Niko11111/SpoolmanScale/images/SpoolmanScale Main 3 3_4.png

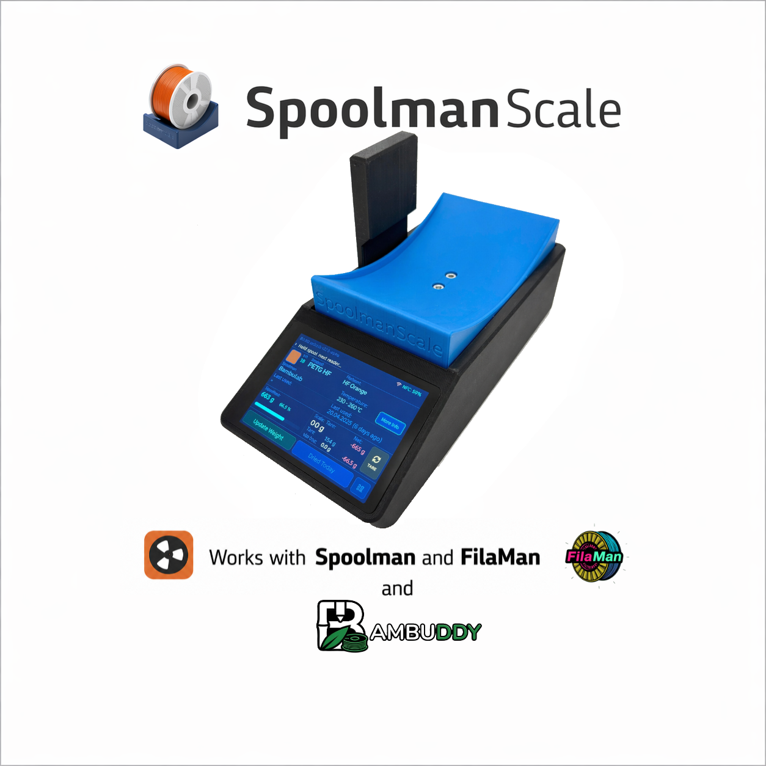
images/SpoolmanScale Main 3 3_4.png
