Niko11111/SpoolmanScale/images/SpoolmanScale_1.jpeg

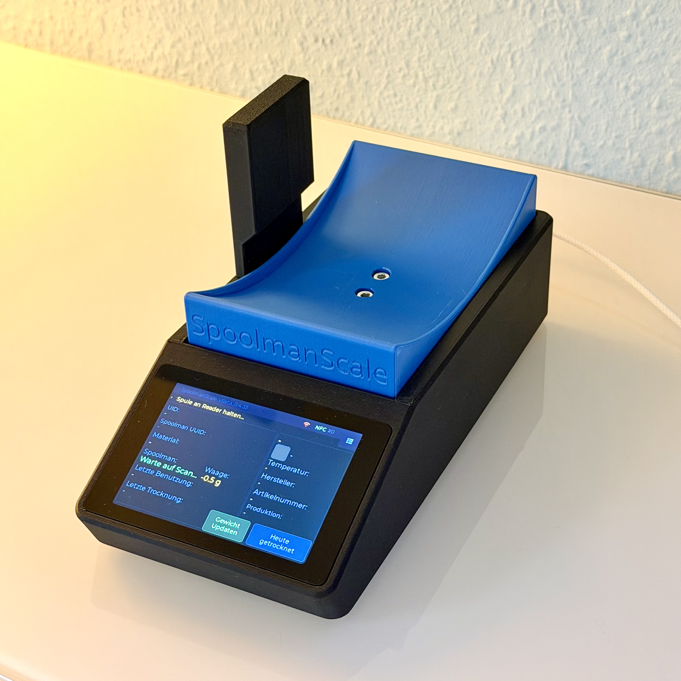
images/SpoolmanScale_1.jpeg
