Niko11111/SpoolmanScale/images/SpoolmanScale_2.jpeg

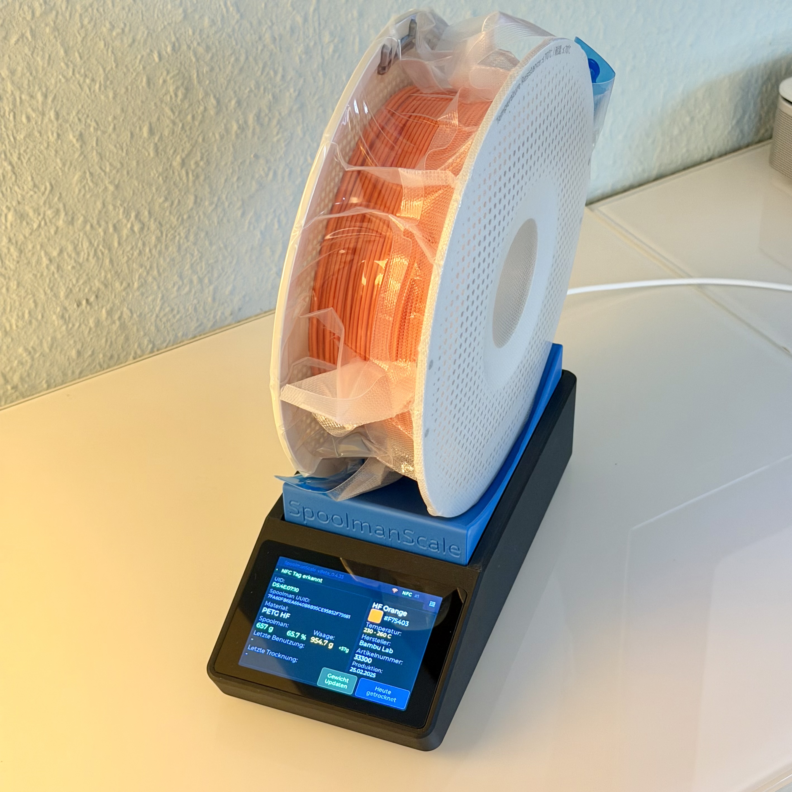
images/SpoolmanScale_2.jpeg
