Niko11111/SpoolmanScale/images/SpoolmanScale_MW_1.jpeg

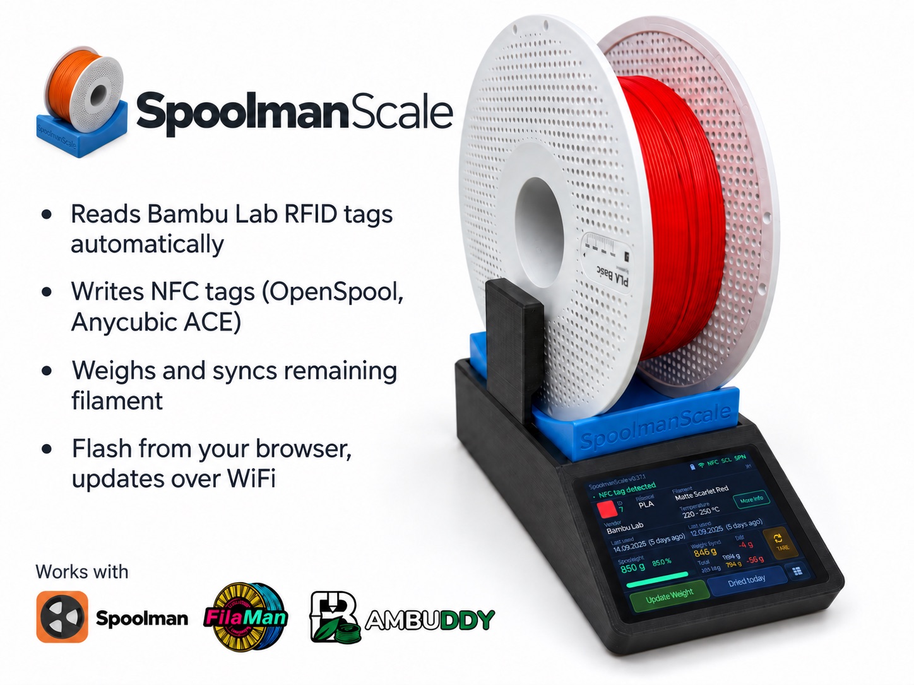
images/SpoolmanScale_MW_1.jpeg
