Niko11111/SpoolmanScale/images/SpoolmanScale_MW_UI_1.jpeg

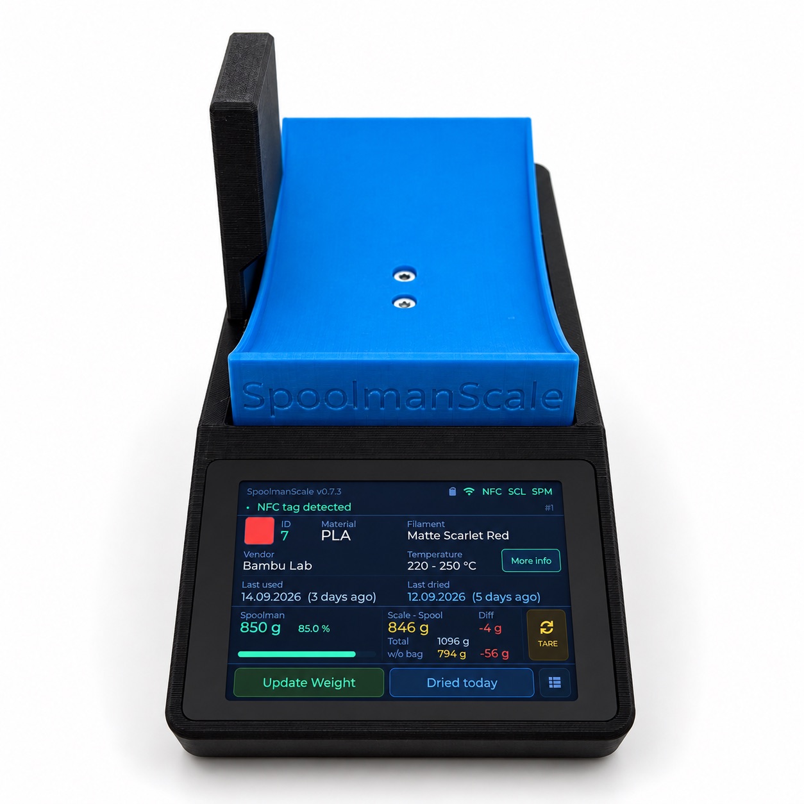
images/SpoolmanScale_MW_UI_1.jpeg
