Niko11111/SpoolmanScale/images/SpoolmanScale_MW_UI_2.jpeg

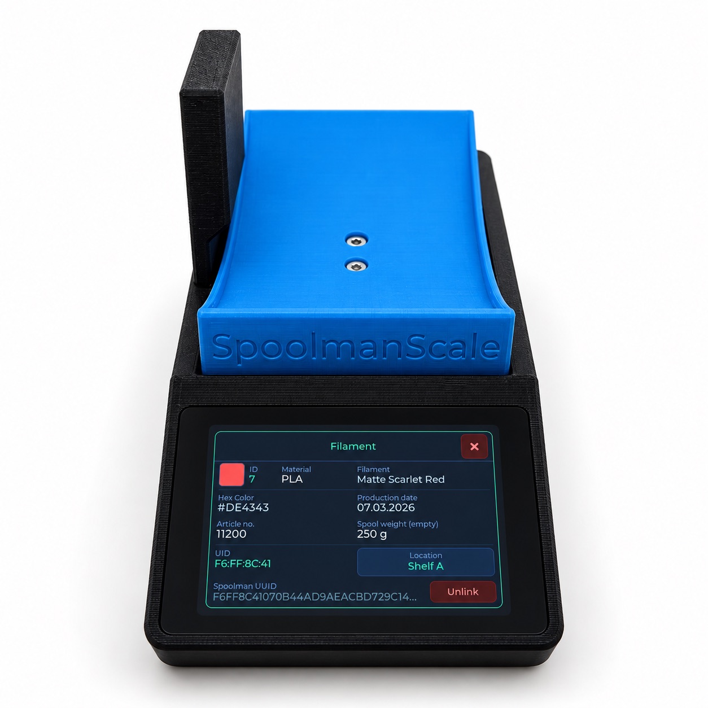
images/SpoolmanScale_MW_UI_2.jpeg
