Niko11111/SpoolmanScale/images/SpoolmanScale_MW_UI_3.jpeg

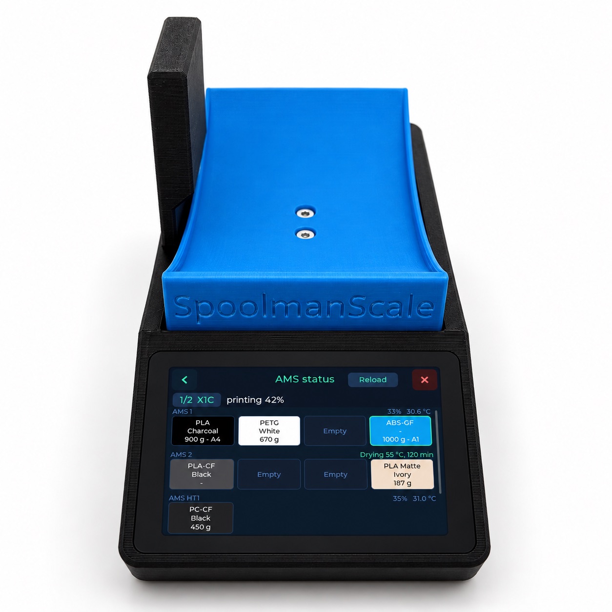
images/SpoolmanScale_MW_UI_3.jpeg
