Niko11111/SpoolmanScale/images/SpoolmanScale_MW_UI_4.jpeg

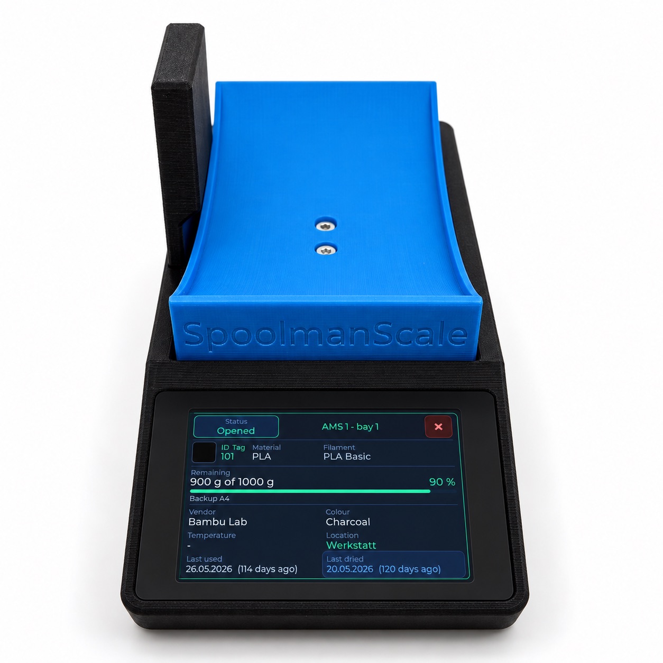
images/SpoolmanScale_MW_UI_4.jpeg
