Niko11111/SpoolmanScale/images/SpoolmanScale_MW_UI_5.jpeg

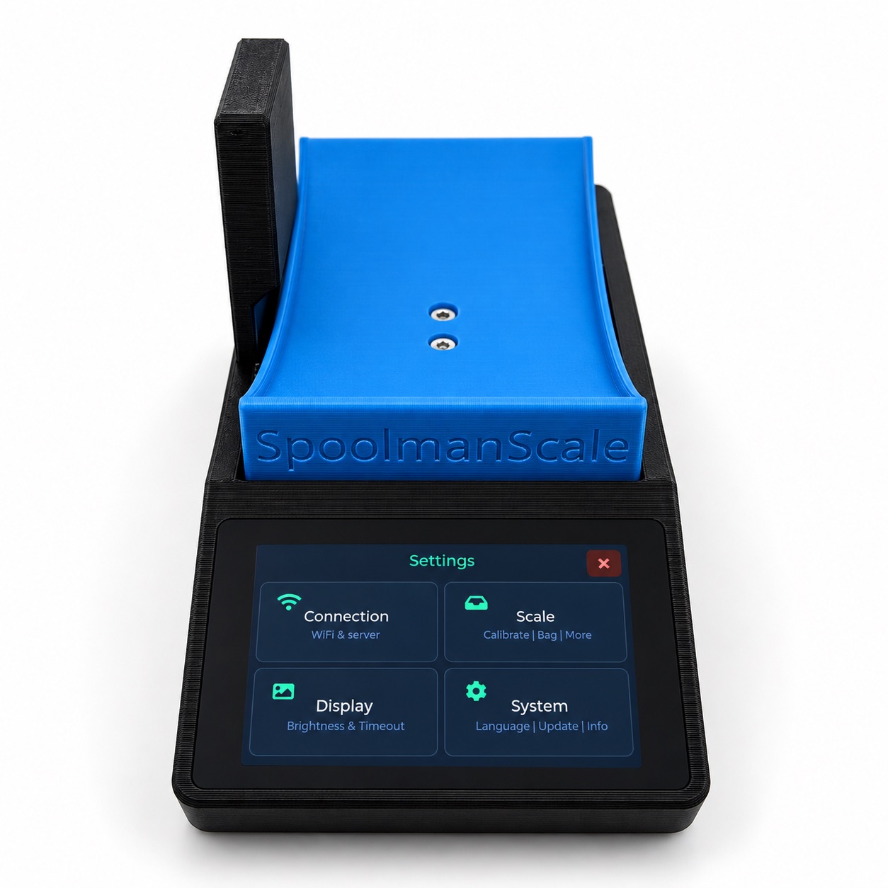
images/SpoolmanScale_MW_UI_5.jpeg
