Niko11111/SpoolmanScale/images/SpoolmanScale_MW_UI_6.jpeg

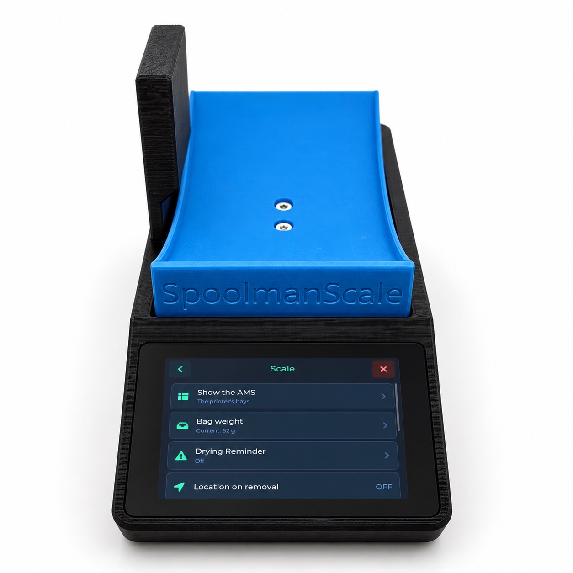
images/SpoolmanScale_MW_UI_6.jpeg
