Niko11111/SpoolmanScale/images/SpoolmanScale_MW_UI_7.jpeg

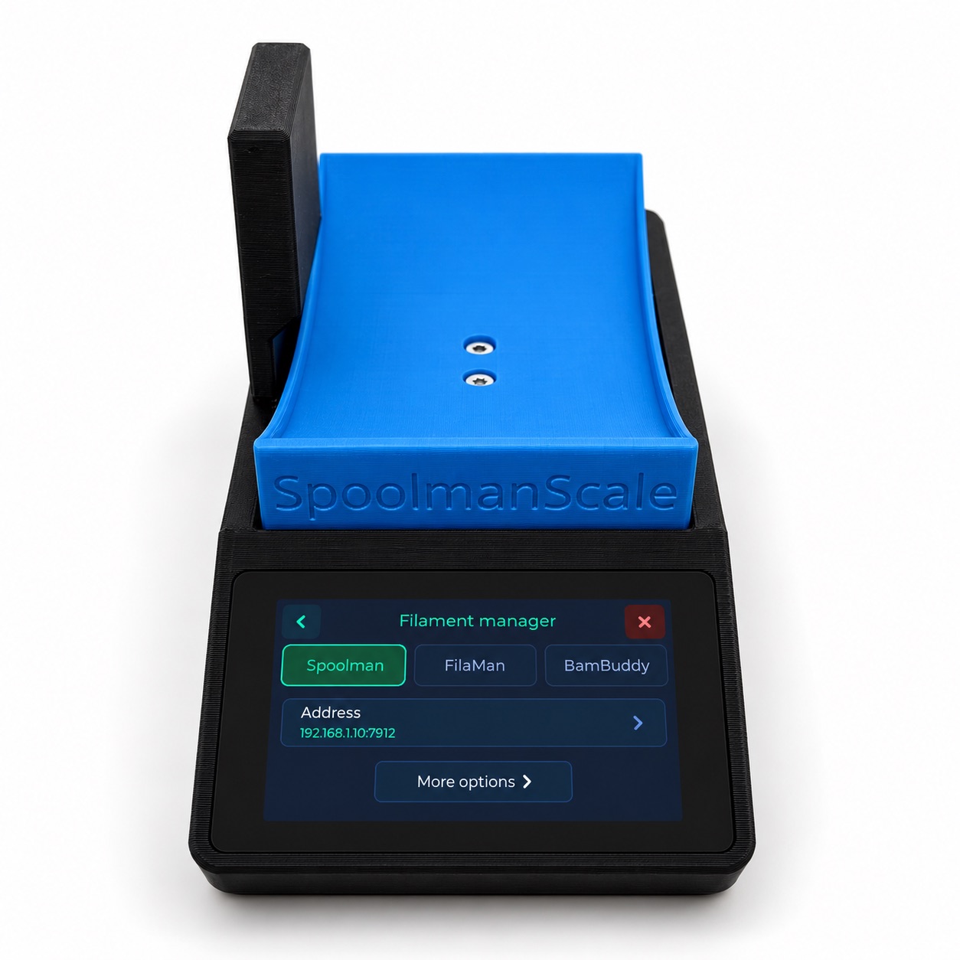
images/SpoolmanScale_MW_UI_7.jpeg
