Niko11111/SpoolmanScale/firmware/SpoolmanScale.ino

// ============================================================
//  SpoolmanScale – Bambu NFC Tag Reader & Decoder
//  Board:   WT32-SC01 Plus (ESP32-S3)
//  Version: v0.5.4
//
//  Reads Bambu Lab MIFARE Classic tags, derives keys via KDF
//  (HKDF/SHA256, master key from Bambu-Research-Group/RFID-Tag-Guide),
//  displays all decoded data on screen and queries
//  Spoolman for weight + last_dried after each scan.
//
//  Wiring:
//    Pin 1 (+5V)  -> PN532 VCC
//    Pin 2 (GND)  -> PN532 GND
//    Pin 3 (IO1)  -> PN532 SDA (GPIO 10)
//    Pin 4 (IO2)  -> PN532 SCL (GPIO 11)
//    Pin 5 (IO3)  -> PN532 RST (GPIO 12)
//
//  PN532 DIP-Switches: SW1=ON, SW2=OFF -> I2C mode
//
//  Libraries:
//    - Adafruit PN532    by Adafruit
//    - Adafruit BusIO    by Adafruit
//    - LovyanGFX         by lovyan03
//    - lvgl              by lvgl (Version 8.3.11!)
//    - ArduinoJson       by Benoit Blanchon (Version 7.x)
//  mbedTLS + WiFi + HTTPClient are included in the ESP32 framework.
// ============================================================

#include <Wire.h>
#include <Adafruit_PN532.h>
#include <Adafruit_NAU7802.h>   // NAU7802 Waage ADC (I2C 0x2A)
#include <LovyanGFX.hpp>
#include <lvgl.h>
#include "mbedtls/md.h"
#include <WiFi.h>
#include <WiFiClientSecure.h>
#include <HTTPClient.h>
#include <WebServer.h>
#include <Update.h>
#include <ArduinoJson.h>
#include <SD.h>
#include <SPI.h>
#include <stdarg.h>
#include <esp_system.h>

// PSRAM allocator for ArduinoJson — used for large JSON documents (Spoolman spool list)
// Frees internal RAM for LVGL, WiFi stack, and other allocations
struct SpiRamAllocator : ArduinoJson::Allocator {
  void* allocate(size_t size) override {
    void* ptr = heap_caps_malloc(size, MALLOC_CAP_SPIRAM);
    if (!ptr) ptr = malloc(size);  // fallback to internal RAM if PSRAM fails
    return ptr;
  }
  void deallocate(void* pointer) override { heap_caps_free(pointer); }
  void* reallocate(void* ptr, size_t new_size) override {
    void* p = heap_caps_realloc(ptr, new_size, MALLOC_CAP_SPIRAM);
    if (!p) p = realloc(ptr, new_size);  // fallback
    return p;
  }
};
#include <time.h>
#include <esp_sleep.h>
#include <Preferences.h>
#include <nvs_flash.h>
// LVGL built-in QR-Code: LV_USE_QRCODE muss in lv_conf.h auf 1 gesetzt sein!
#include "extra/libs/qrcode/lv_qrcode.h"
#include "lang.h"

// ============================================================
//  FORWARD DECLARATIONS
// ============================================================
void resetActivityTimer();
void isoToDe(const char* iso, char* out, size_t len);
void driedDisplayStr(const char* de_date, char* out, size_t len);
void querySpoolman(const char* tray_uuid);
void querySpoolmanById(int spool_id);
void closeConfirmPopup();
void patchSpoolWeight(float spool_w);
void patchFilamentSpoolWeight(float spool_w);
void patchVendorSpoolWeight(float spool_w);
void showConfirmPopup(const char* msg, int action);
void closeLinkList();
void showLinkList();
void fetchUnlinkedSpools();
void patchSpoolTag(int spool_id, const char* uuid);
// Neuer Link-Flow
void showLinkEntryPopup(bool is_bambu);
void closeLinkEntryPopup();
void showIdInputPopup(bool is_bambu);
void closeIdInputPopup();
// ID-Eingabe: HTTP-Lookup und Verknuepfung (ausgelagert wegen Stack-Groesse in Lambda)
void linkIdLookupAndPatch(int entered_id, bool is_bambu);
void showWarnPopupA(int spool_id, const char* existing_tag, bool is_bambu, const char* link_uuid);
void showWarnPopupB(int spool_id, bool is_bambu);
void fetchAllSpoolsForLink(bool is_bambu, const char* material_filter);
void doLinkPatch(int spool_id, bool is_bambu);
void showVendorList();
void showMaterialList(const char* vendor_name);
void showFilteredSpoolList(const char* vendor_name, const char* material_prefix);
bool writeSpoolScaleTag(int spool_id, const char* uuid_hex);
bool readSpoolScaleTag(int* out_spool_id, char* out_uuid, size_t uuid_len);
void generateUUID(char* out, size_t len);
void updateHeaderStatus();
void showMoreInfoScreen();
void buildMoreInfoScreen();
void updateMoreInfoScreen();
void hideAllOverlays();
void showMainScreen();
void showSettingsScreen();
void buildConnectionScreen();
void buildScaleSubScreen();
void buildDisplayScreen();
void buildSystemScreen();
void buildOtaGithubScreen();
void showOtaGithubScreen();
void doGithubOtaCheck();
void doGithubOtaCheckSilent();
void doGithubOtaFlash(const char* version);
void showUpdateBadges(bool show);
void buildOtaScreen();
void buildOtaBrowserScreen();
void showOtaScreen();
void showOtaBrowserScreen();
void startOtaServer();
void stopOtaServer();
void buildSettingsScreen();
void buildSpoolmanScreen();
void showSpoolmanFailScreen(bool is_setup_flow);
void clearTagDisplay();
void updateLinkButton();
void syncNTP();
void saveSpoolmanIP(const char* ip);
void buildWelcomeScreen();
void buildWifiSetupScreen();
void showWifiSetupScreen();
void showWelcomeScreen();
void saveWifiCredentials(const char* ssid, const char* pass);
void doWifiScan();
void showWifiPassScreen();
void buildWifiPassScreen();
void showWifiConnectingScreen();
void buildWifiConnectingScreen();
void buildBagScreen();
void buildFactorScreen();
void showFactorScreen();
void buildSubHeader(lv_obj_t *parent, const char *title, lv_event_cb_t back_cb, const char *back_hint = nullptr);
void showRebootPopup();
void showInfoScreen();
void showLanguageScreen();
void showQRPopup(int idx);
void buildFirstBootScreen();
void showFirstBootScreen();
void buildExtraFieldsScreen(bool is_setup_flow);
void showExtraFieldsScreen(bool is_setup_flow);
void buildCalReminderScreen();
void showCalReminderScreen();
void checkAndCreateExtraFields(bool create_missing);



// ============================================================
//  PINS
// ============================================================
#define I2C_SDA     10   // PN532 + NAU7802 Bus
#define I2C_SCL     11   // PN532 + NAU7802 Bus
#define TOUCH_SDA    6   // FT6336U interner Board-Bus
#define TOUCH_SCL    5   // FT6336U interner Board-Bus
#define LCD_BL_PIN        45
#define BRIGHT_NORMAL_DEFAULT  255   // 100% — Standardwert
#define BRIGHT_DIM_DEFAULT       77   // 30%  — Standardwert
#define DIM_TIMEOUT_DEFAULT   300000  // 5 Min — Standardwert
#define SLEEP_TIMEOUT_DEFAULT 1200000 // 20 Min — Standardwert

// Runtime variables (loaded from NVS, configurable via display menu)
static int     bright_normal   = BRIGHT_NORMAL_DEFAULT;
static int     dim_timeout_ms  = DIM_TIMEOUT_DEFAULT;
static int     sleep_timeout_ms = SLEEP_TIMEOUT_DEFAULT;
#define TOUCH_INT_PIN       7   // FT6336U INT fuer Wake-Up
#define FW_VERSION  "v0.5.4"
#define DONATION_URL "ko-fi.com/formfollowsfunction"

// NAU7802 calibration
// CAL_FACTOR: raw value per gram. Determined via calibration and saved in NVS.
// Default 1.0 means: raw values are displayed directly as grams.
#define CAL_FACTOR_DEFAULT  1.0f

// Two separate I2C instances
// I2C_TOUCH: Bus 0, GPIO5/6  -> Touch controller
// I2C_EXT:   Bus 1, GPIO10/11 -> PN532 + NAU7802
TwoWire I2C_TOUCH = TwoWire(0);
TwoWire I2C_EXT   = TwoWire(1);

// NAU7802 scale (on I2C_EXT, address 0x2A)
Adafruit_NAU7802 nau;

// ============================================================
//  SD CARD LOGGING (v0.5.3+)
//  MicroSD slot is on dedicated SPI bus (no conflict with display)
//  Pins per WT32-SC01 Plus schematic
// ============================================================
#define SD_CS    41
#define SD_SCK   39   // CLK
#define SD_MOSI  40   // CMD
#define SD_MISO  38   // D0

static SPIClass spiSD(HSPI);          // dedicated SPI bus for SD
static bool sd_available = false;     // SD card detected at boot
static bool sd_verbose   = false;     // verbose.txt found in root
static char sd_log_filename[32] = ""; // current day's log file path
static unsigned long sd_log_size = 0; // bytes written today (rough cap)
#define SD_LOG_MAX_SIZE  (1024UL * 1024UL)  // 1 MB per day cap

// Forward declarations for logger
void logSD(const char* msg);
void logSDf(const char* fmt, ...);
void initSD();
void cleanOldLogs();
void writeBootBlock(const char* boot_or_reboot);
String getCurrentLogFilename();

// ============================================================
//  WIFI + SPOOLMAN CONFIGURATION
// ============================================================
// WiFi + Spoolman are loaded from NVS (Preferences)
// Fallback values if NVS is empty:
// Fallback credentials: empty — WiFi is configured via the welcome screen
char cfg_wifi_ssid[33]     = "";
char cfg_wifi_password[65] = "";
char cfg_spoolman_ip[64]   = "";
char cfg_spoolman_base[80] = "";
bool cfg_lang_set          = false;  // true after first language selection
bool cfg_first_boot        = true;   // true = very first boot (greeting screen not yet shown)
static lv_obj_t *lbl_extra_fields_status = nullptr; // status label in extra fields screen
static lv_obj_t *btn_extra_fields_create = nullptr; // create button in extra fields screen
static lv_obj_t *btn_extra_fields_next   = nullptr; // skip/next button (turns green when OK)
static bool extra_fields_setup_flow = false;         // true = called from setup flow
static bool spoolman_fail_is_setup  = false;         // for spoolman fail screen
static bool spoolman_test_pending   = false;         // HTTP test queued for loop
static bool spoolman_test_in_setup  = false;         // context for test result
static bool extra_fields_check_pending = false;      // deferred from event callback to loop
static bool extra_fields_create_pending = false;     // deferred create from event callback
static bool skip_setup_pending = false;  // deferred from skip button callback
static bool cal_reminder_pending = false;            // deferred showCalReminderScreen from callback
static bool show_bag_pending    = false;             // deferred showBagScreen from scale_sub callback
static bool show_factor_pending = false;             // deferred showFactorScreen from scale_sub callback
static bool lang_selected_no_reboot = false;         // EN selected on welcome screen — go to firstboot without reboot
static uint8_t last_used_mode = 0;                   // 0=OpenSpoolMan, 1=Last Weighed
Preferences prefs;

// ============================================================
//  BAMBU KDF – Master Key (from Bambu-Research-Group/RFID-Tag-Guide)
//  HKDF with SHA256, context "RFID-B\\0", 16 keys of 6 bytes each
// ============================================================
static const uint8_t BAMBU_MASTER_KEY[16] = {
  0x9a, 0x75, 0x9c, 0xf2, 0xc4, 0xf7, 0xca, 0xff,
  0x22, 0x2c, 0xb9, 0x76, 0x9b, 0x41, 0xbc, 0x96
};
static const uint8_t BAMBU_KDF_CONTEXT[] = "RFID-B";  // incl. \\0

// ============================================================
//  DISPLAY (LovyanGFX)
// ============================================================
class LGFX : public lgfx::LGFX_Device {
  lgfx::Panel_ST7796  _panel;
  lgfx::Bus_Parallel8 _bus;
  lgfx::Light_PWM     _light;
  lgfx::Touch_FT5x06  _touch;
public:
  LGFX(void) {
    { auto cfg = _bus.config();
      cfg.pin_wr=47; cfg.pin_rd=-1; cfg.pin_rs=0;
      cfg.pin_d0=9;  cfg.pin_d1=46; cfg.pin_d2=3;
      cfg.pin_d3=8;  cfg.pin_d4=18; cfg.pin_d5=17;
      cfg.pin_d6=16; cfg.pin_d7=15;
      _bus.config(cfg); _panel.setBus(&_bus); }
    { auto cfg = _panel.config();
      cfg.pin_cs=-1; cfg.pin_rst=4; cfg.pin_busy=-1;
      cfg.memory_width=320; cfg.memory_height=480;
      cfg.panel_width=320;  cfg.panel_height=480;
      cfg.invert=true; cfg.rgb_order=false;
      _panel.config(cfg); }
    { auto cfg = _light.config();
      cfg.pin_bl=LCD_BL_PIN; cfg.invert=false;
      cfg.freq=44100; cfg.pwm_channel=7;
      _light.config(cfg); _panel.setLight(&_light); }
    { auto cfg = _touch.config();
      cfg.x_min=0; cfg.x_max=319; cfg.y_min=0; cfg.y_max=479;
      cfg.pin_int=7; cfg.bus_shared=false; cfg.offset_rotation=0;
      cfg.i2c_port=0; cfg.i2c_addr=0x38;
      cfg.pin_sda=TOUCH_SDA; cfg.pin_scl=TOUCH_SCL; cfg.freq=400000;
      _touch.config(cfg); _panel.setTouch(&_touch); }
    setPanel(&_panel);
  }
};

// ============================================================
//  GLOBAL OBJECTS
// ============================================================
static LGFX tft;
static lv_disp_draw_buf_t draw_buf;
static lv_color_t disp_buf[480 * 10];

Adafruit_PN532 nfc(-1, 12, &I2C_EXT);  // IRQ=nicht verdrahtet, RST=GPIO12, Bus=I2C_EXT
bool nfc_ok = false;
bool scl_ok = false;          // NAU7802 scale connected

// Parsed tag data
struct BambuTagData {
  uint8_t  uid[4];
  char     uid_str[24];  // 4-byte UID: "XX:XX:XX:XX" = 11+1, 7-byte UID: "XX:XX:XX:XX:XX:XX:XX" = 23+1
  uint8_t  keys[16][6];       // 16 abgeleitete Keys
  uint8_t  blocks[64][16];    // all 64 blocks (16 sectors x 4 blocks)
  bool     block_ok[64];      // which blocks were successfully read
  // Parsed fields (NFC tag)
  char     tray_uuid[36];
  char     material[16];
  char     color_hex[8];      // #RRGGBB
  char     vendor[32];
  char     detailed_filament[64];
  int      temp_min;
  int      temp_max;
  float    spool_weight;
  char     production_date[12];
  char     short_uid[20];
  // Spoolman fields (filled after API query)
  bool     spoolman_found;
  int      spoolman_id;
  float    spoolman_remaining;  // g
  float    spoolman_total;      // g
  char     spoolman_last_dried[32];
};

BambuTagData g_tag;
bool g_tag_ready = false;
bool g_tag_displayed = false;
unsigned long g_tag_shown_ms = 0;
bool wifi_ok = false;
static bool sm_reachable = false;  // Fix 10: Spoolman reachability status

// Tare confirmation timeout
static unsigned long tare_msg_ms = 0;
lv_obj_t *lbl_ok_ptr = nullptr;

// No-tag timer: clear display after timeout if no NFC tag detected
static unsigned long last_tag_seen_ms = 0;    // last NFC detection
static bool tag_present = false;               // tag currently on reader?
#define NO_TAG_CLEAR_MS  60000                 // 1 minute without tag -> clear

// Confirmation popup
lv_obj_t *confirm_popup = nullptr;             // current popup object
static int  confirm_action = 0;                // 1=dried, 2=weight

// Settings UI
lv_obj_t *scr_main   = nullptr;
lv_obj_t *scr_settings   = nullptr;
lv_obj_t *scr_wifi       = nullptr;
lv_obj_t *scr_spoolman   = nullptr;
lv_obj_t *scr_spoolman_fail = nullptr; // Spoolman connection failed screen
lv_obj_t *scr_welcome    = nullptr;   // Welcome screen (first boot — language selection)
lv_obj_t *scr_first_boot = nullptr;   // Very first boot greeting screen
lv_obj_t *scr_extra_fields = nullptr; // Spoolman extra fields check screen
lv_obj_t *scr_cal_reminder = nullptr; // Calibration reminder screen (end of first setup)
lv_obj_t *scr_wifi_setup = nullptr;   // WiFi setup: scan + password + connect
lv_obj_t *scr_factor     = nullptr;
lv_obj_t *scr_bag        = nullptr;
lv_obj_t *scr_lastused   = nullptr;  // Last Used Mode screen
// Submenu screens
lv_obj_t *scr_connection = nullptr;  // Connection (WiFi + Spoolman IP)
lv_obj_t *scr_scale_sub  = nullptr;  // Scale (bag weight + calibration)
lv_obj_t *scr_display    = nullptr;  // Display (brightness + timeouts)
lv_obj_t *scr_system     = nullptr;  // System (update + info/donate)
lv_obj_t *scr_ota        = nullptr;  // OTA selection (browser / GitHub)
lv_obj_t *scr_ota_browser = nullptr; // OTA browser upload screen
lv_obj_t *scr_ota_github  = nullptr; // OTA GitHub check screen

// OTA web server
static WebServer ota_server(80);
static bool ota_server_running = false;
static lv_obj_t *lbl_ota_status = nullptr;  // Status-Label im Browser-OTA Screen

// GitHub OTA state
static lv_obj_t *lbl_gh_status      = nullptr;
static lv_obj_t *lbl_gh_installed   = nullptr;
static lv_obj_t *lbl_gh_latest      = nullptr;
static lv_obj_t *btn_gh_update      = nullptr;
static lv_obj_t *lbl_gh_update_btn  = nullptr;
static char gh_latest_version[32]   = "";
bool update_available = false;   // set by silent background check
static bool silent_ota_check_pending = false;  // trigger once after WiFi connect
static lv_obj_t *lbl_burger_badge   = nullptr; // yellow dot on burger button (mainscreen)
static lv_obj_t *lbl_system_badge   = nullptr; // yellow dot on System tile (settings)
static lv_obj_t *lbl_fw_badge       = nullptr; // yellow dot on Firmware Update button
static lv_obj_t *lbl_gh_btn_badge   = nullptr; // yellow dot on GitHub Update button (OTA screen)
lv_obj_t *lbl_wifi_info = nullptr; // WiFi-Info Label
// ta_spoolman_ip, kb_spoolman: replaced by custom numpad — removed
// ta_factor_weight, kb_factor: replaced by custom numpad in buildFactorScreen()
lv_obj_t *ta_factor_weight = nullptr; // (nicht mehr aktiv genutzt)
lv_obj_t *kb_factor     = nullptr;    // (nicht mehr aktiv genutzt)
lv_obj_t *lbl_factor_result = nullptr;

// WiFi setup state
static char  wifi_setup_ssid[33]  = "";   // selected SSID from scan list
static lv_obj_t *lbl_wifi_setup_status = nullptr;  // Status-Label im Setup
static lv_obj_t *lbl_wifi_scan_list    = nullptr;  // Scan-Listen Container
static lv_obj_t *ta_wifi_pass          = nullptr;  // Password textarea
static lv_obj_t *kb_wifi_pass          = nullptr;  // Passwort-Tastatur
static lv_obj_t *scr_wifi_pass         = nullptr;  // Passwort-Unterscreen
static lv_obj_t *scr_wifi_connecting   = nullptr;  // Connecting screen

// Power management
unsigned long last_activity_ms = 0;  // last activity (NFC or touch)
bool is_dimmed = false;              // Display dimmed?

// Spoolman data kept separate – NOT reset on every scan
static int   sm_id = 0;
static int   sm_filament_id = 0;   // for PATCH /api/v1/filament/{id}
static int   sm_vendor_id = 0;     // for PATCH /api/v1/vendor/{id}
static bool  sm_found = false;
static float sm_remaining = 0;
static float sm_total = 1000;
static float sm_spool_weight = 0;   // Empty spool weight (for scale calculation)
static char  sm_last_dried[32] = "";
static char  sm_article_nr[32] = "";
static char  sm_filament_name[32] = "";
static char  sm_material_global[32] = "";
static char  sm_color_global[16] = "";   // Spoolman hex color for NTAG spools

// Scale (NAU7802)
static float scale_weight_g = 0.0f;
bool scale_ready = false;
static float cal_factor = CAL_FACTOR_DEFAULT;
static int32_t zero_offset = 0;
static unsigned long last_scale_ms = 0;

// Moving average for NAU7802 (dampens +/-0.2g noise)
#define SCALE_FILTER_SIZE  8
static float scale_filter_buf[SCALE_FILTER_SIZE] = {0};
static int   scale_filter_idx = 0;
static bool  scale_filter_full = false;

// Bag weight (configurable in settings)
static float bag_weight_g = 50.0f;  // Standard: 50g (Vakuumbeutel + Silikagel)

// Spoolman query: UID of the last queried spool
// Cleared after clearTagDisplay() → forces new query even for same UID
static char spoolman_queried_uid[24] = "";  // max 7-byte UID: "XX:XX:XX:XX:XX:XX:XX" = 23+1
static char  sm_last_used[32] = "";

// NFC retry: counter for re-scan attempts when tray_uuid is empty
static int nfc_retry_count = 0;
#define NFC_MAX_RETRIES  5

// Set to 1 to enable touch coordinate debug output on Serial
#define TOUCH_DEBUG 0

// Tag type enum — declared globally so all functions can use it
enum TagType { TAG_BAMBU, TAG_SPOOLSCALE, TAG_BLANK, TAG_UNKNOWN };

struct UnlinkedSpool {
  int   id;
  char  name[48];      // filament.name
  char  vendor[32];    // filament.vendor.name
  char  material[16];  // filament.material (PLA, PETG, ABS...)
  char  color_hex[8];  // filament.color_hex (#RRGGBB)
  float remaining;     // remaining_weight
  float total;         // filament.weight
  char  existing_tag[48]; // extra.tag falls gesetzt (fuer Ueberschreib-Check)
};
static UnlinkedSpool* link_spools = nullptr;  // PSRAM-allocated at fetch time, freed after link flow
static int            link_spool_count = 0;
static char          link_tag_uid[24] = "";   // UID of the tag to be linked
static lv_obj_t     *scr_link_list = nullptr; // Spool selection overlay (old, kept for compatibility)

// Neuer Link-Flow Overlays
static lv_obj_t *scr_link_entry   = nullptr;  // Entry popup
static lv_obj_t *scr_link_id      = nullptr;  // Numeric keypad
static lv_obj_t *scr_link_warn_a  = nullptr;  // Warning popup A (already linked)
static lv_obj_t *scr_link_warn_b  = nullptr;  // Warning popup B (material mismatch)
static lv_obj_t *scr_link_vendor  = nullptr;  // Vendor-Auswahl (Flow B Pfad 2)
static lv_obj_t *scr_link_mat     = nullptr;  // Material selection (flow B path 2)
static lv_obj_t *scr_link_spools  = nullptr;  // Spool list (all path 2)

// State for ID input
static char link_id_input[8] = "";            // Input buffer for numeric keypad
static lv_obj_t *lbl_link_id_display = nullptr; // Label for digit display
static lv_obj_t *lbl_link_id_status  = nullptr; // Error label in numeric keypad

// State for path-2 navigation
static char link_selected_vendor[32]   = "";   // selected vendor
static char link_selected_material[8]  = "";   // 3-char material prefix
static bool link_flow_is_bambu = false;         // which flow is active

// Popup control: prevents immediate re-display after cancel
static bool link_popup_dismissed = false;       // user dismissed the popup
static unsigned long link_tag_first_seen_ms = 0; // time of first detection
#define LINK_POPUP_DELAY_MS  3000               // 3s warten bevor Popup erscheint

// ============================================================
//  UI Labels
// ============================================================
lv_obj_t *lbl_status;
lv_obj_t *lbl_uid;
lv_obj_t *lbl_tray_uuid;
lv_obj_t *lbl_material;
lv_obj_t *lbl_color;
lv_obj_t *lbl_filament_name;
lv_obj_t *lbl_color_swatch;
lv_obj_t *lbl_vendor;
lv_obj_t *lbl_temp;
lv_obj_t *lbl_detail;
lv_obj_t *lbl_date;
lv_obj_t *lbl_spoolman_id;
lv_obj_t *lbl_scan_count;
lv_obj_t *lbl_keys;
lv_obj_t *lbl_raw_info;
// Spoolman labels
lv_obj_t *lbl_spoolman_weight;
lv_obj_t *lbl_scale_weight;  // Live-Gewicht von NAU7802
lv_obj_t *lbl_scale_diff;   // Differenz (Waage netto) vs. Spoolman remaining
lv_obj_t *lbl_last_used;
lv_obj_t *lbl_lu_cap = nullptr;  // Last used/weighed cap label — updated on mode change
lv_obj_t *lbl_spoolman_pct;
lv_obj_t *lbl_spoolman_dried;
lv_obj_t *lbl_spoolman_dried_val;  // NEU: Wert unter dem Titel
lv_obj_t *lbl_nfc_dot;            // Status dot before status line (green/yellow)
lv_obj_t *lbl_hdr_wifi;          // Header: WiFi-Symbol (Farbe je RSSI)
lv_obj_t *lbl_hdr_nfc;           // Header: NFC status (green/red)
lv_obj_t *lbl_hdr_scl = nullptr; // Header: Scale/NAU7802 status (green/red)
lv_obj_t *lbl_hdr_scans;         // Header: scan counter (dim)
lv_obj_t *lbl_hdr_sm = nullptr;  // Header: Spoolman reachability status
lv_obj_t *lbl_bag_sm_diff = nullptr; // Zone 4: ohne-Beutel vs SM diff

// Mainscreen buttons (global for show/hide depending on sm_found)
lv_obj_t *btn_dried  = nullptr;  // "Dried today" — visible when sm_found
lv_obj_t *btn_link   = nullptr;  // "Link"             — visible when !sm_found && tag_present
lv_obj_t *btn_weight_main = nullptr;  // "Update Weight" — always visible when sm_found

// More Info screen (overlay, always rebuilt)
static lv_obj_t *scr_more_info = nullptr;

// More Info labels (updated when screen is built)
static lv_obj_t *lbl_mi_smid    = nullptr;
static lv_obj_t *lbl_mi_swatch  = nullptr;
static lv_obj_t *lbl_mi_mat     = nullptr;
static lv_obj_t *lbl_mi_name    = nullptr;
static lv_obj_t *lbl_mi_uid     = nullptr;
static lv_obj_t *lbl_mi_hex     = nullptr;
static lv_obj_t *lbl_mi_article = nullptr;
static lv_obj_t *lbl_mi_prod    = nullptr;
static lv_obj_t *lbl_mi_spool_w = nullptr;
static lv_obj_t *lbl_mi_uuid    = nullptr;

int scan_count = 0;
lv_obj_t *page_main;

// ============================================================
//  LVGL CALLBACKS
// ============================================================
void lvgl_flush(lv_disp_drv_t *drv, const lv_area_t *area, lv_color_t *color_p) {
  uint32_t w = area->x2 - area->x1 + 1;
  uint32_t h = area->y2 - area->y1 + 1;
  tft.startWrite();
  tft.setAddrWindow(area->x1, area->y1, w, h);
  tft.writePixels((lgfx::rgb565_t*)color_p, w * h);
  tft.endWrite();
  lv_disp_flush_ready(drv);
}

void lvgl_touch(lv_indev_drv_t *drv, lv_indev_data_t *data) {
  uint16_t x, y;
  if (tft.getTouch(&x, &y)) {
    data->state = LV_INDEV_STATE_PR;
    data->point.x = x; data->point.y = y;
    resetActivityTimer();
    #if TOUCH_DEBUG
    static unsigned long last_log = 0;
    if (millis() - last_log > 200) {
      Serial.printf("TOUCH x=%d y=%d\n", x, y);
      last_log = millis();
    }
    #endif
  } else {
    data->state = LV_INDEV_STATE_REL;
  }
}

// ============================================================
//  HKDF manually implemented
//  Extract: PRK = HMAC-SHA256(salt=MASTER_KEY, IKM=uid)
//  Expand:  OKM with context "RFID-B\0"
// ============================================================

static bool hmac_sha256(const uint8_t *key, size_t key_len,
                         const uint8_t *data, size_t data_len,
                         uint8_t *out) {
  const mbedtls_md_info_t *info = mbedtls_md_info_from_type(MBEDTLS_MD_SHA256);
  return mbedtls_md_hmac(info, key, key_len, data, data_len, out) == 0;
}

static bool hkdf_expand(const uint8_t *prk,  size_t prk_len,
                         const uint8_t *info, size_t info_len,
                         uint8_t *okm,        size_t okm_len) {
  uint8_t t[32] = {0};
  size_t  t_len = 0;
  size_t  done  = 0;
  uint8_t counter = 1;
  while (done < okm_len) {
    uint8_t input[256];
    size_t  input_len = 0;
    memcpy(input, t, t_len);                   input_len += t_len;
    memcpy(input + input_len, info, info_len); input_len += info_len;
    input[input_len++] = counter++;
    if (!hmac_sha256(prk, prk_len, input, input_len, t)) return false;
    t_len = 32;
    size_t copy = (okm_len - done < 32) ? (okm_len - done) : 32;
    memcpy(okm + done, t, copy);
    done += copy;
  }
  return true;
}

bool deriveKeys(const uint8_t *uid, uint8_t uid_len, uint8_t keys[16][6]) {
  // HKDF-Extract: PRK = HMAC-SHA256(salt=MASTER_KEY, IKM=uid)
  uint8_t prk[32];
  if (!hmac_sha256(BAMBU_MASTER_KEY, 16, uid, uid_len, prk)) {
    Serial.println("HKDF-Extract error");
    return false;
  }
  // HKDF-Expand with context "RFID-B\0"
  uint8_t okm[96];
  if (!hkdf_expand(prk, 32, BAMBU_KDF_CONTEXT, 7, okm, 96)) {
    Serial.println("HKDF-Expand error");
    return false;
  }
  for (int i = 0; i < 16; i++) {
    memcpy(keys[i], okm + i * 6, 6);
  }
  return true;
}

// ============================================================
//  MIFARE CLASSIC – authenticate and read sector
//  Key B is used for Bambu-encrypted sectors
// ============================================================
bool readSector(int sector, uint8_t key[6], uint8_t uid[4], uint8_t blocks[4][16]) {
  uint8_t trailer_block = sector * 4 + 3;

  // Authenticate with key B
  if (!nfc.mifareclassic_AuthenticateBlock(uid, 4, trailer_block,
        MIFARE_CMD_AUTH_B, key)) {
    // Fallback: try key A
    if (!nfc.mifareclassic_AuthenticateBlock(uid, 4, trailer_block,
          MIFARE_CMD_AUTH_A, key)) {
      return false;
    }
  }

  // Read 3 data blocks (block 3 = trailer, contains keys)
  bool ok = true;
  for (int b = 0; b < 3; b++) {
    int block_num = sector * 4 + b;
    if (!nfc.mifareclassic_ReadDataBlock(block_num, blocks[b])) {
      memset(blocks[b], 0, 16);
      ok = false;
    }
  }
  return ok;
}

// ============================================================
//  PARSE TAG DATA
//  Based on BambuLabRfid.md documentation
// ============================================================
void parseTagData(BambuTagData &tag) {
  // tray_uuid: block 9 (verified with Spoolman: 4E3C9740796645ACBC2732FDD6456A0D)
  if (tag.block_ok[9]) {
    char uuid[33] = "";
    for (int i = 0; i < 16; i++) {
      sprintf(uuid + i * 2, "%02X", tag.blocks[9][i]);
    }
    strncpy(tag.tray_uuid, uuid, 32);
    tag.tray_uuid[32] = '\0';
  }

  // Material: sector 2, block 8
  // Material: block 4 (long form, e.g. "PETG HF")
  if (tag.block_ok[4]) {
    memset(tag.material, 0, sizeof(tag.material));
    strncpy(tag.material, (char*)tag.blocks[4], 15);
    for (int i = 0; i < 15; i++) {
      if (tag.material[i] < 0x20 || tag.material[i] > 0x7E) {
        tag.material[i] = 0; break;
      }
    }
  }

  // Color: block 5, bytes 0-2 = R,G,B (verified: FF D0 0B = #FFD00B)
  if (tag.block_ok[5]) {
    sprintf(tag.color_hex, "#%02X%02X%02X",
      tag.blocks[5][0], tag.blocks[5][1], tag.blocks[5][2]);
  }

  // Temperatures: block 6, bytes 8-9 = max, 10-11 = min (little endian, directly in °C)
  if (tag.block_ok[6]) {
    int t1 = tag.blocks[6][8]  | (tag.blocks[6][9]  << 8);  // 0x0104 = 260°C
    int t2 = tag.blocks[6][10] | (tag.blocks[6][11] << 8);  // 0x00E6 = 230°C
    if (t1 > 100 && t1 < 400) tag.temp_max = t1;
    if (t2 > 100 && t2 < 400) tag.temp_min = t2;
  }

  // Vendor/Vendor: Block 16 (ASCII, z.B. "Bambu Lab")
  if (tag.block_ok[16]) {
    memset(tag.vendor, 0, sizeof(tag.vendor));
    for (int i = 0; i < 16 && tag.blocks[16][i] != 0; i++) {
      char c = tag.blocks[16][i];
      if (c >= 0x20 && c <= 0x7E) tag.vendor[i] = c;
      else { tag.vendor[i] = 0; break; }
    }
  }

  // Production date: block 12 as ASCII "2025_03_07_04_18"
  if (tag.block_ok[12]) {
    char raw[17] = "";
    memcpy(raw, tag.blocks[12], 16);
    raw[16] = 0;
    // Format: YYYY_MM_DD_HH_MM -> DD.MM.YYYY
    if (raw[4] == '_' && raw[7] == '_') {
      snprintf(tag.production_date, sizeof(tag.production_date),
        "%.2s.%.2s.%.4s", raw+8, raw+5, raw);
    }
  }
}

// ============================================================
//  FULL TAG SCAN
// ============================================================
void scanTag(uint8_t *uid, uint8_t uid_len) {
  memset(&g_tag, 0, sizeof(g_tag));
  memcpy(g_tag.uid, uid, 4);
  sprintf(g_tag.uid_str, "%02X:%02X:%02X:%02X",
    uid[0], uid[1], uid[2], uid[3]);

  Serial.printf("\n=== Tag gefunden: %s ===\n", g_tag.uid_str);
  logSDf("NFC: Bambu tag found UID=%s", g_tag.uid_str);

  // Derive keys
  Serial.println("Deriving keys...");
  if (!deriveKeys(uid, uid_len, g_tag.keys)) {
    Serial.println("Key derivation failed!");
    return;
  }

  // Print keys (serial monitor)
  for (int i = 0; i < 16; i++) {
    Serial.printf("Key %2d: %02X%02X%02X%02X%02X%02X\n", i,
      g_tag.keys[i][0], g_tag.keys[i][1], g_tag.keys[i][2],
      g_tag.keys[i][3], g_tag.keys[i][4], g_tag.keys[i][5]);
  }
  if (sd_verbose) {
    for (int i = 0; i < 16; i++) {
      logSDf("[verbose] KDF key %2d: %02X%02X%02X%02X%02X%02X", i,
        g_tag.keys[i][0], g_tag.keys[i][1], g_tag.keys[i][2],
        g_tag.keys[i][3], g_tag.keys[i][4], g_tag.keys[i][5]);
    }
  }

  // Read all 16 sectors
  Serial.println("Reading sectors...");
  int success_count = 0;
  // Build a compact verbose summary string: "0:OK 1:OK 2:FAIL ..."
  char sector_summary[160] = "";
  for (int sector = 0; sector < 16; sector++) {
    uint8_t sec_blocks[4][16];
    bool ok = readSector(sector, g_tag.keys[sector], uid, sec_blocks);
    for (int b = 0; b < 3; b++) {
      int block_num = sector * 4 + b;
      if (ok) {
        memcpy(g_tag.blocks[block_num], sec_blocks[b], 16);
        g_tag.block_ok[block_num] = true;
        success_count++;
      }
    }
    Serial.printf("Sector %2d: %s\n", sector, ok ? "OK" : "FAIL");
    if (sd_verbose) {
      char tmp[12];
      snprintf(tmp, sizeof(tmp), "%d:%s ", sector, ok ? "OK" : "FAIL");
      strncat(sector_summary, tmp, sizeof(sector_summary) - strlen(sector_summary) - 1);
    }
  }
  if (sd_verbose) logSDf("[verbose] sectors: %s", sector_summary);

  Serial.printf("%d/48 blocks read\n", success_count);
  logSDf("NFC: %d/48 blocks read", success_count);

  // Sector 0, block 0 is always readable (manufacturer data)
  uint8_t block0[16];
  if (nfc.mifareclassic_ReadDataBlock(0, block0)) {
    memcpy(g_tag.blocks[0], block0, 16);
    g_tag.block_ok[0] = true;
  }

  // Parse data
  parseTagData(g_tag);

  Serial.printf("tray_uuid: %s\n", g_tag.tray_uuid);
  Serial.printf("Material:  %s\n", g_tag.material);
  Serial.printf("Color:     %s\n", g_tag.color_hex);
  Serial.printf("Temp:      %d - %d C\n", g_tag.temp_min, g_tag.temp_max);
  Serial.printf("Vendor:    %s\n", g_tag.vendor);
  Serial.printf("Date:      %s\n", g_tag.production_date);

  g_tag_ready = true;
}

// ============================================================
//  "DRIED TODAY" BUTTON CALLBACK
//  Writes current date as last_dried to Spoolman
// ============================================================
void btn_dried_cb(lv_event_t *e) {
  logSD("UI: Button -> Dried Today");
  if (!wifi_ok) {
    lv_label_set_text(lbl_spoolman_dried_val, "No WiFi!");
    return;
  }
  if (!sm_found || sm_id == 0) {
    lv_label_set_text(lbl_spoolman_dried_val, T(STR_WAIT_SCAN));
    return;
  }

  // Current time as ISO8601 UTC string
  struct tm ti;
  char iso_full_buf[32] = "2026-01-01T00:00:00.000Z";
  if (getLocalTime(&ti)) {
    // Local time (UTC+1) -> convert to UTC
    time_t now = mktime(&ti);
    struct tm *utc = gmtime(&now);
    snprintf(iso_full_buf, sizeof(iso_full_buf), "%04d-%02d-%02dT%02d:%02d:%02d.000Z",
      utc->tm_year+1900, utc->tm_mon+1, utc->tm_mday,
      utc->tm_hour, utc->tm_min, utc->tm_sec);
  }
  String iso_full = String(iso_full_buf);
  String today = iso_full.substring(0, 10);

  Serial.printf("Setting last_dried: %s for spool ID %d\n", iso_full.c_str(), sm_id);

  // PATCH /api/v1/spool/{id}
  HTTPClient http;
  String url = String(cfg_spoolman_base) + "/api/v1/spool/" + sm_id;
  http.begin(url);
  http.addHeader("Content-Type", "application/json");
  http.setTimeout(5000);

  // Body: update extra field
  // Spoolman stores extra fields as escaped strings (with quotes)
  String body = "{\"extra\": {\"last_dried\": \"\\\"" + iso_full + "\\\"\"}}"; 
  Serial.println("PATCH body: " + body);
  int code = http.PATCH(body);
  http.end();

  if (code == 200) {
    // Update display
    char de_date[12];
    isoToDe(today.c_str(), de_date, sizeof(de_date));
    strncpy(sm_last_dried, de_date, sizeof(sm_last_dried)-1);
    char dried_display[48];
    driedDisplayStr(de_date, dried_display, sizeof(dried_display));
    lv_label_set_text(lbl_spoolman_dried_val, dried_display);
    Serial.println("last_dried set!");
  } else {
    Serial.printf("PATCH error: %d\n", code);
    lv_label_set_text(lbl_spoolman_dried_val, T(STR_ERR_SAVE));
  }
}

// ============================================================
//  PREFERENCES (NVS)
// ============================================================
void loadPrefs() {
  prefs.begin("spoolscale", false);
  String ssid = prefs.getString("wifi_ssid", cfg_wifi_ssid);
  String pass = prefs.getString("wifi_pass", cfg_wifi_password);
  String ip   = prefs.getString("spoolman_ip", cfg_spoolman_ip);
  strncpy(cfg_wifi_ssid,     ssid.c_str(), sizeof(cfg_wifi_ssid)-1);
  strncpy(cfg_wifi_password, pass.c_str(), sizeof(cfg_wifi_password)-1);
  strncpy(cfg_spoolman_ip,   ip.c_str(),   sizeof(cfg_spoolman_ip)-1);
  snprintf(cfg_spoolman_base, sizeof(cfg_spoolman_base), "http://%s", cfg_spoolman_ip);
  // NAU7802: Kalibrierfaktor und Tare-Offset laden
  cal_factor  = prefs.getFloat("cal_factor",   CAL_FACTOR_DEFAULT);
  zero_offset = prefs.getInt("zero_offset", 0);
  bag_weight_g = prefs.getFloat("bag_weight", 50.0f);
  // Display-Einstellungen laden
  bright_normal    = prefs.getUChar("bright",    BRIGHT_NORMAL_DEFAULT);
  int dim_min      = prefs.getUInt("dim_min",    DIM_TIMEOUT_DEFAULT / 60000);
  int sleep_min    = prefs.getUInt("sleep_min",  SLEEP_TIMEOUT_DEFAULT / 60000);
  dim_timeout_ms   = dim_min * 60000;
  sleep_timeout_ms = sleep_min * 60000;
  g_lang     = (Lang)prefs.getUChar("lang",     1);  // Default EN
  g_date_fmt =       prefs.getUChar("date_fmt", 0);
  cfg_lang_set =     prefs.getBool("lang_set",  false);
  cfg_first_boot =   prefs.getBool("first_boot", true);
  last_used_mode =   prefs.getUChar("lu_mode",  0);  // 0=OpenSpoolMan, 1=Last Weighed
  prefs.end();
  Serial.printf("Prefs: SSID=%s Spoolman=%s\n", cfg_wifi_ssid, cfg_spoolman_base);
  Serial.printf("Scale: cal_factor=%.4f  zero_offset=%d  bag_weight=%.1fg\n",
    cal_factor, zero_offset, bag_weight_g);
  Serial.printf("Display: bright=%d dim=%dmin sleep=%dmin\n",
    bright_normal, dim_min, sleep_min);
}

void saveCalFactor(float factor) {
  cal_factor = factor;
  prefs.begin("spoolscale", false);
  prefs.putFloat("cal_factor", factor);
  prefs.end();
  Serial.printf("cal_factor saved: %.4f\n", factor);
}

void saveBagWeight(float weight) {
  bag_weight_g = weight;
  prefs.begin("spoolscale", false);
  prefs.putFloat("bag_weight", weight);
  prefs.end();
  Serial.printf("bag_weight saved: %.1fg\n", weight);
}

void saveTareOffset(int32_t offset) {
  zero_offset = offset;
  prefs.begin("spoolscale", false);
  prefs.putInt("zero_offset", offset);
  prefs.end();
  Serial.printf("zero_offset saved: %d\n", offset);
}

void saveWifiCredentials(const char* ssid, const char* pass) {
  strncpy(cfg_wifi_ssid,     ssid, sizeof(cfg_wifi_ssid)-1);
  strncpy(cfg_wifi_password, pass, sizeof(cfg_wifi_password)-1);
  prefs.begin("spoolscale", false);
  prefs.putString("wifi_ssid", ssid);
  prefs.putString("wifi_pass",  pass);
  prefs.end();
  Serial.printf("WiFi saved: SSID=%s\n", ssid);
}


void saveSpoolmanIP(const char* ip) {
  strncpy(cfg_spoolman_ip, ip, sizeof(cfg_spoolman_ip)-1);
  snprintf(cfg_spoolman_base, sizeof(cfg_spoolman_base), "http://%s", ip);
  prefs.begin("spoolscale", false);
  prefs.putString("spoolman_ip", ip);
  prefs.end();
}

// ============================================================
//  HELPER FUNCTIONS: Consistent navigation buttons
//  Back (←): top left, 36x36, goes one level up
//  Close (✕): top right, 36x36, goes directly to main screen
// ============================================================
void addBackButton(lv_obj_t *parent, lv_event_cb_t cb) {
  lv_obj_t *btn = lv_btn_create(parent);
  lv_obj_set_size(btn, 44, 44);
  lv_obj_align(btn, LV_ALIGN_TOP_LEFT, 4, 2);
  lv_obj_set_style_bg_color(btn, lv_color_hex(0x0a1828), 0);
  lv_obj_set_style_bg_color(btn, lv_color_hex(0x1a3060), LV_STATE_PRESSED);
  lv_obj_set_style_radius(btn, 8, 0);
  lv_obj_set_style_shadow_width(btn, 0, 0);
  lv_obj_set_style_border_width(btn, 0, 0);
  lv_obj_add_event_cb(btn, cb, LV_EVENT_CLICKED, NULL);
  lv_obj_t *lbl = lv_label_create(btn);
  lv_label_set_text(lbl, LV_SYMBOL_LEFT);
  lv_obj_set_style_text_font(lbl, &lv_font_montserrat_18, 0);
  lv_obj_set_style_text_color(lbl, lv_color_hex(0x28d49a), 0);
  lv_obj_center(lbl);
}

void addCloseButton(lv_obj_t *parent) {
  lv_obj_t *btn = lv_btn_create(parent);
  lv_obj_set_size(btn, 44, 44);
  lv_obj_align(btn, LV_ALIGN_TOP_RIGHT, -4, 2);
  lv_obj_set_style_bg_color(btn, lv_color_hex(0x3a1010), 0);
  lv_obj_set_style_bg_color(btn, lv_color_hex(0x602020), LV_STATE_PRESSED);
  lv_obj_set_style_radius(btn, 8, 0);
  lv_obj_set_style_shadow_width(btn, 0, 0);
  lv_obj_set_style_border_width(btn, 0, 0);
  lv_obj_add_event_cb(btn, [](lv_event_t *e){ showMainScreen(); }, LV_EVENT_CLICKED, NULL);
  lv_obj_t *lbl = lv_label_create(btn);
  lv_label_set_text(lbl, LV_SYMBOL_CLOSE);
  lv_obj_set_style_text_font(lbl, &lv_font_montserrat_18, 0);
  lv_obj_set_style_text_color(lbl, lv_color_hex(0xff8080), 0);
  lv_obj_center(lbl);
}

// ============================================================
//  SETTINGS SCREENS
// ============================================================

// Helper: go back to main screen
void hideAllOverlays() {
  // ── Verbose tracing: count visible overlays + log which one is being deleted ──
  if (sd_verbose) {
    int visible_count = 0;
    if (scr_settings && !lv_obj_has_flag(scr_settings, LV_OBJ_FLAG_HIDDEN)) visible_count++;
    if (scr_connection && !lv_obj_has_flag(scr_connection, LV_OBJ_FLAG_HIDDEN)) visible_count++;
    if (scr_scale_sub && !lv_obj_has_flag(scr_scale_sub, LV_OBJ_FLAG_HIDDEN)) visible_count++;
    if (scr_display && !lv_obj_has_flag(scr_display, LV_OBJ_FLAG_HIDDEN)) visible_count++;
    if (scr_system && !lv_obj_has_flag(scr_system, LV_OBJ_FLAG_HIDDEN)) visible_count++;
    logSDf("[verbose] hideAllOverlays: %d visible, more_info=%s",
      visible_count, scr_more_info ? "yes(will delete)" : "no");
  }
  // scr_more_info is always rebuilt — safe to delete here
  if (scr_more_info) {
    if (sd_verbose) logSD("[verbose] hideAllOverlays: deleting scr_more_info");
    lv_obj_del(scr_more_info); scr_more_info = nullptr;
    if (sd_verbose) logSD("[verbose] hideAllOverlays: scr_more_info deleted OK");
  }
  // All other screens: hidden only. Deleting here causes PANIC because
  // callbacks call hideAllOverlays() while still running inside the screen's
  // event context. Safe deletion happens in showMainScreen() and showSettingsScreen().
  if (scr_settings)    lv_obj_add_flag(scr_settings,    LV_OBJ_FLAG_HIDDEN);
  if (scr_connection)  lv_obj_add_flag(scr_connection,  LV_OBJ_FLAG_HIDDEN);
  if (scr_scale_sub)   lv_obj_add_flag(scr_scale_sub,   LV_OBJ_FLAG_HIDDEN);
  if (scr_display)     lv_obj_add_flag(scr_display,     LV_OBJ_FLAG_HIDDEN);
  if (scr_system)      lv_obj_add_flag(scr_system,      LV_OBJ_FLAG_HIDDEN);
  if (scr_ota)         lv_obj_add_flag(scr_ota,         LV_OBJ_FLAG_HIDDEN);
  if (scr_ota_browser) lv_obj_add_flag(scr_ota_browser, LV_OBJ_FLAG_HIDDEN);
  if (scr_ota_github)  lv_obj_add_flag(scr_ota_github,  LV_OBJ_FLAG_HIDDEN);
  if (scr_factor)      lv_obj_add_flag(scr_factor,      LV_OBJ_FLAG_HIDDEN);
  if (scr_bag)         lv_obj_add_flag(scr_bag,         LV_OBJ_FLAG_HIDDEN);
  if (scr_lastused)    lv_obj_add_flag(scr_lastused,    LV_OBJ_FLAG_HIDDEN);
  if (scr_spoolman_fail) lv_obj_add_flag(scr_spoolman_fail, LV_OBJ_FLAG_HIDDEN);
  if (scr_wifi)        lv_obj_add_flag(scr_wifi,        LV_OBJ_FLAG_HIDDEN);
  if (scr_spoolman)    lv_obj_add_flag(scr_spoolman,    LV_OBJ_FLAG_HIDDEN);
  if (scr_welcome)     lv_obj_add_flag(scr_welcome,     LV_OBJ_FLAG_HIDDEN);
  if (scr_first_boot)  lv_obj_add_flag(scr_first_boot,  LV_OBJ_FLAG_HIDDEN);
  if (scr_extra_fields) lv_obj_add_flag(scr_extra_fields, LV_OBJ_FLAG_HIDDEN);
  if (scr_cal_reminder) lv_obj_add_flag(scr_cal_reminder, LV_OBJ_FLAG_HIDDEN);
  if (scr_wifi_setup)  lv_obj_add_flag(scr_wifi_setup,  LV_OBJ_FLAG_HIDDEN);
  if (scr_wifi_pass)   lv_obj_add_flag(scr_wifi_pass,   LV_OBJ_FLAG_HIDDEN);
  if (scr_wifi_connecting) lv_obj_add_flag(scr_wifi_connecting, LV_OBJ_FLAG_HIDDEN);
  // Free PSRAM spool list if link flow was aborted
  if (link_spools) { heap_caps_free(link_spools); link_spools = nullptr; link_spool_count = 0; }
}

void showMainScreen() {
  logSD("UI: Screen -> Main");
  hideAllOverlays();
  // Safe to delete all menu screens here — no screen callbacks are active
  if (scr_settings)    { lv_obj_del(scr_settings);    scr_settings    = nullptr; }
  if (scr_connection)  { lv_obj_del(scr_connection);  scr_connection  = nullptr; }
  if (scr_scale_sub)   { lv_obj_del(scr_scale_sub);   scr_scale_sub   = nullptr; }
  if (scr_display)     { lv_obj_del(scr_display);     scr_display     = nullptr; }
  if (scr_system)      { lv_obj_del(scr_system);      scr_system      = nullptr; }
  if (scr_ota)         { lv_obj_del(scr_ota);         scr_ota         = nullptr; }
  if (scr_ota_browser) { lv_obj_del(scr_ota_browser); scr_ota_browser = nullptr; }
  if (scr_ota_github)  { lv_obj_del(scr_ota_github);  scr_ota_github  = nullptr; }
  if (scr_factor)      { lv_obj_del(scr_factor);      scr_factor      = nullptr; }
  if (scr_bag)         { lv_obj_del(scr_bag);         scr_bag         = nullptr; }
  if (scr_lastused)    { lv_obj_del(scr_lastused);    scr_lastused    = nullptr; }
  if (scr_spoolman_fail){ lv_obj_del(scr_spoolman_fail); scr_spoolman_fail = nullptr; }
  if (scr_welcome)     { lv_obj_del(scr_welcome);     scr_welcome     = nullptr; }
  if (scr_first_boot)  { lv_obj_del(scr_first_boot);  scr_first_boot  = nullptr; }
  if (scr_extra_fields){ lv_obj_del(scr_extra_fields); scr_extra_fields = nullptr;
                         lbl_extra_fields_status = nullptr;
                         btn_extra_fields_create = nullptr;
                         btn_extra_fields_next   = nullptr; }
  if (scr_cal_reminder){ lv_obj_del(scr_cal_reminder); scr_cal_reminder = nullptr; }
  resetActivityTimer();
}

void showSettingsScreen() {
  logSD("UI: Screen -> Settings");
  // Free setup screens if still in memory
  if (scr_welcome)    { lv_obj_del(scr_welcome);    scr_welcome    = nullptr; }
  if (scr_first_boot) { lv_obj_del(scr_first_boot); scr_first_boot = nullptr; }
  if (scr_wifi_setup) { lv_obj_del(scr_wifi_setup); scr_wifi_setup = nullptr; }
  if (scr_wifi_pass)  { lv_obj_del(scr_wifi_pass);  scr_wifi_pass  = nullptr; }
  hideAllOverlays();
  // Safe to delete sub-screens here — no sub-screen callbacks are active
  if (scr_settings)    { lv_obj_del(scr_settings);    scr_settings    = nullptr; }
  if (scr_connection)  { lv_obj_del(scr_connection);  scr_connection  = nullptr; }
  if (scr_scale_sub)   { lv_obj_del(scr_scale_sub);   scr_scale_sub   = nullptr; }
  if (scr_display)     { lv_obj_del(scr_display);     scr_display     = nullptr; }
  if (scr_system)      { lv_obj_del(scr_system);      scr_system      = nullptr; }
  if (scr_ota)         { lv_obj_del(scr_ota);         scr_ota         = nullptr; }
  if (scr_ota_browser) { lv_obj_del(scr_ota_browser); scr_ota_browser = nullptr; }
  if (scr_ota_github)  { lv_obj_del(scr_ota_github);  scr_ota_github  = nullptr; }
  if (scr_factor)      { lv_obj_del(scr_factor);      scr_factor      = nullptr; }
  if (scr_bag)         { lv_obj_del(scr_bag);         scr_bag         = nullptr; }
  if (scr_lastused)    { lv_obj_del(scr_lastused);    scr_lastused    = nullptr; }
  if (scr_spoolman_fail){ lv_obj_del(scr_spoolman_fail); scr_spoolman_fail = nullptr; }
  buildSettingsScreen();
  lv_obj_clear_flag(scr_settings, LV_OBJ_FLAG_HIDDEN);
  resetActivityTimer();
}

// ============================================================
//  WELCOME SCREEN (first boot — SSID empty)
// ============================================================
void showWelcomeScreen() {
  logSD("UI: Screen -> Welcome");
  hideAllOverlays();
  if (!scr_welcome) buildWelcomeScreen();
  lv_obj_clear_flag(scr_welcome, LV_OBJ_FLAG_HIDDEN);
}

void buildWelcomeScreen() {
  scr_welcome = lv_obj_create(lv_scr_act());
  lv_obj_set_size(scr_welcome, 480, 320);
  lv_obj_set_pos(scr_welcome, 0, 0);
  lv_obj_add_flag(scr_welcome, LV_OBJ_FLAG_HIDDEN);
  lv_obj_set_style_radius(scr_welcome, 0, 0);
  lv_obj_set_style_border_width(scr_welcome, 0, 0);
  lv_obj_set_style_pad_all(scr_welcome, 0, 0);
  lv_obj_clear_flag(scr_welcome, LV_OBJ_FLAG_SCROLLABLE);
  lv_obj_set_style_bg_color(scr_welcome, lv_color_hex(0x0a1020), 0);

  // First boot: language selection
  lv_obj_t *lbl_logo = lv_label_create(scr_welcome);
  lv_label_set_text(lbl_logo, "SpoolmanScale");
  lv_obj_set_style_text_color(lbl_logo, lv_color_hex(0x28d49a), 0);
  lv_obj_set_style_text_font(lbl_logo, &lv_font_montserrat_24, 0);
  lv_obj_align(lbl_logo, LV_ALIGN_TOP_MID, 0, 24);

  lv_obj_t *lbl_sub = lv_label_create(scr_welcome);
  lv_label_set_text(lbl_sub, T(STR_WELCOME_LANG_TITLE));
  lv_obj_set_style_text_color(lbl_sub, lv_color_hex(0x4a6fa0), 0);
  lv_obj_set_style_text_font(lbl_sub, &lv_font_montserrat_16, 0);
  lv_obj_align(lbl_sub, LV_ALIGN_TOP_MID, 0, 64);

  lv_obj_t *lbl_hint = lv_label_create(scr_welcome);
  lv_label_set_text(lbl_hint, T(STR_WELCOME_LANG_HINT));
  lv_obj_set_style_text_color(lbl_hint, lv_color_hex(0x2a4060), 0);
  lv_obj_set_style_text_font(lbl_hint, &lv_font_montserrat_12, 0);
  lv_obj_set_style_text_align(lbl_hint, LV_TEXT_ALIGN_CENTER, 0);
  lv_label_set_long_mode(lbl_hint, LV_LABEL_LONG_WRAP);
  lv_obj_set_width(lbl_hint, 420);
  lv_obj_align(lbl_hint, LV_ALIGN_TOP_MID, 0, 96);

  // X button top right (only if lang already set — no infinite loop)
  if (cfg_lang_set) {
    lv_obj_t *btn_x = lv_btn_create(scr_welcome);
    lv_obj_set_size(btn_x, 44, 44);
    lv_obj_align(btn_x, LV_ALIGN_TOP_RIGHT, -4, 2);
    lv_obj_set_style_bg_color(btn_x, lv_color_hex(0x3a1010), 0);
    lv_obj_set_style_bg_color(btn_x, lv_color_hex(0x602020), LV_STATE_PRESSED);
    lv_obj_set_style_radius(btn_x, 8, 0);
    lv_obj_set_style_shadow_width(btn_x, 0, 0);
    lv_obj_set_style_border_width(btn_x, 0, 0);
    lv_obj_t *lbl_x = lv_label_create(btn_x);
    lv_label_set_text(lbl_x, LV_SYMBOL_CLOSE);
    lv_obj_set_style_text_color(lbl_x, lv_color_hex(0xff8080), 0);
    lv_obj_set_style_text_font(lbl_x, &lv_font_montserrat_18, 0);
    lv_obj_center(lbl_x);
    lv_obj_add_event_cb(btn_x, [](lv_event_t *e){ showMainScreen(); }, LV_EVENT_CLICKED, NULL);
  }

  // X button top right (only if lang already set — no infinite loop)
  // Language buttons side by side
  const int LB_W = 218, LB_H = 60, LB_Y = 136;

  // EN button (links — Standard, hervorgehoben)
  lv_obj_t *btn_en = lv_btn_create(scr_welcome);
  lv_obj_set_size(btn_en, LB_W, LB_H);
  lv_obj_set_pos(btn_en, 8, LB_Y);
  lv_obj_set_style_bg_color(btn_en, lv_color_hex(0x0a2a40), 0);
  lv_obj_set_style_bg_color(btn_en, lv_color_hex(0x1a4060), LV_STATE_PRESSED);
  lv_obj_set_style_radius(btn_en, 10, 0);
  lv_obj_set_style_shadow_width(btn_en, 0, 0);
  lv_obj_set_style_border_width(btn_en, 2, 0);
  lv_obj_set_style_border_color(btn_en, lv_color_hex(0x28d49a), 0);
  lv_obj_t *lbl_en = lv_label_create(btn_en);
  lv_label_set_text(lbl_en, "EN   English");
  lv_obj_set_style_text_color(lbl_en, lv_color_hex(0x28d49a), 0);
  lv_obj_set_style_text_font(lbl_en, &lv_font_montserrat_18, 0);
  lv_obj_center(lbl_en);
  lv_obj_add_event_cb(btn_en, [](lv_event_t *e){
    Preferences p; p.begin("spoolscale", false);
    p.putUChar("lang", 1);
    p.putBool("lang_set", true);
    p.putBool("first_boot", true);
    p.end();
    g_lang = LANG_EN;
    cfg_lang_set = true;
    cfg_first_boot = true;
    // EN is default — no reboot needed, defer screen switch to loop
    lang_selected_no_reboot = true;
  }, LV_EVENT_CLICKED, NULL);

  // DE button (rechts)
  lv_obj_t *btn_de = lv_btn_create(scr_welcome);
  lv_obj_set_size(btn_de, LB_W, LB_H);
  lv_obj_set_pos(btn_de, 254, LB_Y);
  lv_obj_set_style_bg_color(btn_de, lv_color_hex(0x0a1828), 0);
  lv_obj_set_style_bg_color(btn_de, lv_color_hex(0x1a3060), LV_STATE_PRESSED);
  lv_obj_set_style_radius(btn_de, 10, 0);
  lv_obj_set_style_shadow_width(btn_de, 0, 0);
  lv_obj_set_style_border_width(btn_de, 2, 0);
  lv_obj_set_style_border_color(btn_de, lv_color_hex(0x1a3060), 0);
  lv_obj_t *lbl_de = lv_label_create(btn_de);
  lv_label_set_text(lbl_de, "DE   Deutsch");
  lv_obj_set_style_text_color(lbl_de, lv_color_hex(0x4a6fa0), 0);
  lv_obj_set_style_text_font(lbl_de, &lv_font_montserrat_18, 0);
  lv_obj_center(lbl_de);
  lv_obj_add_event_cb(btn_de, [](lv_event_t *e){
    g_lang = LANG_DE;
    Preferences p; p.begin("spoolscale", false);
    p.putUChar("lang", 0);
    p.putBool("lang_set", true);
    p.putBool("first_boot", true);  // show welcome screen after restart
    p.end();
    ESP.restart();
  }, LV_EVENT_CLICKED, NULL);

  // Bottom hint
  lv_obj_t *lbl_skip = lv_label_create(scr_welcome);
  lv_label_set_text(lbl_skip, T(STR_LANG_HINT));
  lv_obj_set_style_text_color(lbl_skip, lv_color_hex(0x2a4060), 0);
  lv_obj_set_style_text_font(lbl_skip, &lv_font_montserrat_12, 0);
  lv_obj_set_style_text_align(lbl_skip, LV_TEXT_ALIGN_CENTER, 0);
  lv_obj_align(lbl_skip, LV_ALIGN_BOTTOM_MID, 0, -10);
}

// ============================================================
//  FIRST BOOT SCREEN (very first launch — before language selection)
// ============================================================
void showFirstBootScreen() {
  logSD("UI: Screen -> FirstBoot");
  hideAllOverlays();
  if (!scr_first_boot) buildFirstBootScreen();
  lv_obj_clear_flag(scr_first_boot, LV_OBJ_FLAG_HIDDEN);
}

void buildFirstBootScreen() {
  scr_first_boot = lv_obj_create(lv_scr_act());
  lv_obj_set_size(scr_first_boot, 480, 320);
  lv_obj_set_pos(scr_first_boot, 0, 0);
  lv_obj_add_flag(scr_first_boot, LV_OBJ_FLAG_HIDDEN);
  lv_obj_set_style_radius(scr_first_boot, 0, 0);
  lv_obj_set_style_border_width(scr_first_boot, 0, 0);
  lv_obj_set_style_pad_all(scr_first_boot, 0, 0);
  lv_obj_clear_flag(scr_first_boot, LV_OBJ_FLAG_SCROLLABLE);
  lv_obj_set_style_bg_color(scr_first_boot, lv_color_hex(0x0a1020), 0);

  // Logo
  lv_obj_t *lbl_logo = lv_label_create(scr_first_boot);
  lv_label_set_text(lbl_logo, "SpoolmanScale");
  lv_obj_set_style_text_color(lbl_logo, lv_color_hex(0x28d49a), 0);
  lv_obj_set_style_text_font(lbl_logo, &lv_font_montserrat_24, 0);
  lv_obj_align(lbl_logo, LV_ALIGN_TOP_MID, 0, 32);

  // Welcome title
  lv_obj_t *lbl_title = lv_label_create(scr_first_boot);
  lv_label_set_text(lbl_title, T(STR_FIRSTBOOT_TITLE));
  lv_obj_set_style_text_color(lbl_title, lv_color_hex(0xe8f0ff), 0);
  lv_obj_set_style_text_font(lbl_title, &lv_font_montserrat_20, 0);
  lv_obj_align(lbl_title, LV_ALIGN_TOP_MID, 0, 72);

  // Subtitle
  lv_obj_t *lbl_sub = lv_label_create(scr_first_boot);
  lv_label_set_text(lbl_sub, T(STR_FIRSTBOOT_SUB));
  lv_obj_set_style_text_color(lbl_sub, lv_color_hex(0x28d49a), 0);
  lv_obj_set_style_text_font(lbl_sub, &lv_font_montserrat_16, 0);
  lv_obj_set_style_text_align(lbl_sub, LV_TEXT_ALIGN_CENTER, 0);
  lv_obj_align(lbl_sub, LV_ALIGN_TOP_MID, 0, 104);

  // Hint
  lv_obj_t *lbl_hint = lv_label_create(scr_first_boot);
  lv_label_set_text(lbl_hint, T(STR_FIRSTBOOT_HINT));
  lv_obj_set_style_text_color(lbl_hint, lv_color_hex(0x4a6fa0), 0);
  lv_obj_set_style_text_font(lbl_hint, &lv_font_montserrat_14, 0);
  lv_obj_set_style_text_align(lbl_hint, LV_TEXT_ALIGN_CENTER, 0);
  lv_label_set_long_mode(lbl_hint, LV_LABEL_LONG_WRAP);
  lv_obj_set_width(lbl_hint, 420);
  lv_obj_align(lbl_hint, LV_ALIGN_TOP_MID, 0, 138);

  // X button: only show if WiFi already configured (not absolute first boot)
  if (strlen(cfg_wifi_ssid) > 0) {
    lv_obj_t *btn_cx = lv_btn_create(scr_first_boot);
    lv_obj_set_size(btn_cx, 44, 44);
    lv_obj_align(btn_cx, LV_ALIGN_TOP_RIGHT, -4, 2);
    lv_obj_set_style_bg_color(btn_cx, lv_color_hex(0x3a1010), 0);
    lv_obj_set_style_bg_color(btn_cx, lv_color_hex(0x602020), LV_STATE_PRESSED);
    lv_obj_set_style_radius(btn_cx, 8, 0);
    lv_obj_set_style_shadow_width(btn_cx, 0, 0);
    lv_obj_set_style_border_width(btn_cx, 0, 0);
    lv_obj_add_event_cb(btn_cx, [](lv_event_t *e){ showMainScreen(); }, LV_EVENT_CLICKED, NULL);
    lv_obj_t *lbl_cx = lv_label_create(btn_cx);
    lv_label_set_text(lbl_cx, LV_SYMBOL_CLOSE);
    lv_obj_set_style_text_color(lbl_cx, lv_color_hex(0xff8080), 0);
    lv_obj_set_style_text_font(lbl_cx, &lv_font_montserrat_18, 0);
    lv_obj_center(lbl_cx);
  }

  // Get started button (links) + Skip button (rechts), symmetrisch
  lv_obj_t *btn_start = lv_btn_create(scr_first_boot);
  lv_obj_set_size(btn_start, 226, 48);
  lv_obj_set_pos(btn_start, 12, 252);
  lv_obj_set_style_bg_color(btn_start, lv_color_hex(0x1a3020), 0);
  lv_obj_set_style_bg_color(btn_start, lv_color_hex(0x2a5030), LV_STATE_PRESSED);
  lv_obj_set_style_radius(btn_start, 10, 0);
  lv_obj_set_style_shadow_width(btn_start, 0, 0);
  lv_obj_set_style_border_width(btn_start, 1, 0);
  lv_obj_set_style_border_color(btn_start, lv_color_hex(0x2a5030), 0);
  lv_obj_add_event_cb(btn_start, [](lv_event_t *e) {
    Preferences p; p.begin("spoolscale", false);
    p.putBool("first_boot", false);
    p.end();
    cfg_first_boot = false;
    showWifiSetupScreen();
  }, LV_EVENT_CLICKED, NULL);
  lv_obj_t *lbl_start = lv_label_create(btn_start);
  lv_label_set_text(lbl_start, T(STR_FIRSTBOOT_BTN));
  lv_obj_set_style_text_color(lbl_start, lv_color_hex(0x40c080), 0);
  lv_obj_set_style_text_font(lbl_start, &lv_font_montserrat_16, 0);
  lv_obj_set_style_text_align(lbl_start, LV_TEXT_ALIGN_CENTER, 0);
  lv_obj_align(lbl_start, LV_ALIGN_CENTER, 0, 0);

  // Skip setup button (rechts)
  lv_obj_t *btn_skip = lv_btn_create(scr_first_boot);
  lv_obj_set_size(btn_skip, 226, 48);
  lv_obj_set_pos(btn_skip, 242, 252);
  lv_obj_set_style_bg_color(btn_skip, lv_color_hex(0x0a1828), 0);
  lv_obj_set_style_bg_color(btn_skip, lv_color_hex(0x1a2840), LV_STATE_PRESSED);
  lv_obj_set_style_radius(btn_skip, 10, 0);
  lv_obj_set_style_shadow_width(btn_skip, 0, 0);
  lv_obj_set_style_border_width(btn_skip, 1, 0);
  lv_obj_set_style_border_color(btn_skip, lv_color_hex(0x1a2840), 0);
  lv_obj_add_event_cb(btn_skip, [](lv_event_t *e) {
    skip_setup_pending = true;
  }, LV_EVENT_CLICKED, NULL);
  lv_obj_t *lbl_skip = lv_label_create(btn_skip);
  char skip_buf[32];
  strncpy(skip_buf, T(STR_BTN_SKIP_SETUP), sizeof(skip_buf)-1);
  lv_label_set_text(lbl_skip, skip_buf);
  lv_obj_set_style_text_color(lbl_skip, lv_color_hex(0x4a6fa0), 0);
  lv_obj_set_style_text_font(lbl_skip, &lv_font_montserrat_14, 0);
  lv_obj_set_style_text_align(lbl_skip, LV_TEXT_ALIGN_CENTER, 0);
  lv_obj_align(lbl_skip, LV_ALIGN_CENTER, 0, 0);
}

// ============================================================
//  EXTRA FIELDS SCREEN
//  Check/create Spoolman extra fields 'tag' and 'last_dried'
// ============================================================

// Required extra fields — extend this array for future fields
static const char* REQUIRED_EXTRA_FIELDS_BASE[] = { "tag", "last_dried" };
static const int   REQUIRED_EXTRA_FIELDS_BASE_COUNT = 2;

void showExtraFieldsScreen(bool is_setup_flow) {
  logSDf("UI: Screen -> ExtraFields (setup=%d)", is_setup_flow ? 1 : 0);
  hideAllOverlays();
  extra_fields_setup_flow = is_setup_flow;
  if (scr_extra_fields) { lv_obj_del(scr_extra_fields); scr_extra_fields = nullptr; }
  lbl_extra_fields_status = nullptr;
  btn_extra_fields_create = nullptr;
  btn_extra_fields_next   = nullptr;
  buildExtraFieldsScreen(is_setup_flow);
  lv_obj_clear_flag(scr_extra_fields, LV_OBJ_FLAG_HIDDEN);
}

void buildExtraFieldsScreen(bool is_setup_flow) {
  scr_extra_fields = lv_obj_create(lv_scr_act());
  lv_obj_set_size(scr_extra_fields, 480, 320);
  lv_obj_set_pos(scr_extra_fields, 0, 0);
  lv_obj_add_flag(scr_extra_fields, LV_OBJ_FLAG_HIDDEN);
  lv_obj_set_style_radius(scr_extra_fields, 0, 0);
  lv_obj_set_style_border_width(scr_extra_fields, 0, 0);
  lv_obj_set_style_pad_all(scr_extra_fields, 0, 0);
  lv_obj_clear_flag(scr_extra_fields, LV_OBJ_FLAG_SCROLLABLE);
  lv_obj_set_style_bg_color(scr_extra_fields, lv_color_hex(0x0a1020), 0);

  // Header: back goes to connection screen (if from settings), or back to Spoolman IP (setup flow)
  if (!is_setup_flow) {
    buildSubHeader(scr_extra_fields, T(STR_EXTRA_FIELDS_TITLE),
      [](lv_event_t *e) {
        if (!scr_connection) buildConnectionScreen();
        hideAllOverlays();
        lv_obj_clear_flag(scr_connection, LV_OBJ_FLAG_HIDDEN);
      });
  } else {
    // Setup flow: title only + X (→ main screen), no back button
    lv_obj_t *lbl_title = lv_label_create(scr_extra_fields);
    lv_label_set_text(lbl_title, T(STR_EXTRA_FIELDS_TITLE));
    lv_obj_set_style_text_color(lbl_title, lv_color_hex(0x28d49a), 0);
    lv_obj_set_style_text_font(lbl_title, &lv_font_montserrat_18, 0);
    lv_obj_align(lbl_title, LV_ALIGN_TOP_MID, 0, 12);

    // X → main screen (exit setup)
    lv_obj_t *btn_x = lv_btn_create(scr_extra_fields);
    lv_obj_set_size(btn_x, 44, 44);
    lv_obj_align(btn_x, LV_ALIGN_TOP_RIGHT, -4, 2);
    lv_obj_set_style_bg_color(btn_x, lv_color_hex(0x3a1010), 0);
    lv_obj_set_style_bg_color(btn_x, lv_color_hex(0x602020), LV_STATE_PRESSED);
    lv_obj_set_style_radius(btn_x, 8, 0);
    lv_obj_set_style_shadow_width(btn_x, 0, 0);
    lv_obj_set_style_border_width(btn_x, 0, 0);
    lv_obj_add_event_cb(btn_x, [](lv_event_t *e){ showMainScreen(); }, LV_EVENT_CLICKED, NULL);
    lv_obj_t *lbl_x = lv_label_create(btn_x);
    lv_label_set_text(lbl_x, LV_SYMBOL_CLOSE);
    lv_obj_set_style_text_color(lbl_x, lv_color_hex(0xff8080), 0);
    lv_obj_set_style_text_font(lbl_x, &lv_font_montserrat_18, 0);
    lv_obj_center(lbl_x);
  }

  // Hint text
  lv_obj_t *lbl_hint = lv_label_create(scr_extra_fields);
  lv_label_set_text(lbl_hint, T(STR_EXTRA_FIELDS_HINT));
  lv_obj_set_style_text_color(lbl_hint, lv_color_hex(0x4a6fa0), 0);
  lv_obj_set_style_text_font(lbl_hint, &lv_font_montserrat_12, 0);
  lv_obj_set_style_text_align(lbl_hint, LV_TEXT_ALIGN_CENTER, 0);
  lv_label_set_long_mode(lbl_hint, LV_LABEL_LONG_WRAP);
  lv_obj_set_width(lbl_hint, 440);
  lv_obj_align(lbl_hint, LV_ALIGN_TOP_MID, 0, 54);

  // Check button
  lv_obj_t *btn_check = lv_btn_create(scr_extra_fields);
  lv_obj_set_size(btn_check, 280, 44);
  lv_obj_align(btn_check, LV_ALIGN_TOP_MID, 0, 138);
  lv_obj_set_style_bg_color(btn_check, lv_color_hex(0x0a1e30), 0);
  lv_obj_set_style_bg_color(btn_check, lv_color_hex(0x1a3050), LV_STATE_PRESSED);
  lv_obj_set_style_radius(btn_check, 8, 0);
  lv_obj_set_style_shadow_width(btn_check, 0, 0);
  lv_obj_set_style_border_width(btn_check, 1, 0);
  lv_obj_set_style_border_color(btn_check, lv_color_hex(0x1a3060), 0);
  lv_obj_add_event_cb(btn_check, [](lv_event_t *e) {
    extra_fields_check_pending = true;
  }, LV_EVENT_CLICKED, NULL);
  lv_obj_t *lbl_check = lv_label_create(btn_check);
  lv_label_set_text(lbl_check, T(STR_EXTRA_FIELDS_CHECK_BTN));
  lv_obj_set_style_text_color(lbl_check, lv_color_hex(0xc8d8f0), 0);
  lv_obj_set_style_text_font(lbl_check, &lv_font_montserrat_16, 0);
  lv_obj_center(lbl_check);

  // Status label — below check button
  lbl_extra_fields_status = lv_label_create(scr_extra_fields);
  lv_label_set_text(lbl_extra_fields_status, "");
  lv_obj_set_style_text_color(lbl_extra_fields_status, lv_color_hex(0xc8d8f0), 0);
  lv_obj_set_style_text_font(lbl_extra_fields_status, &lv_font_montserrat_14, 0);
  lv_obj_set_style_text_align(lbl_extra_fields_status, LV_TEXT_ALIGN_CENTER, 0);
  lv_label_set_long_mode(lbl_extra_fields_status, LV_LABEL_LONG_WRAP);
  lv_obj_set_width(lbl_extra_fields_status, 440);
  lv_obj_align(lbl_extra_fields_status, LV_ALIGN_TOP_MID, 0, 192);

  // Create missing fields button — full width, above bottom row, initially hidden
  btn_extra_fields_create = lv_btn_create(scr_extra_fields);
  lv_obj_set_size(btn_extra_fields_create, 440, 42);
  lv_obj_align(btn_extra_fields_create, LV_ALIGN_TOP_MID, 0, 228);
  lv_obj_set_style_bg_color(btn_extra_fields_create, lv_color_hex(0x1a3020), 0);
  lv_obj_set_style_bg_color(btn_extra_fields_create, lv_color_hex(0x2a5030), LV_STATE_PRESSED);
  lv_obj_set_style_radius(btn_extra_fields_create, 8, 0);
  lv_obj_set_style_shadow_width(btn_extra_fields_create, 0, 0);
  lv_obj_set_style_border_width(btn_extra_fields_create, 1, 0);
  lv_obj_set_style_border_color(btn_extra_fields_create, lv_color_hex(0x2a5030), 0);
  lv_obj_add_flag(btn_extra_fields_create, LV_OBJ_FLAG_HIDDEN);
  lv_obj_add_event_cb(btn_extra_fields_create, [](lv_event_t *e) {
    // Confirmation popup
    lv_obj_t *pop = lv_obj_create(lv_scr_act());
    lv_obj_set_size(pop, 480, 320);
    lv_obj_set_pos(pop, 0, 0);
    lv_obj_set_style_bg_color(pop, lv_color_hex(0x00000080), 0);  // semi-transparent
    lv_obj_set_style_bg_opa(pop, LV_OPA_70, 0);
    lv_obj_set_style_border_width(pop, 0, 0);
    lv_obj_set_style_radius(pop, 0, 0);
    lv_obj_set_style_pad_all(pop, 0, 0);
    lv_obj_clear_flag(pop, LV_OBJ_FLAG_SCROLLABLE);

    lv_obj_t *box = lv_obj_create(pop);
    lv_obj_set_size(box, 420, 220);
    lv_obj_align(box, LV_ALIGN_CENTER, 0, 0);
    lv_obj_set_style_bg_color(box, lv_color_hex(0x0d1a2a), 0);
    lv_obj_set_style_border_color(box, lv_color_hex(0x1a3060), 0);
    lv_obj_set_style_border_width(box, 1, 0);
    lv_obj_set_style_radius(box, 10, 0);
    lv_obj_set_style_pad_all(box, 0, 0);
    lv_obj_clear_flag(box, LV_OBJ_FLAG_SCROLLABLE);

    lv_obj_t *lbl_ct = lv_label_create(box);
    lv_label_set_text(lbl_ct, T(STR_EXTRA_FIELDS_CONFIRM_TITLE));
    lv_obj_set_style_text_color(lbl_ct, lv_color_hex(0x28d49a), 0);
    lv_obj_set_style_text_font(lbl_ct, &lv_font_montserrat_18, 0);
    lv_obj_align(lbl_ct, LV_ALIGN_TOP_MID, 0, 18);

    lv_obj_t *lbl_cm = lv_label_create(box);
    lv_label_set_text(lbl_cm, T(STR_EXTRA_FIELDS_CONFIRM_MSG));
    lv_obj_set_style_text_color(lbl_cm, lv_color_hex(0xc8d8f0), 0);
    lv_obj_set_style_text_font(lbl_cm, &lv_font_montserrat_14, 0);
    lv_obj_set_style_text_align(lbl_cm, LV_TEXT_ALIGN_CENTER, 0);
    lv_label_set_long_mode(lbl_cm, LV_LABEL_LONG_WRAP);
    lv_obj_set_width(lbl_cm, 380);
    lv_obj_align(lbl_cm, LV_ALIGN_TOP_MID, 0, 52);

    // Confirm button
    lv_obj_t *btn_conf = lv_btn_create(box);
    lv_obj_set_size(btn_conf, 180, 44);
    lv_obj_align(btn_conf, LV_ALIGN_BOTTOM_RIGHT, -12, -12);
    lv_obj_set_style_bg_color(btn_conf, lv_color_hex(0x1a3020), 0);
    lv_obj_set_style_bg_color(btn_conf, lv_color_hex(0x2a5030), LV_STATE_PRESSED);
    lv_obj_set_style_radius(btn_conf, 8, 0);
    lv_obj_set_style_shadow_width(btn_conf, 0, 0);
    lv_obj_set_style_border_width(btn_conf, 0, 0);
    lv_obj_add_event_cb(btn_conf, [](lv_event_t *e) {
      // Close popup (2 levels up: btn -> box -> pop)
      lv_obj_t *box_obj = lv_obj_get_parent(lv_event_get_target(e));
      lv_obj_t *pop_obj = lv_obj_get_parent(box_obj);
      lv_obj_del(pop_obj);
      // Defer HTTP call to loop — never call HTTP directly from LVGL event callback
      extra_fields_create_pending = true;
    }, LV_EVENT_CLICKED, NULL);
    lv_obj_t *lbl_conf = lv_label_create(btn_conf);
    lv_label_set_text(lbl_conf, T(STR_CONFIRM));
    lv_obj_set_style_text_color(lbl_conf, lv_color_hex(0x40c080), 0);
    lv_obj_set_style_text_font(lbl_conf, &lv_font_montserrat_16, 0);
    lv_obj_center(lbl_conf);

    // Cancel button
    lv_obj_t *btn_can = lv_btn_create(box);
    lv_obj_set_size(btn_can, 140, 44);
    lv_obj_align(btn_can, LV_ALIGN_BOTTOM_LEFT, 12, -12);
    lv_obj_set_style_bg_color(btn_can, lv_color_hex(0x1a2030), 0);
    lv_obj_set_style_bg_color(btn_can, lv_color_hex(0x2a3040), LV_STATE_PRESSED);
    lv_obj_set_style_radius(btn_can, 8, 0);
    lv_obj_set_style_shadow_width(btn_can, 0, 0);
    lv_obj_set_style_border_width(btn_can, 0, 0);
    lv_obj_add_event_cb(btn_can, [](lv_event_t *e) {
      lv_obj_t *box_obj = lv_obj_get_parent(lv_event_get_target(e));
      lv_obj_t *pop_obj = lv_obj_get_parent(box_obj);
      lv_obj_del(pop_obj);
    }, LV_EVENT_CLICKED, NULL);
    lv_obj_t *lbl_can = lv_label_create(btn_can);
    lv_label_set_text(lbl_can, T(STR_CANCEL));
    lv_obj_set_style_text_color(lbl_can, lv_color_hex(0x4a6fa0), 0);
    lv_obj_set_style_text_font(lbl_can, &lv_font_montserrat_16, 0);
    lv_obj_center(lbl_can);
  }, LV_EVENT_CLICKED, NULL);

  lv_obj_t *lbl_create = lv_label_create(btn_extra_fields_create);
  lv_label_set_text(lbl_create, T(STR_EXTRA_FIELDS_CREATE_BTN));
  lv_obj_set_style_text_color(lbl_create, lv_color_hex(0x40c080), 0);
  lv_obj_set_style_text_font(lbl_create, &lv_font_montserrat_16, 0);
  lv_obj_center(lbl_create);

  // Bottom row (y=276): Test field (left, 210px) | Skip/Next (right, 210px)
  btn_extra_fields_next = lv_btn_create(scr_extra_fields);
  lv_obj_t *btn_skip_bottom = btn_extra_fields_next;
  lv_obj_set_size(btn_skip_bottom, 210, 40);
  lv_obj_set_pos(btn_skip_bottom, 246, 276);
  lv_obj_set_style_bg_color(btn_skip_bottom, lv_color_hex(0x0a1828), 0);
  lv_obj_set_style_bg_color(btn_skip_bottom, lv_color_hex(0x1a3060), LV_STATE_PRESSED);
  lv_obj_set_style_radius(btn_skip_bottom, 8, 0);
  lv_obj_set_style_shadow_width(btn_skip_bottom, 0, 0);
  lv_obj_set_style_border_width(btn_skip_bottom, 1, 0);
  lv_obj_set_style_border_color(btn_skip_bottom, lv_color_hex(0x1a2840), 0);
  lv_obj_add_event_cb(btn_skip_bottom, [](lv_event_t *e) {
    if (extra_fields_setup_flow) {
      // Defer to loop — never call showCalReminderScreen directly from LVGL callback
      cal_reminder_pending = true;
    } else {
      if (!scr_connection) buildConnectionScreen();
      if (!scr_connection) buildConnectionScreen(); hideAllOverlays(); lv_obj_clear_flag(scr_connection, LV_OBJ_FLAG_HIDDEN);
    }
  }, LV_EVENT_CLICKED, NULL);
  lv_obj_t *lbl_skip_b = lv_label_create(btn_skip_bottom);
  char skip_buf[32];
  snprintf(skip_buf, sizeof(skip_buf), "%s  " LV_SYMBOL_RIGHT, T(STR_EXTRA_FIELDS_SKIP));
  lv_label_set_text(lbl_skip_b, skip_buf);
  lv_obj_set_style_text_color(lbl_skip_b, lv_color_hex(0x4a6fa0), 0);
  lv_obj_set_style_text_font(lbl_skip_b, &lv_font_montserrat_14, 0);
  lv_obj_center(lbl_skip_b);

  // Generate test field button (left, fixed y)
  lv_obj_t *btn_test = lv_btn_create(scr_extra_fields);
  lv_obj_set_size(btn_test, 210, 40);
  lv_obj_set_pos(btn_test, 18, 276);
  lv_obj_set_style_bg_color(btn_test, lv_color_hex(0x1a1a0a), 0);
  lv_obj_set_style_bg_color(btn_test, lv_color_hex(0x2a2a1a), LV_STATE_PRESSED);
  lv_obj_set_style_radius(btn_test, 8, 0);
  lv_obj_set_style_shadow_width(btn_test, 0, 0);
  lv_obj_set_style_border_width(btn_test, 1, 0);
  lv_obj_set_style_border_color(btn_test, lv_color_hex(0x2a2a1a), 0);
  lv_obj_add_event_cb(btn_test, [](lv_event_t *e) {
    if (!wifi_ok || cfg_spoolman_base[0] == '\0') {
      if (lbl_extra_fields_status) {
        lv_label_set_text(lbl_extra_fields_status, T(STR_EXTRA_FIELDS_NO_WIFI));
        lv_obj_set_style_text_color(lbl_extra_fields_status, lv_color_hex(0xff8080), 0);
      }
      return;
    }
    // Create spoolscale_test field directly in Spoolman
    HTTPClient http;
    String url = String(cfg_spoolman_base) + "/api/v1/field/spool/spoolscale_test";
    http.begin(url);
    http.addHeader("Content-Type", "application/json");
    http.setTimeout(1500);
    String body = "{\"name\":\"spoolscale_test\",\"field_type\":\"text\",\"default_value\":\"\\\"\\\"\"}";
    int code = http.POST(body);
    http.end();
    Serial.printf("Test field create: %d\n", code);
    if (lbl_extra_fields_status) {
      if (code == 200 || code == 201) {
        lv_label_set_text(lbl_extra_fields_status, T(STR_EF_TEST_CREATED));
        lv_obj_set_style_text_color(lbl_extra_fields_status, lv_color_hex(0xf0b838), 0);
      } else if (code == 409) {
        lv_label_set_text(lbl_extra_fields_status, T(STR_EF_TEST_EXISTS));
        lv_obj_set_style_text_color(lbl_extra_fields_status, lv_color_hex(0xf0b838), 0);
      } else {
        lv_label_set_text(lbl_extra_fields_status, T(STR_EF_TEST_FAIL));
        lv_obj_set_style_text_color(lbl_extra_fields_status, lv_color_hex(0xff8080), 0);
      }
    }
  }, LV_EVENT_CLICKED, NULL);
  lv_obj_t *lbl_test = lv_label_create(btn_test);
  lv_label_set_text(lbl_test, T(STR_EF_TEST_BTN));
  lv_obj_set_style_text_color(lbl_test, lv_color_hex(0xf0b838), 0);
  lv_obj_set_style_text_font(lbl_test, &lv_font_montserrat_14, 0);
  lv_obj_center(lbl_test);
}

// Check existing fields, optionally create missing ones
void checkAndCreateExtraFields(bool create_missing) {
  if (!lbl_extra_fields_status) return;

  if (!wifi_ok) {
    lv_label_set_text(lbl_extra_fields_status, T(STR_EXTRA_FIELDS_NO_WIFI));
    lv_obj_set_style_text_color(lbl_extra_fields_status, lv_color_hex(0xff8080), 0);
    return;
  }
  if (cfg_spoolman_base[0] == '\0' || strcmp(cfg_spoolman_base, "http://") == 0) {
    lv_label_set_text(lbl_extra_fields_status, T(STR_EXTRA_FIELDS_NO_SPOOLMAN));
    lv_obj_set_style_text_color(lbl_extra_fields_status, lv_color_hex(0xff8080), 0);
    return;
  }

  lv_label_set_text(lbl_extra_fields_status, T(STR_EXTRA_FIELDS_CHECKING));
  lv_obj_set_style_text_color(lbl_extra_fields_status, lv_color_hex(0x4a6fa0), 0);
  if (btn_extra_fields_create) lv_obj_add_flag(btn_extra_fields_create, LV_OBJ_FLAG_HIDDEN);
  lv_timer_handler();
  yield();

  // GET /api/v1/field/spool — list all existing extra fields
  HTTPClient http;
  String url = String(cfg_spoolman_base) + "/api/v1/field/spool";
  http.begin(url);
  http.setTimeout(4000);
  int code = http.GET();
  yield();
  lv_timer_handler();
  String payload = "";
  if (code == 200) payload = http.getString();
  http.end();
  yield();
  lv_timer_handler();

  Serial.printf("Extra fields GET: %d\n", code);

  // Spoolman not reachable
  if (code < 0 || (code != 200 && code != 0)) {
    char buf[96];
    strncpy(buf, T(STR_SPOOLMAN_FAIL), sizeof(buf)-1); buf[sizeof(buf)-1]=0;
    lv_label_set_text(lbl_extra_fields_status, buf);
    lv_obj_set_style_text_color(lbl_extra_fields_status, lv_color_hex(0xff8080), 0);
    return;
  }

  // Parse existing field names
  int ef_count = REQUIRED_EXTRA_FIELDS_BASE_COUNT;
  bool field_exists[8] = {false};
  if (code == 200 && payload.length() > 0) {
    DynamicJsonDocument doc(8192);
    if (!deserializeJson(doc, payload)) {
      JsonArray arr = doc.as<JsonArray>();
      for (JsonObject f : arr) {
        const char* fname = f["key"] | "";
        for (int i = 0; i < ef_count; i++) {
          if (strcmp(fname, REQUIRED_EXTRA_FIELDS_BASE[i]) == 0) {
            field_exists[i] = true;
          }
        }
      }
    }
  }

  // Build missing list
  char missing_buf[64] = "";
  int missing_count = 0;
  for (int i = 0; i < ef_count; i++) {
    if (!field_exists[i]) {
      if (missing_count > 0) strncat(missing_buf, ", ", sizeof(missing_buf)-1);
      strncat(missing_buf, REQUIRED_EXTRA_FIELDS_BASE[i], sizeof(missing_buf)-1);
      missing_count++;
    }
  }

  if (missing_count == 0) {
    // All OK
    lv_label_set_text(lbl_extra_fields_status, T(STR_EXTRA_FIELDS_ALL_OK));
    lv_obj_set_style_text_color(lbl_extra_fields_status, lv_color_hex(0x40c080), 0);
    if (btn_extra_fields_create) lv_obj_add_flag(btn_extra_fields_create, LV_OBJ_FLAG_HIDDEN);
    // Turn skip/next button green with "Next →" label
    if (btn_extra_fields_next) {
      lv_obj_set_style_bg_color(btn_extra_fields_next, lv_color_hex(0x1a3020), 0);
      lv_obj_set_style_bg_color(btn_extra_fields_next, lv_color_hex(0x2a5030), LV_STATE_PRESSED);
      lv_obj_set_style_border_color(btn_extra_fields_next, lv_color_hex(0x2a5030), 0);
      lv_obj_t *lbl = lv_obj_get_child(btn_extra_fields_next, 0);
      if (lbl) {
        char next_lbl[32];
        snprintf(next_lbl, sizeof(next_lbl), "%s  " LV_SYMBOL_RIGHT, T(STR_CONFIRM));
        lv_label_set_text(lbl, next_lbl);
        lv_obj_set_style_text_color(lbl, lv_color_hex(0x40c080), 0);
      }
    }
    Serial.println("Extra fields: all present");
    return;
  }

  if (!create_missing) {
    char status_buf[128];
    snprintf(status_buf, sizeof(status_buf), T(STR_EXTRA_FIELDS_MISSING), missing_buf);
    lv_label_set_text(lbl_extra_fields_status, status_buf);
    lv_obj_set_style_text_color(lbl_extra_fields_status, lv_color_hex(0xf0b838), 0);
    if (btn_extra_fields_create) lv_obj_clear_flag(btn_extra_fields_create, LV_OBJ_FLAG_HIDDEN);
    return;
  }

  // Create missing fields
  lv_label_set_text(lbl_extra_fields_status, T(STR_EXTRA_FIELDS_CREATING));
  lv_obj_set_style_text_color(lbl_extra_fields_status, lv_color_hex(0x4a6fa0), 0);
  lv_timer_handler();
  yield();

  char fail_fields[64] = "";
  int fail_count = 0;
  for (int i = 0; i < ef_count; i++) {
    if (field_exists[i]) continue;
    lv_timer_handler();  // keep LVGL alive between HTTP calls
    yield();             // feed watchdog
    HTTPClient http2;
    String create_url = String(cfg_spoolman_base) + "/api/v1/field/spool/" + REQUIRED_EXTRA_FIELDS_BASE[i];
    http2.begin(create_url);
    http2.addHeader("Content-Type", "application/json");
    http2.setTimeout(3000);
    String body = "{\"name\":\"" + String(REQUIRED_EXTRA_FIELDS_BASE[i]) + "\",\"field_type\":\"text\",\"default_value\":\"\\\"\\\"\" }";
    int c2 = http2.POST(body);
    http2.end();
    lv_timer_handler();  // update display after each POST
    yield();
    Serial.printf("Create field '%s': %d\n", REQUIRED_EXTRA_FIELDS_BASE[i], c2);
    if (c2 != 200 && c2 != 201) {
      if (fail_count > 0) strncat(fail_fields, ", ", sizeof(fail_fields)-1);
      strncat(fail_fields, REQUIRED_EXTRA_FIELDS_BASE[i], sizeof(fail_fields)-1);
      fail_count++;
    }
  }

  if (fail_count > 0) {
    char fail_buf[128];
    snprintf(fail_buf, sizeof(fail_buf), T(STR_EXTRA_FIELDS_CREATE_FAIL), fail_fields);
    lv_label_set_text(lbl_extra_fields_status, fail_buf);
    lv_obj_set_style_text_color(lbl_extra_fields_status, lv_color_hex(0xff8080), 0);
  } else {
    if (btn_extra_fields_create) lv_obj_add_flag(btn_extra_fields_create, LV_OBJ_FLAG_HIDDEN);
    yield();
    lv_timer_handler();
    checkAndCreateExtraFields(false);  // verify fields were created
  }
}

// ============================================================
//  CALIBRATION REMINDER SCREEN (end of first setup)
// ============================================================
void showCalReminderScreen() {
  logSD("UI: Screen -> CalReminder: start");
  Serial.println("showCalReminderScreen: start");
  // Free all setup screens to release LVGL heap before building
  if (scr_welcome)       { lv_obj_del(scr_welcome);       scr_welcome       = nullptr; }
  if (scr_first_boot)    { lv_obj_del(scr_first_boot);    scr_first_boot    = nullptr; }
  if (scr_wifi_setup)    { lv_obj_del(scr_wifi_setup);    scr_wifi_setup    = nullptr; }
  if (scr_wifi_pass)     { lv_obj_del(scr_wifi_pass);     scr_wifi_pass     = nullptr; }
  if (scr_spoolman)      { lv_obj_del(scr_spoolman);      scr_spoolman      = nullptr; }
  if (scr_extra_fields)  { lv_obj_del(scr_extra_fields);  scr_extra_fields  = nullptr;
                           lbl_extra_fields_status = nullptr;
                           btn_extra_fields_create = nullptr;
                           btn_extra_fields_next   = nullptr; }
  hideAllOverlays();
  logSD("UI: Screen -> CalReminder: hideAllOverlays done");
  Serial.println("showCalReminderScreen: hideAllOverlays done");
  if (scr_cal_reminder) { lv_obj_del(scr_cal_reminder); scr_cal_reminder = nullptr; }
  logSD("UI: Screen -> CalReminder: building");
  Serial.println("showCalReminderScreen: building");
  buildCalReminderScreen();
  logSD("UI: Screen -> CalReminder: build done");
  Serial.println("showCalReminderScreen: build done");
  lv_obj_clear_flag(scr_cal_reminder, LV_OBJ_FLAG_HIDDEN);
  logSD("UI: Screen -> CalReminder: visible");
  Serial.println("showCalReminderScreen: visible OK");
}

void buildCalReminderScreen() {
  Serial.println("buildCalReminderScreen: start");
  scr_cal_reminder = lv_obj_create(lv_scr_act());
  Serial.println("buildCalReminderScreen: obj created");
  lv_obj_set_size(scr_cal_reminder, 480, 320);
  lv_obj_set_pos(scr_cal_reminder, 0, 0);
  lv_obj_add_flag(scr_cal_reminder, LV_OBJ_FLAG_HIDDEN);
  lv_obj_set_style_radius(scr_cal_reminder, 0, 0);
  lv_obj_set_style_border_width(scr_cal_reminder, 0, 0);
  lv_obj_set_style_pad_all(scr_cal_reminder, 0, 0);
  lv_obj_clear_flag(scr_cal_reminder, LV_OBJ_FLAG_SCROLLABLE);
  lv_obj_set_style_bg_color(scr_cal_reminder, lv_color_hex(0x0a1020), 0);

  // Static buffers — must outlive the function since LVGL holds pointers to them
  static char buf_title[48], buf_msg[256], buf_later[32], buf_now[48];
  strncpy(buf_title, T(STR_CAL_REMINDER_TITLE), sizeof(buf_title)-1); buf_title[sizeof(buf_title)-1]=0;
  strncpy(buf_msg,   T(STR_CAL_REMINDER_MSG),   sizeof(buf_msg)-1);   buf_msg[sizeof(buf_msg)-1]=0;
  strncpy(buf_later, T(STR_CAL_REMINDER_LATER), sizeof(buf_later)-1); buf_later[sizeof(buf_later)-1]=0;
  strncpy(buf_now,   T(STR_CAL_REMINDER_NOW),   sizeof(buf_now)-1);   buf_now[sizeof(buf_now)-1]=0;
  Serial.println("buildCalReminderScreen: strings copied");

  // Title
  lv_obj_t *lbl_title = lv_label_create(scr_cal_reminder);
  lv_label_set_text(lbl_title, buf_title);
  lv_obj_set_style_text_color(lbl_title, lv_color_hex(0x28d49a), 0);
  lv_obj_set_style_text_font(lbl_title, &lv_font_montserrat_18, 0);
  lv_obj_align(lbl_title, LV_ALIGN_TOP_MID, 0, 20);

  // No back button in setup flow — CalReminder is the last setup step
  addCloseButton(scr_cal_reminder);

  // Icon
  lv_obj_t *lbl_icon = lv_label_create(scr_cal_reminder);
  lv_label_set_text(lbl_icon, LV_SYMBOL_EDIT);
  lv_obj_set_style_text_color(lbl_icon, lv_color_hex(0xf0b838), 0);
  lv_obj_set_style_text_font(lbl_icon, &lv_font_montserrat_24, 0);
  lv_obj_align(lbl_icon, LV_ALIGN_TOP_MID, 0, 52);

  // Message
  lv_obj_t *lbl_msg = lv_label_create(scr_cal_reminder);
  lv_label_set_text(lbl_msg, buf_msg);
  lv_obj_set_style_text_color(lbl_msg, lv_color_hex(0xc8d8f0), 0);
  lv_obj_set_style_text_font(lbl_msg, &lv_font_montserrat_14, 0);
  lv_obj_set_style_text_align(lbl_msg, LV_TEXT_ALIGN_CENTER, 0);
  lv_label_set_long_mode(lbl_msg, LV_LABEL_LONG_WRAP);
  lv_obj_set_width(lbl_msg, 440);
  lv_obj_align(lbl_msg, LV_ALIGN_TOP_MID, 0, 88);

  // Single "Got it" button — centers, leads to main screen
  lv_obj_t *btn_got = lv_btn_create(scr_cal_reminder);
  lv_obj_set_size(btn_got, 280, 48);
  lv_obj_align(btn_got, LV_ALIGN_BOTTOM_MID, 0, -20);
  lv_obj_set_style_bg_color(btn_got, lv_color_hex(0x1a3020), 0);
  lv_obj_set_style_bg_color(btn_got, lv_color_hex(0x2a5030), LV_STATE_PRESSED);
  lv_obj_set_style_radius(btn_got, 8, 0);
  lv_obj_set_style_shadow_width(btn_got, 0, 0);
  lv_obj_set_style_border_width(btn_got, 1, 0);
  lv_obj_set_style_border_color(btn_got, lv_color_hex(0x2a5030), 0);
  lv_obj_add_event_cb(btn_got, [](lv_event_t *e) {
    showMainScreen();
  }, LV_EVENT_CLICKED, NULL);
  lv_obj_t *lbl_got = lv_label_create(btn_got);
  lv_label_set_text(lbl_got, buf_later);
  lv_obj_set_style_text_color(lbl_got, lv_color_hex(0x40c080), 0);
  lv_obj_set_style_text_font(lbl_got, &lv_font_montserrat_16, 0);
  lv_obj_center(lbl_got);
}

// ============================================================
//  WIFI SETUP: STEP 1 — Network scan + selection
// ============================================================
void showWifiSetupScreen() {
  logSD("UI: Screen -> WifiSetup");
  hideAllOverlays();
  if (scr_wifi_setup) { lv_obj_del(scr_wifi_setup); scr_wifi_setup = nullptr; }
  // Null global pointers — otherwise they point to deleted objects
  lbl_wifi_scan_list    = nullptr;
  lbl_wifi_setup_status = nullptr;
  buildWifiSetupScreen();
  lv_obj_clear_flag(scr_wifi_setup, LV_OBJ_FLAG_HIDDEN);
}

void buildWifiSetupScreen() {
  scr_wifi_setup = lv_obj_create(lv_scr_act());
  lv_obj_set_size(scr_wifi_setup, 480, 320);
  lv_obj_set_pos(scr_wifi_setup, 0, 0);
  lv_obj_add_flag(scr_wifi_setup, LV_OBJ_FLAG_HIDDEN);
  lv_obj_set_style_radius(scr_wifi_setup, 0, 0);
  lv_obj_set_style_border_width(scr_wifi_setup, 0, 0);
  lv_obj_set_style_pad_all(scr_wifi_setup, 0, 0);
  lv_obj_clear_flag(scr_wifi_setup, LV_OBJ_FLAG_SCROLLABLE);
  lv_obj_set_style_bg_color(scr_wifi_setup, lv_color_hex(0x0a1020), 0);

  // Header
  lv_obj_t *title = lv_label_create(scr_wifi_setup);
  lv_label_set_text(title, T(STR_WIFI_TITLE));
  lv_obj_set_style_text_color(title, lv_color_hex(0x28d49a), 0);
  lv_obj_set_style_text_font(title, &lv_font_montserrat_18, 0);
  lv_obj_align(title, LV_ALIGN_TOP_MID, 0, 14);

  // Back button (←)
  addBackButton(scr_wifi_setup, [](lv_event_t *e) {
    if (strlen(cfg_wifi_ssid) == 0) {
      showWelcomeScreen();
    } else {
      hideAllOverlays();
      buildConnectionScreen();
      lv_obj_clear_flag(scr_connection, LV_OBJ_FLAG_HIDDEN);
    }
  });

  // X button (✕)
  addCloseButton(scr_wifi_setup);

  // Refresh button (next to title, center-right)
  lv_obj_t *btn_scan = lv_btn_create(scr_wifi_setup);
  lv_obj_set_size(btn_scan, 44, 36);
  lv_obj_align(btn_scan, LV_ALIGN_TOP_MID, 100, 4);
  lv_obj_set_style_bg_color(btn_scan, lv_color_hex(0x0a1828), 0);
  lv_obj_set_style_bg_color(btn_scan, lv_color_hex(0x1a3060), LV_STATE_PRESSED);
  lv_obj_set_style_radius(btn_scan, 6, 0);
  lv_obj_set_style_shadow_width(btn_scan, 0, 0);
  lv_obj_set_style_border_width(btn_scan, 0, 0);
  lv_obj_t *lbl_scan_btn = lv_label_create(btn_scan);
  lv_label_set_text(lbl_scan_btn, LV_SYMBOL_REFRESH);
  lv_obj_set_style_text_color(lbl_scan_btn, lv_color_hex(0x28d49a), 0);
  lv_obj_set_style_text_font(lbl_scan_btn, &lv_font_montserrat_18, 0);
  lv_obj_center(lbl_scan_btn);

  // Scrollable network list (y=50 → y=56 due to header)
  lv_obj_t *list = lv_obj_create(scr_wifi_setup);
  lv_obj_set_size(list, 460, 218);
  lv_obj_set_pos(list, 10, 56);
  lv_obj_set_style_bg_color(list, lv_color_hex(0x0a1020), 0);
  lv_obj_set_style_border_width(list, 0, 0);
  lv_obj_set_style_pad_all(list, 2, 0);
  lv_obj_set_style_radius(list, 0, 0);
  lv_obj_set_flex_flow(list, LV_FLEX_FLOW_COLUMN);
  lv_obj_set_scroll_dir(list, LV_DIR_VER);
  lv_obj_clear_flag(list, LV_OBJ_FLAG_SCROLLABLE);
  lv_obj_add_flag(list, LV_OBJ_FLAG_SCROLLABLE);
  lbl_wifi_scan_list = list;

  // Status label (initially "scanning...")
  lbl_wifi_setup_status = lv_label_create(scr_wifi_setup);
  lv_label_set_text(lbl_wifi_setup_status, T(STR_WIFI_SCAN));
  lv_obj_set_style_text_color(lbl_wifi_setup_status, lv_color_hex(0x4a6fa0), 0);
  lv_obj_set_style_text_font(lbl_wifi_setup_status, &lv_font_montserrat_14, 0);
  lv_obj_align(lbl_wifi_setup_status, LV_ALIGN_BOTTOM_MID, 0, -8);

  // Scan button callback (after building list)
  lv_obj_add_event_cb(btn_scan, [](lv_event_t *e) {
    lv_label_set_text(lbl_wifi_setup_status, T(STR_WIFI_SCAN));
    doWifiScan();
  }, LV_EVENT_CLICKED, NULL);

  // Immediate scan on open
  doWifiScan();
}

// Perform scan and populate list
void doWifiScan() {
  // Liste leeren
  lv_obj_clean(lbl_wifi_scan_list);
  lv_timer_handler();

  // Disconnect required after failed WiFi.begin() —
  // otherwise scanNetworks() returns 0
  WiFi.disconnect(true);
  delay(100);
  WiFi.mode(WIFI_STA);
  delay(100);
  int n = WiFi.scanNetworks();

  if (n == 0) {
    lv_label_set_text(lbl_wifi_setup_status, T(STR_WIFI_NO_NET));
    return;
  }

  char status_buf[48];
  snprintf(status_buf, sizeof(status_buf), T(STR_WIFI_NETWORKS_FOUND), n);
  lv_label_set_text(lbl_wifi_setup_status, status_buf);

  // Sort: strongest first (bubble sort, n is small)
  for (int i = 0; i < n - 1; i++) {
    for (int j = 0; j < n - i - 1; j++) {
      if (WiFi.RSSI(j) < WiFi.RSSI(j + 1)) {
        // Swap via scan index — LVGL-independent, WiFi.SSID() returns directly
        // Arduino WiFi.scanNetworks() returns sorted after scan, only needed if not:
        // Wir nutzen einen Index-Array-Trick nicht — direkt ausgeben reicht da n<20
      }
    }
  }

  for (int i = 0; i < n && i < 20; i++) {
    int rssi = WiFi.RSSI(i);
    String ssid = WiFi.SSID(i);
    if (ssid.length() == 0) continue;

    // Signal bar (3 levels)
    const char* signal_icon;
    if      (rssi >= -65) signal_icon = LV_SYMBOL_WIFI "   ";
    else if (rssi >= -80) signal_icon = LV_SYMBOL_WIFI "   ";
    else                  signal_icon = LV_SYMBOL_WIFI "   ";

    // Signal color
    uint32_t sig_color;
    if      (rssi >= -65) sig_color = 0x28d49a;  // green
    else if (rssi >= -80) sig_color = 0xf0b838;  // yellow
    else                  sig_color = 0xff8000;   // orange

    // Row button
    lv_obj_t *row = lv_btn_create(lbl_wifi_scan_list);
    lv_obj_set_size(row, 452, 46);
    lv_obj_set_style_bg_color(row, lv_color_hex(0x0a1828), 0);
    lv_obj_set_style_bg_color(row, lv_color_hex(0x1a3060), LV_STATE_PRESSED);
    lv_obj_set_style_radius(row, 6, 0);
    lv_obj_set_style_shadow_width(row, 0, 0);
    lv_obj_set_style_border_color(row, lv_color_hex(0x1a2840), 0);
    lv_obj_set_style_border_width(row, 1, 0);
    lv_obj_set_style_pad_all(row, 0, 0);

    // SSID Label
    lv_obj_t *lbl_ssid = lv_label_create(row);
    lv_label_set_text(lbl_ssid, ssid.c_str());
    lv_obj_set_style_text_color(lbl_ssid, lv_color_hex(0xe8f0ff), 0);
    lv_obj_set_style_text_font(lbl_ssid, &lv_font_montserrat_16, 0);
    lv_obj_align(lbl_ssid, LV_ALIGN_LEFT_MID, 12, 0);
    lv_label_set_long_mode(lbl_ssid, LV_LABEL_LONG_DOT);
    lv_obj_set_width(lbl_ssid, 300);

    // RSSI Label
    char rssi_buf[16];
    snprintf(rssi_buf, sizeof(rssi_buf), "%d dBm", rssi);
    lv_obj_t *lbl_rssi = lv_label_create(row);
    lv_label_set_text(lbl_rssi, rssi_buf);
    lv_obj_set_style_text_color(lbl_rssi, lv_color_hex(sig_color), 0);
    lv_obj_set_style_text_font(lbl_rssi, &lv_font_montserrat_12, 0);
    lv_obj_align(lbl_rssi, LV_ALIGN_RIGHT_MID, -8, 0);

    // Click: store SSID → password screen
    lv_obj_add_event_cb(row, [](lv_event_t *e) {
      lv_obj_t *btn = (lv_obj_t*)lv_event_get_target(e);
      lv_obj_t *lbl = lv_obj_get_child(btn, 0);
      const char* ssid_str = lv_label_get_text(lbl);
      strncpy(wifi_setup_ssid, ssid_str, sizeof(wifi_setup_ssid)-1);
      showWifiPassScreen();
    }, LV_EVENT_CLICKED, NULL);
  }

  WiFi.scanDelete();
}

// ============================================================
//  WIFI SETUP: STEP 2 — Password entry
// ============================================================
void showWifiPassScreen() {
  logSD("UI: Screen -> WifiPass");
  hideAllOverlays();
  if (scr_wifi_pass) { lv_obj_del(scr_wifi_pass); scr_wifi_pass = nullptr; }
  ta_wifi_pass = nullptr;
  kb_wifi_pass = nullptr;
  buildWifiPassScreen();
  lv_obj_clear_flag(scr_wifi_pass, LV_OBJ_FLAG_HIDDEN);
}

void buildWifiPassScreen() {
  scr_wifi_pass = lv_obj_create(lv_scr_act());
  lv_obj_set_size(scr_wifi_pass, 480, 320);
  lv_obj_set_pos(scr_wifi_pass, 0, 0);
  lv_obj_add_flag(scr_wifi_pass, LV_OBJ_FLAG_HIDDEN);
  lv_obj_set_style_radius(scr_wifi_pass, 0, 0);
  lv_obj_set_style_border_width(scr_wifi_pass, 0, 0);
  lv_obj_set_style_pad_all(scr_wifi_pass, 0, 0);
  lv_obj_clear_flag(scr_wifi_pass, LV_OBJ_FLAG_SCROLLABLE);
  lv_obj_set_style_bg_color(scr_wifi_pass, lv_color_hex(0x0a1020), 0);

  // Back button
  addBackButton(scr_wifi_pass, [](lv_event_t *e) { showWifiSetupScreen(); });
  addCloseButton(scr_wifi_pass);

  // Title
  lv_obj_t *title = lv_label_create(scr_wifi_pass);
  lv_label_set_text(title, T(STR_WIFI_PASS_TITLE));
  lv_obj_set_style_text_color(title, lv_color_hex(0x28d49a), 0);
  lv_obj_set_style_text_font(title, &lv_font_montserrat_18, 0);
  lv_obj_align(title, LV_ALIGN_TOP_MID, 0, 14);

  // Show selected SSID
  char ssid_hint[64];
  snprintf(ssid_hint, sizeof(ssid_hint), T(STR_WIFI_PASS_HINT), wifi_setup_ssid);
  lv_obj_t *lbl_ssid_show = lv_label_create(scr_wifi_pass);
  lv_label_set_text(lbl_ssid_show, ssid_hint);
  lv_obj_set_style_text_color(lbl_ssid_show, lv_color_hex(0xc8d8f0), 0);
  lv_obj_set_style_text_font(lbl_ssid_show, &lv_font_montserrat_14, 0);
  lv_obj_align(lbl_ssid_show, LV_ALIGN_TOP_MID, 0, 52);

  // Password textarea
  ta_wifi_pass = lv_textarea_create(scr_wifi_pass);
  lv_textarea_set_one_line(ta_wifi_pass, true);
  lv_textarea_set_password_mode(ta_wifi_pass, false);
  lv_textarea_set_placeholder_text(ta_wifi_pass, "Passwort...");
  lv_obj_set_size(ta_wifi_pass, 380, 44);
  lv_obj_align(ta_wifi_pass, LV_ALIGN_TOP_MID, 0, 74);
  lv_obj_set_style_text_font(ta_wifi_pass, &lv_font_montserrat_16, 0);
  lv_obj_set_style_text_color(ta_wifi_pass, lv_color_hex(0xffffff), 0);
  lv_obj_set_style_bg_color(ta_wifi_pass, lv_color_hex(0x1e2e4a), 0);
  lv_obj_set_style_border_color(ta_wifi_pass, lv_color_hex(0x2a4080), 0);

  // Keyboard
  kb_wifi_pass = lv_keyboard_create(scr_wifi_pass);
  lv_keyboard_set_textarea(kb_wifi_pass, ta_wifi_pass);
  lv_obj_set_size(kb_wifi_pass, 480, 160);
  lv_obj_align(kb_wifi_pass, LV_ALIGN_BOTTOM_MID, 0, 0);
  lv_obj_set_style_bg_color(kb_wifi_pass, lv_color_hex(0x182238), 0);
  lv_obj_set_style_border_width(kb_wifi_pass, 0, 0);

  // Enter on keyboard → connect
  lv_obj_add_event_cb(kb_wifi_pass, [](lv_event_t *e) {
    if (lv_event_get_code(e) == LV_EVENT_READY) {
      const char* pass = lv_textarea_get_text(ta_wifi_pass);
      saveWifiCredentials(wifi_setup_ssid, pass);
      showWifiConnectingScreen();
    }
  }, LV_EVENT_ALL, NULL);
}

// ============================================================
//  WIFI SETUP: STEP 3 — Connect + result
// ============================================================
void showWifiConnectingScreen() {
  logSD("UI: Screen -> WifiConnecting");
  hideAllOverlays();
  if (scr_wifi_connecting) { lv_obj_del(scr_wifi_connecting); scr_wifi_connecting = nullptr; }
  buildWifiConnectingScreen();
  lv_obj_clear_flag(scr_wifi_connecting, LV_OBJ_FLAG_HIDDEN);
  lv_timer_handler();

  // Actually connect now
  wifi_ok = false;
  WiFi.disconnect(true);
  delay(200);
  WiFi.mode(WIFI_STA);
  WiFi.begin(cfg_wifi_ssid, cfg_wifi_password);

  lv_obj_t *status_lbl = (lv_obj_t*)lv_obj_get_user_data(scr_wifi_connecting);

  for (int i = 0; i < 20; i++) {
    delay(500);
    lv_timer_handler();
    if (WiFi.status() == WL_CONNECTED) {
      wifi_ok = true;
      break;
    }
  }

  if (wifi_ok) {
    syncNTP();
    updateHeaderStatus();
    lv_label_set_text(lbl_spoolman_weight, T(STR_WAIT_SCAN_SM));
    char ok_buf[80];
    snprintf(ok_buf, sizeof(ok_buf), T(STR_WIFI_CONNECTED_IP), WiFi.localIP().toString().c_str());
    if (status_lbl) lv_label_set_text(status_lbl, ok_buf);
    lv_obj_set_style_text_color(status_lbl, lv_color_hex(0x28d49a), 0);

    // Show next button
    lv_obj_t *btn_next = (lv_obj_t*)lv_obj_get_child(scr_wifi_connecting, -1);
    if (btn_next) lv_obj_clear_flag(btn_next, LV_OBJ_FLAG_HIDDEN);
  } else {
    updateHeaderStatus();
    char fail_buf[80];
    snprintf(fail_buf, sizeof(fail_buf), T(STR_WIFI_CONN_FAILED), cfg_wifi_ssid);
    if (status_lbl) lv_label_set_text(status_lbl, fail_buf);
    lv_obj_set_style_text_color(status_lbl, lv_color_hex(0xff8080), 0);

    // Show retry button
    lv_obj_t *btn_retry = (lv_obj_t*)lv_obj_get_child(scr_wifi_connecting, -2);
    if (btn_retry) lv_obj_clear_flag(btn_retry, LV_OBJ_FLAG_HIDDEN);
    lv_obj_t *btn_next = (lv_obj_t*)lv_obj_get_child(scr_wifi_connecting, -1);
    if (btn_next) lv_obj_clear_flag(btn_next, LV_OBJ_FLAG_HIDDEN);
  }
  lv_timer_handler();
}

void buildWifiConnectingScreen() {
  scr_wifi_connecting = lv_obj_create(lv_scr_act());
  lv_obj_set_size(scr_wifi_connecting, 480, 320);
  lv_obj_set_pos(scr_wifi_connecting, 0, 0);
  lv_obj_add_flag(scr_wifi_connecting, LV_OBJ_FLAG_HIDDEN);
  lv_obj_set_style_radius(scr_wifi_connecting, 0, 0);
  lv_obj_set_style_border_width(scr_wifi_connecting, 0, 0);
  lv_obj_set_style_pad_all(scr_wifi_connecting, 0, 0);
  lv_obj_clear_flag(scr_wifi_connecting, LV_OBJ_FLAG_SCROLLABLE);
  lv_obj_set_style_bg_color(scr_wifi_connecting, lv_color_hex(0x0a1020), 0);

  lv_obj_t *title = lv_label_create(scr_wifi_connecting);
  lv_label_set_text(title, T(STR_WIFI_TITLE));
  lv_obj_set_style_text_color(title, lv_color_hex(0x28d49a), 0);
  lv_obj_set_style_text_font(title, &lv_font_montserrat_18, 0);
  lv_obj_align(title, LV_ALIGN_TOP_MID, 0, 24);

  addBackButton(scr_wifi_connecting, [](lv_event_t *e) { showWifiSetupScreen(); });
  addCloseButton(scr_wifi_connecting);

  char conn_buf[64];
  snprintf(conn_buf, sizeof(conn_buf), T(STR_WIFI_CONNECTING), wifi_setup_ssid);
  lv_obj_t *lbl_connecting = lv_label_create(scr_wifi_connecting);
  lv_label_set_text(lbl_connecting, conn_buf);
  lv_obj_set_style_text_color(lbl_connecting, lv_color_hex(0x4a6fa0), 0);
  lv_obj_set_style_text_font(lbl_connecting, &lv_font_montserrat_16, 0);
  lv_obj_align(lbl_connecting, LV_ALIGN_TOP_MID, 0, 68);

  // Status label — larger font, filled after connection
  lv_obj_t *lbl_status_conn = lv_label_create(scr_wifi_connecting);
  lv_label_set_text(lbl_status_conn, "");
  lv_obj_set_style_text_color(lbl_status_conn, lv_color_hex(0xc8d8f0), 0);
  lv_obj_set_style_text_font(lbl_status_conn, &lv_font_montserrat_20, 0);
  lv_obj_set_style_text_align(lbl_status_conn, LV_TEXT_ALIGN_CENTER, 0);
  lv_obj_align(lbl_status_conn, LV_ALIGN_CENTER, 0, 10);
  lv_label_set_long_mode(lbl_status_conn, LV_LABEL_LONG_WRAP);
  lv_obj_set_width(lbl_status_conn, 420);
  lv_obj_set_user_data(scr_wifi_connecting, lbl_status_conn);

  // Retry button (initially hidden)
  lv_obj_t *btn_retry = lv_btn_create(scr_wifi_connecting);
  lv_obj_set_size(btn_retry, 200, 48);
  lv_obj_align(btn_retry, LV_ALIGN_BOTTOM_MID, -110, -20);
  lv_obj_add_flag(btn_retry, LV_OBJ_FLAG_HIDDEN);
  lv_obj_set_style_bg_color(btn_retry, lv_color_hex(0x3a1010), 0);
  lv_obj_set_style_bg_color(btn_retry, lv_color_hex(0x602020), LV_STATE_PRESSED);
  lv_obj_set_style_radius(btn_retry, 8, 0);
  lv_obj_set_style_shadow_width(btn_retry, 0, 0);
  lv_obj_set_style_border_width(btn_retry, 0, 0);
  lv_obj_add_event_cb(btn_retry, [](lv_event_t *e) { showWifiSetupScreen(); }, LV_EVENT_CLICKED, NULL);
  lv_obj_t *lbl_retry = lv_label_create(btn_retry);
  lv_label_set_text(lbl_retry, LV_SYMBOL_LEFT "  "); { char rb[32]; snprintf(rb,sizeof(rb),"%s",T(STR_RETRY)); lv_label_set_text(lbl_retry,rb); }
  lv_obj_set_style_text_color(lbl_retry, lv_color_hex(0xff8080), 0);
  lv_obj_set_style_text_font(lbl_retry, &lv_font_montserrat_16, 0);
  lv_obj_center(lbl_retry);

  // Next button → Spoolman IP (initially hidden)
  lv_obj_t *btn_next = lv_btn_create(scr_wifi_connecting);
  lv_obj_set_size(btn_next, 200, 48);
  lv_obj_align(btn_next, LV_ALIGN_BOTTOM_MID, 110, -20);
  lv_obj_add_flag(btn_next, LV_OBJ_FLAG_HIDDEN);
  lv_obj_set_style_bg_color(btn_next, lv_color_hex(0x1a3020), 0);
  lv_obj_set_style_bg_color(btn_next, lv_color_hex(0x2a5030), LV_STATE_PRESSED);
  lv_obj_set_style_radius(btn_next, 8, 0);
  lv_obj_set_style_shadow_width(btn_next, 0, 0);
  lv_obj_set_style_border_width(btn_next, 0, 0);
  lv_obj_add_event_cb(btn_next, [](lv_event_t *e) {
    hideAllOverlays();
    if (scr_spoolman) { lv_obj_del(scr_spoolman); scr_spoolman = nullptr; }
    buildSpoolmanScreen();
    lv_obj_clear_flag(scr_spoolman, LV_OBJ_FLAG_HIDDEN);
  }, LV_EVENT_CLICKED, NULL);
  lv_obj_t *lbl_next = lv_label_create(btn_next);
  lv_label_set_text(lbl_next, "Spoolman  " LV_SYMBOL_RIGHT);
  lv_obj_set_style_text_color(lbl_next, lv_color_hex(0x40c080), 0);
  lv_obj_set_style_text_font(lbl_next, &lv_font_montserrat_16, 0);
  lv_obj_center(lbl_next);
}

// ── WiFi info screen ──
void buildWifiScreen() {
  scr_wifi = lv_obj_create(lv_scr_act());
  lv_obj_set_size(scr_wifi, 480, 320);
  lv_obj_set_pos(scr_wifi, 0, 0);
  lv_obj_add_flag(scr_wifi, LV_OBJ_FLAG_HIDDEN);
  lv_obj_set_style_radius(scr_wifi, 0, 0);
  lv_obj_set_style_border_width(scr_wifi, 0, 0);
  lv_obj_set_style_pad_all(scr_wifi, 0, 0);
  lv_obj_clear_flag(scr_wifi, LV_OBJ_FLAG_SCROLLABLE);
  lv_obj_set_style_bg_color(scr_wifi, lv_color_hex(0x0a1020), 0);

  lv_obj_t *title_wifi = lv_label_create(scr_wifi);
  lv_label_set_text(title_wifi, "WiFi Status");
  lv_obj_set_style_text_color(title_wifi, lv_color_hex(0x28d49a), 0);
  lv_obj_set_style_text_font(title_wifi, &lv_font_montserrat_18, 0);
  lv_obj_align(title_wifi, LV_ALIGN_TOP_MID, 0, 14);

  lbl_wifi_info = lv_label_create(scr_wifi);
  lv_label_set_text(lbl_wifi_info, T(STR_WAIT));
  lv_obj_set_style_text_color(lbl_wifi_info, lv_color_hex(0xc8d8f0), 0);
  lv_obj_set_style_text_font(lbl_wifi_info, &lv_font_montserrat_16, 0);
  lv_obj_align(lbl_wifi_info, LV_ALIGN_CENTER, 0, 10);
  lv_label_set_long_mode(lbl_wifi_info, LV_LABEL_LONG_WRAP);
  lv_obj_set_width(lbl_wifi_info, 380);
  lv_obj_set_style_text_align(lbl_wifi_info, LV_TEXT_ALIGN_LEFT, 0);

  addBackButton(scr_wifi, [](lv_event_t *e){ if (!scr_connection) buildConnectionScreen(); if (!scr_connection) buildConnectionScreen(); hideAllOverlays(); lv_obj_clear_flag(scr_connection, LV_OBJ_FLAG_HIDDEN); });
  addCloseButton(scr_wifi);
}

void updateWifiInfo() {
  if (!lbl_wifi_info) return;
  char buf[200];
  int rssi = WiFi.RSSI();
  const char* qual;
  if      (rssi >= -50) qual = T(STR_WIFI_QUAL_EXCELLENT);
  else if (rssi >= -65) qual = T(STR_WIFI_QUAL_GOOD);
  else if (rssi >= -75) qual = T(STR_WIFI_QUAL_MEDIUM);
  else                  qual = T(STR_WIFI_QUAL_WEAK);
  snprintf(buf, sizeof(buf),
    "SSID:    %s\n"
    "Status:  %s\n"
    "IP:      %s\n"
    "RSSI:    %d dBm  (%s)\n"
    "Spoolman:\n%s",
    cfg_wifi_ssid,
    wifi_ok ? T(STR_WIFI_STATUS_CONNECTED) : T(STR_WIFI_STATUS_DISCONNECTED),
    wifi_ok ? WiFi.localIP().toString().c_str() : "-",
    rssi, qual,
    cfg_spoolman_base
  );
  lv_label_set_text(lbl_wifi_info, buf);
}

// ── Spoolman IP screen (custom numpad with . and :) ──
// Input buffer for Spoolman IP
static char sp_ip_input[64] = "";
static lv_obj_t *lbl_sp_ip_display = nullptr;
static lv_obj_t *lbl_sp_test_result = nullptr;  // test result label on IP screen
static lv_obj_t *btn_sp_extra_fields = nullptr;  // Extra Fields button on IP screen
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
void loop() {
  lv_tick_inc(5);
  lv_timer_handler();
  handlePowerManagement();

  // ── Loop heartbeat (every 5s, verbose only) ──────────────
  // Helps diagnose freezes: last heartbeat timestamp = roughly when loop stopped
  static unsigned long last_heartbeat_ms = 0;
  static uint32_t heartbeat_count = 0;
  if (sd_verbose && millis() - last_heartbeat_ms >= 5000) {
    last_heartbeat_ms = millis();
    heartbeat_count++;
    logSDf("[verbose] heartbeat #%u heap=%d PSRAM=%d uptime=%lus",
      heartbeat_count, ESP.getFreeHeap(), ESP.getFreePsram(), millis() / 1000);
  }

  // OTA web server bedienen wenn aktiv
  if (ota_server_running) ota_server.handleClient();

  // Silent background OTA check — once after WiFi connect, with 5s startup delay
  static unsigned long ota_check_trigger_ms = 0;
  if (silent_ota_check_pending && wifi_ok) {
    if (ota_check_trigger_ms == 0) ota_check_trigger_ms = millis();
    if (millis() - ota_check_trigger_ms > 5000) {
      silent_ota_check_pending = false;
      ota_check_trigger_ms = 0;
      doGithubOtaCheckSilent();
    }
  }

  // Extra fields check/create — deferred from LVGL event callback to loop
  if (extra_fields_check_pending) {
    extra_fields_check_pending = false;
    checkAndCreateExtraFields(false);
  }
  if (extra_fields_create_pending) {
    extra_fields_create_pending = false;
    checkAndCreateExtraFields(true);
  }
  if (cal_reminder_pending) {
    cal_reminder_pending = false;
    showCalReminderScreen();
  }
  if (show_bag_pending) {
    show_bag_pending = false;
    if (!scr_bag) buildBagScreen();
    hideAllOverlays();
    lv_obj_clear_flag(scr_bag, LV_OBJ_FLAG_HIDDEN);
  }
  if (show_factor_pending) {
    show_factor_pending = false;
    showFactorScreen();
  }
  if (skip_setup_pending) {
    skip_setup_pending = false;
    if (scr_welcome)    { lv_obj_del(scr_welcome);    scr_welcome    = nullptr; }
    if (scr_first_boot) { lv_obj_del(scr_first_boot); scr_first_boot = nullptr; }
    showMainScreen();
  }
  if (lang_selected_no_reboot) {
    lang_selected_no_reboot = false;
    if (scr_welcome) { lv_obj_del(scr_welcome); scr_welcome = nullptr; }
    showFirstBootScreen();
  }
  // Hide tare confirmation
  if (tare_msg_ms > 0 && millis() - tare_msg_ms > 800) {
    if (lbl_ok_ptr) { lv_obj_del(lbl_ok_ptr); lbl_ok_ptr = nullptr; }
    tare_msg_ms = 0;
  }

  // No-tag timer: clear display if no tag detected for too long
  // Only clear if truly no tag present (tag_present=false)
  if (!tag_present && sm_found &&
      last_tag_seen_ms > 0 && millis() - last_tag_seen_ms > NO_TAG_CLEAR_MS) {
    clearTagDisplay();
    last_tag_seen_ms = 0;
    spoolman_queried_uid[0] = '\0';
  }

  // Fill display with new tag data
  if (g_tag_ready) {
    g_tag_ready = false;
    g_tag_displayed = true;
    g_tag_shown_ms = millis();
    updateDisplay();
    if (strlen(g_tag.tray_uuid) == 32 && strcmp(g_tag.uid_str, spoolman_queried_uid) != 0) {
      querySpoolman(g_tag.tray_uuid);
      strncpy(spoolman_queried_uid, g_tag.uid_str, sizeof(spoolman_queried_uid));
      if (!sm_found && wifi_ok) {
        link_tag_first_seen_ms = millis();
        link_popup_dismissed = false;
      }
    }
  }

  // After 10s reset status line to "searching" (data stays visible!)
  if (g_tag_displayed && millis() - g_tag_shown_ms > 10000) {
    g_tag_displayed = false;
    lv_label_set_text(lbl_nfc_dot, LV_SYMBOL_BULLET);
    lv_obj_set_style_text_color(lbl_nfc_dot, lv_color_hex(0xf0b838), 0);  // yellow
    lv_label_set_text(lbl_status, T(STR_WAIT_SCAN));
    lv_obj_set_style_text_color(lbl_status, lv_color_hex(0xf0b838), 0);
  }

  // NAU7802: read weight every 200ms and update labels
  if (scale_ready && millis() - last_scale_ms >= 200) {
    last_scale_ms = millis();
    int32_t raw = nau.read();
    float raw_g = (float)(raw - zero_offset) / cal_factor;

    // Moving average over SCALE_FILTER_SIZE readings
    scale_filter_buf[scale_filter_idx] = raw_g;
    scale_filter_idx = (scale_filter_idx + 1) % SCALE_FILTER_SIZE;
    if (scale_filter_idx == 0) scale_filter_full = true;
    int count = scale_filter_full ? SCALE_FILTER_SIZE : scale_filter_idx;
    float sum = 0;
    for (int i = 0; i < count; i++) sum += scale_filter_buf[i];
    scale_weight_g = sum / count;

    char w_str[16];
    // Fix 4: show filament netto (without spool) as big scale value
    if (sm_spool_weight > 0) {
      float netto = scale_weight_g - sm_spool_weight;
      if (netto < 0) netto = 0;
      snprintf(w_str, sizeof(w_str), "%.1f g", netto);
    } else {
      snprintf(w_str, sizeof(w_str), "%.1f g", scale_weight_g);
    }
    lv_label_set_text(lbl_scale_weight, w_str);
    // Also update live weight in calibration screen if open
    if (lbl_factor_cal_weight && scr_factor && !lv_obj_has_flag(scr_factor, LV_OBJ_FLAG_HIDDEN)) {
      char cal_str[16];
      snprintf(cal_str, sizeof(cal_str), "%.1f g", scale_weight_g);  // Fix 6: raw weight
      lv_label_set_text(lbl_factor_cal_weight, cal_str);
    }

    // Fix 4: update live/bag below, SM diff next to netto
    if (sm_found && sm_spool_weight > 0) {
      float netto = scale_weight_g - sm_spool_weight;
      if (netto < 0) netto = 0;

      // SM diff: filament netto vs Spoolman remaining
      if (lbl_raw_info && sm_remaining > 0) {
        float sm_diff = netto - sm_remaining;
        char sd_str[16];
        snprintf(sd_str, sizeof(sd_str), sm_diff >= 0 ? "+%.0f g" : "%.0f g", sm_diff);
        lv_label_set_text(lbl_raw_info, sd_str);
        lv_obj_set_style_text_color(lbl_raw_info,
          sm_diff >= 0 ? lv_color_hex(0x40c080) : lv_color_hex(0xe04040), 0);
      }

      // Live total (with spool)
      if (lbl_spoolman_dried) {
        char lt_str[16];
        snprintf(lt_str, sizeof(lt_str), "%.1f g", scale_weight_g);
        lv_label_set_text(lbl_spoolman_dried, lt_str);
        lv_obj_set_style_text_color(lbl_spoolman_dried, lv_color_hex(0x8ab0d8), 0);
      }

      // Fix 4: ohne Beutel = live - spool - bag; fixed color like scale netto; diff green/red
      if (lbl_keys) {
        float ohne_beutel = scale_weight_g - sm_spool_weight - bag_weight_g;
        if (ohne_beutel < 0) ohne_beutel = 0;
        char b_str[16];
        snprintf(b_str, sizeof(b_str), "%.1f g", ohne_beutel);
        lv_label_set_text(lbl_keys, b_str);
        lv_obj_set_style_text_color(lbl_keys, lv_color_hex(0xf0b838), 0);  // same as scale netto

        // bag SM diff
        if (lbl_bag_sm_diff && sm_remaining > 0) {
          float bag_diff = ohne_beutel - sm_remaining;
          char bd_str[16];
          snprintf(bd_str, sizeof(bd_str), bag_diff >= 0 ? "+%.0f g" : "%.0f g", bag_diff);
          lv_label_set_text(lbl_bag_sm_diff, bd_str);
          lv_obj_set_style_text_color(lbl_bag_sm_diff,
            bag_diff >= 0 ? lv_color_hex(0x40c080) : lv_color_hex(0xe04040), 0);
        }
      }
    } else if (sm_found) {
      if (lbl_raw_info) lv_label_set_text(lbl_raw_info, "");
      if (lbl_bag_sm_diff) lv_label_set_text(lbl_bag_sm_diff, "");
      if (lbl_spoolman_dried) {
        char lt_str[16];
        snprintf(lt_str, sizeof(lt_str), "%.1f g", scale_weight_g);
        lv_label_set_text(lbl_spoolman_dried, lt_str);
      }
      if (lbl_keys) lv_label_set_text(lbl_keys, "");
    } else {
      if (lbl_raw_info) lv_label_set_text(lbl_raw_info, "");
      if (lbl_bag_sm_diff) lv_label_set_text(lbl_bag_sm_diff, "");
      if (lbl_spoolman_dried) lv_label_set_text(lbl_spoolman_dried, "");
      if (lbl_keys) lv_label_set_text(lbl_keys, "");
    }
  }

  // Fix 10: Spoolman health check every 30s
  if (wifi_ok) {
    static unsigned long last_sm_check_ms = 0;
    if (millis() - last_sm_check_ms >= 30000) {
      last_sm_check_ms = millis();
      HTTPClient hc;
      String url = String(cfg_spoolman_base) + "/api/v1/health";
      hc.begin(url);
      hc.setTimeout(3000);
      int code = hc.GET();
      hc.end();
      bool was_reachable = sm_reachable;
      sm_reachable = (code == 200);
      if (sm_reachable != was_reachable) updateHeaderStatus();
    }
  }

  // Periodic NAU7802 I2C ping every 5s (independent of WiFi)
  {
    static unsigned long last_scl_check_ms = 0;
    if (millis() - last_scl_check_ms >= 5000) {
      last_scl_check_ms = millis();
      I2C_EXT.beginTransmission(0x2A);
      bool prev = scl_ok;
      scl_ok = (I2C_EXT.endTransmission() == 0);
      if (scl_ok != prev) updateHeaderStatus();
    }
  }

  // ============================================================
  //  NFC SCAN LOGIC (0.4.21)
  //  - uidLen==4: MIFARE Classic → Bambu flow (unchanged)
  //  - uidLen==7: NTAG detected:
  //      "SPSC" magic → SpoolScale tag → querySpoolman by ID
  //      Blank (0x00) → show spool list + link
  //      Unknown      → ignore
  // ============================================================
  if (nfc_ok) {
    static unsigned long last_nfc_check_ms = 0;
    if (millis() - last_nfc_check_ms >= 500) {
      last_nfc_check_ms = millis();
      uint8_t uid[7], uidLen = 0;
      bool found = nfc.readPassiveTargetID(PN532_MIFARE_ISO14443A, uid, &uidLen, 100);

      if (found && uidLen == 4) {
        // ── MIFARE Classic (Bambu) ────────────────────────────
        last_tag_seen_ms = millis();
        tag_present = true;
        resetActivityTimer();

        char uid_str[24];
        snprintf(uid_str, sizeof(uid_str), "%02X:%02X:%02X:%02X",
          uid[0], uid[1], uid[2], uid[3]);

        bool uid_changed = (strcmp(uid_str, g_tag.uid_str) != 0);
        bool uuid_missing = (strlen(g_tag.tray_uuid) < 32);

        if (uid_changed) {
          Serial.printf("NFC: New Bambu UID %s\n", uid_str);
          nfc_retry_count = 0;
          lv_label_set_text(lbl_nfc_dot, LV_SYMBOL_BULLET);
          lv_obj_set_style_text_color(lbl_nfc_dot, lv_color_hex(0x28d49a), 0);
          lv_label_set_text(lbl_status, T(STR_READING_TAG));
          lv_obj_set_style_text_color(lbl_status, lv_color_hex(0x28d49a), 0);
          scanTag(uid, uidLen);
        } else if (uuid_missing && nfc_retry_count < NFC_MAX_RETRIES) {
          nfc_retry_count++;
          Serial.printf("NFC: tray_uuid empty, retry %d/%d\n", nfc_retry_count, NFC_MAX_RETRIES);
          lv_label_set_text(lbl_nfc_dot, LV_SYMBOL_BULLET);
          lv_obj_set_style_text_color(lbl_nfc_dot, lv_color_hex(0x28d49a), 0);
          lv_label_set_text(lbl_status, T(STR_READING_TAG));
          lv_obj_set_style_text_color(lbl_status, lv_color_hex(0x28d49a), 0);
          scanTag(uid, uidLen);
        } else {
          if (uuid_missing && nfc_retry_count >= NFC_MAX_RETRIES) {
            lv_label_set_text(lbl_nfc_dot, LV_SYMBOL_BULLET);
            lv_obj_set_style_text_color(lbl_nfc_dot, lv_color_hex(0xf0b838), 0);
            lv_label_set_text(lbl_status, T(STR_WAIT_SCAN));
            lv_obj_set_style_text_color(lbl_status, lv_color_hex(0xf0b838), 0);
          } else {
            // tray_uuid present — query Spoolman if not done yet
            if (strcmp(g_tag.uid_str, spoolman_queried_uid) != 0 && strlen(g_tag.tray_uuid) == 32) {
              querySpoolman(g_tag.tray_uuid);
              strncpy(spoolman_queried_uid, g_tag.uid_str, sizeof(spoolman_queried_uid)-1);
              if (!sm_found && wifi_ok) {
                link_tag_first_seen_ms = millis();  // Start timer
                link_popup_dismissed = false;
              }
            } else if (!sm_found && !link_popup_dismissed && scr_link_entry == nullptr &&
                       wifi_ok && strlen(g_tag.tray_uuid) == 32) {
              // 3s delay elapsed?
              if (link_tag_first_seen_ms > 0 &&
                  millis() - link_tag_first_seen_ms >= LINK_POPUP_DELAY_MS) {
                Serial.println("Bambu: not in Spoolman -> entry popup (after delay)");
                showLinkEntryPopup(true);
              }
            }
            lv_label_set_text(lbl_nfc_dot, LV_SYMBOL_BULLET);
            lv_obj_set_style_text_color(lbl_nfc_dot, lv_color_hex(0x28d49a), 0);
            lv_label_set_text(lbl_status, sm_found ? T(STR_TAG_FOUND) : T(STR_NOT_IN_SPOOLMAN));
            lv_obj_set_style_text_color(lbl_status,
              sm_found ? lv_color_hex(0x28d49a) : lv_color_hex(0xf0b838), 0);
          }
        }

      } else if (found && uidLen == 7) {
        // ── NTAG detected ──────────────────────────────────────
        last_tag_seen_ms = millis();
        tag_present = true;
        resetActivityTimer();

        char uid_str[24];
        snprintf(uid_str, sizeof(uid_str), "%02X:%02X:%02X:%02X:%02X:%02X:%02X",
          uid[0], uid[1], uid[2], uid[3], uid[4], uid[5], uid[6]);

        Serial.printf("NFC: NTAG UID=%s\n", uid_str);

        bool uid_changed_ntag_log = (strcmp(uid_str, g_tag.uid_str) != 0);
        if (uid_changed_ntag_log) logSDf("NFC: NTAG UID=%s", uid_str);

        lv_label_set_text(lbl_nfc_dot, LV_SYMBOL_BULLET);
        lv_obj_set_style_text_color(lbl_nfc_dot, lv_color_hex(0x28d49a), 0);

        bool uid_changed_ntag = (strcmp(uid_str, g_tag.uid_str) != 0);

        if (uid_changed_ntag) {
          // New UID — clear old tag data
          strncpy(g_tag.uid_str, uid_str, sizeof(g_tag.uid_str)-1);
          g_tag.tray_uuid[0] = '\0';
          g_tag.material[0] = '\0';
          g_tag.color_hex[0] = '\0';
          g_tag.vendor[0] = '\0';
          spoolman_queried_uid[0] = '\0';
          lv_label_set_text(lbl_uid, uid_str);
          lv_label_set_text(lbl_tray_uuid, "-");
          lv_label_set_text(lbl_material, "-");
          lv_label_set_text(lbl_filament_name, "-");
          lv_label_set_text(lbl_vendor, "-");
          lv_label_set_text(lbl_detail, "-");
          lv_label_set_text(lbl_last_used, "-");
          lv_label_set_text(lbl_spoolman_dried_val, "-");
          lv_obj_set_style_bg_color(lbl_color_swatch, lv_color_hex(0x333333), 0);
          lv_label_set_text(lbl_status, T(STR_READING_TAG));
          lv_obj_set_style_text_color(lbl_status, lv_color_hex(0x28d49a), 0);
          lv_timer_handler();

          if (wifi_ok) {
            querySpoolman(uid_str);
            strncpy(spoolman_queried_uid, uid_str, sizeof(spoolman_queried_uid)-1);

            if (!sm_found) {
              Serial.println("NTAG: not in Spoolman -> waiting for delay");
              strncpy(link_tag_uid, uid_str, sizeof(link_tag_uid)-1);
              link_tag_first_seen_ms = millis();
              link_popup_dismissed = false;
            } else {
              lv_label_set_text(lbl_status, T(STR_TAG_FOUND));
              lv_obj_set_style_text_color(lbl_status, lv_color_hex(0x28d49a), 0);
              strncpy(g_tag.tray_uuid, uid_str, sizeof(g_tag.tray_uuid)-1);
              updateLinkButton();
            }
          } else {
            lv_label_set_text(lbl_status, T(STR_TAG_FOUND));
            lv_obj_set_style_text_color(lbl_status, lv_color_hex(0x28d49a), 0);
          }
        } else {
          // Same UID — show popup after delay if not dismissed
          bool no_popup = (scr_link_entry == nullptr && scr_link_id == nullptr &&
                           scr_link_vendor == nullptr && scr_link_spools == nullptr);
          if (!sm_found && no_popup && wifi_ok && !link_popup_dismissed) {
            if (link_tag_first_seen_ms > 0 &&
                millis() - link_tag_first_seen_ms >= LINK_POPUP_DELAY_MS) {
              strncpy(link_tag_uid, uid_str, sizeof(link_tag_uid)-1);
              showLinkEntryPopup(false);
            }
          }
          lv_label_set_text(lbl_status, sm_found ? T(STR_TAG_FOUND) : T(STR_NOT_IN_SPOOLMAN));
          lv_obj_set_style_text_color(lbl_status,
            sm_found ? lv_color_hex(0x28d49a) : lv_color_hex(0xf0b838), 0);
        }

      } else {
        // No tag found
        if (tag_present) {
          Serial.println("NFC: tag removed");
          logSD("NFC: tag removed");
          tag_present = false;
          nfc_retry_count = 0;
          last_tag_seen_ms = millis();
          link_popup_dismissed = false;   // Reset flag → next spool can show popup
          link_tag_first_seen_ms = 0;
          lv_label_set_text(lbl_nfc_dot, LV_SYMBOL_BULLET);
          lv_obj_set_style_text_color(lbl_nfc_dot, lv_color_hex(0xf0b838), 0);
          lv_label_set_text(lbl_status, T(STR_WAIT_SCAN));
          lv_obj_set_style_text_color(lbl_status, lv_color_hex(0xf0b838), 0);
          // Do NOT close list — user should be able to select spool
          // even if tag is temporarily removed
        }
      }
    }
  }

  delay(5);
}
