Niko11111/SpoolmanScale/src/app/app_state.h

#pragma once

#include "services/tag_field.h"  // TagFieldId, TAG_FIELD_COUNT
#include "services/spool_link_rules.h"
#include "services/tag_uid.h"   // CARD_UIDS_MAX
#include "services/tare_chain.h"  // TareSource

#include <Arduino.h>
#include <Wire.h>
#include <lvgl.h>

#include "app_config.h"
#include "bambu/bambu_tag.h"

extern int bright_normal;
extern int dim_timeout_ms;
extern int off_timeout_ms;
extern int sleep_timeout_ms;

extern TwoWire I2C_EXT;

extern char cfg_wifi_ssid[33];
extern char cfg_wifi_password[65];
extern char cfg_spoolman_ip[64];
extern char cfg_spoolman_base[80];
extern bool cfg_lang_set;
extern bool cfg_first_boot;
// Set when the browser supplied WiFi while the setup was running. The language
// step restarts the device, and without this the restart would find an SSID
// and boot past the rest of the setup. Cleared when the setup ends.
extern bool cfg_setup_resume;

// True while the user is walking through the first time setup chain
// (language, WiFi, backend, address, credentials). Screens that appear in
// both the setup and the settings menu use it to decide which way "back"
// goes and what to hide. Previously this was guessed from whether the
// connection screen happened to exist, which broke as soon as a new step was
// inserted. Cleared by showMainScreen(), which every exit path goes through.
extern bool setup_active;

extern bool nfc_ok;
extern bool scl_ok;

extern BambuTagData g_tag;
extern bool g_tag_ready;
extern bool g_tag_displayed;
extern unsigned long g_tag_shown_ms;
extern bool wifi_ok;
extern bool sm_reachable;
extern bool tag_present;

extern lv_obj_t *scr_main;
extern lv_obj_t *scr_settings;
extern lv_obj_t *scr_wifi;
extern lv_obj_t *scr_backend;
extern lv_obj_t *scr_online;
extern lv_obj_t *scr_filaman_options;
extern lv_obj_t *scr_ams_assign;
extern lv_obj_t *scr_filaman_fields;
extern lv_obj_t *scr_bambuddy_options;
extern lv_obj_t *scr_bambuddy_dried;
extern lv_obj_t *scr_tagwrite;   // writing a tag after a link
extern lv_obj_t *scr_timezone;
extern lv_obj_t *scr_spoolman_options;
extern lv_obj_t *scr_tag_comp;   // companion field beside the native tags
extern lv_obj_t *scr_spoolman;
extern lv_obj_t *scr_welcome;
extern lv_obj_t *scr_first_boot;
extern lv_obj_t *scr_extra_fields;
extern lv_obj_t *scr_tag_field;
extern lv_obj_t *scr_setup_done;
extern lv_obj_t *scr_wifi_setup;
extern lv_obj_t *scr_factor;
extern lv_obj_t *scr_lastused;
extern lv_obj_t *scr_connection;
extern lv_obj_t *scr_wifi_menu;
extern lv_obj_t *scr_bluetooth;
extern lv_obj_t *scr_ble_devices;
extern lv_obj_t *scr_printer;
extern lv_obj_t *scr_scale_sub;
extern lv_obj_t *scr_drying_reminder;
extern lv_obj_t *scr_display;
extern lv_obj_t *scr_system;
extern lv_obj_t *scr_ota;
extern lv_obj_t *scr_ota_browser;
extern lv_obj_t *scr_ota_github;

extern lv_obj_t *lbl_ota_status;
extern lv_obj_t *lbl_burger_badge;
extern lv_obj_t *lbl_system_badge;
extern lv_obj_t *lbl_fw_badge;
extern lv_obj_t *lbl_gh_btn_badge;
extern lv_obj_t *lbl_wifi_info;
extern lv_obj_t *ta_factor_weight;
extern lv_obj_t *kb_factor;
extern lv_obj_t *lbl_factor_result;
extern lv_obj_t *lbl_factor_cal_weight;
extern lv_obj_t *scr_wifi_pass;
extern lv_obj_t *scr_wifi_connecting;
extern lv_obj_t *scr_wifi_portal;

extern int sm_id;

// How many spools answered to the tag that was just looked up. Above one
// means the backend holds more than one record for the same physical spool -
// what FilaMan's Bambu Lab plugin produces when it creates a spool this scale
// had already linked. The scan takes the best ranked one; this is what lets
// the status line say that there was a choice to make.
extern int sm_dup_count;
extern int sm_filament_id;
extern int sm_vendor_id;
extern bool sm_found;
extern float sm_remaining;
extern float sm_total;
extern float sm_spool_weight;
// The link the server itself names for this spool, empty where it names none.
extern char  sm_page_url[SPOOL_LINK_LEN];
extern uint8_t sm_tare_source;
extern char sm_last_dried[32];
// What the matched spool holds in each tag field, indexed by TagFieldId, quote
// stripped, empty where the field holds nothing. Filled by captureBindings()
// in spoolman_lookup.cpp.
//
// All of them rather than just the selected one, because that is what says
// which field actually binds this spool: an unlink has to empty the right one
// and leave the others alone, and the unlink popup sizes itself from the UID
// count without spending an HTTP request. 192 characters hold twelve 7 byte
// UIDs; anything longer is dropped rather than shortened.
extern char sm_tag_values[TAG_FIELD_COUNT][CARD_UIDS_MAX];

// What the matched spool holds in extra.rfid_tag, filled by the same pass.
//
// Its own buffer rather than a slot in the array above: that one is indexed by
// TagFieldId and is walked whole in places that read every filled slot as a
// binding - the unlink popup names them all - and this field binds nothing. It
// carries a copy of the hardware uid for a reader that cannot see anything
// else. Widening the array would also mean touching an enum whose order is
// persisted in NVS.
//
// Needed in RAM for the same reason as the array: the unlink runs from an LVGL
// callback and cannot go and fetch it, and appending has to know what is
// already there or it would replace the tag on the other flange.
extern char sm_hw_uid_value[CARD_UIDS_MAX];

// A spool that was found, but is archived. Its own state rather than a flavour
// of sm_found: the screen has to show the spool - name, filament, tare - so the
// user can bring it back, while everything that writes has to hold off until
// they do. Archiving in Spoolman sets remaining_weight to 0, so a silent
// weighing here would record a full spool as empty stock.
extern bool sm_archived;

// The spool that already holds the tag a link was just refused for, or 0.
// Written by patchSpoolTag() on Spoolman's 409, read by the link flow so it
// can name that spool instead of reporting a bare failure.
extern int sm_tag_conflict_spool;
// Same for a tag that Spoolman (0.27 and later) has on a filament instead of a
// spool. It cannot be moved from here, only named.
extern int sm_tag_conflict_filament;

// Shorthand for the field the user selected, which is the one most callers
// mean. Never null.
const char* smSelectedTagValue();

// How many UIDs the matched spool is bound by, across every tag field. More
// than one only ever comes from a list field, and that is what makes "unlink"
// an ambiguous request that has to be asked about.
int smBoundUidCount();

// How many places hold a binding at all, which is a different question from how
// many UIDs there are: the same UID in extra.tag and in Spoolman's relation is
// two sources and one tag. The unlink asks when either count is above one - two
// UIDs make "only this one or all of them" a real question, two sources make
// "you are about to clear both" worth saying out loud.
int smBoundSourceCount();
extern char sm_article_nr[32];
extern char sm_filament_name[32];
extern char sm_material_global[32];
extern char sm_vendor_g[32];
extern char sm_color_global[16];
// Room for a whole location name: Spoolman allows 64 characters, and with
// umlauts that is more than 64 bytes. A name cut here and written back would
// become a new location on the server.
#define LOCATION_NAME_MAX 130
extern char sm_location_name[LOCATION_NAME_MAX];
extern int sm_location_id;
// FilaMan spool status, 1..6 (see FILAMAN_STATUS_* in filaman_api.h).
// 0 means unknown, which is also what Spoolman and BamBuddy always leave here.
extern int sm_status_id;

extern float scale_weight_g;
extern bool scale_ready;
extern float cal_factor;
extern int32_t zero_offset;
extern float scale_filter_buf[SCALE_FILTER_SIZE];
extern int scale_filter_idx;
extern bool scale_filter_full;

extern lv_obj_t *lbl_weight_main_lbl;
extern float bag_weight_g;
// 0 g means there is no bag: the main screen drops its bag line, the weight
// popup its "with bag" button, and the menu row says so.
inline bool bagInUse() { return bag_weight_g > 0.0f; }
extern char spoolman_queried_uid[24];
// Which NTAG the poll has already dealt with. Distinct from the one above,
// which means "asked the backend about this one" and is written only when the
// query actually runs, and from g_tag, which is what the display is showing.
extern char ntag_handled_uid[24];

// Clears both markers above. They answer the same question - "has the poll
// already dealt with the tag lying on the pad" - for the two tag kinds, so
// anything that changes what the backend knows about that tag has to clear
// both or the poll keeps the stale answer. Linking, copying and creating all
// do exactly that, and each one clearing whichever marker its author had in
// mind is how a freshly linked spool ended up still reading as unlinked until
// it was physically lifted off.
void tagLookupForget();
extern char sm_last_used[32];
extern int nfc_retry_count;
extern int nfc_absent_count;

// Fast re-poll state and read statistics (v0.6.1-beta).
// nfc_fast_polls counts the consecutive short-interval retries inside the
// current detection gap. The stat counters are cumulative since boot and are
// dumped to the SD log as an aggregate, never per event.
extern int nfc_fast_polls;
extern int nfc_miss_streak;
extern unsigned long nfc_stat_scans;
extern unsigned long nfc_stat_misses;
extern unsigned long nfc_stat_recovered;
extern unsigned long nfc_stat_removals;
extern unsigned long nfc_stat_reinits;

extern lv_obj_t *lbl_status;
extern lv_obj_t *lbl_uid;
extern lv_obj_t *lbl_tray_uuid;
extern lv_obj_t *lbl_material;
extern lv_obj_t *lbl_color;
extern lv_obj_t *lbl_filament_name;
extern lv_obj_t *lbl_color_swatch;
extern lv_obj_t *lbl_vendor;
extern lv_obj_t *lbl_temp;
extern lv_obj_t *lbl_detail;
extern lv_obj_t *lbl_date;
extern lv_obj_t *lbl_spoolman_id;
extern lv_obj_t *lbl_scan_count;
extern lv_obj_t *lbl_keys;
extern lv_obj_t *lbl_raw_info;
extern lv_obj_t *lbl_spoolman_weight;
extern lv_obj_t *lbl_scale_weight;
extern lv_obj_t *lbl_scale_diff;
extern lv_obj_t *lbl_last_used;
extern lv_obj_t *lbl_lu_cap;
extern lv_obj_t *lbl_spoolman_pct;
extern lv_obj_t *lbl_spoolman_dried;
extern lv_obj_t *lbl_spoolman_dried_val;
extern lv_obj_t *lbl_dried_sym;
extern int s_dry_numpad_target;

// Numpad for the AMS assignment window, in seconds. Held here for the
// same reason as the drying one: showMainScreen() has to be able to tear
// it down from outside the screen that built it.
extern int s_ams_numpad_value;
extern lv_obj_t *lbl_nfc_dot;
extern lv_obj_t *lbl_hdr_wifi;
extern lv_obj_t *lbl_hdr_bt;
extern lv_obj_t *lbl_hdr_nfc;
extern lv_obj_t *lbl_hdr_scl;
extern lv_obj_t *lbl_hdr_scans;
extern lv_obj_t *lbl_hdr_ip;    // status bar address, left of the scan counter
extern lv_obj_t *lbl_hdr_sm;
extern lv_obj_t *lbl_hdr_sd;   // header SD indicator, leftmost chip
extern lv_obj_t *lbl_sm_cap;   // "Spoolman:" / "FilaMan:" above the database weight
extern lv_obj_t *lbl_bag_sm_diff;
extern lv_obj_t *lbl_spool_tare;   // the spool weight the netto subtracts, bag-free layout only

extern lv_obj_t *btn_dried;
extern lv_obj_t *btn_link;
extern lv_obj_t *btn_by_id;   // "Spool by ID", the left slot while nothing is on screen
extern lv_obj_t *btn_weight_main;
// Slot 1 of the button bar on a device with no load cell, where the weight
// button would otherwise sit. Only one of the two ever exists - buildUI()
// builds whichever the scale switch calls for - so updateLinkButton() picks
// the one it was given rather than assuming either.
extern lv_obj_t *btn_location;

// Zone 4's right half on a device with no load cell: the note saying why the
// weights are absent, and the way into the AMS view when the backend has one.
// Both exist only in that mode, so everything that touches them checks first -
// updateAmsAffordance() in main_screen_helpers.cpp is the one place that does.
//
// The note moves: it sits at the top of the zone when the button is below it
// and in the middle when it is alone, which is why it needs a pointer at all.
extern lv_obj_t *lbl_no_scale;
extern lv_obj_t *btn_ams_main;
// Its caption, which says what a tap does, and the fill behind it that drains
// while a FilaMan assignment window runs. Rewritten by updateAmsMainButton().
extern lv_obj_t *lbl_ams_main;
extern lv_obj_t *bar_ams_main_fill;

// The AMS chip in the header, and the only one of the chips that is a button
// rather than a state. It exists in both modes: a device with a load cell has
// no room for the zone 4 button and reaches the view from here.
//
// It says "there is an AMS view on this backend", not "an AMS is connected" -
// that answer costs a blocking round trip and lives nowhere a chip could read
// it. Colour is therefore an affordance here, not a verdict.
extern lv_obj_t *btn_hdr_ams;
// The NFC chip, the second button among them: it opens the tag view. Its
// label is lbl_hdr_nfc, which still says whether the reader answers.
extern lv_obj_t *btn_hdr_nfc;
extern lv_obj_t *scr_more_info;
extern int scan_count;
extern lv_obj_t *page_main;
extern lv_obj_t *scr_info;
