Niko11111/SpoolmanScale/src/app/app_state.cpp

#include "app_state.h"

#include "services/tag_field.h"
#include "services/tag_uid.h"
#include "services/user_options.h"

int     bright_normal   = BRIGHT_NORMAL_DEFAULT;
int     dim_timeout_ms  = DIM_TIMEOUT_DEFAULT;
int     off_timeout_ms  = OFF_TIMEOUT_DEFAULT;
int     sleep_timeout_ms = SLEEP_TIMEOUT_DEFAULT;

TwoWire I2C_EXT   = TwoWire(1);

char cfg_wifi_ssid[33]     = "";
char cfg_wifi_password[65] = "";
char cfg_spoolman_ip[64]   = "";
char cfg_spoolman_base[80] = "";
bool cfg_lang_set          = false;
bool cfg_first_boot        = true;
bool cfg_setup_resume      = false;
bool setup_active            = false;

bool nfc_ok = false;
bool scl_ok = false;

BambuTagData g_tag;
bool g_tag_ready = false;
bool g_tag_displayed = false;
unsigned long g_tag_shown_ms = 0;
bool wifi_ok = false;
bool sm_reachable = false;

bool tag_present = false;

lv_obj_t *scr_main   = nullptr;
lv_obj_t *scr_settings   = nullptr;
lv_obj_t *scr_wifi       = nullptr;
lv_obj_t *scr_backend    = nullptr;
lv_obj_t *scr_online     = nullptr;
lv_obj_t *scr_filaman_options = nullptr;
lv_obj_t *scr_ams_assign = nullptr;
lv_obj_t *scr_filaman_fields = nullptr;
lv_obj_t *scr_bambuddy_options = nullptr;
lv_obj_t *scr_bambuddy_dried = nullptr;
lv_obj_t *scr_tagwrite       = nullptr;
lv_obj_t *scr_timezone = nullptr;
lv_obj_t *scr_spoolman_options = nullptr;
lv_obj_t *scr_tag_comp = nullptr;
lv_obj_t *scr_spoolman   = nullptr;
lv_obj_t *scr_welcome    = nullptr;
lv_obj_t *scr_first_boot = nullptr;
lv_obj_t *scr_extra_fields = nullptr;
lv_obj_t *scr_tag_field    = nullptr;
lv_obj_t *scr_setup_done = nullptr;
lv_obj_t *scr_wifi_setup = nullptr;
lv_obj_t *scr_factor     = nullptr;
lv_obj_t *scr_lastused   = nullptr;

lv_obj_t *scr_connection = nullptr;
lv_obj_t *scr_wifi_menu  = nullptr;
lv_obj_t *scr_bluetooth  = nullptr;
lv_obj_t *scr_ble_devices = nullptr;
lv_obj_t *scr_printer     = nullptr;
lv_obj_t *scr_scale_sub  = nullptr;
lv_obj_t *scr_drying_reminder = nullptr;
lv_obj_t *scr_display    = nullptr;
lv_obj_t *scr_system     = nullptr;
lv_obj_t *scr_ota        = nullptr;
lv_obj_t *scr_ota_browser = nullptr;
lv_obj_t *scr_ota_github  = nullptr;

lv_obj_t *lbl_ota_status = nullptr;

lv_obj_t *lbl_burger_badge   = nullptr;
lv_obj_t *lbl_system_badge   = nullptr;
lv_obj_t *lbl_fw_badge       = nullptr;
lv_obj_t *lbl_gh_btn_badge   = nullptr;
lv_obj_t *lbl_wifi_info = nullptr;

lv_obj_t *ta_factor_weight = nullptr;
lv_obj_t *kb_factor     = nullptr;
lv_obj_t *lbl_factor_result = nullptr;
lv_obj_t *lbl_factor_cal_weight = nullptr;

lv_obj_t *scr_wifi_pass         = nullptr;
lv_obj_t *scr_wifi_connecting   = nullptr;
lv_obj_t *scr_wifi_portal       = nullptr;

int   sm_id = 0;
int   sm_dup_count = 0;
int   sm_filament_id = 0;
int   sm_vendor_id = 0;
bool  sm_found = false;
float sm_remaining = 0;
float sm_total = 1000;
float sm_spool_weight = 0;
uint8_t sm_tare_source = TARE_NONE;
char  sm_last_dried[32] = "";
char  sm_page_url[SPOOL_LINK_LEN] = "";
char  sm_tag_values[TAG_FIELD_COUNT][CARD_UIDS_MAX] = {};
char  sm_hw_uid_value[CARD_UIDS_MAX] = "";
bool  sm_archived = false;
int   sm_tag_conflict_spool = 0;
int   sm_tag_conflict_filament = 0;

const char* smSelectedTagValue() {
  return sm_tag_values[tagFieldEffective()];
}

// The entry count, every copy counted. Only the fallback for a set of UIDs too
// long to tell apart in one buffer.
static int smBoundEntryCount() {
  int n = 0;
  for (uint8_t i = 0; i < TAG_FIELD_EXTRA_COUNT; i++) {
    if (!sm_tag_values[i][0]) continue;
    n += tagFieldSpec(i).is_list ? cardUidsCount(sm_tag_values[i]) : 1;
  }
  return n + cardUidsCount(sm_tag_values[TAG_FIELD_NATIVE]);
}

int smBoundUidCount() {
  // Distinct UIDs, not entries. The companion field and a field from before
  // the move to the native tags hold the very UID the relation does, and
  // counting it three times offered "only this tag" on a spool with one.
  //
  // Spoolman's relation is held as a list in the slot beside them, whatever
  // its spec says: is_list there drives the UI's multi tag switch, while
  // several tags per spool are the normal case rather than a format. Counting
  // them is what makes the unlink popup offer "all" at all - without this a
  // Bambu spool with three entries looked like a single binding, and the only
  // reachable answer dropped one of them.
  char seen[CARD_UIDS_MAX] = "";
  bool fits = true;
  for (uint8_t i = 0; i < TAG_FIELD_COUNT; i++) {
    if (sm_tag_values[i][0]) fits = cardUidsMerge(seen, sizeof(seen), sm_tag_values[i]) && fits;
  }
  return fits ? cardUidsCount(seen) : smBoundEntryCount();
}

int smBoundSourceCount() {
  int n = 0;
  for (uint8_t i = 0; i < TAG_FIELD_EXTRA_COUNT; i++)
    if (sm_tag_values[i][0]) n++;
  if (sm_tag_values[TAG_FIELD_NATIVE][0]) n++;
  return n;
}
char  sm_article_nr[32] = "";
char  sm_filament_name[32] = "";
char  sm_material_global[32] = "";
char  sm_vendor_g[32] = "";
char  sm_color_global[16] = "";
char  sm_location_name[LOCATION_NAME_MAX] = "";
int   sm_location_id = 0;
int   sm_status_id = 0;

float scale_weight_g = 0.0f;
bool scale_ready = false;
float cal_factor = CAL_FACTOR_DEFAULT;
int32_t zero_offset = 0;

float scale_filter_buf[SCALE_FILTER_SIZE] = {0};
int   scale_filter_idx = 0;
bool  scale_filter_full = false;

lv_obj_t *lbl_weight_main_lbl = nullptr;

float bag_weight_g = 0.0f;

char spoolman_queried_uid[24] = "";
char ntag_handled_uid[24] = "";

void tagLookupForget() {
  spoolman_queried_uid[0] = '\0';
  ntag_handled_uid[0]     = '\0';
}
char  sm_last_used[32] = "";

int nfc_retry_count = 0;
int nfc_absent_count = 0;
int nfc_fast_polls = 0;
int nfc_miss_streak = 0;
unsigned long nfc_stat_scans = 0;
unsigned long nfc_stat_misses = 0;
unsigned long nfc_stat_recovered = 0;
unsigned long nfc_stat_removals = 0;
unsigned long nfc_stat_reinits = 0;

lv_obj_t *lbl_status;
lv_obj_t *lbl_uid;
lv_obj_t *lbl_tray_uuid;
lv_obj_t *lbl_material;
lv_obj_t *lbl_color;
lv_obj_t *lbl_filament_name;
lv_obj_t *lbl_color_swatch;
lv_obj_t *lbl_vendor;
lv_obj_t *lbl_temp;
lv_obj_t *lbl_detail;
lv_obj_t *lbl_date;
lv_obj_t *lbl_spoolman_id;
lv_obj_t *lbl_scan_count;
lv_obj_t *lbl_keys;
lv_obj_t *lbl_raw_info;

lv_obj_t *lbl_spoolman_weight;
lv_obj_t *lbl_scale_weight;
lv_obj_t *lbl_scale_diff;
lv_obj_t *lbl_last_used;
lv_obj_t *lbl_lu_cap = nullptr;
lv_obj_t *lbl_spoolman_pct;
lv_obj_t *lbl_spoolman_dried;
lv_obj_t *lbl_spoolman_dried_val;
lv_obj_t *lbl_dried_sym = nullptr;
int  s_dry_numpad_target = 0;

int  s_ams_numpad_value = 0;
lv_obj_t *lbl_nfc_dot;
lv_obj_t *lbl_hdr_wifi;
lv_obj_t *lbl_hdr_bt = nullptr;
lv_obj_t *lbl_hdr_nfc;
lv_obj_t *lbl_hdr_scl = nullptr;
lv_obj_t *lbl_hdr_scans;
lv_obj_t *lbl_hdr_ip = nullptr;
lv_obj_t *lbl_hdr_sm = nullptr;
lv_obj_t *lbl_hdr_sd = nullptr;
lv_obj_t *lbl_sm_cap = nullptr;
lv_obj_t *lbl_bag_sm_diff = nullptr;
lv_obj_t *lbl_spool_tare = nullptr;

lv_obj_t *btn_dried  = nullptr;
lv_obj_t *btn_link   = nullptr;
lv_obj_t *btn_by_id  = nullptr;
lv_obj_t *btn_weight_main = nullptr;
lv_obj_t *btn_location = nullptr;
lv_obj_t *lbl_no_scale = nullptr;
lv_obj_t *btn_ams_main = nullptr;
lv_obj_t *lbl_ams_main = nullptr;
lv_obj_t *bar_ams_main_fill = nullptr;
lv_obj_t *btn_hdr_ams = nullptr;
lv_obj_t *btn_hdr_nfc = nullptr;

lv_obj_t *scr_more_info = nullptr;

int scan_count = 0;
lv_obj_t *page_main;

lv_obj_t *scr_info = nullptr;
