Niko11111/SpoolmanScale/src/services/auto_weight_state.h

#pragma once

extern bool g_auto_weight;
extern bool g_auto_loc_popup;
extern float auto_weight_last_val;
extern unsigned long auto_weight_stable_ms;

#define AUTO_WEIGHT_STABLE_MS 3000
#define AUTO_WEIGHT_THRESH_G 0.5f
