Niko11111/SpoolmanScale/src/lang.cpp

// ============================================================
//  SpoolmanScale – Localization (i18n)
//  lang.cpp - String table DE / EN / FR
// ============================================================
#include <lvgl.h>
#include "services/tag_write.h"   // the TagWriteResult codes
#include "lang.h"

Lang   g_lang     = LANG_EN;
uint8_t g_date_fmt = DATE_FMT_DMY;

// Order MUST exactly match the StringID enum in lang.h!
// Format: { "Deutsch", "English", "Francais" }
const char* const STRINGS[][3] = {

  // Navigation
  { "Abbrechen",       "Cancel",       "Annuler" },  // STR_CANCEL
  { "Zurück",          "Back",         "Retour" },  // STR_BACK
  { "Bestätigen",      "Confirm",      "Confirmer" },  // STR_CONFIRM
  { "ID neu eingeben", "Enter new ID", "Ressaisir l'ID" },  // STR_ENTER_NEW_ID

  // Mainscreen Labels
  { "Spoolman",         "Spoolman",    "Spoolman" },  // STR_LBL_SPOOLMAN
  { "Waage",            "Scale",       "Balance" },  // STR_LBL_SCALE
  { "Letzte Benutzung", "Last used",   "Dernier usage" },  // STR_LBL_LAST_USED
  { "Letzte Trocknung", "Last dried",  "Dernier séchage" },  // STR_LBL_LAST_DRIED
  { "Temperatur",       "Temperature", "Température" },  // STR_LBL_TEMP
  { "Hersteller",       "Vendor",      "Fabricant" },  // STR_LBL_VENDOR

  // Mainscreen Status
  { "Spule an Reader halten...",    "Hold spool near reader...",    "Présentez la bobine..." },  // STR_WAIT_SCAN
  { "NFC Tag erkannt",              "NFC tag detected",             "Tag NFC détecté" },  // STR_TAG_FOUND
  { "Kein WLAN",                    "No WiFi",                      "Pas de WiFi" },  // STR_NO_WIFI
  { "Warte...",                     "Please wait...",               "Patientez..." },  // STR_WAIT
  { "Warte auf Scan...",            "Waiting for scan...",          "Attente du scan..." },  // STR_WAIT_SCAN_SM
  { "unbekannt",                    "unknown",                      "inconnu" },  // STR_UNKNOWN
  { "nicht lesbar",                 "not readable",                 "illisible" },  // STR_NOT_READABLE
  { "heute",                        "today",                        "aujourd'hui" },  // STR_TODAY
  { "gestern",                      "yesterday",                    "hier" },  // STR_YESTERDAY
  { "vor %d Tagen",                 "%d days ago",                  "il y a %d jours" },  // STR_DAYS_AGO
  { "Fehler beim Speichern",        "Error saving",                 "Échec de sauvegarde" },  // STR_ERR_SAVE
  { "Nicht in Spoolman",            "Not in Spoolman",              "Hors Spoolman" },  // STR_NOT_IN_SPOOLMAN
  { "Archiviert",                   "Archived",                     "Archivée" },  // STR_ARCHIVED
  { "Lese Tag...",                  "Reading tag...",               "Lecture du tag..." },  // STR_READING_TAG
  { "Durchsuche Inventar...", "Searching inventory...",
    "Parcours de l'inventaire..." },  // STR_SEARCHING_INVENTORY
  { "Durchsuche Inventar... %u KB", "Searching inventory... %u KB",
    "Parcours de l'inventaire... %u ko" },  // STR_SEARCHING_INVENTORY_KB

  // Mainscreen Buttons
  { "Gewicht updaten",  "Update Weight", "Envoyer le poids" },  // STR_BTN_WEIGHT
  { "Heute getrocknet", "Dried today",   "Noter le séchage" },  // STR_BTN_DRIED
  { "Spule verknüpfen", "Link Spool",    "Lier la bobine" },  // STR_BTN_LINK

  // Welcome Screen

  // WiFi Setup
  { "WLAN einrichten",          "WiFi setup",           "Réglage du WiFi" },  // STR_WIFI_TITLE
  { "Netzwerke suchen...",      "Scanning networks...", "Recherche des réseaux..." },  // STR_WIFI_SCAN
  { "Keine Netzwerke gefunden", "No networks found",    "Aucun réseau trouvé" },  // STR_WIFI_NO_NET
  { "Passwort für: %s",         "Password for: %s",     "Pour le réseau %s" },  // STR_WIFI_PASS_HINT
  { "Passwort...",              "Password...",          "Mot de passe..." },  // STR_WIFI_PASS_PLACEHOLDER
  { "Verbinde mit %s...",       "Connecting to %s...",  "Connexion à %s..." },  // STR_WIFI_CONNECTING

  // Spoolman IP
  { "Spoolman Server", "Spoolman Server", "Serveur Spoolman" },  // STR_SPOOLMAN_TITLE

  // Settings
  { "Einstellungen",                  "Settings",                       "Réglages" },  // STR_SETTINGS_TITLE
  { "Verbindung",                     "Connection",                     "Connexion" },  // STR_TILE_CONNECTION
  { "WLAN | Bluetooth | Spoolman", "WiFi | Bluetooth | Spoolman",
    "WiFi | Bluetooth | Spoolman" },  // STR_TILE_CONN_SUB
  { "Spulen & Waage",                 "Spools & scale",                 "Bobines et balance" },  // STR_TILE_SCALE
  { "Tags | Trocknung | Kalibrieren", "Tags | Drying | Calibration",
    "Tags | Séchage | Étalonnage" },  // STR_TILE_SCALE_SUB
  { "Display",                        "Display",                        "Affichage" },  // STR_TILE_DISPLAY
  { "Helligkeit | Dimmen | Schlaf", "Brightness | Dim | Sleep",
    "Luminosité | Atténuer | Veille" },  // STR_TILE_DISPLAY_SUB
  { "System",                         "System",                         "Système" },  // STR_TILE_SYSTEM
  { "Web | Update | Sprache | Info", "Web | Update | Language | Info",
    "Web | Mise à jour | Langue | Info" },  // STR_TILE_SYSTEM_SUB

  // Connection
  { "WLAN-Einstellungen", "WiFi settings",     "Réglages WiFi" },  // STR_BTN_WIFI_SETTINGS
  { "Nicht konfiguriert", "Not configured",    "Non configuré" },  // STR_BTN_WIFI_NONE
  { "WLAN-Status",        "WiFi status",       "État du WiFi" },  // STR_BTN_WIFI_STATUS
  { "Nicht verbunden",    "Not connected",     "Sans connexion" },  // STR_BTN_WIFI_STATUS_SUB
  { "Server, OTA, Logs",  "Server, OTA, logs", "Serveur, OTA, journaux" },  // STR_BTN_WEB_SUB
  { "Webserver",          "Web server",        "Serveur web" },  // STR_WEB_SERVER
  { "Wartung",            "Maintenance",       "Maintenance" },  // STR_WEB_MAINT
  { "Einstellungen",      "Settings",          "Réglages" },  // STR_WEB_CONFIG
  { "Aus: Port 80 antwortet nicht.",
    "Off: nothing answers on port 80.",
    "Désactivé : inaccessible depuis le navigateur." },  // STR_WEB_SERVER_HINT
  { "Schaltet die Weboberfläche im Netz an und aus. Ausgeschaltet antwortet Port 80 nicht mehr - außer FilaMan hat ein Geräte-Token hinterlegt, dann bleibt allein dessen Tag-Auslöser erreichbar.",
    "Turns the web interface on and off across the network. Switched off, port 80 stops answering - unless FilaMan holds a device token, in which case only its tag trigger stays reachable.",
    "Active ou désactive l'interface web sur le réseau. Désactivée, elle ne répond plus (port 80) - sauf avec FilaMan, si la balance y est associée : seules les lectures et écritures de tag demandées par FilaMan restent alors possibles." },  // STR_WEB_SERVER_INFO
  { "Liefert Firmware-Upload, Logs, Neustart und das Tag-Schreiben. Standardmäßig aus: schreibt Firmware und NFC-Tags, ohne Passwort.",
    "Serves firmware upload, logs, restart and tag writing. Off by default: these write firmware and NFC tags, with no password.",
    "Rend accessibles dans le navigateur l'envoi de firmware, les journaux, le redémarrage et l'écriture de tags. Désactivé par défaut : sans mot de passe, tout appareil du réseau pourrait installer un firmware et écrire des tags NFC." },  // STR_WEB_MAINT_HINT
  { "Firmware, Logs, Tags, Neustart",
    "Firmware, logs, tags, restart",
    "Firmware, journaux, tags, redémarrage" },  // STR_WEB_MAINT_SUB
  { "Liefert Listenlimits, Trocknung, Anzeige und die Backend-Zugangsdaten. Standardmäßig aus: ändert Einstellungen ohne Passwort.",
    "Serves list limits, drying, display and the backend credentials. Off by default: changes settings with no password.",
    "Rend accessibles dans le navigateur les limites de liste, le séchage, l'affichage et les identifiants du backend. Désactivé par défaut : sans mot de passe, tout appareil du réseau pourrait modifier les réglages." },  // STR_WEB_CONFIG_HINT
  { "Listenlimits, Trocknung, Anzeige",
    "List limits, drying, display",
    "Limites de liste, séchage, affichage" },  // STR_WEB_CONFIG_SUB

  // Scale
  { "Spulen & Waage", "Spools & scale", "Bobines et balance" },  // STR_SCALE_TITLE
  { "Kalibrierung",   "Calibration",    "Étalonnage" },  // STR_BTN_CALIBRATE
  { "Beutelgewicht",  "Bag weight",     "Poids du sachet" },  // STR_BTN_BAGWEIGHT

  // Calibration
  { "Kalibrierung",             "Calibration",              "Étalonnage" },  // STR_CAL_TITLE
  { "Fehler: Gewicht = 0",      "Error: weight = 0",        "Erreur : poids = 0" },  // STR_CAL_ZERO_ERR
  { LV_SYMBOL_OK "  Berechnen", LV_SYMBOL_OK "  Calculate", LV_SYMBOL_OK "  Calculer" },  // STR_BTN_CALCULATE

  // Bag weight
  { "Vakuumbeutel inkl. Silikagelpack in Gramm, 0 = kein Beutel",
    "Vacuum bag incl. silica gel pack in grams, 0 = no bag",
    "Sachet sous vide, gel de silice en g, 0 = sans sachet" },  // STR_BAG_DESC
  { "%.1fg gespeichert", "%.1fg saved",   "%.1fg enregistré" },  // STR_BAG_SAVED
  { "Ungültiger Wert",   "Invalid value", "Valeur invalide" },  // STR_BAG_INVALID

  // Display
  { "Display", "Display", "Affichage" },  // STR_DISPLAY_TITLE
  { LV_SYMBOL_IMAGE "  Helligkeit",
    LV_SYMBOL_IMAGE "  Brightness",
    LV_SYMBOL_IMAGE "  Luminosité" },  // STR_BRIGHT_LABEL
  { LV_SYMBOL_EYE_OPEN "  Dimmen nach (Min.)",
    LV_SYMBOL_EYE_OPEN "  Dim after (min.)",
    LV_SYMBOL_EYE_OPEN "  Atténuer après (min)" },  // STR_DIM_LABEL
  { LV_SYMBOL_POWER "  Tiefschlaf nach (Min.)",
    LV_SYMBOL_POWER "  Deep sleep after (min.)",
    LV_SYMBOL_POWER "  Veille profonde après (min)" },  // STR_SLEEP_LABEL

  // System
  { "System", "System",
    "Système" },  // STR_SYSTEM_TITLE
  { "Deutsch / English / Français", "Deutsch / English / Français",
    "Deutsch / English / Français" },  // STR_BTN_LANG_SUB
  { "Firmware Update", "Firmware Update",
    "Mise à jour firmware" },  // STR_BTN_FW_UPDATE
  { "Browser oder GitHub", "Browser or GitHub",
    "Navigateur ou GitHub" },  // STR_BTN_FW_SUB
  { "Info & Unterstützung", "Info & Support",
    "Info et soutien" },  // STR_BTN_INFO
  { "Anleitung - Ko-fi - GitHub - Discord - MakerWorld", "Manual - Ko-fi - GitHub - Discord - MakerWorld",
    "Manuel - Ko-fi - GitHub - Discord - MakerWorld" },  // STR_BTN_INFO_SUB

  // Language screen
  { "Sprache / Language", "Sprache / Language", "Langue / Language" },  // STR_LANG_TITLE
  { "Gerät startet nach Auswahl neu.",
    "Device will reboot after selection.",
    "Choisir une langue ou un format de date redémarre l'appareil." },  // STR_LANG_HINT
  { "Datum / Date format:", "Datum / Date format:", "Format de date :" },  // STR_DATE_FMT_LABEL

  // OTA
  { "Firmware Update", "Firmware Update",
    "Mise à jour firmware" },  // STR_OTA_TITLE
  { "Upload via Webbrowser", "Upload via web browser",
    "Envoi par navigateur web" },  // STR_OTA_BROWSER
  { ".bin vom PC + SD-Logging", "Upload from PC + SD logging",
    "Depuis le PC + journal SD" },  // STR_OTA_BROWSER_SUB
  { "Update via GitHub", "Update via GitHub",
    "Mise à jour par GitHub" },  // STR_OTA_GITHUB
  { "Direkt-Update aus GitHub Releases", "Direct update from GitHub Releases",
    "Mise à jour directe depuis GitHub Releases" },  // STR_OTA_GITHUB_SUB
  { "Browser Update", "Browser Update",
    "Mise à jour par navigateur" },  // STR_OTA_BROWSER_TITLE
  { LV_SYMBOL_WARNING "  Kein WiFi\nBitte zuerst WiFi einrichten.",
    LV_SYMBOL_WARNING "  No WiFi\nPlease set up WiFi first.",
    LV_SYMBOL_WARNING "  Pas de WiFi\nConfigurez d'abord le WiFi." },  // STR_OTA_NO_WIFI
  { "Browser öffnen und aufrufen:",
    "Open browser and go to:",
    "Ouvrez un navigateur et allez à :" },  // STR_OTA_OPEN_BROWSER
  { LV_SYMBOL_WIFI "  Warte auf Upload...",
    LV_SYMBOL_WIFI "  Waiting for upload...",
    LV_SYMBOL_WIFI "  Attente de l'envoi..." },  // STR_OTA_WAITING
  { LV_SYMBOL_DOWNLOAD "  Lade hoch...",
    LV_SYMBOL_DOWNLOAD "  Uploading...",
    LV_SYMBOL_DOWNLOAD "  Envoi en cours..." },  // STR_OTA_UPLOADING
  { LV_SYMBOL_OK "  Update OK! Starte neu...",
    LV_SYMBOL_OK "  Update OK! Restarting...",
    LV_SYMBOL_OK "  Mise à jour OK ! Redémarrage..." },  // STR_OTA_SUCCESS
  { LV_SYMBOL_WARNING "  Update fehlgeschlagen",
    LV_SYMBOL_WARNING "  Update failed",
    LV_SYMBOL_WARNING "  Échec de la mise à jour" },  // STR_OTA_FAIL
  { "Aktuell: %s", "Current: %s", "Actuelle : %s" },  // STR_OTA_CURRENT

  // QR Popups
  { "Projekt gefällt dir? Kauf mir einen Kaffee!",
    "Support this project!",
    "Le projet vous plaît ? Offrez-moi un café !" },  // STR_QR_KOFI_DESC
  { "Quellcode, Releases & Dokumentation",
    "Source code, releases & docs",
    "Code source, versions et documentation" },  // STR_QR_GITHUB_DESC
  { "Community, Fragen & Support",
    "Community, questions & support",
    "Communauté, questions et entraide" },  // STR_QR_DISCORD_DESC
  { "3D-Modelle & Designs auf MakerWorld",
    "3D models & designs on MakerWorld",
    "Modèles 3D et créations sur MakerWorld" },  // STR_QR_MAKER_DESC

  // Weight popup
  { "Heute getrocknet\nspeichern?", "Save dried\ntoday?",
    "Enregistrer le séchage\nd'aujourd'hui ?" },  // STR_POPUP_DRIED_Q
  { "Ja, bestätigen",               "Yes, confirm",       "Oui, confirmer" },  // STR_BTN_CONFIRMED


  // Link Flow
  { "Bambu-Spule verknüpfen", "Link Bambu spool",  "Lier une bobine Bambu" },  // STR_LINK_BAMBU_TITLE
  { "Unbekannte Spule",       "Unknown spool",     "Bobine inconnue" },  // STR_LINK_NTAG_TITLE
  { "Spool-ID eingeben",      "Enter Spool-ID",    "Saisir l'ID de bobine" },  // STR_BTN_ENTER_ID
  { "Aus Liste wählen",       "Choose from list",  "Choisir dans la liste" },  // STR_BTN_FROM_LIST
  { "Spoolman Spool-ID",      "Spoolman Spool-ID", "ID de bobine Spoolman" },  // STR_LINK_ID_TITLE
  { "Prüfe...",               "Checking...",       "Vérification..." },  // STR_LINK_CHECKING
  { "ID nicht gefunden",      "ID not found",      "ID introuvable" },  // STR_LINK_ID_NOT_FOUND
  { "HTTP Fehler %d",         "HTTP Error %d",     "Erreur HTTP %d" },  // STR_LINK_HTTP_ERR
  { "JSON Fehler",            "JSON error",        "Erreur JSON" },  // STR_LINK_JSON_ERR
  { "Kein WLAN",              "No WiFi",           "Pas de WiFi" },  // STR_LINK_NO_WIFI
  { LV_SYMBOL_WARNING "  Spule bereits verknüpft",
    LV_SYMBOL_WARNING "  Tag already assigned!",
    LV_SYMBOL_WARNING "  Bobine déjà liée" },  // STR_WARN_A_TITLE
  { LV_SYMBOL_WARNING "  Trotzdem verknüpfen",
    LV_SYMBOL_WARNING "  Link anyway",
    LV_SYMBOL_WARNING "  Lier quand même" },  // STR_BTN_OVERWRITE
  { "Material stimmt nicht überein", "Material mismatch", "Le matériau ne correspond pas" },  // STR_WARN_B_TITLE
  { "Tag:      %s\nSpoolman: %s  (#%d)\n\nFalsche ID? Bitte nochmal prüfen.",
    "Tag:      %s\nSpoolman: %s  (#%d)\n\nWrong ID? Please double-check.",
    "Tag :      %s\nSpoolman : %s  (#%d)\n\nMauvais ID ? Vérifiez-le." },  // STR_WARN_B_DETAILS
  { "Hersteller wählen  (%d Spulen)", "Choose vendor  (%d spools)",
    "Choisir le fabricant  (%d bobines)" },  // STR_VENDOR_TITLE
  { "Material wählen",                "Choose material",            "Choisir le matériau" },  // STR_MAT_TITLE
  { "Keine Spulen ohne Tag\nin Spoolman gefunden.",
    "No unlinked spools\nfound in Spoolman.",
    "Aucune bobine sans tag\ntrouvée dans Spoolman." },  // STR_NO_VENDORS
  { "Keine Materialien gefunden.", "No materials found.",
    "Aucun matériau trouvé." },  // STR_NO_MATERIALS
  { "Keine passenden Spulen.\nBitte per ID verlinken.", "No matching spools.\nPlease link via ID.",
    "Aucune bobine correspondante.\nLiez la bobine par son ID." },  // STR_NO_SPOOLS
  { "Verknüpfen?", "Link this spool?",
    "Lier cette bobine ?" },  // STR_CONFIRM_LINK
  { LV_SYMBOL_OK "  Verknüpfen", LV_SYMBOL_OK "  Link",
    LV_SYMBOL_OK "  Lier" },  // STR_LINK_OK

  // Tare
  { LV_SYMBOL_WARNING "  Waage nicht bereit",
    LV_SYMBOL_WARNING "  Scale not ready",
    LV_SYMBOL_WARNING "  Balance non prête" },  // STR_TARE_NOT_READY
  { "API Fehler", "API Error", "Erreur d'API" },  // STR_API_ERROR

  // Reboot popup
  { "Neustart erforderlich", "Restart required", "Redémarrage nécessaire" },  // STR_REBOOT_TITLE
  { "Einstellung wird nach\ndem Neustart aktiv.",
    "Setting takes effect\nafter restart.",
    "Le réglage s'applique après\nle redémarrage." },  // STR_REBOOT_MSG
  { LV_SYMBOL_REFRESH "  Jetzt neu starten",
    LV_SYMBOL_REFRESH "  Restart now",
    LV_SYMBOL_REFRESH "  Redémarrer" },  // STR_REBOOT_BTN

  // WiFi quality
  { "Ausgezeichnet", "Excellent",    "Excellent" },  // STR_WIFI_QUAL_EXCELLENT
  { "Gut",           "Good",         "Bon" },  // STR_WIFI_QUAL_GOOD
  { "Mittel",        "Medium",       "Moyen" },  // STR_WIFI_QUAL_MEDIUM
  { "Schwach",       "Weak",         "Faible" },  // STR_WIFI_QUAL_WEAK
  { "Verbunden",     "Connected",    "Connecté" },  // STR_WIFI_STATUS_CONNECTED
  { "Getrennt",      "Disconnected", "Déconnecté" },  // STR_WIFI_STATUS_DISCONNECTED

  // Numpad buttons
  { LV_SYMBOL_OK "  Speichern", LV_SYMBOL_OK "  Save", LV_SYMBOL_OK "  Enregistrer" },  // STR_BTN_SAVE

  // Spool list title
  { "Alle", "All", "Toutes" },  // STR_SPOOLS_ALL

  // Settings calibration sub
  { "Faktor: %.2f", "Factor: %.2f", "Facteur : %.2f" },  // STR_CAL_FACTOR_SHORT

  // Archive confirm
  { "Spule wirklich\narchivieren?", "Really archive\nthis spool?",
    "Voulez-vous vraiment\narchiver cette bobine ?" },  // STR_ARCHIVE_CONFIRM


  // Bag weight current label
  { "Aktuell: %.0f g", "Current: %.0f g", "Actuel : %.0f g" },  // STR_BAG_CURRENT

  // Warn popup A fields
  { "Spule #%d  |  %s %s\nAkt. Tag: %s",
    "Spool #%d  |  %s %s\nCur. tag: %s",
    "Bobine #%d  |  %s %s\nTag : %s" },  // STR_WARN_A_SPOOL_INFO
  { "Spule #%d\nAkt. Tag: %s",
    "Spool #%d\nCur. tag: %s",
    "Bobine #%d\nTag : %s" },  // STR_WARN_A_SPOOL_SHORT

  // Link entry context
  { "%s | nicht in Spoolman", "%s | not in Spoolman", "%s | absente de Spoolman" },  // STR_LINK_CTX_NOT_IN_SM


  // First boot welcome screen
  { "Willkommen!",
    "Welcome!",
    "Bienvenue !" },  // STR_FIRSTBOOT_TITLE

  // Extra fields screen
  { "Spoolman Extra-Felder",
    "Spoolman Extra Fields",
    "Champs supplémentaires Spoolman" },  // STR_EXTRA_FIELDS_TITLE
  { "Prüfen...",
    "Checking...",
    "Vérification..." },  // STR_EXTRA_FIELDS_CHECKING
  { LV_SYMBOL_OK "  Vorhanden: %s",
    LV_SYMBOL_OK "  Present: %s",
    LV_SYMBOL_OK "  Présents : %s" },  // STR_EXTRA_FIELDS_ALL_OK
  { LV_SYMBOL_WARNING "  Fehlende Felder: %s",
    LV_SYMBOL_WARNING "  Missing fields: %s",
    LV_SYMBOL_WARNING "  Champs manquants : %s" },  // STR_EXTRA_FIELDS_MISSING
  { "Lege Felder an...",
    "Creating fields...",
    "Création des champs..." },  // STR_EXTRA_FIELDS_CREATING
  { LV_SYMBOL_WARNING "  Fehler beim Anlegen: %s",
    LV_SYMBOL_WARNING "  Error creating: %s",
    LV_SYMBOL_WARNING "  Échec de la création : %s" },  // STR_EXTRA_FIELDS_CREATE_FAIL
  { LV_SYMBOL_WARNING "  Kein WiFi",
    LV_SYMBOL_WARNING "  No WiFi",
    LV_SYMBOL_WARNING "  Pas de WiFi" },  // STR_EXTRA_FIELDS_NO_WIFI
  { LV_SYMBOL_WARNING "  Kein Spoolman konfiguriert",
    LV_SYMBOL_WARNING "  No Spoolman configured",
    LV_SYMBOL_WARNING "  Aucun Spoolman configuré" },  // STR_EXTRA_FIELDS_NO_SPOOLMAN

  // Calibration reminder screen
  { "Waage kalibrieren",
    "Calibrate scale",
    "Étalonner la balance" },  // STR_CAL_REMINDER_TITLE
  { LV_SYMBOL_EDIT "  Jetzt kalibrieren",
    LV_SYMBOL_EDIT "  Calibrate now",
    LV_SYMBOL_EDIT "  Étalonner" },  // STR_CAL_REMINDER_NOW

  // Calibration TARE hint

  // Extra fields test button

  // Spoolman IP validation
  { "Verbindung wird geprüft...",
    "Testing connection...",
    "Test de la connexion..." },  // STR_SPOOLMAN_TESTING
  { LV_SYMBOL_WARNING "  Spoolman nicht erreichbar",
    LV_SYMBOL_WARNING "  Spoolman not reachable",
    LV_SYMBOL_WARNING "  Spoolman injoignable" },  // STR_SPOOLMAN_FAIL
  { "Erneut versuchen",
    "Retry",
    "Réessayer" },  // STR_SPOOLMAN_RETRY
  { "Überspringen",
    "Skip",
    "Ignorer" },  // STR_SPOOLMAN_SKIP

  // More info filament screen
  { "Mehr Info",
    "More info",
    "Plus d'infos" },  // STR_BTN_MORE_INFO

  // GitHub OTA check screen
  { "GitHub Update",
    "GitHub Update",
    "Mise à jour GitHub" },  // STR_GH_OTA_TITLE
  { "Auf Updates prüfen",
    "Check for Updates",
    "Rechercher des mises à jour" },  // STR_GH_OTA_CHECK_BTN
  { "Prüfen...",
    "Checking...",
    "Recherche..." },  // STR_GH_OTA_CHECKING
  { "Kein WLAN - bitte zuerst verbinden",
    "No WiFi - please connect first",
    "Pas de WiFi - connectez-vous d'abord" },  // STR_GH_OTA_NO_WIFI
  { "Bereits aktuell",
    "Already up to date",
    "Déjà à jour" },  // STR_GH_OTA_UP_TO_DATE
  { "Update verfügbar: %s",
    "Update available: %s",
    "Mise à jour disponible : %s" },  // STR_GH_OTA_UPDATE_AVAIL
  { "Jetzt installieren",
    "Install Now",
    "Installer maintenant" },  // STR_GH_OTA_UPDATE_BTN
  { "Installiere... bitte warten",
    "Installing... please wait",
    "Installation... veuillez patienter" },  // STR_GH_OTA_FLASHING
  { "Update erfolgreich - startet neu...",
    "Update successful - restarting...",
    "Mise à jour réussie - redémarrage..." },  // STR_GH_OTA_FLASH_OK
  { "Update fehlgeschlagen",
    "Update failed",
    "Échec de la mise à jour" },  // STR_GH_OTA_FLASH_FAIL
  { "Installiert: %s",
    "Installed: %s",
    "Installée : %s" },  // STR_GH_OTA_INSTALLED
  { "Vorabversionen",
    "Pre-release",
    "Pré-versions" },  // STR_GH_OTA_PRERELEASE
  { "Automatisch suchen",
    "Auto check",
    "Recherche auto" },  // STR_GH_OTA_AUTOCHECK
  { "Ältere Version verfügbar: %s",
    "Older release available: %s",
    "Version plus ancienne disponible : %s" },  // STR_GH_OTA_OLDER
  { "Zurückstufen",
    "Downgrade",
    "Rétrograder" },  // STR_GH_OTA_DOWNGRADE_BTN
  { "Auf %s zurückstufen?\nDiese Version ist älter als die installierte.",
    "Downgrade to %s?\nThis release is older than the installed one.",
    "Revenir à %s ?\nCette version est plus ancienne que celle installée." },  // STR_GH_OTA_DOWNGRADE_ASK

  { "Last Used Modus",
    "Last Used Mode",
    "Mode Last Used" },  // STR_BTN_LASTUSED_MODE
  { "OpenSpoolMan oder SpoolmanScale",
    "OpenSpoolMan or SpoolmanScale",
    "OpenSpoolMan ou SpoolmanScale" },  // STR_BTN_LASTUSED_MODE_SUB
  { "Last Used Modus",
    "Last Used Mode",
    "Mode Last Used" },  // STR_LASTUSED_TITLE
  { "OpenSpoolMan",
    "OpenSpoolMan",
    "OpenSpoolMan" },  // STR_LASTUSED_OPT_OSM
  { "Zuletzt gewogen",
    "Last Weighed",
    "Dernière pesée" },  // STR_LASTUSED_OPT_WEIGHED
  { "Wird die Nutzung deines Filaments in Spoolman genau getrackt, z.B. automatisch durch OpenSpoolMan beim Bambu Lab Drucker, dann wird auf dem Hauptscreen das Datum der letzten Benutzung aus Spoolman angezeigt.",
    "If your filament usage is tracked in Spoolman, e.g. automatically via OpenSpoolMan with a Bambu Lab printer, the main screen will show the date of the last use from Spoolman.",
    "Si la consommation de votre filament est suivie avec précision dans Spoolman, par exemple automatiquement par OpenSpoolMan avec une imprimante Bambu Lab, l'écran principal affiche la date de dernière utilisation enregistrée dans Spoolman." },  // STR_LASTUSED_DESC_OSM
  { "Wird das 'Last Used' Feld in Spoolman nicht aktiv von dir genutzt, dann benutzt SpoolmanScale dieses Feld, um das Datum des letzten Gewichtsupdates zu speichern. Der Hauptscreen zeigt dann 'Zuletzt gewogen' statt 'Zuletzt benutzt'.",
    "If you don't actively use the 'Last Used' field in Spoolman, SpoolmanScale will use it to store the date of the last weight update. The main screen will then show 'Last Weighed' instead of 'Last Used'.",
    "Si vous ne vous servez pas du champ 'Last Used' (Dernière utilisation) de Spoolman, SpoolmanScale y inscrit la date de la dernière mise à jour du poids. L'écran principal affiche alors 'Dernière pesée' au lieu de 'Dernier usage'." },  // STR_LASTUSED_DESC_WEIGHED
  // FilaMan keeps both values itself, so the wording differs from Spoolman:
  // nothing is written, the scale only picks which source it reads.
  { "FilaMan",
    "FilaMan",
    "FilaMan" },  // STR_LASTUSED_OPT_FILAMAN
  { "FilaMan pflegt 'Zuletzt benutzt' selbst und trägt dort echten Druckverbrauch ein, z.B. über seine Druckeranbindung. Solange noch kein Druck erfasst wurde, zeigt der Hauptscreen ersatzweise die letzte Wägung an.",
    "FilaMan maintains 'Last Used' itself and records real print consumption there, e.g. through its printer integration. Until a print has been recorded, the main screen falls back to the last weighing.",
    "FilaMan renseigne lui-même la date de dernière utilisation d'après la consommation réelle des impressions, par exemple via sa connexion à l'imprimante. Tant qu'aucune impression n'est enregistrée, l'écran principal affiche à la place la dernière pesée." },  // STR_LASTUSED_DESC_FILAMAN_USED
  { "FilaMan protokolliert jede Wägung mit Zeitstempel, auch die von dieser Waage. Der Hauptscreen zeigt dann 'Zuletzt gewogen' und damit, wann du die Spule zuletzt in der Hand hattest. Es wird nichts zusätzlich gespeichert.",
    "FilaMan logs every weighing with a timestamp, including the ones from this scale. The main screen then shows 'Last Weighed', i.e. when you last handled the spool. Nothing extra is stored.",
    "FilaMan enregistre la date de chaque pesée, y compris celles faites avec cette balance. L'écran principal affiche alors 'Dernière pesée', c'est-à-dire la dernière fois que vous avez eu la bobine en main. La balance n'écrit rien de plus." },  // STR_LASTUSED_DESC_FILAMAN_WEIGHED
  { "Druckverbrauch oder Wägung",
    "Print usage or weighing",
    "Consommation ou pesée" },  // STR_BTN_LASTUSED_MODE_SUB_FM
  // BamBuddy keeps both dates itself: last_used is stamped when a print
  // consumes the spool, last_weighed_at when a weight is written. Neither is
  // ours to fill, so unlike Spoolman nothing is repurposed here.
  { "BamBuddy",
    "BamBuddy",
    "BamBuddy" },  // STR_LASTUSED_OPT_BAMBUDDY
  { "BamBuddy trägt 'Zuletzt benutzt' selbst ein, wenn ein Druck von dieser Spule verbraucht. Solange kein Druck erfasst wurde, zeigt der Hauptscreen ersatzweise die letzte Wägung an.",
    "BamBuddy fills 'last used' itself when a print consumes this spool. Until a print has been recorded, the main screen falls back to the last weighing.",
    "BamBuddy renseigne lui-même la date de dernier usage quand une impression consomme du filament de cette bobine. Tant qu'aucune impression n'a été enregistrée, l'écran principal affiche la dernière pesée à la place." },  // STR_LASTUSED_DESC_BAMBUDDY_USED
  { "BamBuddy stempelt jede Wägung mit Zeitstempel, auch die von dieser Waage. Der Hauptscreen zeigt dann 'Zuletzt gewogen'. Nur das BamBuddy-Inventar führt dieses Feld - mit einem Spoolman-Server dahinter bleibt es leer.",
    "BamBuddy stamps every weighing, including the ones from this scale. The main screen then shows 'last weighed'. Only the BamBuddy inventory keeps this field - with a Spoolman server behind it, it stays empty.",
    "BamBuddy enregistre la date de chaque pesée, y compris celles faites avec cette balance. L'écran principal affiche alors 'Dernière pesée'. Seul l'inventaire propre à BamBuddy conserve cette date : si BamBuddy s'appuie sur un serveur Spoolman, elle reste vide." },  // STR_LASTUSED_DESC_BAMBUDDY_WEIGHED
  { "Druckverbrauch oder Wägung",
    "Print usage or weighing",
    "Consommation ou pesée" },  // STR_BTN_LASTUSED_MODE_SUB_BB
  // BamBuddy's own inventory stores consumption and derives the rest, so it
  // cannot hold more filament than the label promises. Asked before writing
  // rather than letting the value snap back on the next scan.
  { "Mehr als das Etikett",
    "More than the label",
    "Dépasse l'étiquette" },  // STR_BB_CAP_TITLE
  { "Gemessen: %.0f g. Das Etikett sagt %.0f g. Mehr, als das Etikett hergibt, lässt sich nicht speichern - der Rest stünde danach wieder auf voll.",
    "Measured: %.0f g. The label says %.0f g. No more than the label allows can be stored, so the remainder would read as full again.",
    "Mesuré : %.0f g. L'étiquette indique %.0f g. Impossible d'enregistrer plus que l'étiquette : le poids restant serait ramené à celui d'une bobine pleine." },  // STR_BB_CAP_BODY
  { "Etikett auf %.0f g anheben",
    "Raise label to %.0f g",
    "Porter l'étiquette à %.0f g" },  // STR_BB_CAP_RAISE
  { "Etikett behalten",
    "Keep the label",
    "Garder l'étiquette" },  // STR_BB_CAP_KEEP
  { "Trocknungsdatum",
    "Drying date",
    "Date de séchage" },  // STR_BB_DRIED_TITLE
  { "Nicht speichern",
    "Do not store",
    "Ne pas mémoriser" },  // STR_BB_DRIED_OFF
  { "Das Datum bleibt leer",
    "The date stays empty",
    "La date reste vide" },  // STR_BB_DRIED_OFF_SUB
  { "Spoolman hinter BamBuddy",
    "Spoolman behind BamBuddy",
    "Spoolman derrière BamBuddy" },  // STR_BB_DRIED_SPOOLMAN
  { "In extra.last_dried auf dem Spoolman-Server",
    "Into extra.last_dried on the Spoolman server",
    "Dans extra.last_dried sur le serveur Spoolman" },  // STR_BB_DRIED_SPOOLMAN_SUB
  { "Nur wenn BamBuddy auf einen Spoolman-Server zeigt",
    "Only when BamBuddy points at a Spoolman server",
    "Si BamBuddy pointe vers un serveur Spoolman" },  // STR_BB_DRIED_SPOOLMAN_NA
  { "Ins Notizfeld",
    "Into the note field",
    "Dans le champ note" },  // STR_BB_DRIED_NOTE
  { "Als [last_dried:JJJJ-MM-TT] in der Notiz",
    "As [last_dried:YYYY-MM-DD] in the note",
    "[last_dried:AAAA-MM-JJ] dans la note" },  // STR_BB_DRIED_NOTE_SUB
  { "Neuere BamBuddy-Versionen haben ein eigenes Feld für das Trocknungsdatum, die Waage schreibt dann immer dorthin. Ältere haben keines: Das Notizfeld geht immer und behält den übrigen Text, der andere Weg schreibt in last_dried auf dem Spoolman-Server hinter BamBuddy.",
    "Newer BamBuddy versions have their own field for the drying date, and the scale always writes there. Older ones have none: the note field always works and keeps the rest of the text, the other route writes into last_dried on the Spoolman server behind BamBuddy.",
    "Les versions récentes de BamBuddy ont leur propre champ pour la date de séchage, la balance y écrit alors toujours. Les anciennes n'en ont pas : le champ note fonctionne dans tous les cas et garde le reste du texte, l'option 'Spoolman derrière BamBuddy' écrit dans last_dried, sur le serveur Spoolman relié à BamBuddy." },  // STR_BB_DRIED_INFO
  // Short forms for the connection test line, which has room for about 34
  // characters. The "Inventar:" prefix is what says this names the data
  // source and not the backend - bare "Spoolman" always means the native one.
  { "Inventar: BamBuddy",
    "Inventory: BamBuddy",
    "Inventaire : BamBuddy" },  // STR_BB_INV_OWN
  { "Inventar: Spoolman",
    "Inventory: Spoolman",
    "Inventaire : Spoolman" },  // STR_BB_INV_SPOOLMAN
  // Label above the database name on the backend screen. Same word as the
  // short form above, so the two places do not invent two vocabularies.
  { "Inventar",
    "Inventory",
    "Inventaire" },  // STR_BACKEND_INVENTORY

  // AMS view. The unit names are built here rather than taken from the
  // server: both backends generate their own "AMS A" style labels, and a
  // generated English label would land on the screen untranslated.
  { "AMS-Status",
    "AMS status",
    "État de l'AMS" },  // STR_AMSV_TITLE
  { "AMS ansehen",
    "Show the AMS",
    "Voir l'AMS" },  // STR_AMSV_BTN
  { "Fächer des Druckers",
    "The printer's bays",
    "Les bacs de l'imprimante" },  // STR_AMSV_BTN_SUB
  { "Neu laden",
    "Reload",
    "Recharger" },  // STR_AMSV_RELOAD
  { "AMS wird gelesen...",
    "Reading the AMS...",
    "Lecture de l'AMS..." },  // STR_AMSV_LOADING
  { "AMS %d",
    "AMS %d",
    "AMS %d" },  // STR_AMSV_UNIT
  { "AMS HT %d",
    "AMS HT %d",
    "AMS HT %d" },  // STR_AMSV_UNIT_HT
  { "Extern",
    "External",
    "Externe" },  // STR_AMSV_UNIT_EXT
  { "Leer",
    "Empty",
    "Vide" },  // STR_AMSV_EMPTY
  { "%d%%",
    "%d%%",
    "%d%%" },  // STR_AMSV_HUM_PCT
  { "Stufe %d",
    "Step %d",
    "Niveau %d" },  // STR_AMSV_HUM_LEVEL
  // Says why the bays are still there. FilaMan keeps the assignment in its
  // database but temperature and humidity are live MQTT readings, so an
  // unreachable printer shows full bays with no climate - which looks like a
  // fault in the scale unless the line explains it.
  { "offline, letzter Stand",
    "offline, last known state",
    "hors ligne, dernier état" },  // STR_AMSV_OFFLINE
  // Not the same as offline: the server has simply never heard from its
  // driver. Saying "offline" there blames the printer for the server.
  { "Status unbekannt",
    "state unknown",
    "état inconnu" },  // STR_AMSV_UNKNOWN
  { "Kein AMS gemeldet",
    "No AMS reported",
    "Aucun AMS signalé" },  // STR_AMSV_NO_AMS
  { "Kein Drucker gefunden",
    "No printer found",
    "Aucune imprimante trouvée" },  // STR_AMSV_NO_PRINTER
  { "Server antwortet %d",
    "The server answers %d",
    "Le serveur répond %d" },  // STR_AMSV_ERR_HTTP
  { "Kein Netz",
    "No network",
    "Pas de réseau" },  // STR_AMSV_ERR_NET
  { "Zu wenig Speicher für alle Fächer",
    "Not enough memory for every bay",
    "Mémoire insuffisante pour tous les bacs" },  // STR_AMSV_ERR_FULL
  { "Trocknet %d °C, %d min",
    "Drying %d °C, %d min",
    "Séchage %d °C, %d min" },  // STR_AMSV_DRYING_TIME
  { "Trocknet %d °C",
    "Drying %d °C",
    "Séchage %d °C" },  // STR_AMSV_DRYING_TEMP
  { "druckt %d%%",
    "printing %d%%",
    "imprime %d%%" },  // STR_AMSV_JOB
  // The printer's own states, in words. Bambu keeps the last job and its
  // 100 % on the wire after a print until the next one starts, so the
  // percentage alone would read "printing 100%" for days.
  { "pausiert bei %d%%",
    "paused at %d%%",
    "en pause à %d%%" },  // STR_AMSV_JOB_PAUSED
  { "Druck fertig",
    "print finished",
    "impression terminée" },  // STR_AMSV_STATE_FINISH
  { "Druck abgebrochen",
    "print failed",
    "impression échouée" },  // STR_AMSV_STATE_FAILED
  { "bereit",
    "idle",
    "prête" },  // STR_AMSV_STATE_IDLE
  { "bereitet vor",
    "preparing",
    "en préparation" },  // STR_AMSV_STATE_PREPARE
  // Which of several printers is on screen. Same in both languages, but
  // it goes through T() so a language that numbers differently can change it.
  { "%d/%d",
    "%d/%d",
    "%d/%d" },  // STR_AMSV_PRN_OF
  { "%s -> in welches Fach?",
    "%s -> into which bay?",
    "%s -> dans quel bac ?" },  // STR_AMSV_PICK_HEAD
  { "Spule ist zugeordnet",
    "The spool is assigned",
    "La bobine est affectée" },  // STR_AMSV_ASSIGNED
  { "Spule umgezogen",
    "The spool moved",
    "La bobine a changé de bac" },  // STR_AMSV_MOVED
  { "Zuordnung fehlgeschlagen",
    "Assignment failed",
    "Échec de l'affectation" },  // STR_AMSV_ASSIGN_FAIL
  { "Nach dem Wiegen ins AMS",
    "Into the AMS after weighing",
    "Vers l'AMS après la pesée" },  // STR_BBAMS_ASK
  { "Beim Abheben nach dem Fach fragen",
    "Ask for the bay on removal",
    "Demander le bac au retrait" },  // STR_BBAMS_ASK_SUB
  { "An: nach dem Wiegen einer bekannten Spule fragt die Waage beim Abheben, in welches AMS-Fach sie geht, und trägt das in BamBuddy ein.\n\nBamBuddy konfiguriert das Fach dabei über MQTT am Drucker mit - Material, Farbe und Temperaturen. Das ist gewollt, aber es wirkt auf den Drucker, nicht nur auf die Datenbank.",
    "On: after a known spool has been weighed, the scale asks on removal which AMS bay it goes into and records that in BamBuddy.\n\nBamBuddy also configures the bay on the printer over MQTT while doing so - material, colour and temperatures. That is intended, but it acts on the printer, not only on the database.",
    "Activé : quand vous retirez une bobine connue après sa pesée, la balance demande dans quel bac AMS vous la placez, puis l'enregistre dans BamBuddy.\n\nBamBuddy configure alors aussi ce bac sur l'imprimante par MQTT : matériau, couleur et températures. C'est voulu, mais cela agit sur l'imprimante, pas seulement sur la base de données." },  // STR_BBAMS_ASK_INFO
  { "Werkseinstellungen",         "Factory Reset",      "Réinitialisation" },  // STR_BTN_FACTORY_RESET
  { "Alle Einstellungen löschen", "Erase all settings", "Effacer tous les réglages" },  // STR_BTN_FACTORY_RESET_SUB
  { "Werkseinstellungen?",        "Factory Reset?",     "Réinitialiser ?" },  // STR_FACTORY_RESET_TITLE
  { "Alle Einstellungen werden gelöscht:\nWLAN, Server-Adresse, Kalibrierung,\nSprache und alle anderen Daten.\nDanach startet das Gerät neu.",
    "All settings will be erased:\nWiFi, server address, calibration,\nlanguage and all other data.\nThe device will restart afterwards.",
    "Tous les réglages seront effacés :\nWiFi, adresse du serveur, étalonnage,\nlangue et toutes les autres données.\nL'appareil redémarre ensuite." },  // STR_FACTORY_RESET_MSG
  { "Ja, alles löschen",     "Yes, erase everything", "Oui, tout effacer" },  // STR_FACTORY_RESET_CONFIRM
  { "Neu / Kopie",           "New / Copy",            "Nouveau / Copie" },  // STR_BTN_COPY_SPOOL
  { "Spule kopieren",        "Copy spool",            "Copier la bobine" },  // STR_COPY_TITLE
  { "Spoolman-ID eingeben",  "Enter Spoolman ID",     "Saisir l'ID Spoolman" },  // STR_COPY_ID_BTN
  { "Aktive Spulen",         "Active spools",         "Bobines actives" },  // STR_COPY_ACTIVE_BTN
  { "Archivierte Spulen",    "Archived spools",       "Bobines archivées" },  // STR_COPY_ARCHIVED_BTN
  { "Neue Spule anlegen?",   "Create new spool?",     "Créer une bobine ?" },  // STR_COPY_CONFIRM_TITLE
  { "Spule erstellt!",       "Spool created!",        "Bobine créée !" },  // STR_COPY_OK
  { "Fehler beim Erstellen", "Error creating spool",  "Échec de la création" },  // STR_COPY_FAIL
  { "Keine Spulen gefunden", "No spools found",       "Aucune bobine trouvée" },  // STR_COPY_NO_SPOOLS
  { "Unlink",                "Unlink",                "Dissocier" },  // STR_UNLINK_BTN
  { "Spule unlinken?",       "Unlink spool?",         "Dissocier la bobine ?" },  // STR_UNLINK_TITLE
  { "Löscht den Eintrag im Tag-Feld in Spoolman.\nDie Spule bleibt erhalten.",
    "Clears the tag field entry in Spoolman.\nThe spool itself is kept.",
    "Efface l'entrée du champ tag dans Spoolman.\nLa bobine elle-même est conservée." },  // STR_UNLINK_MSG
  { "Ja, unlinken", "Yes, unlink",
    "Oui, dissocier" },  // STR_UNLINK_CONFIRM
  { "Verbinde mit WLAN...", "Connecting to WiFi...",
    "Connexion au WiFi..." },  // STR_WIFI_CONNECTING_BOOT
  { "Gerät wird gestartet...", "Starting up, please wait...",
    "Démarrage de l'appareil..." },  // STR_BOOTING
  { "Neustart", "Reboot",
    "Redémarrer" },  // STR_BTN_REBOOT
  { "Gerät neu starten", "Restart device",
    "Redémarrer l'appareil" },  // STR_BTN_REBOOT_SUB
  { "Ganze Gramm", "Whole grams",
    "Grammes entiers" },  // STR_WHOLE_GRAM
  { "Mehr Spulen gefunden - nicht gelistet? Per Spool-ID verknüpfen", "More spools found - not listed? Use Spool-ID",
    "Liste incomplète - bobine absente ? Liez-la par son ID" },  // STR_LIST_MORE_SPOOLS
  { "Mehr Hersteller gefunden - nicht gelistet? Per Spool-ID verknüpfen", "More vendors found - not listed? Use Spool-ID",
    "Liste incomplète - fabricant absent ? Liez par l'ID de bobine" },  // STR_LIST_MORE_VENDORS
  { "Mehr Materialien gefunden - nicht gelistet? Per Spool-ID verknüpfen", "More materials found - not listed? Use Spool-ID",
    "Liste incomplète - matériau absent ? Liez par l'ID de bobine" },  // STR_LIST_MORE_MATS

  // Auto-Weight: the help text behind the switch in the scale menu
  { "Liegt eine erkannte Spule 4 Sekunden still, wird ihr Gewicht ohne Beutel gesendet. Unter 1 g Änderung wird nichts gesendet. Ist sie mehr als 5 g schwerer als gespeichert, sendet die Waage nicht und fragt nach.",
    "When a recognised spool lies still for 4 seconds, its weight is sent, without the bag. Under 1 g of change nothing is sent. If it is more than 5 g heavier than stored, the scale sends nothing and asks.",
    "Quand une bobine reconnue reste immobile 4 secondes, son poids est envoyé, sans le sachet. En dessous de 1 g de différence, rien n'est envoyé. Si elle pèse plus de 5 g de plus que la valeur enregistrée, la balance n'envoie rien et demande." },  // STR_AUTO_WEIGHT_INFO
  { "Lagerort",
    "Location",
    "Emplacement" },  // STR_BTN_LOCATION
  { "Lagerort wählen",
    "Select location",
    "Choisir l'emplacement" },  // STR_LOCATION_TITLE
  { LV_SYMBOL_CLOSE " Kein Lagerort",
    LV_SYMBOL_CLOSE " No location",
    LV_SYMBOL_CLOSE " Aucun emplacement" },  // STR_LOCATION_NONE
  { "Lade...",
    "Loading...",
    "Chargement..." },  // STR_LOCATION_LOADING
  { "Kein WLAN",
    "No WiFi",
    "Pas de WiFi" },  // STR_LOCATION_NO_WIFI
  { "Keine Spoolman-Lagerorte gefunden",
    "No Spoolman locations found",
    "Aucun emplacement Spoolman trouvé" },  // STR_LOCATION_NO_LOCATIONS
  { "Leere Lagerorte werden nicht angezeigt",
    "Empty locations are not shown",
    "Les emplacements vides ne sont pas affichés" },  // STR_LOCATION_HINT_EMPTY
  { "Zu viele Lagerorte - nicht alle angezeigt",
    "Too many locations - not all shown",
    "Trop d'emplacements - tous ne sont pas affichés" },  // STR_LOCATION_LIMIT_HIT
  { "Ortsabfrage bei Entnahme", "Location on removal",
    "Demander l'emplacement au retrait" },  // STR_BTN_AUTO_LOC_POPUP
  { "Trocknungserinnerung",     "Drying Reminder",     "Rappel de séchage" },  // STR_BTN_DRYING_REMINDER
  { "Trocknungserinnerung",     "Drying Reminder",     "Rappel de séchage" },  // STR_DRYING_REMINDER_TITLE

  // Drying Reminder Screen
  { "Aus",      "Off",      "Désactivé" },  // STR_DRY_MODE_OFF
  { "Material", "Material", "Matériau" },  // STR_DRY_MODE_MATERIAL
  { "Manuell",  "Manual",   "Manuel" },  // STR_DRY_MODE_MANUAL
  { "Kein Ampelsignal aktiv.\n\nMaterial: Schwellwerte pro Filamenttyp\n(konfigurierbar im Browser).\n\nManuell: Eigene Grenzwerte in Tagen.",
    "No alert signal active.\n\nMaterial: Thresholds per filament type\n(configurable in browser).\n\nManual: Custom limits in days.",
    "Aucun code couleur (vert, jaune, rouge).\n\nMatériau : seuils par type de filament\n(réglables dans le navigateur).\n\nManuel : vos propres seuils, en jours." },  // STR_DRY_OFF_DESC
  { "Schwellwerte im Browser editierbar.", "Thresholds editable in browser.",
    "Seuils modifiables dans le navigateur." },  // STR_DRY_MAT_HINT
  { "Material", "Material",
    "Matériau" },  // STR_DRY_MAT_HDR_MAT
  { "Gelb (Tage)", "Yellow (days)",
    "Jaune (jours)" },  // STR_DRY_MAT_HDR_YELLOW
  { "Rot (Tage)", "Red (days)",
    "Rouge (jours)" },  // STR_DRY_MAT_HDR_RED
  { "Gelb ab", "Yellow from",
    "Jaune dès" },  // STR_DRY_MAN_YELLOW_LBL
  { "Rot ab", "Red from",
    "Rouge dès" },  // STR_DRY_MAN_RED_LBL
  { "Tippen zum Bearbeiten", "Tap to edit",
    "Touchez pour modifier" },  // STR_DRY_MAN_EDIT_HINT
  { "Grenzwerte gelten für alle Materialien.", "Limits apply to all materials.",
    "Ces seuils s'appliquent à tous les matériaux." },  // STR_DRY_MAN_INFO
  { "Tage", "days",
    "jours" },  // STR_DRY_DAYS_UNIT
  { "Gelb-Schwellwert", "Yellow threshold",
    "Seuil jaune" },  // STR_DRY_NUMPAD_YELLOW_TITLE
  { "Rot-Schwellwert", "Red threshold",
    "Seuil rouge" },  // STR_DRY_NUMPAD_RED_TITLE
  { "Effektive Werte (%.1fx Multiplikator eingerechnet)", "Effective values (%.1fx multiplier included)",
    "Valeurs effectives (facteur sous vide %.1fx inclus)" },  // STR_DRY_MAT_EFF_NOTE
  { "Versiegelt", "Sealed",
    "Sous vide" },  // STR_DRY_SEALED_HDR

  // Backend selection. "Spoolman" and "FilaMan" are product names and stay
  // untranslated, so they are not in this table.
  // "Server" described the technology, not the purpose. Both Spoolman and
  // FilaMan manage a filament inventory, and that is what the user picks
  // here. The address screen keeps "Server", because a server address is
  // literally what gets typed in there.
  { "Filamentverwaltung", "Filament manager", "Gestion du filament" },  // STR_BACKEND_TITLE
  { "Adresse",            "Address",          "Adresse" },  // STR_BACKEND_ADDRESS
  { "API-Key",            "API key",          "Clé d'API" },  // STR_BACKEND_APIKEY
  { "Device-Token",       "Device token",     "Jeton d'appareil" },  // STR_BACKEND_DEVICE_TOKEN
  { "gesetzt",            "set",              "en mémoire" },  // STR_BACKEND_SET
  { "fehlt",              "missing",          "à définir" },  // STR_BACKEND_MISSING

  // Web interface. The same server serves the firmware upload and the
  // FilaMan credentials, so the screen title stays neutral.
  { "Weboberfläche",         "Web interface",     "Interface web" },  // STR_WEB_TITLE
  { "Im Browser einrichten", "Set up in browser", "Config. navigateur" },  // STR_BTN_WEB_SETUP
  { "Weiter",                "Next",              "Suivant" },  // STR_BTN_NEXT
  // Shown instead of a spool count when the server answered but the number
  // could not be asked for yet, which is the normal FilaMan setup case.
  { "AN",                "ON",              "ON" },  // STR_ON
  { "AUS",               "OFF",             "OFF" },  // STR_OFF
  { "Im Browser öffnen", "Open in browser", "Navigateur" },  // STR_BTN_OPEN_BROWSER
  // Names every product in both languages and in every backend mode. Not
  // passed through backendText(), see the comment at the call site.
  { "Nicht mit Spoolman, FilaMan oder BamBuddy verbunden",
    "Not affiliated with Spoolman, FilaMan or BamBuddy",
    "Sans lien avec Spoolman, FilaMan ou BamBuddy" },  // STR_NOT_AFFILIATED
  { "Kein Tag erkannt, bitte neu auflegen",
    "No tag detected, place it again",
    "Aucun tag détecté, reposez-le" },  // STR_LINK_NO_TAG

  // Main screen weight box and More-info detail grid
  { "Waage - Spule",     "Scale - Spool",        "Balance - Bobine" },  // STR_LBL_SCALE_SPOOL_CAP
  { "Gesamt",            "Total",                "Total" },  // STR_LBL_TOTAL_CAP
  { "o. Beutel",         "w/o bag",              "s. sachet" },  // STR_LBL_WO_BAG_CAP
  { "Farbe",             "Hex Color",            "Couleur" },  // STR_LBL_HEX_COLOR
  { "Produktionsdatum",  "Production date",      "Date de production" },  // STR_LBL_PRODUCTION_DATE
  { "Artikelnr.",        "Article no.",          "Réf. article" },  // STR_LBL_ARTICLE_NO_SHORT
  { "Leergewicht Spule", "Spool weight (empty)", "Poids bobine vide" },  // STR_LBL_SPOOL_WEIGHT_EMPTY

  // Status bar address selector
  { "Im Statusbalken zeigen", "Show in status bar", "Afficher dans la barre d'état" },  // STR_BTN_IP_STATUSBAR
  { "Gerät",                  "Device",             "Appareil" },  // STR_IP_BAR_DEVICE

  // Remote link. Deliberately not passed through backendText(): this only
  // ever happens in FilaMan mode, so naming it outright is clearer than a
  // substitution that can never differ.
  { "FilaMan: Spule verknüpfen?", "FilaMan: link spool?", "FilaMan : lier la bobine ?" },  // STR_REMOTE_LINK_TITLE
  { "Aufliegenden Tag mit dieser Spule verknüpfen?",
    "Link the tag on the scale to this spool?",
    "Lier le tag posé sur la balance à cette bobine ?" },  // STR_REMOTE_LINK_QUESTION
  { "Verknüpfen",             "Link",                   "Lier" },  // STR_REMOTE_LINK_CONFIRM
  { "Details nicht abrufbar", "Details unavailable",    "Détails indisponibles" },  // STR_REMOTE_LINK_NO_DETAILS
  { "Verknüpfung abgelaufen", "Link request timed out", "Demande de liaison expirée" },  // STR_REMOTE_LINK_TIMEOUT

  // Tag versus spool comparison
  { "Tag",      "Tag",      "Tag" },  // STR_REMOTE_LINK_COL_TAG
  { "Spule",    "Spool",    "Bobine" },  // STR_REMOTE_LINK_COL_SPOOL
  { "Material", "Material", "Matériau" },  // STR_REMOTE_LINK_ROW_MATERIAL
  { "Farbe",    "Colour",   "Couleur" },  // STR_REMOTE_LINK_ROW_COLOR

  // FilaMan options sub screen
  { "Weitere Optionen",        "More options",       "Autres options" },  // STR_BTN_MORE_OPTIONS
  { "Mehrere Tags verknüpfen", "Link multiple tags", "Lier plusieurs tags" },  // STR_CU_WRITE
  { "Schreibt in Spoolmans Feld card_uids",
    "Writes to Spoolman's card_uids field",
    "Écrit dans le champ card_uids de Spoolman" },  // STR_CU_WRITE_SUB
  { "An: eine gescannte UID kommt an die Liste, statt sie zu ersetzen. "
    "Verknüpfte Spulen erscheinen wieder in der Verlinken-Liste, damit ein "
    "zweites Tag dazukommen kann.\n\n"
    "Aus: in card_uids steht immer nur eine UID.\n\n"
    "Nur für card_uids, weil es als einziges Extra-Feld eine Liste aufnimmt. "
    "Spoolman NFC kann mehrere Tags von Haus aus und braucht den Schalter "
    "nicht.",
    "On: a scanned UID is appended to the list instead of replacing it. Linked "
    "spools show up in the link list again so a second tag can join them.\n\n"
    "Off: card_uids only ever holds one UID.\n\n"
    "card_uids only, because it is the one extra field that holds a list. "
    "Spoolman NFC does several tags natively and needs no switch.",
    "Activé : un UID scanné s'ajoute à la liste au lieu de la remplacer. Les bobines déjà liées restent proposées au moment de lier, pour pouvoir leur ajouter un second tag.\n\nDésactivé : card_uids contient toujours un seul UID.\n\nCe réglage ne concerne que card_uids, seul champ supplémentaire qui accepte une liste. Spoolman NFC gère plusieurs tags de lui-même et n'en a pas besoin." },  // STR_CU_WRITE_INFO
  { "UID nicht hinzugefügt",        "UID not added",            "UID non ajouté" },  // STR_CU_NOT_WRITTEN
  { "Tag hängt schon an Spule #%d", "Tag already on spool #%d",
    "Ce tag est déjà sur la bobine #%d" },  // STR_TAG_ON_OTHER_SPOOL
  { LV_SYMBOL_WARNING "  Spule hat schon UIDs",
    LV_SYMBOL_WARNING "  Spool already has UIDs",
    LV_SYMBOL_WARNING "  La bobine a déjà des UID" },  // STR_WARN_A_ADD_TITLE
  { "Spule #%d  |  %s %s\nHat bereits %d UID(s)",
    "Spool #%d  |  %s %s\nAlready has %d UID(s)",
    "Bobine #%d  |  %s %s\nPorte déjà %d UID" },  // STR_WARN_A_ADD_INFO
  { "Spule #%d\nHat bereits %d UID(s)",
    "Spool #%d\nAlready has %d UID(s)",
    "Bobine #%d\nPorte déjà %d UID" },  // STR_WARN_A_ADD_SHORT
  { "UID hinzufügen", "Add UID", "Ajouter l'UID" },  // STR_BTN_ADD_UID
  { "Diese Spule ist mehrfach gebunden.\nNur das Tag auf der Waage lösen\noder die ganze Bindung?",
    "This spool is bound more than once.\nRemove only the tag on the scale\nor the whole binding?",
    "Cette bobine est liée plusieurs fois.\nDissocier le tag sur la balance\nou toute la liaison ?" },  // STR_UNLINK_MULTI_MSG
  { "Nur dieses Tag",                "Only this tag",                "Ce tag seulement" },  // STR_BTN_UNLINK_ONE
  { "Alle lösen",                    "Unlink all",                   "Tout dissocier" },  // STR_BTN_UNLINK_ALL
  { "Ohne Nachfrage verknüpfen",     "Link without asking",          "Lier sans demander" },  // STR_FLM_AUTOLINK
  { "wenn die Spule schon aufliegt", "when the spool is already on",
    "si la bobine est déjà posée" },  // STR_FLM_AUTOLINK_SUB
  { " (Filament)",                   " (filament)",                  " (filament)" },  // STR_TARE_FROM_FILAMENT
  { " (Hersteller)",                 " (brand)",                     " (fabricant)" },  // STR_TARE_FROM_BRAND
  { "Ohne Beutel wiegen - sonst %.0f g zu viel",
    "Weigh without the bag - %.0f g too much otherwise",
    "Pesez sans le sachet - sinon %.0f g de trop" },  // STR_SPOOL_WEIGHT_BAG_HINT
  { "Ohne Tag wiegen",              "Weigh without a tag",           "Peser sans tag" },  // STR_FLM_TAGLESS
  { "wenn kein Tag aufgelegt wird", "when no tag is presented",
    "si aucun tag n'est présenté" },  // STR_FLM_TAGLESS_SUB
  { "Spule gewählt - jetzt wiegen", "Spool selected - weigh it now",
    "Bobine choisie - pesez-la" },  // STR_REMOTE_LINK_WEIGH
  { LV_SYMBOL_EYE_CLOSE "  Bildschirm aus nach (Min.)",
    LV_SYMBOL_EYE_CLOSE "  Screen off after (min.)",
    LV_SYMBOL_EYE_CLOSE "  Écran éteint après (min)" },  // STR_SCREENOFF_LABEL
  { "Nie", "Never", "Jamais" },  // STR_SCREENOFF_NEVER
  { "Löst FilaMan eine Verknüpfung aus und die Spule liegt schon auf der Waage, wird ohne Rückfrage verknüpft. Passen Material oder Farbe nicht zusammen, fragt die Waage trotzdem nach.",
    "When FilaMan triggers a link and the spool is already on the scale, it is linked without asking. If the material or colour do not match, the scale asks anyway.",
    "Quand une liaison est lancée depuis FilaMan alors que la bobine est déjà sur la balance, la liaison se fait sans confirmation. Si le matériau ou la couleur du tag ne correspondent pas à la bobine choisie, la balance demande quand même." },  // STR_FLM_AUTOLINK_INFO
  { "Wird nach einer Verknüpfung aus FilaMan innerhalb von 10 Sekunden kein Tag aufgelegt, lädt die Waage die dort gewählte Spule trotzdem und zeigt sie an. Gewogen wird sie danach wie jede andere: bei eingeschalteter Automatik von selbst, sonst über den Gewichtsknopf. FilaMans eigener Dialog meldet dabei einen Fehler, weil dort kein Tag geschrieben wurde - geladen ist die Spule trotzdem. Auf einen Tag wird nie etwas geschrieben, und die Zuordnung endet, sobald die Spule wieder heruntergenommen wird.",
    "If no tag is presented within 10 seconds of a link from FilaMan, the scale loads the spool chosen there anyway and shows it. Weighing then works as for any other spool: on its own when automatic weighing is on, otherwise through the weight button. FilaMan's own dialog reports an error because no tag was written there - the spool is loaded regardless. Nothing is ever written to a tag, and the spool is released as soon as it is taken off the pad.",
    "Si aucun tag n'est posé dans les 10 secondes qui suivent une liaison lancée depuis FilaMan, la balance charge quand même la bobine choisie dans FilaMan et l'affiche. La pesée se fait ensuite comme pour toute autre bobine : toute seule si la pesée automatique est activée, sinon avec le bouton Envoyer le poids. FilaMan affiche de son côté une erreur, puisqu'aucun tag n'a été écrit, mais la bobine est bien chargée. Rien n'est jamais écrit sur un tag, et cette association temporaire prend fin dès que la bobine est retirée de la balance." },  // STR_FLM_TAGLESS_INFO

  // Auto AMS assignment. FilaMan marks a freshly weighed spool as pending on
  // every printer driver for a few seconds, so the next tray to be loaded
  // gets it. The wording avoids "auto assign" on its own because the whole
  // point of the ask mode is that it is not automatic.
  { "Auto AMS-Zuordnung",           "Auto AMS assign",                "Affectation AMS auto" },  // STR_AMS_TITLE
  { "Spule beim Einlegen zuordnen", "assign the spool as it goes in",
    "affecter la bobine à l'insertion" },  // STR_AMS_SUB
  { "FilaMan merkt eine gewogene Spule einige Sekunden vor. Wer in dieser Zeit ein AMS-Fach belädt, bekommt sie zugeordnet. Geöffnet wird das Fenster nur von einem Gewicht, deshalb bucht die Waage beim Zuordnen ein zweites Mal: die Messung steht dann doppelt im Protokoll, der Wert bleibt gleich. Wandert die Spule ohnehin gleich in den Drucker, genügt kurz auflegen.",
    "FilaMan reserves a weighed spool for a few seconds. Whoever loads an AMS tray in that time gets it assigned. Only a weight opens that window, so assigning books the value a second time: the measurement then shows twice in the log, the value stays the same. If the spool is going into the printer anyway, just resting it on the pad is enough.",
    "FilaMan réserve une bobine pesée pendant quelques secondes : si un bac AMS est chargé pendant cette fenêtre, la bobine lui est affectée. Seul un envoi de poids ouvre la fenêtre : pour affecter la bobine, la balance renvoie donc son poids, qui figure alors deux fois dans l'historique FilaMan, avec la même valeur. Si la bobine va de toute façon tout de suite dans l'imprimante, il suffit de la poser un instant sur la balance." },  // STR_AMS_INFO
  { "Aus",        "Off", "Désactivé" },  // STR_AMS_MODE_OFF
  { "Nachfragen", "Ask", "Demander" },  // STR_AMS_MODE_ASK
  // Not "Immer an": next to "Nachfragen" that reads as "the question is
  // always on", which is the opposite of what it does. Users asking for a way
  // out of the popup had the mode in front of them and did not recognise it.
  { "Automatisch", "Automatic", "Automatique" },  // STR_AMS_MODE_ALWAYS
  { "Es wird nichts vorgemerkt. Wiegen und Lagerort verhalten sich genau wie bisher.",
    "Nothing is reserved. Weighing and location behave exactly as before.",
    "Rien n'est réservé. La pesée et le choix de l'emplacement restent inchangés." },  // STR_AMS_OFF_DESC
  { "Beim Abnehmen wird gefragt, ob die Spule in den Drucker wandert. Ein Ja sendet das Gewicht und öffnet das Fenster.",
    "When the spool is lifted you are asked whether it goes into the printer. A yes sends the weight and opens the window.",
    "Au retrait, la balance demande si la bobine va dans l'imprimante. Un oui envoie le poids et ouvre la fenêtre d'affectation." },  // STR_AMS_ASK_DESC
  // The gain first, the price second: this is the mode people come looking
  // for when the popup is in their way, so it has to say so before it warns.
  { "Kein Popup, kein Countdown: jede Wiegung merkt die Spule vor. Der Preis ist, dass auch kurzes Nachwiegen sie vormerkt.",
    "No popup, no countdown: every weighing reserves the spool. The price is that checking a weight reserves it too.",
    "Ni question ni compte à rebours : chaque pesée réserve la bobine. Contrepartie : une pesée de contrôle la réserve aussi." },  // STR_AMS_ALWAYS_DESC
  { "Fenster",                               "Window",                            "Fenêtre" },  // STR_AMS_WINDOW_LBL
  { "wie lange die Spule vorgemerkt bleibt", "how long the spool stays reserved",
    "durée de réservation de la bobine" },  // STR_AMS_WINDOW_HINT
  { "s",                                     "s",                                 "s" },  // STR_AMS_SEC_UNIT
  { "Bei Ablauf", "When it runs out",
    "À l'expiration" },  // STR_AMS_TIMER_LBL
  { "wenn niemand antwortet", "when nobody answers",
    "si personne ne répond" },  // STR_AMS_TIMER_HINT
  { "Ja",                                    "Yes",                               "Oui" },  // STR_AMS_TIMER_YES
  { "Nein",                                  "No",                                "Non" },  // STR_AMS_TIMER_NO
  { "Spule jetzt ins AMS legen?", "Putting the spool into the AMS?",
    "Mettre la bobine dans l'AMS ?" },  // STR_AMS_POPUP_Q
  { "Zuordnung startet in %d s", "Assignment starts in %d s",
    "Affectation dans %d s" },  // STR_AMS_POPUP_STARTS_IN
  { "Ohne Zuordnung in %d s", "Without assigning in %d s",
    "Sans affectation dans %d s" },  // STR_AMS_POPUP_CLOSES_IN
  { "Ja, zuordnen", "Yes, assign",
    "Oui, affecter" },  // STR_AMS_BTN_YES
  { "Der ApiKey darf keine Geräte verwalten",
    "This ApiKey may not manage devices",
    "Cette clé d'API ne peut pas gérer les appareils" },  // STR_AMS_ERR_FORBIDDEN
  { "Server antwortet nicht (HTTP %d)", "Server not answering (HTTP %d)",
    "Le serveur ne répond pas (HTTP %d)" },  // STR_AMS_ERR_HTTP
  { "%.0f g sind gespeichert", "%.0f g are saved",
    "%.0f g sont enregistrés" },  // STR_AMS_POPUP_SAVED
  { "Zuordnung %d s", "Assigning %d s",
    "Affectation %d s" },  // STR_AMS_WINDOW_RUNNING
  { "Server: Zuordnung aktiv", "Server: assigning active",
    "Serveur : affectation active" },  // STR_AMS_SRV_ON
  { "Server: aus", "Server: off",
    "Serveur : désactivé" },  // STR_AMS_SRV_OFF
  { "%.0f g werden dabei gespeichert", "%.0f g will be saved too",
    "%.0f g seront enregistrés au passage" },  // STR_AMS_POPUP_WILL_SAVE
  { "Neu aus Tag anlegen", "Create from tag",
    "Créer depuis le tag" },  // STR_NEWTAG_BTN
  { "Spule aus Tag anlegen?", "Create spool from tag?",
    "Créer la bobine depuis le tag ?" },  // STR_NEWTAG_TITLE
  { "%s %s\nFarbe: %s\nWaagengewicht (netto): %.0f g", "%s %s\nColour: %s\nScale weight (net): %.0f g",
    "%s %s\nCouleur : %s\nPoids sur la balance (net) : %.0f g" },  // STR_NEWTAG_MSG
  { "Nenngewicht", "Label weight",
    "Poids nominal" },  // STR_NEWTAG_LABEL_W
  { "Spule angelegt!", "Spool created!",
    "Bobine créée !" },  // STR_NEWTAG_OK
  { "Anlegen fehlgeschlagen", "Could not create spool",
    "Création impossible" },  // STR_NEWTAG_FAIL

  { "Tag-Feld", "Tag field", "Champ du tag" },  // STR_TAG_FIELD
  { "Jedes Projekt legt die Tag-UID in ein anderes Extra-Feld, weil Spoolman "
    "lange keines dafür hatte. Seit Version 0.27 hat Spoolman ein eigenes "
    "Tag-Modell.\n\n"
    "Hier wird bestimmt, wohin die Waage schreibt. Kann der Server das native "
    "Modell, wählt sie es beim ersten Scan von selbst - eine Auswahl, die du "
    "selbst getroffen hast, bleibt stehen.\n\n"
    "Gelesen wird immer aus allen Quellen, damit beim Umstellen keine Spule "
    "unsichtbar wird. Beim nächsten Verknüpfen wandert eine anderswo gefundene "
    "UID in die gewählte Quelle.\n\n"
    "Fehlt das gewählte Extra-Feld auf dem Server, legt die Waage es beim "
    "ersten Schreiben selbst an. Für Spoolman NFC ist kein Feld nötig.",
    "Every project puts the tag UID in a different extra field, because "
    "Spoolman had none for it for a long time. Since version 0.27 Spoolman has "
    "a tag model of its own.\n\n"
    "This is where you say what the scale writes to. On a server that has the "
    "native model it picks that by itself on the first scan; a choice you made "
    "yourself is left alone.\n\n"
    "Every source is always read, so nothing goes missing when you switch. On "
    "the next link a UID found elsewhere moves into the selected source.\n\n"
    "If the selected extra field is missing on the server, the scale creates "
    "it on the first write. Spoolman NFC needs no field.",
    "Chaque logiciel range l'identifiant (UID) du tag dans son propre champ supplémentaire, car Spoolman n'en a longtemps proposé aucun. Depuis la version 0.27, Spoolman a sa propre gestion des tags.\n\nCe réglage indique où la balance écrit. Si le serveur gère les tags nativement, elle choisit cette gestion d'elle-même au premier tag lu, sauf si vous avez déjà fait votre choix.\n\nToutes les sources sont toujours lues, pour qu'aucune bobine ne devienne introuvable si vous changez de source. Quand vous liez à nouveau une bobine, son UID trouvé ailleurs passe dans la source choisie.\n\nSi le champ choisi manque sur le serveur, la balance le crée à la première écriture. Spoolman NFC n'a besoin d'aucun champ." },  // STR_TAG_FIELD_INFO

  { "Spoolman NFC (nativ)",   "Spoolman NFC (native)",    "Spoolman NFC (natif)" },  // STR_TF_NATIVE
  { "Vom Server unterstützt", "Supported by the server",  "Pris en charge par le serveur" },  // STR_TF_NATIVE_SUB
  { "Erst ab Spoolman v0.27", "Spoolman v0.27 and later", "À partir de Spoolman v0.27" },  // STR_TF_NATIVE_NA
  { "Spoolman hat seit Version 0.27 ein eigenes Tag-Modell, statt einer UID in "
    "einem Extra-Feld. Diese Zeile ist wählbar, sobald der Server es kann.\n\n"
    "Was es besser macht: eine Spule kann mehrere Tags tragen, ohne Liste in "
    "einem Textfeld. Ein Scan ist eine einzige Anfrage, die die Spule gleich "
    "mitliefert, statt Suche plus Nachprüfung. Und ein Tag, der schon an einer "
    "anderen Spule hängt, wird als solcher gemeldet statt still "
    "überschrieben.\n\n"
    "Die Extra-Felder bleiben trotzdem wählbar: SpoolLink, SpoolSense und "
    "FilaMan schreiben weiter ihre eigenen, und wer eines davon parallel "
    "betreibt, braucht es.",
    "Since version 0.27 Spoolman has a tag model of its own, instead of a UID "
    "in an extra field. This entry is selectable once the server has it.\n\n"
    "What it does better: a spool can hold several tags with no list squeezed "
    "into a text field. A scan is one request that returns the spool with it, "
    "rather than a search plus a verification pass. And a tag that already "
    "belongs to another spool is reported as such instead of being silently "
    "overwritten.\n\n"
    "The extra fields stay selectable regardless: SpoolLink, SpoolSense and "
    "FilaMan keep writing their own, and anyone running one of them alongside "
    "still needs it.",
    "Depuis la version 0.27, Spoolman gère les tags lui-même, au lieu d'un UID dans un champ supplémentaire. Cette ligne est sélectionnable dès que le serveur le permet.\n\nAvantages : une bobine peut porter plusieurs tags, sans liste tassée dans un champ texte. Lire un tag ne demande qu'une requête, qui renvoie directement la bobine, au lieu d'une recherche puis d'une vérification. Et un tag déjà lié à une autre bobine est signalé, au lieu d'être écrasé sans prévenir.\n\nLes champs supplémentaires restent malgré tout sélectionnables : SpoolLink, SpoolSense et FilaMan continuent d'écrire dans les leurs, et si vous utilisez l'un d'eux en parallèle, il vous faut son champ." },  // STR_TF_NATIVE_INFO
  { "extra.tag",                 "extra.tag",                "extra.tag" },  // STR_TF_TAG
  { "Diese Waage, OpenSpoolman", "This scale, OpenSpoolman", "Cette balance, OpenSpoolman" },  // STR_TF_TAG_SUB
  { "Das Feld, das diese Waage seit jeher benutzt, und das auch OpenSpoolman "
    "und spoolnymous schreiben.\n\n"
    "Ein Wert pro Spule, kein Listenformat. Die Waage legt die UID so ab, wie "
    "sie sie liest - als reines Hex ohne Trenner, bei Bambu-Tags die tray_uuid. "
    "OpenSpoolman legt dort eine eigene UUID ab, die Feldbelegung ist also "
    "gleich, der Inhalt nicht zwingend.\n\n"
    "Die richtige Wahl, wenn nichts dagegen spricht.",
    "The field this scale has always used, and the one OpenSpoolman and "
    "spoolnymous write as well.\n\n"
    "One value per spool, no list format. The scale stores the UID the way it "
    "reads it, as plain hex without separators, and the tray_uuid for Bambu tags. OpenSpoolman "
    "puts a UUID of its own in there, so the field matches but the contents "
    "need not.\n\n"
    "The right choice unless something speaks against it.",
    "Le champ que cette balance utilise depuis toujours, et où écrivent aussi OpenSpoolman et spoolnymous.\n\nUne seule valeur par bobine, pas de liste. La balance y écrit l'UID en hexadécimal majuscule sans séparateur (la tray_uuid pour un tag Bambu). OpenSpoolman y range son propre identifiant (UUID) : même champ, mais pas forcément même contenu.\n\nLe bon choix, sauf raison contraire." },  // STR_TF_TAG_INFO

  { "extra.nfc_id",                     "extra.nfc_id",                     "extra.nfc_id" },  // STR_TF_NFCID
  { "FilaMan, nfc2klipper, SpoolSense", "FilaMan, nfc2klipper, SpoolSense",
    "FilaMan, nfc2klipper, SpoolSense" },  // STR_TF_NFCID_SUB
  { "Das Feld, auf das sich FilaMan, nfc2klipper und SpoolSense geeinigt "
    "haben.\n\n"
    "Ein Wert pro Spule, kein Listenformat. Erwartet wird reines Hex in "
    "Großbuchstaben ohne Trenner - die Waage schreibt hier also "
    "04A1B2C3D4E5F6 statt 04:A1:B2:C3:D4:E5:F6, sonst finden die anderen "
    "Programme die UID nicht.\n\n"
    "Sinnvoll, wenn eines davon parallel auf dieselbe Spoolman-Datenbank "
    "zugreift.",
    "The field FilaMan, nfc2klipper and SpoolSense settled on.\n\n"
    "One value per spool, no list format. It expects plain uppercase hex "
    "without separators, so the scale writes 04A1B2C3D4E5F6 rather than "
    "04:A1:B2:C3:D4:E5:F6 - otherwise the other tools will not find the "
    "UID.\n\n"
    "Useful when one of them works on the same Spoolman database.",
    "Le champ sur lequel FilaMan, nfc2klipper et SpoolSense se sont accordés.\n\nUne seule valeur par bobine, pas de liste. Ces logiciels attendent de l'hexadécimal majuscule sans séparateur : la balance écrit donc 04A1B2C3D4E5F6 et non 04:A1:B2:C3:D4:E5:F6, sinon ils ne trouveraient pas l'UID.\n\nUtile si l'un d'eux accède en parallèle à la même base Spoolman." },  // STR_TF_NFCID_INFO

  { "extra.card_uids",         "extra.card_uids",         "extra.card_uids" },  // STR_TF_CARDUIDS
  { "SpoolLink, Snapmaker U1", "SpoolLink, Snapmaker U1", "SpoolLink, Snapmaker U1" },  // STR_TF_CARDUIDS_SUB
  { "Das Feld, das SpoolLink in der Snapmaker-Firmware und Spool Studio "
    "benutzen.\n\n"
    "Das einzige Extra-Feld, das eine Liste aufnimmt: mehrere UIDs, "
    "kommagetrennt, reines Hex in Großbuchstaben. Beim Snapmaker U1 ist das "
    "die Regel, weil eine Spule je ein Tag pro Flansch trägt und auf beide "
    "Seiten des Druckers passen muss.\n\n"
    "Von den Extra-Feldern lässt nur dieses die Option \"Mehrere Tags "
    "verknüpfen\" zu. Spoolman NFC kann das ebenfalls und braucht keinen "
    "Schalter dafür, weil mehrere Tags dort der Normalfall sind statt eines "
    "Formats in einem Textfeld. Wer die Wahl hat, nimmt Spoolman NFC - dieses "
    "Feld ist die richtige Wahl, wenn SpoolLink daneben laufen soll.",
    "The field SpoolLink in the Snapmaker firmware and Spool Studio use.\n\n"
    "The only extra field that holds a list: several UIDs, comma separated, "
    "plain uppercase hex. On the Snapmaker U1 that is the rule, because a "
    "spool carries one tag per flange so it fits either side of the "
    "printer.\n\n"
    "Of the extra fields only this one allows \"Link multiple tags\". Spoolman "
    "NFC can do it too and needs no switch, because several tags are the "
    "normal case there rather than a format squeezed into a text field. Given "
    "the choice, take Spoolman NFC - this field is the right one when "
    "SpoolLink is to run alongside.",
    "Le champ qu'utilisent SpoolLink (firmware Snapmaker) et Spool Studio.\n\nLe seul champ supplémentaire qui accepte une liste : plusieurs UID séparés par des virgules, en hexadécimal majuscule. C'est la règle sur le Snapmaker U1 : une bobine porte un tag par flasque, pour se monter d'un côté comme de l'autre de l'imprimante.\n\nParmi les champs supplémentaires, seul celui-ci permet l'option « Lier plusieurs tags ». Spoolman NFC le permet aussi, sans cette option, car plusieurs tags y sont la norme et non un format tassé dans un champ texte. Si vous avez le choix, prenez Spoolman NFC ; ce champ convient si SpoolLink doit tourner en parallèle." },  // STR_TF_CARDUIDS_INFO

  { "Trocknungsdatum", "Drying date", "Date de séchage" },  // STR_EF_LAST_DRIED
  { "Wann die Spule zuletzt getrocknet wurde. Spoolman hat dafür kein eigenes "
    "Feld, deshalb schreibt die Waage es nach extra.last_dried.\n\n"
    "Fehlt das Feld, legt die Waage es beim ersten Speichern einer Trocknung "
    "selbst an.",
    "When the spool was last dried. Spoolman has no field of its own for it, "
    "so the scale writes it to extra.last_dried.\n\n"
    "If the field is missing, the scale creates it the first time a drying is "
    "saved.",
    "Date du dernier séchage de la bobine. Spoolman n'a pas de champ pour cela : la balance l'écrit donc dans extra.last_dried.\n\nS'il manque, la balance le crée au premier séchage enregistré." },  // STR_EF_LAST_DRIED_INFO

  { "vorhanden",                   "present",                        "présent" },  // STR_EF_PRESENT
  { "fehlt auf dem Server",        "missing on the server",          "absent du serveur" },  // STR_EF_MISSING
  { "Feld auf dem Server anlegen", "Create the field on the server",
    "Créer le champ sur le serveur" },  // STR_EF_CREATE_ROW
  { "Lade Spulen ...", "Loading spools ...",
    "Chargement des bobines ..." },  // STR_LOADING_SPOOLS
  { "%d Spulen, sortiere ...", "%d spools, sorting ...",
    "%d bobines, tri en cours ..." },  // STR_LOADING_FILTER

  // ── Web interface ─────────────────────────────────────
  { "Status",
    "Status",
    "État" },  // STR_W_NAV_STATUS
  { "Backend",
    "Backend",
    "Backend" },  // STR_W_NAV_BACKEND
  { "Trocknung",
    "Drying",
    "Séchage" },  // STR_W_NAV_DRYING
  { "Tags",
    "Tags",
    "Tags" },  // STR_W_NAV_TAGS
  { "Einstellungen",
    "Settings",
    "Réglages" },  // STR_W_NAV_SETTINGS
  { "Logs",
    "Logs",
    "Journaux" },  // STR_W_NAV_LOGS
  { "Firmware",
    "Firmware",
    "Firmware" },  // STR_W_NAV_FIRMWARE
  { "Unabhängig von Spoolman, FilaMan und BamBuddy - Open-Source-Projekt",
    "Not affiliated with Spoolman, FilaMan or BamBuddy - Open Source Project",
    "Sans lien avec Spoolman, FilaMan ou BamBuddy - projet open source" },  // STR_W_DISCLAIMER
  { "Speichern",
    "Save",
    "Enregistrer" },  // STR_W_SAVE
  { "Gespeichert",
    "Saved",
    "Enregistré" },  // STR_W_SAVED
  { "Fehler",
    "Error",
    "Erreur" },  // STR_W_ERROR
  { "Auf Standard zurück",
    "Reset to defaults",
    "Rétablir les valeurs par défaut" },  // STR_W_DEFAULTS
  { "%s ist ausgeschaltet",
    "%s is switched off",
    "%s est désactivé" },  // STR_W_OFF_TITLE
  { "Dieser Bereich ist am Gerät abgeschaltet und wird deshalb nicht ausgeliefert.",
    "This section is disabled on the device, so it is not being served.",
    "Cette section est désactivée sur l'appareil, elle n'est donc pas servie." },  // STR_W_OFF_BODY
  { "Hier einschalten:",
    "Turn it on here:",
    "Activez-la ici :" },  // STR_W_OFF_WHERE
  { "Einstellungen &rsaquo; System &rsaquo; Weboberfläche",
    "Settings &rsaquo; System &rsaquo; Web interface",
    "Réglages &rsaquo; Système &rsaquo; Interface web" },  // STR_W_OFF_PATH
  { "Danach diese Seite neu laden.",
    "Then reload this page.",
    "Rechargez ensuite cette page." },  // STR_W_OFF_RELOAD
  { "Zurück zum Status",
    "Back to status",
    "Retour à l'état" },  // STR_W_BACK_STATUS
  { "Netzwerk",
    "Network",
    "Réseau" },  // STR_W_C_NETWORK
  { "Hardware",
    "Hardware",
    "Matériel" },  // STR_W_C_HARDWARE
  { "Bestandsverwaltung",
    "Inventory",
    "Gestion des stocks" },  // STR_W_C_INVENTORY
  { "Zugriff",
    "Access",
    "Accès" },  // STR_W_C_ACCESS
  { "Gerät",
    "Device",
    "Appareil" },  // STR_W_C_DEVICE
  { "WLAN",
    "WiFi",
    "WiFi" },  // STR_W_R_WIFI
  { "Adresse",
    "Address",
    "Adresse" },  // STR_W_R_ADDRESS
  { "Name",
    "Name",
    "Nom" },  // STR_W_R_NAME
  { "Gateway",
    "Gateway",
    "Passerelle" },  // STR_W_R_GATEWAY
  { "Waage",
    "Scale",
    "Balance" },  // STR_W_R_SCALE
  { "NFC-Leser",
    "NFC reader",
    "Lecteur NFC" },  // STR_W_R_NFC
  { "SD-Karte",
    "SD card",
    "Carte SD" },  // STR_W_R_SD
  { "Laufzeit",
    "Uptime",
    "Durée de marche" },  // STR_W_R_UPTIME
  { "Backend",
    "Backend",
    "Backend" },  // STR_W_R_BACKEND
  { "Erreichbar",
    "Reachable",
    "Joignable" },  // STR_W_R_REACHABLE
  { "Tags gescannt",
    "Tags scanned",
    "Tags scannés" },  // STR_W_R_SCANS
  { "bereit",
    "ready",
    "en service" },  // STR_W_S_READY
  { "fehlt",
    "missing",
    "introuvable" },  // STR_W_S_MISSING
  { "an",
    "on",
    "oui" },  // STR_W_S_ON
  { "aus",
    "off",
    "non" },  // STR_W_S_OFF
  { "ja",
    "yes",
    "oui" },  // STR_W_S_YES
  { "nein",
    "no",
    "non" },  // STR_W_S_NO
  { "nicht verbunden",
    "not connected",
    "hors ligne" },  // STR_W_S_NOWIFI
  { "Was ausgeschaltet ist, wird nicht ausgeliefert - auch die Endpunkte dahinter nicht. Umschalten am Gerät unter",
    "A section that is off is not served at all, and neither are the endpoints behind it. Switch it on the device under",
    "Une section désactivée est totalement inaccessible, y compris par ses adresses d'API. Se règle sur l'appareil, dans" },  // STR_W_ACCESS_NOTE
  { "Neu starten",
    "Restart",
    "Redémarrer" },  // STR_W_RESTART
  { "Alle Einstellungen liegen im NVS, ein Neustart verliert nichts.",
    "Settings are kept in NVS, so a restart loses nothing.",
    "Tous les réglages restent en mémoire permanente : un redémarrage n'en perd aucun." },  // STR_W_RESTART_NOTE
  { "Gerät jetzt neu starten?",
    "Restart the device now?",
    "Redémarrer l'appareil maintenant ?" },  // STR_W_RESTART_ASK
  { "Startet neu",
    "Restarting",
    "Redémarrage" },  // STR_W_RESTARTING
  { "warte auf das Gerät",
    "waiting for the device",
    "attente de l'appareil" },  // STR_W_RESTART_WAIT
  { " (SD-Karte steckt, der Start dauert rund 20 s länger)",
    " (SD card fitted, boot takes about 20s longer)",
    " (carte SD présente, le démarrage prend environ 20 s de plus)" },  // STR_W_RESTART_SD
  { "immer noch am Warten",
    "still waiting",
    "toujours en attente" },  // STR_W_RESTART_LONG
  { "Das Gerät hat nicht geantwortet. Vielleicht ist es nicht mehr im Netz -",
    "The device has not answered. It may be off the network -",
    "L'appareil n'a pas répondu. Il n'est peut-être plus sur le réseau -" },  // STR_W_RESTART_GONE
  { "neu laden",
    "reload",
    "recharger" },  // STR_W_RELOAD
  { "Adresse",
    "Address",
    "Adresse" },  // STR_W_C_BACKEND_ADDR
  { "Adresse des Backends",
    "Backend address",
    "Adresse du backend" },  // STR_W_HOST_LABEL
  { "Hostname oder IP, bei Bedarf mit Port. Ein Name funktioniert auch hinter einem Reverse Proxy, wo die IP allein nicht ans Ziel führt.",
    "Host name or IP, with a port when one is needed. A name also works behind a reverse proxy, where the IP alone does not reach the target.",
    "Nom d'hôte ou adresse IP, avec le port si besoin. Un nom fonctionne aussi derrière un proxy inverse, où l'adresse IP seule ne mène pas au serveur visé." },  // STR_W_HOST_HINT
  { "Ohne Port geht es auf 80. Üblich sind Spoolman 7912, FilaMan 8083, BamBuddy 8000.",
    "Without a port this goes to 80. The usual ones are Spoolman 7912, FilaMan 8083, BamBuddy 8000.",
    "Sans port indiqué, le port 80 est utilisé. Ports habituels : Spoolman 7912, FilaMan 8083, BamBuddy 8000." },  // STR_W_HOST_PORTHINT
  { "Die Adresse darf nicht leer sein.",
    "The address cannot be empty.",
    "L'adresse ne peut pas être vide." },  // STR_W_HOST_EMPTY
  { "https wird noch nicht unterstützt. Die Waage spricht nur http.",
    "https is not supported yet. The scale speaks plain http only.",
    "https n'est pas encore pris en charge. La balance ne parle que http." },  // STR_W_HOST_HTTPS
  { "Verbinde ...",
    "Connecting ...",
    "Connexion ..." },  // STR_W_HOST_TESTING
  { "Erreichbar",
    "Reachable",
    "Joignable" },  // STR_W_HOST_OK
  { "Nicht erreichbar",
    "Not reachable",
    "Injoignable" },  // STR_W_HOST_FAIL
  { "Zugangsdaten",
    "Credentials",
    "Identifiants" },  // STR_W_C_CREDS
  { "API-Key",
    "API key",
    "Clé d'API" },  // STR_W_APIKEY
  { "Gerätecode",
    "Device code",
    "Code d'appareil" },  // STR_W_DEVICE_CODE
  { "Registrieren",
    "Register",
    "Associer l'appareil" },  // STR_W_REGISTER
  { "hinterlegt",
    "set",
    "en mémoire" },  // STR_W_SET
  { "fehlt",
    "missing",
    "à définir" },  // STR_W_UNSET
  { "Spoolman braucht keine Zugangsdaten.",
    "Spoolman needs no credentials.",
    "Spoolman n'a besoin d'aucun identifiant." },  // STR_W_NO_CREDS
  { "Schwellwerte je Material",
    "Thresholds per material",
    "Seuils par matériau" },  // STR_W_C_DRYING
  { "Material",
    "Material",
    "Matériau" },  // STR_W_DRY_MATERIAL
  { "Gelb ab",
    "Amber after",
    "Jaune dès" },  // STR_W_DRY_YELLOW
  { "Rot ab",
    "Red after",
    "Rouge dès" },  // STR_W_DRY_RED
  { "Lagerung",
    "Storage",
    "Stockage" },  // STR_W_DRY_STORAGE
  { "trocken",
    "sealed",
    "sous vide" },  // STR_W_DRY_SEALED
  { "Tage",
    "days",
    "jours" },  // STR_W_DRY_DAYS
  { "Faktor für trockene Lagerung",
    "Multiplier for sealed storage",
    "Facteur pour un stockage sous vide" },  // STR_W_DRY_MULT
  { "Luftdicht gelagert hält Filament länger. Die Schwellwerte oben werden für diese Materialien mit dem Faktor multipliziert.",
    "Filament stored airtight lasts longer. The thresholds above are multiplied by this factor for those materials.",
    "Stocké à l'abri de l'air, le filament se conserve plus longtemps. Pour les matériaux marqués « sous vide », les seuils ci-dessus sont multipliés par ce facteur." },  // STR_W_DRY_MULT_HINT
  { "Gerätename",
    "Device name",
    "Nom de l'appareil" },  // STR_W_C_DEVNAME
  { "Name oder ganze Adresse, zum Beispiel scale.home.arpa. Der Teil vor dem ersten Punkt ist auch der Name, den der Router zeigt.",
    "A name, or a whole address such as scale.home.arpa. The part before the first dot is also the name your router shows.",
    "Un nom, ou une adresse complète comme scale.home.arpa. La partie avant le premier point est aussi le nom que votre routeur affiche." },  // STR_W_DEVNAME_HINT
  { "Buchstaben, Ziffern und Bindestriche, durch Punkte getrennt. Kein Bindestrich am Anfang oder Ende, keine Leerzeichen, kein leerer Teil zwischen zwei Punkten.",
    "Letters, digits and hyphens, separated by dots. No hyphen at the start or end, no spaces, no empty part between two dots.",
    "Lettres, chiffres et traits d'union, séparés par des points. Pas de trait d'union au début ni à la fin, pas d'espace, aucune partie vide entre deux points." },  // STR_W_DEVNAME_BAD
  { "Jetzt erreichbar unter %s - beim Router nach dem nächsten Verbinden.",
    "Reachable now at %s - the router shows it after the next connection.",
    "Joignable maintenant à %s - le routeur l'affiche après la prochaine connexion." },  // STR_W_DEVNAME_NOW
  { "Listenlimits",
    "List limits",
    "Limites de liste" },  // STR_W_C_LIMITS
  { "Spulenliste",
    "Spool list",
    "Liste des bobines" },  // STR_W_LIMIT_SPOOLS
  { "Standortliste",
    "Location list",
    "Liste des emplacements" },  // STR_W_LIMIT_LOCS
  { "Wie viele Einträge die Auswahl am Gerät zeigt.",
    "How many entries the picker on the device shows.",
    "Nombre maximal d'entrées affichées dans la liste de l'appareil." },  // STR_W_LIMIT_HINT
  { "Zu viele Einträge lassen die Anzeige einfrieren - ein Neustart erfolgt nicht von selbst.",
    "Too many entries freeze the display - it does not reboot by itself.",
    "Trop d'entrées figent l'affichage - et l'appareil ne redémarre pas de lui-même." },  // STR_W_LIMIT_WARN
  { "Anzeige",
    "Display",
    "Affichage" },  // STR_W_C_DISPLAY
  { "Helligkeitsanhebung",
    "Brightness lift",
    "Renfort de luminosité" },  // STR_W_GAIN
  { "100 ist aus. Die Hintergrundbeleuchtung ist bei 255 schon am Anschlag, das hier ist der verbleibende Hebel auf ein dunkles Panel.",
    "100 is off. The backlight is already at its ceiling at 255, so this is the only remaining lever on a dim panel.",
    "À 100, aucun renfort. Le rétroéclairage plafonne déjà à 255 : ce renfort reste le seul moyen d'éclaircir un écran trop sombre." },  // STR_W_GAIN_HINT
  { "Tag beschreiben",
    "Write a tag",
    "Écrire un tag" },  // STR_W_C_WRITETAG
  { "Spule",
    "Spool",
    "Bobine" },  // STR_W_TAG_SPOOL
  { "-- Spule wählen --",
    "-- pick a spool --",
    "-- choisir une bobine --" },  // STR_W_TAG_PICK
  { "Auf dem Tag",
    "On the tag",
    "Sur le tag" },  // STR_W_TAG_ONTAG
  { "Würde geschrieben",
    "Will be written",
    "Sera écrit" },  // STR_W_TAG_WILLBE
  { "Kein Tag auf dem Leser.",
    "No tag on the reader.",
    "Aucun tag sur le lecteur." },  // STR_W_TAG_NOTAG
  { "Tag auf dem Leser:",
    "Tag on the reader:",
    "Tag sur le lecteur :" },  // STR_W_TAG_ONREADER
  { "Erst eine Spule wählen.",
    "Pick a spool first.",
    "Choisissez d'abord une bobine." },  // STR_W_TAG_PICKFIRST
  { "Leerer Tag",
    "Blank tag",
    "Tag vierge" },  // STR_W_TAG_BLANK
  { "Daten, die diese Firmware nicht lesen kann",
    "Data this firmware cannot read",
    "Données que ce firmware ne sait pas lire" },  // STR_W_TAG_UNKNOWN
  { "Tag beschreiben",
    "Write tag",
    "Écrire le tag" },  // STR_W_TAG_WRITE
  { "Tag überschreiben",
    "Overwrite tag",
    "Écraser le tag" },  // STR_W_TAG_OVERWRITE
  { "Tag stimmt bereits überein",
    "Tag already matches",
    "Le tag correspond déjà" },  // STR_W_TAG_MATCHES
  { "Tag leeren",
    "Erase tag",
    "Vider le tag" },  // STR_W_TAG_ERASE
  { "Alles auf diesem Tag löschen?",
    "Erase everything on this tag?",
    "Effacer tout ce qui est sur ce tag ?" },  // STR_W_TAG_ERASE_ASK
  { "Spule mit diesem Tag verknüpfen",
    "Link the spool to this tag",
    "Lier la bobine à ce tag" },  // STR_W_TAG_LINK
  { "Diese Spule hängt an %s, das damit zum vorherigen Tag wird.",
    "This spool is linked to %s, which becomes its previous tag.",
    "Cette bobine est liée à %s, qui devient son tag précédent." },  // STR_W_TAG_RELINK
  { "Eingereiht.",
    "Queued.",
    "En file d'attente." },  // STR_W_TAG_QUEUED
  { "Spulenliste nicht verfügbar",
    "Spool list unavailable",
    "Liste indisponible" },  // STR_W_TAG_NOLIST
  { "SKU",
    "SKU",
    "Référence" },  // STR_W_TAG_SKU
  { "Düse",
    "Nozzle",
    "Buse" },  // STR_W_TAG_NOZZLE
  { "Bett",
    "Bed",
    "Plateau" },  // STR_W_TAG_BED
  { "Gewicht",
    "Weight",
    "Poids" },  // STR_W_TAG_WEIGHT
  { "Durchmesser",
    "Diameter",
    "Diamètre" },  // STR_W_TAG_DIA
  { "Länge",
    "Length",
    "Longueur" },  // STR_W_TAG_LENGTH
  { "Links steht, was gerade auf dem Tag liegt, rechts, was die gewählte Spule ergäbe. Abweichende Zeilen sind farbig.",
    "On the left what the tag holds right now, on the right what the selected spool would put there. Lines that differ are coloured.",
    "À gauche, ce que le tag contient en ce moment ; à droite, ce que la bobine choisie y mettrait. Les lignes qui diffèrent sont en couleur." },  // STR_W_TAG_COMPARE
  { "SD-Karte",
    "SD card",
    "Carte SD" },  // STR_W_C_LOGS
  { "Ansehen",
    "View",
    "Voir" },  // STR_W_LOG_VIEW
  { "Löschen",
    "Delete",
    "Supprimer" },  // STR_W_LOG_DELETE
  { "Diese Datei löschen?",
    "Delete this file?",
    "Supprimer ce fichier ?" },  // STR_W_LOG_DELETE_ASK
  { "Keine SD-Karte erkannt",
    "No SD card detected",
    "Aucune carte SD détectée" },  // STR_W_LOG_NOSD
  { "Eine FAT32-formatierte Karte einlegen, um die Diagnoseprotokolle zu aktivieren.",
    "Insert a FAT32 formatted card to enable diagnostic logging.",
    "Insérez une carte formatée en FAT32 pour activer les journaux de diagnostic." },  // STR_W_LOG_NOSD_HINT
  { "Noch keine Protokolle.",
    "No logs yet.",
    "Aucun journal pour l'instant." },  // STR_W_LOG_EMPTY
  { "Firmware",
    "Firmware",
    "Firmware" },  // STR_W_C_FIRMWARE
  { "Installiert",
    "Installed",
    "Version installée" },  // STR_W_FW_INSTALLED
  { "Datei hochladen",
    "Upload a file",
    "Envoyer un fichier" },  // STR_W_FW_FILE
  { "Flashen",
    "Flash",
    "Flasher" },  // STR_W_FW_FLASH
  { "Das Gerät startet nach dem Schreiben von selbst neu. Strom nicht trennen.",
    "The device restarts by itself once written. Do not cut the power.",
    "Après l'écriture du firmware, l'appareil redémarre de lui-même. Ne coupez pas l'alimentation." },  // STR_W_FW_HINT
  { "Update erfolgreich",
    "Update successful",
    "Mise à jour réussie" },  // STR_W_FW_OK
  { "Das Gerät startet neu ...",
    "Device is restarting ...",
    "L'appareil redémarre ..." },  // STR_W_FW_RESTARTING
  { "Update fehlgeschlagen",
    "Update failed",
    "Échec de la mise à jour" },  // STR_W_FW_FAIL
  { "Bitte erneut versuchen.",
    "Please try again.",
    "Veuillez réessayer." },  // STR_W_FW_RETRY
  { "Update über GitHub",
    "Update from GitHub",
    "Mise à jour par GitHub" },  // STR_W_C_FW_GITHUB
  { "Kanal",
    "Channel",
    "Canal" },  // STR_W_FW_CHANNEL
  { "Release",
    "Release",
    "Version stable" },  // STR_W_FW_CH_STABLE
  { "Vorabversion",
    "Pre-release",
    "Pré-version" },  // STR_W_FW_CH_PRE
  { "Neueste",
    "Latest",
    "Dernière version" },  // STR_W_FW_LATEST
  { "Nach Updates suchen",
    "Check for updates",
    "Rechercher des mises à jour" },  // STR_W_FW_CHECK
  { "Suche ...",
    "Checking ...",
    "Recherche ..." },  // STR_W_FW_CHECKING
  { "Bereits aktuell",
    "Already up to date",
    "Déjà à jour" },  // STR_W_FW_UPTODATE
  { "Update verfügbar",
    "Update available",
    "Mise à jour disponible" },  // STR_W_FW_AVAIL
  { "Installieren",
    "Install",
    "Installer" },  // STR_W_FW_INSTALL
  { "Wird installiert ...",
    "Installing ...",
    "Installation ..." },  // STR_W_FW_INSTALLING
  { "Kein WLAN",
    "No WiFi connection",
    "Pas de connexion WiFi" },  // STR_W_FW_NOWIFI
  { "Das Gerät prüft oder schreibt gerade",
    "The device is already checking or writing",
    "L'appareil est déjà en train de chercher ou d'écrire" },  // STR_W_FW_BUSY
  { "Suche fehlgeschlagen",
    "Check failed",
    "Échec de la recherche" },  // STR_W_FW_CHECK_FAIL
  { "Der Kanal ist derselbe wie am Gerät. Das Image wird vom Gerät geladen, nicht vom Browser.",
    "The channel is the same setting as on the device. The image is fetched by the device, not by this browser.",
    "Le canal est le même réglage que sur l'appareil. C'est l'appareil qui télécharge le firmware, pas ce navigateur." },  // STR_W_FW_GH_HINT
  { "Veröffentlicht",
    "Released",
    "Publiée le" },  // STR_W_FW_RELEASED
  { "Installiert am",
    "Installed on",
    "Installée le" },  // STR_W_FW_SINCE
  { "Release Notes",
    "Release notes",
    "Notes de version" },  // STR_W_FW_NOTES
  { "Was ist neu",
    "What is new",
    "Nouveautés" },  // STR_W_FW_WHATSNEW
  { "Nicht als Release veröffentlicht",
    "Not a published release",
    "Version non publiée" },  // STR_W_FW_UNPUBLISHED
  { "unbekannt",
    "unknown",
    "inconnue" },  // STR_W_FW_UNKNOWN
  { "Ausblenden",
    "Hide",
    "Masquer" },  // STR_W_FW_HIDE
  { "{v} installieren?",
    "Install {v}?",
    "Installer {v} ?" },  // STR_W_FW_CONFIRM
  { "Das Gerät startet nach dem Download automatisch neu, die Seite lädt sich dann selbst. Strom nicht trennen.",
    "The device restarts by itself when the download finishes, and this page reloads. Do not cut the power.",
    "L'appareil redémarre tout seul à la fin du téléchargement, et cette page se recharge. Ne coupez pas l'alimentation." },  // STR_W_FW_REBOOTS
  { "Ältere Version",
    "Older release",
    "Version plus ancienne" },  // STR_W_FW_OLDER
  { "Auf {v} zurückstufen?",
    "Downgrade to {v}?",
    "Revenir à {v} ?" },  // STR_W_FW_DOWNGRADE
  { "{v} ist älter als die installierte {i}.",
    "{v} is older than the installed {i}.",
    "{v} est plus ancienne que la version installée {i}." },  // STR_W_FW_DOWNWARN
  { "Gewicht",
    "Weight",
    "Poids" },  // STR_W_R_WEIGHT
  { "Konnte nicht geladen werden.",
    "Could not be loaded.",
    "Chargement impossible." },  // STR_W_LOAD_FAIL
  { "Jede Zeile auf der Karte ist ein eigener Schreibzugriff. Läuft alles rund, lässt sich das Protokoll oben abschalten, ohne die Karte zu ziehen. Das Sitzungsprotokoll weiter unten läuft immer weiter.",
    "Every line on the card is a write of its own. When everything runs fine, switch the log off above instead of pulling the card. The session log further down keeps running either way.",
    "Chaque ligne du journal est une écriture distincte sur la carte. Quand tout fonctionne bien, désactivez le journal ci-dessus plutôt que de retirer la carte. Le journal de session, plus bas, continue dans tous les cas." },  // STR_W_LOG_NOTE
  { "Sitzungsprotokoll",
    "Session log",
    "Journal de session" },  // STR_W_C_SESSION
  { "Die letzten Zeilen seit dem Start, im Arbeitsspeicher gehalten und beim Neustart weg. Eine SD-Karte braucht es nur, um Protokolle zu behalten.",
    "The last lines since start, held in memory and gone on restart. An SD card is only needed to keep logs, not to have them.",
    "Les dernières lignes du journal depuis le démarrage, gardées en mémoire vive et perdues à chaque redémarrage. Une carte SD n'est nécessaire que pour conserver les journaux." },  // STR_W_SESSION_NOTE
  { "Noch nichts protokolliert.",
    "Nothing logged yet.",
    "Rien de journalisé pour l'instant." },  // STR_W_SESSION_EMPTY
  { "Aktualisieren",
    "Refresh",
    "Actualiser" },  // STR_W_SESSION_REFRESH
  { "Wird geladen...",
    "Loading...",
    "Chargement..." },  // STR_W_SESSION_BUSY
  { "Geholt um",
    "Fetched at",
    "Récupéré à" },  // STR_W_SESSION_UPDATED
  { "Zeilen",
    "lines",
    "lignes" },  // STR_W_SESSION_LINES
  { "Angehalten, zum Weiterlesen auf Aktualisieren tippen",
    "Paused, press refresh to follow again",
    "En pause, touchez Actualiser pour reprendre le suivi" },  // STR_W_SESSION_PAUSED
  { "neu",
    "new",
    "nouvelles" },  // STR_W_SESSION_NEW
  { "Text kopieren",
    "Copy text",
    "Copier" },  // STR_W_SESSION_COPY
  { "Kopiert",
    "Copied",
    "Copié" },  // STR_W_SESSION_COPIED
  { "Kopieren nicht möglich, bitte markieren",
    "Cannot copy, please select the text",
    "Copie impossible, sélectionnez le texte" },  // STR_W_SESSION_COPYFAIL
  { "Einen beschreibbaren NTAG auflegen, Spule wählen, schreiben. Was auf dem Tag steht, wird ersetzt. Tags ab Werk sind meist MIFARE Classic oder gesperrt und lassen sich nur lesen.",
    "Place a writable NTAG on the reader, pick a spool, and write it. Whatever is already on the tag is replaced. Factory tags are usually MIFARE Classic or locked, and can only be read.",
    "Posez un NTAG inscriptible sur le lecteur, choisissez une bobine, puis cliquez sur Écrire le tag. Tout ce que contient déjà le tag est remplacé. Les tags posés en usine sont le plus souvent des MIFARE Classic ou sont verrouillés : ils ne peuvent qu'être lus." },  // STR_W_TAG_NOTE
  { "<b>Welcher Tag für welches Format.</b> OpenSpool braucht rund 180 Byte und damit einen <b>NTAG215</b> (496 Byte) oder <b>NTAG216</b> (872 Byte). Auf einen NTAG213 (144 Byte) passt davon nichts, dort geht nur Anycubic ACE, das mit 112 Byte auskommt. Meldet ein Tag keine Größe, rechnet die Waage sicherheitshalber mit den 144 Byte eines NTAG213 - dann den Tag einmal mit einer NFC-App als NDEF formatieren, das trägt die Größe ein.",
    "<b>Which tag for which format.</b> OpenSpool needs about 180 bytes, so it wants an <b>NTAG215</b> (496 bytes) or an <b>NTAG216</b> (872 bytes). None of it fits an NTAG213 (144 bytes), which leaves Anycubic ACE, and that needs only 112. A tag that reports no size at all is treated as the 144 bytes of an NTAG213 to stay safe - format such a tag as NDEF once with any NFC app and it will report its real size.",
    "<b>Quel tag pour quel format.</b> OpenSpool a besoin d'environ 180 octets, donc d'un <b>NTAG215</b> (496 octets) ou d'un <b>NTAG216</b> (872 octets). Un NTAG213 (144 octets) est trop petit pour OpenSpool : seul le format Anycubic ACE, qui se contente de 112 octets, y tient. Si un tag n'indique pas sa taille, la balance suppose par prudence qu'il n'a que 144 octets, comme un NTAG213 - dans ce cas, formatez-le une fois en NDEF avec une application NFC, ce qui y inscrit sa taille." },  // STR_W_TAG_SIZES
  { "FilaMan legt beides an verschiedenen Stellen an und zeigt es jeweils nur einmal.<br><b>API-Key:</b> auf das Zahnrad neben dem Benutzernamen klicken, <b>API Keys</b> öffnen und einen Key erstellen. Oben eintragen und speichern.<br><b>Gerätecode:</b> <b>Admin-Bereich &gt; Geräte</b> öffnen und <b>Gerät erstellen</b> klicken. Den sechsstelligen Code oben eintragen und registrieren.<br>Ein Gerät anlegen kann nur ein Admin. Den Key mit demselben Konto erstellen, sonst lehnt FilaMan die AMS-Zuordnung ab.",
    "FilaMan creates the two in different places and shows each only once.<br><b>API key:</b> click the gear icon next to your user name, open <b>API Keys</b> and create a key. Enter it above and save.<br><b>Device code:</b> open <b>Admin Panel &gt; Devices</b> and click <b>Create Device</b>. Enter the six character code above and register.<br>Only an admin can create a device. Create the key with the same account, or FilaMan refuses the AMS assignment.",
    "FilaMan crée la clé et le code à deux endroits différents, et n'affiche chacun qu'une seule fois.<br><b>Clé d'API :</b> cliquez sur l'icône d'engrenage à côté de votre nom d'utilisateur, ouvrez <b>Clés API</b> (API Keys) et créez une clé. Saisissez-la ci-dessus et cliquez sur Enregistrer.<br><b>Code d'appareil :</b> ouvrez <b>Espace admin &gt; Appareils</b> (Admin Panel > Devices) et cliquez sur <b>Créer un appareil</b> (Create Device). Saisissez le code à six caractères ci-dessus, puis cliquez sur Associer l'appareil.<br>Seul un administrateur peut créer un appareil. Créez la clé avec ce même compte, sinon FilaMan refuse l'affectation AMS." },  // STR_W_FM_SETUP
  { "Der Schlüssel steht in BamBuddy unter den Einstellungen. Läuft die Instanz ohne Anmeldung, bleibt das Feld leer.",
    "The key is in BamBuddy under settings. Leave the field empty if the instance runs without authentication.",
    "La clé se trouve dans BamBuddy, dans les réglages. Laissez le champ vide si l'instance tourne sans authentification." },  // STR_W_BB_SETUP
  { "Strom nicht trennen",
    "Do not cut the power",
    "Ne coupez pas l'alimentation" },  // STR_OTA_KEEP_POWER
  { "Kaffee ausgeben",
    "Buy me a coffee",
    "Offrir un café" },  // STR_W_KOFI
  { "Adresse ist ein Name",
    "Address is a name",
    "L'adresse est un nom" },  // STR_SP_LOCKED_TITLE
  { "Dieser Ziffernblock kann nur Zahlen. Die Adresse im Browser ändern:",
    "This keypad can only make numbers. Change the address in the browser:",
    "Cet écran ne permet de saisir que des chiffres. Modifiez l'adresse depuis un navigateur :" },  // STR_SP_LOCKED_INFO
  { "Weboberfläche aus: Einstellungen > System > Weboberfläche",
    "Web interface off: Settings > System > Web interface",
    "Désactivée : Réglages > Système > Interface web" },  // STR_SP_WEB_OFF
  { "Adresse leeren",
    "Clear address",
    "Effacer l'adresse" },  // STR_SP_CLEAR
  { "Adresse verwerfen? Danach ist das Backend nicht mehr eingerichtet, und am Gerät lässt sich nur eine IP eingeben.",
    "Discard the address? The backend is then no longer set up, and the device itself can only enter an IP.",
    "Effacer l'adresse ? Le backend ne sera plus configuré, et sur l'appareil seule une adresse IP pourra être saisie." },  // STR_SP_CLEAR_ASK
  { "Alle löschen",
    "Delete all",
    "Tout supprimer" },  // STR_W_LOG_DELETE_ALL
  { "{n} Dateien löschen? Das Log von heute wird dabei neu begonnen.",
    "Delete {n} files? Today's log is started over.",
    "Supprimer {n} fichiers ? Le journal du jour est recommencé." },  // STR_W_LOG_DELETE_ALL_ASK
  { "{n} Dateien",
    "{n} files",
    "{n} fichiers" },  // STR_W_LOG_COUNT
  // Its own entry rather than a rule in code: which counts need their own
  // wording is a property of the language, not of the list.
  { "1 Datei",
    "1 file",
    "1 fichier" },  // STR_W_LOG_COUNT_ONE
  { "Eine Datei löschen? Das Log von heute wird dabei neu begonnen.",
    "Delete one file? Today's log is started over.",
    "Supprimer un fichier ? Le journal du jour est recommencé." },  // STR_W_LOG_DELETE_ALL_ASK_ONE
  { "Zeitzone",
    "Time zone",
    "Fuseau horaire" },  // STR_TZ_TITLE
  { "Gilt für jeden Zeitstempel des Geräts und für die Zählung der Trocknungstage. Kein Neustart nötig.",
    "Applies to every timestamp the device writes and to the drying day count. No restart needed.",
    "S'applique aux dates et heures notées par l'appareil et au décompte des jours depuis le dernier séchage. Sans redémarrage." },  // STR_TZ_HINT
  { "Gilt für jeden Zeitstempel des Geräts und für die Zählung der Trocknungstage. Wirkt sofort, ohne Neustart.",
    "Applies to every timestamp the device writes and to the drying day count. Takes effect at once, no restart.",
    "S'applique aux dates et heures notées par l'appareil et au décompte des jours depuis le dernier séchage. Effet immédiat, sans redémarrage." },  // STR_W_TZ_NOTE

  { "Felder",
    "Fields",
    "Champs" },  // STR_FLM_FIELDS
  { "wohin der Tag geschrieben wird",
    "where the tag is written",
    "où le tag est écrit" },  // STR_FLM_FIELDS_SUB
  { "FilaMan hat ein eigenes Feld für NFC-Tags, und die Waage benutzt es. Daneben führt das Bambu-Lab-Plugin zwei Felder für die RFID-Chips einer Bambu-Spule und merkt sich die Tray-UUID in external_id.\n\nGelesen werden alle vier, immer und ohne Schalter: eine Spule, die der Drucker kennt, soll die Waage auch erkennen. Geschrieben wird nur, was hier eingeschaltet ist.",
    "FilaMan has a field of its own for NFC tags and the scale uses it. Alongside it the Bambu Lab plugin keeps two fields for the RFID chips of a Bambu spool, and remembers the tray uuid in external_id.\n\nAll four are read, always and without a switch: a spool the printer knows is a spool this scale should recognise. Only what is switched on here is written.",
    "FilaMan possède son propre champ pour les tags NFC, et la balance l'utilise. Le module Bambu Lab gère en outre deux champs pour les puces RFID d'une bobine Bambu, et enregistre son identifiant Tray-UUID dans external_id.\n\nCes quatre champs sont lus dans tous les cas : une bobine connue de l'imprimante doit aussi être reconnue par la balance. Seul ce qui est activé ici est écrit." },  // STR_FLM_FIELDS_INFO

  { "Tag-Feld",
    "Tag field",
    "Champ du tag" },  // STR_FLM_TAGFIELD
  { "Anders als bei Spoolman gibt es hier nichts zu wählen, und das ist gut so. rfid_uid ist FilaMans eigenes Feld für genau diesen Zweck, es ist das einzige, das die Server-Suche durchsucht, und das Bambu-Plugin fasst es laut eigener Zusage nie an.\n\nEin Ausweichfeld würde jeden Scan vom Schnellpfad auf den vollen Inventar-Scan werfen: unter 1 kB gegen 176 kB bei 280 Spulen.",
    "Unlike Spoolman there is nothing to choose here, and that is a good thing. rfid_uid is FilaMan's own field for exactly this, it is the only one the server side search covers, and the Bambu plugin never touches it - its own documentation says so.\n\nWriting somewhere else would drop every scan from the fast path to a full inventory load: under 1 kB against 176 kB on a library of 280.",
    "Contrairement à Spoolman, il n'y a rien à choisir ici, et c'est une bonne chose. rfid_uid est le champ prévu par FilaMan pour cet usage : c'est le seul que la recherche du serveur parcourt, et le module Bambu s'engage à ne jamais y toucher.\n\nAvec un autre champ, chaque lecture de tag obligerait à télécharger tout l'inventaire au lieu d'une simple recherche : 176 ko au lieu de moins de 1 ko pour 280 bobines." },  // STR_FLM_TAGFIELD_INFO

  { "Bambu-Tag-Felder pflegen",
    "Maintain the Bambu tag fields",
    "Mettre à jour les champs Bambu" },  // STR_FLM_BTAGS
  { "Chip-UID in den ersten freien Slot",
    "chip uid into the first free slot",
    "UID de puce dans le premier champ libre" },  // STR_FLM_BTAGS_SUB
  { "Eine Bambu-Spule trägt zwei RFID-Chips, einen je Seite. Das Plugin füllt nur den ersten der beiden Felder, mit dem, was der Drucker gemeldet hat; den zweiten hält es für einen weiteren Leser frei.\n\nAn: die Waage trägt die Chip-UID der aufliegenden Seite in den ersten freien der beiden Slots ein. Ein belegter Slot wird nie überschrieben. Legt man beide Seiten auf, sind danach beide gefüllt.\n\nNutzen: die Spule wird auch dann gefunden, wenn sich ihr Tag nicht entschlüsseln lässt und nur seine Chip-UID hergibt.",
    "A Bambu spool carries two RFID chips, one per flange. The plugin fills only the first of the two fields, with what the printer reported, and keeps the second free for another reader.\n\nOn: the scale writes the chip uid of the side on the reader into the first free of the two slots. A slot that holds something is never overwritten. Present both sides and both end up filled.\n\nWhat it buys: the spool is still found when its tag will not decrypt and has nothing but its chip uid to offer.",
    "Une bobine Bambu porte deux puces RFID, une de chaque côté. Le module Bambu ne remplit que le premier des deux champs, avec ce que l'imprimante a signalé, et laisse le second libre pour un autre lecteur.\n\nActivé : la balance inscrit l'identifiant (UID) de la puce posée sur le lecteur dans le premier des deux champs resté vide. Un champ rempli n'est jamais écrasé. Posez un côté puis l'autre : les deux seront remplis.\n\nIntérêt : la bobine est retrouvée même si son tag ne peut pas être déchiffré et ne fournit que l'UID de sa puce." },  // STR_FLM_BTAGS_INFO

  { "external_id mitschreiben",
    "Write external_id too",
    "Écrire aussi external_id" },  // STR_FLM_EXTID
  { "verhindert doppelte Spulen",
    "stops duplicate spools",
    "évite les bobines en double" },  // STR_FLM_EXTID_SUB
  { "Das Bambu-Plugin prüft vor dem Anlegen einer Spule nur external_id. Eine von der Waage verknüpfte Spule trägt die Tray-UUID aber in rfid_uid und ist für diese Prüfung unsichtbar - sie wird ein zweites Mal angelegt.\n\nAn: die Waage trägt bambulab:<Tray-UUID> nach, solange das Feld leer ist. Damit hören die Doppel auf.\n\nDer Preis: das Plugin behandelt die Spule danach als seine und schreibt das Restgewicht aus der AMS-Schätzung fort. Bis zur nächsten Wägung steht dann eine Schätzung dort, wo ein gemessener Wert stand.",
    "Before creating a spool the Bambu plugin looks at external_id and nothing else. A spool linked by this scale carries the tray uuid in rfid_uid instead and is invisible to that check, so it gets created a second time.\n\nOn: the scale fills in bambulab:<tray uuid> while the field is empty. That ends the duplicates.\n\nThe price: the plugin then treats the spool as its own and maintains the remaining weight from the AMS estimate. Until the next weighing an estimate stands where a measured value stood.",
    "Avant de créer une bobine, le module Bambu ne vérifie que external_id. Or une bobine liée par la balance porte l'identifiant Tray-UUID dans rfid_uid : ce contrôle ne la voit pas, et elle est créée une seconde fois.\n\nActivé : la balance inscrit bambulab:<Tray-UUID> tant que le champ est vide. Il n'y a plus de doublons.\n\nL'inconvénient : le module considère ensuite la bobine comme la sienne et met à jour son poids restant d'après l'estimation de l'AMS. Jusqu'à la pesée suivante, ce poids est une estimation et non une mesure." },  // STR_FLM_EXTID_INFO

  { "Tag gefunden - mehrere Spulen",
    "Tag found - several spools",
    "Tag trouvé - plusieurs bobines" },  // STR_TAG_FOUND_DUP

  // ---- device name --------------------------------------------------
  { "mDNS",
    "mDNS",
    "mDNS" },  // STR_W_R_MDNS
  { "Auch erreichbar über",
    "Also reachable at",
    "Également joignable à" },  // STR_W_DEVNAME_ALSO
  { "wird geprüft ...",
    "checking ...",
    "vérification ..." },  // STR_W_DEVNAME_DNS_WAIT
  { "Der Name wird in deinem Netz aufgelöst und zeigt auf diese Waage.",
    "This name resolves on your network and points at this scale.",
    "Ce nom est résolu sur votre réseau et pointe vers cette balance." },  // STR_W_DEVNAME_DNS_OK
  { "Der Name zeigt auf %s, nicht auf diese Waage.",
    "This name points at %s, not at this scale.",
    "Ce nom pointe vers %s, pas vers cette balance." },  // STR_W_DEVNAME_DNS_OTHER
  { "Dein DNS-Server kennt diesen Namen nicht.",
    "Your DNS server does not know this name.",
    "Votre serveur DNS ne connaît pas ce nom." },  // STR_W_DEVNAME_DNS_NONE
  { "Im lokalen Netz auf .local antworten (mDNS)",
    "Answer to .local on the local network (mDNS)",
    "Répondre en .local sur le réseau local (mDNS)" },  // STR_W_MDNS
  { "Findet die Waage ohne DNS-Server. Aus, wenn in deinem Netz kein .local laufen soll.",
    "Finds the scale with no DNS server involved. Off if your network should carry no .local traffic.",
    "Permet de trouver la balance sans serveur DNS. À désactiver si vous ne voulez pas de noms en .local sur votre réseau." },  // STR_W_MDNS_HINT
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
