Niko11111/SpoolmanScale/(commit log)

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2026-04-23 First Public Beta v0.5.0
    Have fun and thanks for tying it out.
    [partitions.csv]
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2026-04-25 v0.5.2-beta
    Fixed a critical bug where spools were not recognized when Spoolman contained more than ~130 spools. The device would incorrectly show "Spool not in Spoolman" and repeatedly ask to re-link already linked spools. Memory usage during Spoolman queries has been significantly reduced, making the app stable with large spool libraries.
    [SpoolmanScale.ino]
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2026-05-06 Fix: rename workflow → workflows
2026-05-06 Fix: manifest.json paths firmware/ → webflasher/
2026-05-11 Drying Reminder (v0.5.12-beta)
    - Scrollable Scale submenu (list buttons)
    - Drying Reminder screen: Off / Material / Manual modes
    - Per-material sealed storage flag (webserver)
    - Effective threshold display with multiplier
    - Ampel: last_dried color + warning symbol on mainscreen
    - Webserver: drying thresholds, location limit, combined limits card
    - Numpad for manual thresholds
    - Bambu tag material lookup fix"
    [lang.cpp, lang.h, main.cpp]
2026-08-09 fix: free previous connection screen on WiFi setup back navigation
    buildConnectionScreen() overwrites scr_connection without freeing the
    old object. The back button in wifi_setup_screen called it without a
    prior lv_obj_del, leaking a full screen into the 48 KB LVGL pool on
    every WiFi setup -> back round trip.
    Once the pool is exhausted, LV_ASSERT_MALLOC halts in while(1) with no
    reboot and no panic output. Opening the Spoolman IP screen (~40 objects,
    the heaviest screen in the project) reliably hit that limit.
    Also logs lv_mem_monitor() in the verbose heartbeat and before building
    the Spoolman IP screen, so pool exhaustion is visible in the SD log.
    Pre-existing since v0.5.12-beta, not int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
    [app_config.h, app_loop.cpp, main.cpp]
2026-08-09 fix: release previous screen object in every build*Screen()
    Most build*Screen() functions assigned their global scr_* pointer without
    freeing the previous object, orphaning it in the 48 KB LVGL pool. The pool
    drained across normal navigation (30204 -> 4584 bytes free, fragmentation
    1% -> 46% in one session) until an allocation failed, which showed up as
    either a hard halt in LV_ASSERT_HANDLER or a panic reboot.
    Adds ui_common::releaseScreen() and calls it at the top of 18 build
    functions. It uses lv_obj_del_async(), so deletion happens at the end of
    the current lv_timer_handler() pass and stays safe when reached from an
    event callback of the screen itself. It is a no-op on a null pointer, s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
    [app_config.h, main.cpp]
2026-08-09 fix: raise LVGL memory pool from 48 kB to 96 kB
    hideAllOverlays() hides overlay screens but never frees them, so every
    visited screen stays resident even though each entry rebuilds it from
    scratch. The main screen alone occupies ~19 kB and the drying reminder
    table another ~20 kB, so the old 48 kB pool was exhausted by normal
    navigation with no leak involved.
    An exhausted pool trips LV_ASSERT_MALLOC, whose handler is while(1).
    That halts the loop at full clock on both cores, which presents as a
    freeze and noticeably heats the board.
    96 kB fits every screen at once with headroom. Static RAM goes from
    35.0% to 50.0% (163924 of 327680 bytes), leaving ~165 kB of heap.
    Note: lv_conf.h changes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
    [app_config.h, main.cpp]
2026-08-09 fix: reconnect WiFi after the setup screen disconnects for scanning
    wifiManagerPrepareScan() calls WiFi.disconnect(true) before scanning,
    because scanNetworks() returns 0 after a failed WiFi.begin(). Nothing
    reconnects unless the user completes the full pick-network, enter-
    password, connect flow. Merely opening the WiFi setup screen therefore
    left the device offline until the next reboot, and every Spoolman call
    afterwards failed with HTTPC_ERROR_CONNECTION_REFUSED (-1).
    Log evidence: across 6 boot sessions, all 15 Spoolman queries in sessions
    without a WiFi setup screen visit succeeded, and all queries after a
    visit failed, recovering only on reboot.
    Adds handleWifiReconnect() to appLoop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
    [app_config.h, app_loop.cpp, main.cpp]
2026-08-09 build: pin espressif32 platform to 6.13.0
    platform = espressif32 was unpinned and resolved to whatever was newest
    at build time. Three versions were installed side by side locally (6.7.0
    with Arduino core 2.0.16, 6.9.0 and 6.13.0 with 2.0.17), and CI runs
    pip install --upgrade platformio without a pin, so the same commit could
    produce different binaries on different days.
    All libraries were already pinned; the platform was the one gap.
    6.13.0 is the version v0.5.13-beta.5 was built and is being tested on.
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2026-08-10 feat: backend selection screen and FilaMan credential setup
    Device side:
    ui/backend_screen.* new screen behind Connection tile 2, which is now
    called Backend instead of Spoolman IP. Two segment
    selector, address row that opens the existing numpad,
    and in FilaMan mode the status of API key and device
    token plus a pointer to the browser.
    The mode switch is deferred through show_backend_pending and rebuilt from
    appLoop(), so no callback deletes the button it is running on.
    The Extra Fields tile is no longer built in FilaMan mode.
    The address numpad now reads and writes through backendHost() an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
    [app_config.h, app_loop.cpp, app_state.cpp, app_state.h, backend.cpp, backend.h, deferred_actions.cpp, deferred_actions.h]
2026-08-10 fix: report why FilaMan device registration failed
    The register route only showed the bare HTTP status, which is not enough
    to act on. FilaMan answers with {"detail":{"code","message"}}, so that
    message is now parsed and passed through to the page, together with a hint
    for the two statuses that actually occur:
    404 code already consumed, they are single use
    403 that device already holds a token, rotate it for a fresh code
    Also uppercases the entered code, since the admin shows codes uppercase,
    refuses to send when no FilaMan address is configured yet, and logs the
    URL the registration was sent to.
    [app_config.h, filaman_api.cpp, filaman_api.h, main.cpp]
2026-08-10 fix: make a missing port visible instead of blaming FilaMan
    An address entered without a port sends the request to port 80, where some
    other service answers. The registration then failed with a foreign error
    format that looked like a FilaMan problem but never reached FilaMan.
    Backend: mode=FilaMan host=192.168.4.100
    FilaMan: registering device at http://192.168.4.100/api/v1/devices/register
    HTTP 403: [{"error":{"address":"/devices/register", ...}}]
    Now the failure message names the URL that was actually contacted and points
    out a missing port, and the Backend screen shows an address without a port in
    amber instead of green.
    Also stops the not-supported notice from repeating. The per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
    [app_config.h, backend_api.cpp, main.cpp]
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2026-08-13 feat: wire the FilaMan tag lookup, with pagination and review fixes
    querySpoolman() now tries the server side tag search first and falls back
    to the existing full scan. Spoolman returns BACKEND_NOT_SUPPORTED and takes
    the unchanged path.
    Four issues found in review before this ran on hardware:
    1. The fast path accepted any non-empty result. FilaMan's ?search= is a text
    filter, so a substring hit on an unrelated spool would have suppressed the
    fallback and reported a known spool as unknown. It now only short-circuits
    on a real tag match.
    2. filamanGetSpoolListJson applied timeout_ms per page. Twenty pages at the
    20 s timeout used for spool lists meant up to several minutes of bl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
    [app_config.h, backend_api.cpp, filaman_api.cpp, main.cpp]
2026-08-13 fix: backend name updates immediately on switch
    Two labels named the backend but never caught up when it was switched.
    The FLM/SPM indicator was set inside updateHeaderStatus(), which only runs
    when reachability changes. If the new backend happened to be reachable too,
    nothing called it and the old name stayed until the next reboot.
    The caption above the database weight was a local variable, so nothing could
    reach it after the main screen was built. It is now a global like the other
    header labels and follows the mode as well.
    backendSetMode() is followed by updateHeaderStatus() and sm_reachable is
    reset, since reachability of the new backend is unknown until it answers.
    [app_config.h, app_state.cpp, app_state.h, main.cpp]
2026-08-13 feat: FilaMan write path
    Weight, tag, status and weight fields can now be written in FilaMan mode.
    filamanPatchRfidUid link and unlink, both tag types
    filamanPatchCustomField last_dried, with the GET before PATCH that
    custom_fields needs because it is replaced
    rather than merged
    filamanReportWeight device API, FilaMan computes the remainder
    filamanSetStatus archiving, own endpoint instead of a PATCH
    filamanPatchSpoolFloat empty_spool_weight_g, initial_total_weight_g
    filamanPatchFilamentFloat default_spool_weight_g
    Weight semantics differ and this is the trap in the whole stage: Spoolman
    ta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
    [app_config.h, app_loop.cpp, backend_api.cpp, backend_api.h, filaman_api.cpp, filaman_api.h, main.cpp, spoolman_actions.cpp]
2026-08-13 fix: send whole grams to FilaMan
    confirm_popup.cpp:206 passes the raw scale reading to patchSpoolWeight(), so
    empty_spool_weight_g, initial_total_weight_g and the reported weight all
    arrived with decimals.
    FilaMan's API accepts them, the fields are declared as number rather than
    integer, but its edit forms reject a value with decimals, so a spool written
    by the scale could no longer be edited in the web UI.
    All gram values sent to FilaMan are now rounded. A load cell has no
    meaningful accuracy below a gram, so nothing is lost. Spoolman keeps
    receiving the unrounded value and behaves exactly as before.
    [app_config.h, filaman_api.cpp, main.cpp]
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2026-08-13 fix: unlink clears rfid_uid, empty string does not
    Unlink sends an empty uuid, which was passed straight through as
    {"rfid_uid": ""}. Verified against a live FilaMan 1.2.36 instance:
    {"rfid_uid": ""} HTTP 500, tag stays in place
    {"rfid_uid": null} HTTP 200, tag cleared
    An empty uuid now sends null. Spoolman is unaffected, it stores the tag in
    extra.tag where an empty string is the correct clearing value.
    Worth reporting upstream: a value the API declares as string|null answering
    with 500 rather than 422 is a server side fault, not a client mistake.
    [app_config.h, filaman_api.cpp, main.cpp]
2026-08-14 feat: locations for FilaMan
    Spoolman carries the location as a plain string on the spool, FilaMan as a
    location_id pointing at its own objects. Both directions are translated
    through a small cache of at most 32 entries.
    filamanGetLocationsJson() returns an array of names, the shape the
    picker already parses, and always refetches
    because that screen is where a location just
    created in the browser should appear
    filamanPatchSpoolLocation() resolves the name to an id, refetching once
    if it is unknown, and refuses to write rather
    than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
    [app_config.h, backend_api.cpp, filaman_api.cpp, filaman_api.h, main.cpp]
2026-08-14 fix: location list capacity and a hint that is wrong for FilaMan
    The cache held 32 entries while the web interface allows location_list_limit
    up to 100, so the cache was the narrower of the two without saying so. Raised
    to 100 and truncation is now logged: a location past the cut cannot be
    resolved and would be refused on write, which must not happen quietly.
    The picker also showed 'empty locations are not shown'. That is true for
    Spoolman, which derives its location list from the spools themselves, so a
    location without spools does not exist there. FilaMan keeps locations as
    their own objects and returns all of them, so the hint is not shown in
    FilaMan mode.
    RAM 50.6 to 51.5 percent for t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
    [app_config.h, filaman_api.cpp, main.cpp]
2026-08-14 feat: UI names the active backend everywhere
    Twenty-six strings named Spoolman explicitly and stayed that way in FilaMan
    mode. All of them now follow the active backend.
    Rather than rewrite the strings with %s placeholders, which would have meant
    reordering arguments in the ones that already take formatting and doing it
    twice for German and English, the substitution happens on the way into the
    display buffer:
    backendName() 'Spoolman' or 'FilaMan'
    backendText(T(X), buf, sizeof) copies and substitutes
    This does two jobs at once: T() returns a pointer into Flash that has to be
    copied into RAM anyway, and the copy is where the word gets swapped.
    'SpoolmanScale' is e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
    [app_config.h, app_loop.cpp, backend.cpp, backend.h, lang.cpp, lang.h, main.cpp]
2026-08-14 fix: display updates immediately after archiving
    patchArchiveSpool() set sm_remaining to 0 and wrote a Serial line, but
    touched no label. The screen kept showing the values from before the
    archive until the tag was scanned again. This affected both backends, it
    was not a FilaMan specific problem.
    The labels are now set to the same state the scan path shows for an
    archived spool: 'Archived' in grey, percentage, dried, last used, article
    number and filament name cleared, progress bar reset.
    Two things that were also missing:
    - a failed archive now says so on screen instead of only in Serial
    - sm_found is cleared, since the spool has left the active inventory and a
    following weight update o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
    [app_config.h, main.cpp, spoolman_actions.cpp]
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2026-08-14 fix: convert FilaMan UTC timestamps to local time before showing the date
    [app_config.h, main.cpp]
2026-08-14 feat: backend step in first setup, web interface shortcut, explicit setup flag
    [app_boot.cpp, app_config.h, app_loop.cpp, app_state.cpp, app_state.h, deferred_actions.cpp, deferred_actions.h, lang.cpp]
2026-08-15 fix: set setup flag on the language step, log every setup state change
    [app_boot.cpp, app_config.h, main.cpp]
2026-08-15 fix: correct spool count via x-total-count, German wording, browser link from drying screen
    [app_config.h, lang.cpp, lang.h, main.cpp, spoolman_api.cpp]
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2026-08-16 fix: refuse to link without a tag UID instead of silently clearing the field
    [app_config.h, lang.cpp, lang.h, main.cpp, spoolman_actions.cpp]
2026-08-16 fix: day difference was one short during daylight saving time
    [app_config.h, main.cpp]
2026-08-16 fix: unlink clears the legacy tag too, bound the dedup arrays
    [app_config.h, filaman_api.cpp, main.cpp]
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2026-08-16 fix: reset the NFC miss counter on every successful read
    [app_config.h, app_loop.cpp, main.cpp]
2026-08-16 chore: release v0.6.0-beta, fix the version lookup in CI
    [app_config.h, main.cpp]
2026-08-17 feat: more robust NFC reads and a background update check (v0.6.1-beta)
    NFC
    - A missed read shortens the next poll interval instead of retrying
    inside the same loop pass, so the UI keeps running between attempts.
    Dropouts of up to 1.35 s recover instead of counting as a removal.
    - Removal is decided on elapsed time, not on a miss count, and the retry
    counter survives a removal so a tag that never authenticates stops
    re-scanning forever.
    - scanTag() only adopts a result at least as complete as the stored one,
    so a failed retry no longer wipes good data.
    - The PN532 is probed before a re-init, which keeps a locked-up reader
    from taking the NAU7802 down with it on the shared I2C bus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
    [app_boot.cpp, app_config.h, app_loop.cpp, app_settings.cpp, app_state.cpp, app_state.h, lang.cpp, lang.h]
2026-08-17 ci: refuse tags that are not newer, mark only counter builds as pre-release
    Two gaps that the background update check turned from cosmetic into
    something users would see.
    The version guard only compared the tag against FW_VERSION, so two
    matching but too low numbers passed it. Since the firmware now compares
    itself against version.json, such a tag would put a red dot on every
    device and offer a downgrade. The new step ranks the tag against what is
    published and fails the build otherwise, using the same ordering as
    src/services/version_compare.cpp.
    Releases were created with prerelease: true unconditionally, which had to
    be undone by hand after every release. The update button downloads fro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
2026-08-18 fix: code review findings from PR #6 (v0.6.1-beta.3)
    Ports the still open findings from Der-Frazi's PR #6 into the module layout.
    The PR itself was based on the monolithic main.cpp from before the split, with
    59 commits and 156 changed files in between, so every hunk had to be
    reimplemented at its new location rather than rebased.
    Two of these could take the device down:
    - linkIdLookupAndPatch() appended a hand entered spool ID at link_spool_count,
    but the list is allocated to an exact fit by both fetch paths, so it wrote one
    UnlinkedSpool past the end of the block. Capacity is now tracked alongside the
    count and reset with it, and appending grows the block first.
    - scaleHardwareBegi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
    [app_boot.cpp, app_config.h, app_loop.cpp, app_settings.cpp, display.cpp, lang.cpp, lang.h, main.cpp]
2026-08-18 fix: apply the saved brightness at boot instead of a hardcoded 204 (#7)
    displayHardwareBegin() set the panel to a hardcoded 204 and nothing ever
    pushed bright_normal to the hardware. The ordering is what makes this bite:
    loadPrefs() restores the saved value into the global at app_boot.cpp:98, and
    displayHardwareBegin() then overwrites the panel with 204 at :109. The two
    remaining setBrightness call sites are both inside the dim path, guarded by
    is_dimmed, so on a freshly booted device the saved level never reached the
    panel at all.
    The settings slider renders from bright_normal, so a device sitting at its 255
    default showed a slider pegged at maximum while the backlight actually ran at
    204,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
    [app_boot.cpp, display.cpp, display_power.cpp, display_power.h]
2026-08-18 fix: make the WiFi status screen reachable, lay it out properly, keep it live (#8)
    * fix: apply the saved brightness at boot instead of a hardcoded 204
    d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
    [lang.cpp, lang.h, wifi_manager.cpp, wifi_manager.h]
2026-08-18 fix: rework the connection menu and WiFi screens after #7 and #8 (v0.6.1-beta.6)
    Follow-up to the two merged pull requests, from testing them on hardware.
    The WiFi status tile made the connection menu four tiles deep in Spoolman mode,
    which squeezed every tile from 80px to 60px and clipped the icons. Extra fields
    are a property of the filament manager rather than of the network connection,
    so they move to the backend screen and sit under the address row, where there
    is room because the credential rows below it are FilaMan only. That leaves
    three tiles in both backend modes and the tiles go back to 80px. The extra
    fields screen now returns to the filament manager on back, and its skip button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
    [app_config.h, app_settings.cpp, app_state.cpp, app_state.h, lang.cpp, lang.h, main.cpp]
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2026-08-18 fix: dimming goes to the minimum instead of a fixed level (v0.6.1-beta.14)
    handlePowerManagement() dimmed to a fixed 77 without looking at the brightness
    the user had set. Anyone running below that watched the display get brighter
    when it went idle, and darker again on the next touch - exactly backwards. At
    the slider minimum of 10 against 77 it is not subtle.
    Dimming now goes to the lowest level the panel is driven at, which is dimmer
    than any setting by definition, so the inversion cannot come back. Capping at
    the chosen brightness instead was the other option and was rejected: for anyone
    below 77 it would have turned dimming into a no-op, which is not what setting a
    dim timeout asks for.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
    [app_config.h, display_power.cpp, main.cpp]
2026-08-18 chore: release v0.6.2-beta
    First release since v0.6.1-beta. What accumulated: the code review findings
    ported from Der-Frazi's PR #6, Simon-CR's brightness fix (#7) and WiFi status
    screen (#8), the connection menu rework that followed from testing those, the
    FilaMan remote link, and the dimming fix that only became visible once #7 let
    the saved brightness reach the panel.
    [app_config.h, main.cpp]
2026-08-19 chore: log the active backend on boot (v0.6.3-beta.1)
    A log file told nobody whether Spoolman or FilaMan was in play, which is
    the first thing needed to read the rest of it. backendStatusLine() builds
    one line for both, and it goes to the serial monitor, the daily log and
    the boot block alike - the boot block being the part a user actually
    sends in.
    The health check after WiFi connect went to cfg_spoolman_base with a
    hardcoded "Spoolman" label, so on FilaMan it probed the wrong host and
    then named the wrong product. It now uses backendBaseUrl() and
    backendName(). The gate is deliberately not backendIsConfigured():
    FilaMan serves /health without credentials, and a device missing its
    tokens i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
    [app_boot.cpp, app_config.h, backend.cpp, backend.h, main.cpp, sd_logger.cpp]
2026-08-19 fix: give the FilaMan options list a layout (v0.6.3-beta.2)
    makeListBtn() never positions the button it creates; it relies entirely
    on the parent's layout. The FilaMan options container was built without
    one, so every entry would land on the content origin and only the last
    one added stays visible and clickable.
    With a single entry that is indistinguishable from working, which is why
    it survived until now. The next entry added to that screen would have
    been invisible, and the cause is nowhere near the code that adds it.
    scale_menu.cpp already carries the four lines this needs, so they are
    copied verbatim rather than invented.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
    [app_config.h, main.cpp]
2026-08-19 fix: fall back to the filament and brand tare when a spool has none (v0.6.3-beta.3)
    The empty-spool weight can be recorded at three levels, but only the
    spool's own field was read. When that is blank the tare is zero, so the
    spool itself gets weighed as filament - 130 to 250 g of plastic and
    cardboard counted as material on a nominal 1 kg spool.
    The chain is spool.spool_weight -> filament.spool_weight ->
    vendor.empty_spool_weight -> 0. A measurement always wins; the fallback
    only fills in what would otherwise have been zero.
    Both backends arrive here in the same shape, because the FilaMan adapter
    already maps default_spool_weight_g onto filament.spool_weight and the
    manufacturer onto vendo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
    [app_config.h, app_state.cpp, app_state.h, lang.cpp, lang.h, main.cpp, spoolman_actions.cpp]
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2026-08-19 feat: weigh a remotely linked spool that has no tag (v0.6.3-beta.5)
    A remote link from the FilaMan web UI waited for a tag and gave up after
    a minute. That is the right answer when the point was to bind a tag. It
    is the wrong one for a spool that simply does not have one: the user
    picked that exact spool on their phone, walked over to the scale, and got
    a failure.
    After 10 seconds without a tag the scale now loads the chosen spool and
    lets it be weighed. Nothing is written to any tag and no binding is
    stored - it lasts until the next scan, the same lifetime a scanned tag
    already has. The full 60-second timeout still applies to every other
    case.
    The result reported back to FilaMan carries t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
    [app_config.h, app_loop.cpp, app_settings.cpp, lang.cpp, lang.h, main.cpp, user_options.cpp, user_options.h]
2026-08-19 refactor: make the display screen scrollable (v0.6.3-beta.6)
    The screen is 320 px and buildOverlayScreen() clears SCROLLABLE on it, so
    the settings could only ever occupy what happened to fit. Brightness, dim
    and sleep already reached y=236, and the hint sits at the bottom edge -
    about 62 px left. A third idle stage plus a toggle do not fit in that,
    and overflow on a non-scrollable screen is clipped silently rather than
    reachable.
    Everything below the header moves into a scrolling body. Positions stay
    absolute inside it, so the layout code is unchanged in kind; LVGL derives
    the scroll extent from the children. The row coordinates are collected at
    the top of the function, so adding a stage n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
    [app_config.h, main.cpp]
2026-08-19 feat: wake the display when something is put on the scale (v0.6.3-beta.7)
    The panel dims on an idle timer that only touch resets. So you set a
    spool down, the scale weighs it, and the reading sits behind a dimmed
    backlight until you poke the screen. Putting a load on the pad is as
    clear a statement of intent as touching the glass, and it is the one
    action the device exists to respond to.
    Every scale reading is now reported to the power manager, which wakes the
    panel when the load changes by 15 g or more. That is well above the load
    cell's noise and the drift it shows while warming, and well below the
    lightest thing anyone puts on the pad - even a bare spool is around
    130 g. The reference mo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
    [app_config.h, app_loop.cpp, app_settings.cpp, display_power.cpp, display_power.h, lang.cpp, lang.h, main.cpp]
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2026-08-19 refactor: fit the display screen back onto one page (v0.6.3-beta.9)
    The first rule in the design guide is "no scrollbars outside lists,
    everything fits on one page". The scrolling body added in beta.6 broke
    that. It was needed because four idle rows plus a toggle plus a hint
    label come to 330 px in a 270 px frame.
    Three removals bring it back to 256 px, with 14 px to spare:
    - The wake-on-load toggle. g_wake_on_load, the "wake_load" NVS key and
    the check in displayNoteWeight() all stay untouched, so the feature
    keeps working with its default of on. Only the button is gone; the
    setting belongs in the browser next to the list limits and the drying
    thresholds, which are already web-onl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
    [app_config.h, main.cpp]
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2026-08-20 fix: read back the initial weight a spool was measured at (v0.6.3-beta.11)
    Setting a spool's weight above the filament type's nominal did not stick:
    it held until the next scan and then snapped back to 1000 g.
    initial_weight was written and never read. The only mention in the tree
    was the FilaMan adapter mapping it, with no reader anywhere, and the tag
    lookup's field filter did not request it at all. sm_total came from
    filament.weight - the catalogue figure for the filament TYPE - on every
    lookup. patchInitialWeight() sets sm_total locally on success, which is
    why the display looked right until the value was fetched again.
    resolveInitial() now runs the same shape of chain as resolveTare():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
    [app_config.h, backend_api.cpp, filaman_api.cpp, filaman_api.h, main.cpp]
2026-08-20 feat: trust a known tare and measure the filament against it (v0.6.3-beta.12)
    New spool derived the tare from the nominal filament weight whenever the
    stored tare disagreed by 10 g or more. That is the wrong way round for
    every case except one.
    A reading contains two unknowns, the spool and the filament, and exactly
    one of them can be measured independently: the spool. Its weight is a
    property of the spool MODEL and barely varies between spools of the same
    kind, which is why it is worth storing on a filament or a brand at all.
    What a manufacturer actually winds onto an individual spool varies by a
    couple of percent - 20 to 30 g on a kilo, two to three percentage points
    on the display.
    So d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
    [app_config.h, main.cpp]
2026-08-20 feat: drop Spoolman field names from the scope buttons in FilaMan mode (v0.6.3-beta.13)
    The three spool-weight scope buttons carry the Spoolman REST field name
    in brackets - "This spool (spool_weight)", "Vendor (empty_spool_weight)".
    That is a real reading aid on Spoolman, where the three scopes use three
    different names and the user meets those names again in Spoolman's own UI.
    On FilaMan it is wrong twice over. The writes go to empty_spool_weight_g,
    default_spool_weight_g and empty_spool_weight_g, so two of the three
    scopes share a name and the bracket distinguishes nothing - and the name
    shown belongs to a different product. Worse, Spoolman's spool field is
    called spool_weight while Fila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
    [app_config.h, lang.cpp, lang.h, main.cpp]
2026-08-21 ci: make the release path safe to tag from a branch (v0.6.3-beta.14)
    The internal beta.N path of the pipeline had never run. Every tag in this
    repo so far is a public release, so the four problems below sat unnoticed
    in a branch nobody had taken.
    OTA downloaded the wrong binary. ota_github.cpp asked for
    releases/latest/download/, which GitHub resolves by skipping pre-releases,
    while the check right above it had just found a pre-release tag. A tester
    would have been told an update was available, been handed the previous
    public build, installed that downgrade, rebooted, and been offered the
    same update again. The tag the check found is now used to address the
    release directly; it was already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
    [app_config.h, main.cpp]
2026-08-21 fix: stop pulling GitHub's whole release list onto the heap (v0.6.3-beta.15)
    With pre-releases enabled the update check asked for the full /releases
    list and ran it through http.getString() before parsing. That answer is
    109 KB today against roughly 145 KB of free heap, so the body alone took
    three quarters of what was available and the document tree was built on
    top of it. It failed or succeeded depending on how fragmented the heap
    happened to be, which is why "JSON error" appeared once and then went
    away on a retry.
    Three changes, all on the same path:
    - per_page=5 on the request. The list is unbounded otherwise and grows
    with every release ever cut.
    - The response is parsed straight o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
    [app_config.h, main.cpp]
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2026-08-21 fix: make the first update check after boot reliable (v0.6.3-beta.16)
    Reverts the part of beta.15 that read the response off the socket.
    http.getStream() hands back the raw client and skips HTTPClient's chunked
    decoding, and this endpoint answers chunked as soon as the list is not
    capped. That was a class of failure the code did not need: the memory
    win never came from streaming, it comes from per_page and from the
    filter, which is what keeps the parsed document small. The body is read
    as a String again, and per_page drops from 5 to 3 to bound it at about
    27 kB.
    Honest note: this does not conclusively explain the "No release found"
    Nikolai saw on beta.15. GitHub answers per_page=5 with a Co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
    [app_boot.cpp, app_config.h, app_loop.cpp, deferred_actions.cpp, deferred_actions.h, main.cpp, update_check.cpp, update_check.h]
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2026-08-21 feat: talk to BamBuddy (v0.7.0-beta.4)
    Fills the BamBuddy arms of the dispatch that the previous commit left
    answering "not supported". Reading, writing and device presence, verified
    against BamBuddy 1.2.5.3 in Spoolman inventory mode.
    bambuddy_api.* is the client, built like filaman_api.*: no LVGL, no lang.h,
    its own PSRAM allocator, HTTP status codes out, JsonDocument filled in.
    mapSpool() rewrites a BamBuddy spool into the Spoolman shape, so spool_flow,
    spoolman_lookup and more_info_screen did not have to change at all.
    Four things the protocol probe turned up that the plan had wrong, each of
    which would have been a confusing bug rather than a clean failure:
    /api/v1/health does not exi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
    [app_boot.cpp, app_config.h, app_loop.cpp, backend_api.cpp, backend_api.h, bambuddy_api.cpp, bambuddy_api.h, bambuddy_device.cpp]
2026-08-22 feat: find a Snapmaker spool by either of its two tags (v0.7.0-beta.12)
    A spool on a Snapmaker U1 carries one NFC tag per flange so it can be
    loaded on either side of the printer, and SpoolLink records both UIDs in
    Spoolman's card_uids extra field. The scale only ever read extra.tag, so
    whichever tag happened to face the reader decided whether a spool it knew
    came up as known.
    card_uids is now a second source. spoolMatchesTag() in spoolman_lookup.cpp
    replaces the three copies of the comparison that had grown apart across the
    fast path, the full scan and the archive pass. The tag field is still asked
    first, with the comparison unchanged: nothing added here can cost an
    existing installation a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
    [app_config.h, app_loop.cpp, app_state.cpp, app_state.h, backend_api.cpp, backend_api.h, deferred_actions.cpp, deferred_actions.h]
2026-08-22 feat: tell BamBuddy's two inventory modes apart in the status bar
    The badge read "BBY" whichever database BamBuddy kept its spools in. Which
    one that is decides where every read and every write lands, and it can
    change while the scale runs, so it is worth a letter: "BBS" when BamBuddy
    proxies to a Spoolman server, "BBY" for its own inventory. Three
    characters either way, which is all the header has room for before the
    scale reading starts.
    Also drops toPlainHex() in favour of tagUidNormalize(). Both reduced a UID
    to plain uppercase hex; keeping two copies of that rule around was how the
    two of them would have drifted apart.
    [backend.cpp, backend.h, bambuddy_api.cpp]
2026-08-22 feat: let a spool carry more than one tag (v0.7.0-beta.16)
    The reading half landed in fb7aeb5: both tags of a Snapmaker spool already
    find it, because the scale matches against Spoolman's card_uids list as
    well as its own extra.tag. What was missing is the other direction. A
    second tag could only be registered with the SpoolLink app, not at the
    scale.
    It can now, behind a switch that is off by default. Off, nothing moves:
    linking, copying and unlinking behave exactly as they did, and a spool
    whose UIDs live in card_uids stays out of the link list the way it has
    since fb7aeb5. On, the scale appends to that list instead of writing the
    tag field, and opens the link list to those spools so ther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
    [app_config.h, app_settings.cpp, app_state.cpp, app_state.h, backend_api.cpp, backend_api.h, copy_release.py, lang.cpp]
2026-08-22 feat: ask on removal whether a weighed spool goes into the AMS (v0.7.0-beta.19)
    FilaMan has carried two fields on its device model for a while that nothing
    here used: auto_assign_enabled and auto_assign_timeout. With the flag set,
    POST /api/v1/devices/scale/weight hands the spool to every running printer
    driver as pending for the timeout, and the next AMS tray to be loaded gets it.
    On this instance the flag was off, so the feature had never been visible.
    Read literally the server's model is per device: switch it on and every
    weighing arms a window, including the ones where you only wanted to check a
    weight. This inverts that. The flag stays off, and the scale asks once the
    spool has been li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
    [ams_assign.cpp, ams_assign.h, app_config.h, app_loop.cpp, app_settings.cpp, app_state.cpp, app_state.h, deferred_actions.cpp]
2026-08-23 feat: let BamBuddy create spools (v0.7.0-beta.20)
    The copy flow ran all the way through in BamBuddy and failed on the last
    step. backendCreateSpool() was built around Spoolman's filament_id, and
    BamBuddy has no filament as an object - mapSpool() reports the id as 0 for
    every spool, so no template was ever identified.
    It now carries the template's spool id alongside the filament id. Spoolman
    and FilaMan use the filament id exactly as before; BamBuddy reads the
    template back raw and replicates its strings. Raw, because the mapped form
    folds subtype and colour name into a single name and trims rgba - a copy
    built from it would come out poorer than its template.
    Creating a spool from the tag i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
    [app_config.h, backend_api.cpp, backend_api.h, bambuddy_api.cpp, bambuddy_api.h, lang.cpp, lang.h, main.cpp]
2026-08-23 fix(tag): link a tag that another spool already holds
    FilaMan's rfid_uid column is UNIQUE, so a PATCH claiming a UID that is
    still on another spool answers HTTP 500 and the link silently does not
    happen. backendLinkSpoolTag unlinks the old owner first, archived spools
    included, and keeps whatever the target had in custom_fields.previous_tag
    so a second tag on the same spool is not lost.
    [backend_api.cpp, backend_api.h, filaman_api.cpp, filaman_api.h, tag_write.cpp]
2026-08-23 fix(tag): terminate 16 byte ACE text fields
    The SKU, brand and material fields are four pages each with a spare page
    after them. A value that fills all sixteen bytes carries no NUL, so
    leftover data in that spare page ran the next field onto the end of it.
    Clear it on every write.
    A truncated article number is a SKU that matches nothing, so anything
    longer than sixteen bytes now falls back to SM<id>.
    [tag_write.cpp]
2026-08-23 feat(tag): show both sides of a write as swatches
    The page described a tag in one line of text. It now reads the whole ACE
    record, including the temperatures and the geometry it was skipping, and
    serves it field by field, so the tag and the pending write render side by
    side with the colour, the name and a table. Fields that differ between
    the two are highlighted.
    [tag_write.cpp, tag_write.h, web_shell.cpp]
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2026-08-23 fix(tag): respect the tag's user memory size
    Erase ran to a fixed page 44, past the end of an NTAG213, so it reported
    a failure after having erased everything there was. It now stops at the
    last page the capability container reports.
    OpenSpool needs about 165 bytes and does not fit on a 144 byte NTAG213 at
    all, where it used to fail with the generic "keep the tag still" message.
    It now says what it needed and what the tag holds, and the tag's capacity
    is shown next to its type.
    [tag_write.cpp]
2026-08-23 feat(filaman): answer the import-from-tag scan request
    FilaMan's "import from tag" posts to /api/v1/rfid/scan-request on the
    device and waits for the contents on /api/v1/devices/tag-data. The route
    did not exist, so every attempt came back as "Tag-Scan konnte auf dem
    Geraet nicht gestartet werden".
    The trigger is parked like the write trigger and answered from the loop
    with what is on the reader, as OpenSpool JSON. Bambu tags are included:
    the page itself cannot read them, but the main flow has already decoded
    one by then, and it is the case this feature exists for. Their material
    is trimmed to the bare type, the brand is filled in because the tag
    carries none, and the resolved spool id rid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
    [filaman_api.cpp, filaman_api.h, tag_write.cpp, tag_write.h]
2026-08-23 fix(tag): erase is an action, not a format
    Erase sat in the format dropdown, so it could only be reached by first
    picking a spool it does not need, and the write path fetched that spool
    from the backend before erasing nothing to do with it. It is now its own
    button, enabled whenever a writable tag with something on it is present,
    and the erase path no longer talks to the backend at all.
    [tag_write.cpp]
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2026-08-23 fix(tag): a page that will not read is not a blank page
    The blank check treated a failed page read as an empty page, so a tag
    that was badly seated described itself as blank - and because the result
    counted as a complete read, it was cached and stuck until the tag moved.
    Reading is now all or nothing, like every other path here.
    [tag_write.cpp]
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2026-08-23 feat: choose which Spoolman extra field holds the tag UID (v0.7.0-beta.25)
    Spoolman has no field for NFC tags, so every project around it settled on a
    different one. The scale wrote extra.tag, and since beta.16 optionally
    card_uids, both baked in - anyone running one of the others could not point it
    at their field.
    Which field is now a setting, out of the three conventions that exist:
    extra.tag for this scale, OpenSpoolman and spoolnymous; nfc_id for FilaMan,
    nfc2klipper and SpoolSense; card_uids for SpoolLink on the Snapmaker U1 and
    Spool Studio. Only card_uids defines a list format, so only there can a spool
    carry more than one tag, and the switch for it is offered nowhere else. A
    comma s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
    [app_config.h, app_loop.cpp, app_settings.cpp, app_state.cpp, app_state.h, backend_api.cpp, backend_api.h, deferred_actions.cpp]
2026-08-23 feat: use Spoolman's own tag relation where the server has one (v0.7.0-beta.26)
    Yesterday's commit made the extra field a choice, because Spoolman had no
    field for NFC tags and every project around it had settled on a different one.
    Six days after the last release that changed: "NFC phase 1 backend: tag
    identity, lookup, and the scan relay" landed on Spoolman's master on the 13th.
    Checked against the tags, SpoolTag is in neither v0.26.0 nor v0.26.1, so
    nothing here can be reached on any released server yet.
    What it offers is close to what the extra fields were bent into shape for.
    A spool holds tags as a relation, several of them, with no list format
    involved. The UID is stored "normalized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
    [app_config.h, app_settings.cpp, app_state.cpp, app_state.h, backend_api.cpp, backend_api.h, lang.cpp, lang.h]
2026-08-23 fix: say what the scale is doing during a full inventory scan (v0.7.0-beta.29)
    A scan that finds its tag is over in milliseconds. One that does not falls
    through to loading the whole inventory, 176 kB on a library of 268, and the
    status line kept saying "reading tag" throughout - the read was long finished,
    and a wait that says the wrong thing reads as a failed read rather than as
    work in progress.
    It now says "Searching inventory... 42 KB" for that phase, with the byte
    counter from the loading overlay pointed at the status line instead of the
    overlay. Registering a different function on the progress hook is the entire
    change; the counter answers the only question a wait like this raises, w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
    [app_config.h, lang.cpp, lang.h, main.cpp]
2026-08-23 fix: give the web server one owner and put its gates on the endpoints
    Two defects came out of #18 splitting the single page into pages while the
    routes behind those pages kept their old guard.
    The maintenance gate only covered the pages. Every endpoint behind them
    still asked otaRoutesOpen(), which web_access.cpp had switched on for good
    the moment the master switch was on. With maintenance off, /ota answered
    403 while POST /update flashed the device, /api/deletelog deleted the log
    and /api/filaman/key overwrote the credentials. Twenty-three endpoints hung
    on that guard, six pages on the other one.
    Port 80 also stayed dead after leaving the web screen. webServerTick() kept
    its own copy of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
    [app_config.h, app_loop.cpp, lang.cpp, lang.h, main.cpp, web_access.cpp, web_home.cpp, web_shell.cpp]
2026-08-23 refactor: describe each web page once and build everything from that
    The web interface was a 1070 line file holding a five-way if-chain over an
    integer index, two tab tables in two files that had to be kept in step by
    hand, and every JSON endpoint for every page. Adding a page meant appending
    to both tables, adding an "if (sec == N)", registering a route and keeping
    the index aligned across all four.
    The two tables had already drifted. One knew about BamBuddy and one did not,
    so the same device showed the backend tab on its status page and hid it
    everywhere else.
    Each page is now one file under web/pages/ describing itself: path, label,
    gate, whether it applies to this device, its body and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
    [app_config.h, app_loop.cpp, app_settings.cpp, main.cpp, page_config.cpp, page_firmware.cpp, update_check.cpp, web_access.cpp]
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2026-08-23 fix: stop the spool list and the tag JSON from overrunning (v0.7.0-beta.34)
    Two findings from the review of #19, both in code that handles whatever a
    tag or a backend happens to hold.
    /api/spools parsed the whole inventory with no filter and no PSRAM, then
    built the entire reply as a second String on top of it. Two full copies of
    the inventory on the 320 kB internal heap, inside an HTTP handler. It now
    parses four fields per spool through a filter, allocates from PSRAM and
    streams the reply in chunks, so neither copy exists any more.
    It is deliberately not clipped to spool_list_limit. That limit is there
    because an LVGL picker with hundreds of rows runs the device out of memory;
    a browser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
    [app_config.h, main.cpp, tag_write.cpp]
2026-08-24 refactor: put the system and web screens in the house style (v0.7.0-beta.35)
    Two screens never adopted makeListBtn() and the scrolling list every other
    settings screen uses, and it showed.
    The system screen built its own 52 px buttons with an icon, a title and a
    subtitle stacked inside them. The content needed all 52 px, so there was no
    padding, and four of those plus the reset and reboot pair put the last
    element at y=313 of 320. Seven pixels left over. There was no room for
    another entry and none to spare for a longer translation, which is why the
    order was whatever still fitted rather than a choice.
    It is now the same 480x263 scrolling list as the scale menu and the options
    screens, wit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
    [app_config.h, lang.cpp, lang.h, main.cpp]
2026-08-24 fix: warn in amber for the restart row, keep red for the reset (v0.7.0-beta.36)
    A restart costs twenty seconds and takes nothing away. A factory reset
    erases every setting on the device. Painting both red said they were the
    same kind of mistake to make.
    [app_config.h, main.cpp]
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2026-08-24 fix: make the log page work again and put the notes back (v0.7.0-beta.38)
    The log card stayed empty because \' in a C++ string literal is just ', so
    the delete button went out as onclick="delLog(''+f.name+'')" - three
    adjacent string literals, and a syntax error takes the whole script block
    with it. loadLogs() therefore never existed, which is also why the verbose
    button had no label. The file name now rides in a data attribute and the
    handler is bound after the rows exist, so it is no longer quoted through
    C++, a JS string, an HTML attribute and a JS call in that order.
    Every fetch on that page has a catch now. A 403 arriving as text/plain
    when the gate is closed under an open page died as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
    [app_config.h, lang.cpp, lang.h, main.cpp, page_config.cpp, web_shell.cpp]
2026-08-24 fix: keep tag text out of the JSON grammar and off the buffer edge (v0.7.0-beta.39)
    Behaviour is deliberately unchanged. Erase and both write paths have still
    not run on hardware, so nothing that decides what lands on a tag moves here.
    Brand, material and SKU are read off the tag and went into the reply
    unescaped, as did the write message, which names the filament the way the
    backend spells it. One quotation mark made the reply malformed, and the tag
    page then stopped updating without saying anything: r.json() throws and the
    poll dies with it. readText() already drops everything outside 0x20..0x7E,
    so a quote and a backslash are the whole set to handle.
    tagWriteTick() still carried the m +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
    [app_config.h, main.cpp, tag_write.cpp]
2026-08-24 feat: say which tag holds which format, and stop blaming the wrong one (v0.7.0-beta.41)
    An OpenSpool record runs 156 to 172 bytes on real spool data, so it needs
    the 496 of an NTAG215 or the 872 of an NTAG216. It has never fit an NTAG213
    and never will: 144 bytes, and page 39 is the last one. ACE needs 112 and
    fits everywhere. None of that was written down anywhere the person holding
    the tag would look, and the format picker now opens on OpenSpool, so it
    belongs on the page.
    The capacity refusal also conflated two different faults. A tag whose
    capability container is blank reports no size, lastUserPage() then assumes
    the smallest NTAG, and an NTAG215 with 496 free bytes was turned away
    clai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
    [app_config.h, lang.cpp, lang.h, main.cpp, tag_write.cpp]
2026-08-24 feat: make the footer links read as buttons (v0.7.0-beta.42)
    They were the quietest interactive thing on the page and the only one that
    did not use the page's own button vocabulary: 3.64:1 text on a fill darker
    than any real button, with a 1.20:1 border. Text on a hint of surface, not
    something that reads as pressable.
    They take that vocabulary now rather than getting a look of their own. The
    quiet button for three of them at 11.98:1, the primary one for Ko-fi at
    7.98:1. Same fills, same radius, same hover, same weights - the treatment
    the View and Delete buttons already use and that reads correctly on the
    panel.
    They were once a 2x2 block of saturated buttons directly under the logo,
    whic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
    [app_config.h, main.cpp, web_shell.cpp]
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2026-08-24 fix: stop the numeric pad from wrecking a host name (v0.7.0-beta.44)
    The address is one string shared with the browser, and since beta.30 the
    browser can put a host name in it - it advertises the fact, because a reverse
    proxy tells its backends apart by the Host header. The device screen is a
    twelve key pad with no letters on it, and it did two things with such a name:
    it loaded it into the editable field, and the back button wrote whatever the
    field held straight back to NVS. Opening the screen and leaving it was a
    write. One stray tap appended a digit to a host name and nothing could take
    it off again, because the pad cannot produce letters.
    The screen now checks whether the stored host c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
    [app_config.h, lang.cpp, lang.h, main.cpp]
2026-08-24 feat: sort the log list and let it be emptied in one go (v0.7.0-beta.45)
    Nothing sorted the list - not the firmware, not the page. What arrives is
    whatever order the FAT directory happens to hold, and the seven day rotation
    in cleanOldLogs() frees entries that later files drop into, so the dates read
    as shuffled: pre_ntp, 22, 17, 18, 19, 23, 24, 20, 21.
    Sorted in the browser, which already holds the array, newest first. The names
    order lexically the same as chronologically. log_pre_ntp carries no date and
    is checked on its own so it lands at the bottom; the obvious shortcut of
    prefixing it with a low character and letting one comparison do both does not
    work, because localeCompare ignores c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
    [app_config.h, lang.cpp, lang.h, main.cpp, sd_logger.cpp, sd_logger.h]
2026-08-24 fix: cap the log per day and let the list refresh itself again (v0.7.0-beta.46)
    Two things the SD logging plan asked for that the code never did, both found
    while writing the notes up rather than by anything going wrong.
    The megabyte cap was per boot session, not per day. sd_log_size started at
    zero on every restart, so several restarts in a day pushed the file well past
    the limit - log_2026-08-24.txt stood at 1.48 MB against a 1 MB cap - while a
    long uptime with heavy traffic silenced the log with the file still small.
    The count now belongs to a named file. Whenever the name does not match - a
    new day, the first line after a restart, the switch away from log_pre_ntp once
    the clock is set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
    [app_config.h, main.cpp, sd_logger.cpp, sd_logger.h]
2026-08-24 fix: drop the delete row when there is nothing to delete (v0.7.0-beta.47)
    An empty card kept a divider, a blank label and a greyed out button standing
    where the list had been. The whole row goes now.
    Hiding it alone was not enough: the rule that strips the border from the last
    row still counts a display:none one, so the divider under Verbose logging
    would have hung into empty space. The verbose row loses its border in the
    same breath.
    Checking that turned up a plural that had been wrong since beta.45 - the
    summary said "1 files", and "1 Dateien" in German, which is no better. One
    file now has its own wording, in both the summary and the confirm. As table
    entries rather than a rule in code: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
    [app_config.h, lang.cpp, lang.h, main.cpp]
2026-08-24 fix: write the German strings with real umlauts (v0.7.0-beta.48)
    Twenty-one transliterations across twelve strings - loeschen, Schluessel,
    Geraet, Weboberflaeche, Groesse and the rest - against 78 ä, 77 ü and 20 ö in
    the same table that do not.
    Eleven of them are from this run and are the web interface and the address
    guard. The twelfth, "stuende" in the BamBuddy cap popup, has been there since
    beta.11.
    The reason they kept happening is written down: section 6 of the i18n note
    said "LVGL Montserrat Font hat keine Umlaute. Immer ae/oe/ue verwenden." That
    sentence was already garbled when it was written, and it stopped being true
    with the move to the _ext fonts. Measured in
    src/fonts/lv_f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
    [app_config.h, lang.cpp, main.cpp]
2026-08-24 fix: the last two ss that should have been ß (v0.7.0-beta.49)
    STR_CLOSE has read "Schliessen" since 7cef23d. Sweeping the German column for
    ss turned up a second one that had not been asked about: "ausser" in
    STR_WEB_SERVER_INFO, which sits on the web screen of the device.
    The other twenty are right as they are - Adresse, muss, lässt, Passwort and
    the rest take ss after a short vowel. The rule is in the i18n note now, with
    both sides of it.
    STR_CLOSE turns out to be dead: declared, defined, and called from nowhere.
    The close buttons use LV_SYMBOL_CLOSE. Left in place, since removing an entry
    shifts the table for no gain, but the note records it.
    [app_config.h, lang.cpp, main.cpp]
2026-08-24 fix: point everything at a Discord invite that does not expire (v0.7.0-beta.50)
    The old one was dead. Discord's own API says so plainly for GzQzGa5pBG:
    "Invite is expired", code 50270. Its default is seven days and twenty-five
    uses, which is what ran out.
    It was worse than one dead link. The device carries the same invite in the QR
    code on the info screen, so anyone who flashed an older build holds a dead
    link for good. And index.html pointed at a second, different invite entirely -
    sWrSQ4Pxj, which answers "Unknown Invite" - so the two halves of the project
    had drifted apart without anyone noticing.
    Twelve places now carry TQvdxGuFcq, checked against the API before replacing:
    valid, serve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
    [app_config.h, main.cpp, web_shell.cpp]
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2026-08-24 feat: show and change FilaMan's spool status from the scale (v0.7.0-beta.58)
    FilaMan keeps six statuses per spool and the firmware used exactly one of
    them: mapSpool() collapsed status_id into an archived boolean and threw the
    other five away. A spool FilaMan considered drying or empty showed an
    ordinary weight screen as if nothing were the matter.
    The id now travels on beside the boolean, so every existing filter keeps
    reading what it always read. More Info shows it as a colour-coded chip in
    the left half of its header, which held nothing before - the box below is
    full to the pixel and could not have taken another row. Tapping the chip
    opens a 2x3 grid with all six values; six fixed values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
    [app_config.h, app_state.cpp, app_state.h, backend_api.cpp, backend_api.h, filaman_api.cpp, filaman_api.h, lang.cpp]
2026-08-24 feat: put every timestamp in the owner's time zone (v0.7.0-beta.59)
    syncNTP() passed configTime(3600, 3600, ...), and the core turns a pair of
    numbers into the TZ string "UTC-1DST": the offsets are right, the switching
    rules are missing. With no rules the C library falls back to its own default,
    which is the US calendar, so a central European device moved to summer time on
    the second Sunday in March instead of the last, and back on the first Sunday
    in November instead of the last in October. Around four weeks a year an hour
    ahead, and outside central Europe simply the wrong zone.
    That was never only a matter of stamps. daysSince() builds "noon today" from
    getLocalTime() and compares it with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
    [app_config.h, app_loop.cpp, app_settings.cpp, app_state.cpp, app_state.h, deferred_actions.cpp, deferred_actions.h, lang.cpp]
2026-08-24 fix: read a tag again when it is put back on the scale (v0.7.0-beta.60)
    Take a spool off and put it back and the scale did not read it again: no fresh
    lookup, no log line, and the screen kept the figures from the previous scan.
    Anything the backend learned in between, or another device wrote, was not
    picked up.
    The NTAG branch asked g_tag whether the tag had changed, and g_tag is display
    state. It is emptied by clearTagDisplay(), which runs from a block guarded by
    !tag_present and NO_TAG_CLEAR_MS, because the display deliberately keeps a
    spool for a minute after it is lifted. So the comparison answered "unchanged"
    for a tag that had genuinely left and come back.
    It is worse than a minute o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
    [app_config.h, app_loop.cpp, app_state.cpp, app_state.h, main.cpp]
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2026-08-24 feat(web): follow the session log, and stop the moment it is read (v0.7.0-beta.61)
    Refetching the whole ring on a timer would be the obvious way and the wrong
    one: handleOtaServerClient() runs from appLoop(), so a full ring is 17 kB
    pushed through the loop every few seconds to say nothing changed, next to the
    NFC poll and LVGL. The ring counts every line it has written instead, and a
    reader that says where it got to is sent only what came after.
    no cursor -> X-Log-Seq: 16 X-Log-Reset: 1 (the whole ring)
    ?since=16 -> 0 bytes (the idle case)
    A cursor older than the ring means lines were missed while the page was away;
    that answers X-Log-Reset, and t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
    [app_config.h, lang.cpp, lang.h, main.cpp, sd_logger.cpp, sd_logger.h]
2026-08-24 fix: keep a flickering tag from reloading everything, and ask the zone in setup (v0.7.0-beta.62)
    Two things, both fallout from the time zone and re-read work.
    The re-read fix in beta.60 traded one fault for another. Keying the decision
    on "has the poll dealt with this tag" makes a returning spool read again, which
    was the point, but the removal handler clears that marker after 2.5 s of
    silence - and an NTAG with poor coupling goes silent for longer than that
    routinely. The spool never moved, yet the display was wiped, ten labels went
    back to "-", and the whole spool was fetched over HTTP again. That loop is
    exactly what asking g_tag was there to prevent, and the reason it was written
    that w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
    [app_config.h, app_loop.cpp, deferred_actions.cpp, deferred_actions.h, lang.cpp, main.cpp, time_service.cpp, time_service.h]
2026-08-24 fix: recognise a spool as linked without lifting it off
    Copying a spool created it and attached the tag, and the scale then went on
    insisting the tag was unknown until the spool was taken off the pad and put
    back. Linking and the remote link had the same fault.
    Two markers answer "has the poll already dealt with the tag lying here":
    spoolman_queried_uid gates the Bambu path, ntag_handled_uid the NTAG one. The
    second arrived later, and the three places that finish a link only cleared the
    first - so for an NTAG the whole detection block stayed shut, and the display
    kept the answer from before the spool existed. Only the removal handler
    cleared it, which is why lifting the spool fixed it.
    The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
    [app_loop.cpp, app_state.cpp, app_state.h]
2026-08-24 fix: record the drying date in the day it happened
    A spool dried just after midnight came back as dried yesterday, and the
    reminder counted a day too many with it.
    The write took the local time, converted it to UTC and stored that. Correct as
    an instant, but every reader treated the first ten characters as the date and
    did no conversion, so between midnight and 02:00 in summer the stored day was
    the one before.
    Writing local time under a Z instead only moved the fault: Spoolman and FilaMan
    parse the Z properly and render it in the viewer's zone, which put their
    display two hours into the future.
    Both halves have to agree, so the instant stays true UTC and the reading side
    converts. isoDay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
    [bambuddy_api.cpp, time_service.cpp, time_service.h]
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2026-08-25 fix: weigh a spool adopted without a tag automatically too
    With automatic weighing on, the scale saves a settled weight everywhere -
    except for a spool taken on through the FilaMan trigger when no tag turned up.
    That path keyed on tag_present, which is precisely what it does not have, so
    the spool loaded and then sat there until someone pressed the button. Reported
    as the feature not working, and fairly so: nothing said the button was still
    required.
    The adoption carries its own mark now, and its own end. Loosening the
    condition alone would not have done: "no tag" is also what clears the
    already-saved flag for the next spool, so the same spool would have been
    written again on every pass thr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
    [app_loop.cpp, lang.cpp]
2026-08-25 feat: store tag uids as plain hex, like everything else does
    The scale wrote an NFC uid with colons, 04:B9:E5:42:44:70:80. Every other
    program around Spoolman and FilaMan writes the same identifier without
    separators, and so does this firmware's own table for three of its four tag
    conventions - extra.tag was the exception. It was inconsistent with itself as
    well: a Bambu tray uuid went into that very field as bare hex.
    The cost was not an error anywhere. A spool linked by another tool and one
    linked by the scale simply did not recognise each other, and nobody sees that
    as a fault: the spool is there, it is only never found.
    One flag does it. plain_hex on extra.tag reaches both the write an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
    [backend_api.cpp, tag_field.cpp]
2026-08-25 fix: make an unlink in FilaMan actually hold (v0.7.0-beta.75)
    Clearing rfid_uid did not free a spool. FilaMan's Bambu plugin keeps its own
    entries - external_id and the two chip slots - and the scale reads those on
    purpose, so the next scan found the spool through them and the migration wrote
    rfid_uid straight back. From the outside the unlink simply did not stick.
    Taken back now is exactly what this scale would have written, and nothing
    else. external_id only when it is a bambulab: binding and only while the
    switch that writes it is on, so an importer's spoolman:<id> stays. A chip slot
    only when it holds this very chip and only while that switch is on, so the
    plugin's own record of which c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
    [app_config.h, filaman_api.cpp, filaman_api.h, main.cpp]
2026-08-25 feat(ui): put the homescreen and more info on one grid (v0.7.0-beta.76)
    Both screens grew through a long run of single fixes, and each one moved one
    number without pulling its neighbours along. What was left was not a grid but
    a pile of individual decisions: the outer margin was 6 px in the header and
    8 px in zone 3, the three values of row A sat on baselines 80, 81 and 82, and
    the material reserve ran 20 px into the filament column because an earlier fix
    pulled filament from 260 to 232 and left the width at 160. Nothing was broken,
    which is why it survived so long - it was only never quiet.
    What everything answers to now: 8 px outer margin left and right, one baseline
    per row whatever font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
    [app_config.h, app_state.cpp, app_state.h, main.cpp]
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2026-08-25 feat(spoolman): store every identity of a tag in the native relation
    Spoolman grew a tag relation of its own on master, shipping with v0.27.0.
    The scale could already reach it, but it announced the wrong identity: for a
    Bambu tag it sent the tray uuid out of the tag's contents, while the relation
    keys on hardware uids - what a phone, an ESPHome reader and Spoolman's own
    Add tag dialog all report. A tag linked from the web UI and the same tag
    linked from the scale were two unrelated records.
    A Bambu spool carries two chips, one per flange, both holding the same tray
    uuid. Three identities are therefore worth keeping, and all three now go in:
    each chip so that any reader finds the spool, and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
    [app_config.h, app_loop.cpp, app_state.cpp, backend_api.cpp, backend_api.h, main.cpp, spoolman_actions.cpp, spoolman_api.cpp]
2026-08-25 fix(spoolman): keep the tag source guard off the network
    tagFieldEffective() asked backendHasNativeTags() whether the server has the
    relation. That probes over HTTP the first time it is called, and the guard is
    read during early boot, before lwIP exists. The result was an assert in
    tcpip_send_msg_wait_sem ("Invalid mbox") right after the banner, and a boot
    loop with no way in but the cable.
    It now asks backendMode() alone, which is a memory read. That is the narrower
    question and the right one here: whether this backend can have a tag relation
    at all, which is what the stored setting gets wrong when the backend is
    switched underneath it. Whether a particular Spoolman server actually has one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
    [app_config.h, main.cpp, tag_field.cpp]
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2026-08-25 feat(web): show the download, not a stopwatch
    The install overlay counted seconds. The device knew the byte count and the
    content length the whole time and told nobody, which is the same complaint the
    device screen's own overlay answered earlier.
    Writing an image holds the loop, so the server cannot answer from where it
    usually does. It is pumped from the progress callback instead, and
    webRequire() turns every other route away with a 503 for as long as the flash
    runs. That guard is not only about heap: /status.json is what the waiting page
    polls to decide the device is back, and answering it mid-flash would have sent
    the browser to reload against a device that had not rebooted yet.
    /api/ot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
    [page_firmware.cpp, web_access.cpp]
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2026-08-25 fix(tag): make the write path hold up on real tags (v0.7.0-beta.92)
    Testing beta.88 on hardware turned up six faults, one of them mine.
    spool_id was being stripped off the record. Swapping it for sm_id was done
    on the theory that sm_id is what a reader resolves; it is not. The word
    appears nowhere in FilaMan, which looks for spool_id, so a tag written
    through the trigger arrived there as spool 0. Both keys go on the tag now,
    and a record the server sent is passed through untouched.
    The UID reached FilaMan's rfid_uid with colons. backendPatchSpoolTag()
    normalises for FilaMan and filamanLinkRfidUid() did not, so its idempotence
    check never matched, its holder search found nobody, and a tag w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
    [app_config.h, app_loop.cpp, app_settings.cpp, filaman_api.cpp, lang.cpp, lang.h, main.cpp, tag_write.cpp]
2026-08-25 fix(web): open the switch a device screen sends the user to (v0.7.0-beta.94)
    Every screen that points at a web page pointed at one that answers 403.
    web_config and web_maint are off after a fresh flash, so the setup step
    showing http://<device>/backend led into a wall, and the 403 page names a
    settings menu the wizard does not offer. The credentials cannot be typed
    on the numpad either, which left FilaMan and BamBuddy unconfigurable
    without first finding a switch nothing had mentioned. Two users reported
    exactly that.
    Pressing the button is the request, so showOtaBrowserScreen() now opens
    the gate its target needs before drawing, master included - webGateOpen()
    is master_on && config_on, so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
    [app_config.h, main.cpp, web_shell.cpp]
2026-08-25 feat(ui): raise the spool list to what the pool actually holds (v0.7.0-beta.96)
    The list limits were set in April against a device that no longer exists: a
    48 kB LVGL pool in which every visited screen also stayed resident, measured
    at 30 kB free falling to 4.5 kB across a single session. 95ad705 doubled the
    pool to 96 kB and c01fb42 released the screens, both in August, and nothing
    went back to re-check the number.
    logLvMem() now brackets every list build, so the question is answerable
    instead of arguable. On hardware a spool row costs 1090 bytes, and there are
    56 kB free when the list opens on a device that has been navigated around for
    a minute. The default of 16 used 31 percent of that.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
    [app_config.h, app_settings.cpp, lang.cpp, list_limits.cpp, main.cpp]
2026-08-25 feat(spoolman): record a weighing through /measure, with the tare it can resolve (v0.7.0-beta.97)
    Spoolman is handed the gross weight and does the arithmetic itself, the same
    shape FilaMan and BamBuddy already get, so all three backends behave alike.
    That is what the endpoint is for: it subtracts the tare, derives the used
    weight and stamps first_used and last_used without a second request.
    Two things it does that the plain PATCH does not, both deliberate on the
    server side: a reading above the initial gross weight raises the spool's
    initial weight to match, and a reading below the empty weight is clamped to
    empty instead of going negative.
    The gross value handed over is exactly what the p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
    [app_config.h, backend_api.cpp, main.cpp, spoolman_api.cpp, spoolman_api.h]
2026-08-26 fix(web): stop the firmware page arming an install it should not offer
    A check answers in two directions and the route only wrote one of them down.
    update_available was set when something newer turned up and never cleared
    when nothing did, while gh_latest_version was overwritten either way. Moving
    the channel from pre-release to release therefore left the badge lit and
    gh_latest_version pointing at a build below the running one - and body()
    builds the Install button out of exactly those two values, so it came back
    armed on a downgrade. The browser corrects it once a check answers, except
    that an automatic check which fails says nothing by design, which is the case
    where the stale button surv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
    [ota_state.cpp, ota_state.h, page_firmware.cpp]
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2026-08-26 refactor(web): one jsonEsc instead of four
    Four pages carried their own copy, and they had drifted: three collapsed
    every control character to a space, the fourth turned a newline into \n and
    dropped the CR. The difference was not visible until something multi-line
    went through, and page_tags does exactly that - jsonEsc(tagCachedContent())
    flattened an NDEF text record of several lines into one run of spaces.
    The version that handles newlines is the one that stays, next to jsStr() in
    web_shell, which is where the rest of the escaping for these pages already
    lives. It also reserves its buffer up front: it appends a character at a
    time, Arduino String grows in steps, and release notes run to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
    [page_config.cpp, page_firmware.cpp, web_shell.cpp]
2026-08-26 build: make a short STRINGS table a compile error (v0.7.0-beta.98)
    STR_COUNT sized the array, so a missing entry could not be caught: the
    compiler padded the rest with nullptr and every string from the gap onwards
    read as the wrong one, in both languages, with a scrambled UI as the only
    symptom. Two branches appending here is an ordinary merge, and this one -
    seven commits adding twenty-four strings against four commits adding their
    own - was exactly that shape.
    The bound now comes from the initializer rather than from the header, which
    is what lets sizeof disagree with STR_COUNT at all. Verified in both
    directions: the tree as it stands builds, and an enum entry without its row
    fails with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
    [app_config.h, lang.cpp, lang.h, main.cpp]
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2026-08-26 refactor(web): one post and one flash for every page (v0.7.0-beta.104)
    There were three flash() implementations with three different signatures, and
    the POST boilerplate stood nine times in page_config.cpp alone. They are one
    route now, /app.js, cached the same way the stylesheet is.
    A route rather than something the shell pastes into each page, because the
    last attempt at sharing this was a copy - page_config.cpp carries the scar in
    a comment: when the pages were split the shared block stayed behind on one of
    them and every Save button called a function that was no longer there.
    flash(id,text,bad,ms,after) covers all three old shapes: no ms leaves the line
    standing, which is what a host t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
    [app_config.h, main.cpp, page_config.cpp, web_shell.cpp]
2026-08-26 feat(settings): one registry, rendered by the device and the browser (v0.7.0-beta.106)
    A backend option was ~27 lines of LVGL for six pieces of information, the
    nine-line block that turns a row's arrow into ON/OFF stood word for word in
    six files, and none of it existed in the web interface at all. Adding one
    meant building it twice, and the two would drift - the way the two tab tables
    did before WebPage replaced them.
    settings_registry.h declares each option once: key, kind, scope, where the
    value lives, its strings, and the handful of hooks the existing screens
    actually need. The shape follows TagFieldSpec, which had already solved the
    hard part - StringIDs as plain numbers, so the header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
    [app_config.h, app_settings.cpp, lang.cpp, lang.h, main.cpp, settings_registry.cpp, settings_registry.h]
2026-08-26 feat(web): switch the backend from the browser (v0.7.0-beta.107)
    A row of tabs above the address, one per backend, and the page redraws for
    whichever is active - address, credentials and options all belong to one
    manager each and survive the switch, so switching back finds everything where
    it was. Asked for with a confirm() naming the target: the action stays
    possible, the intent has to be deliberate.
    The larger part is what the switch now lets go of. backendApplyMode() replaces
    a static in backend_screen.cpp that did three things - set the mode, mark
    reachability unknown, clear the tag display - and left the rest standing,
    where most of it was then wrong:
    - an open FilaMan link nobody w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
    [app_config.h, app_loop.cpp, backend_switch.cpp, backend_switch.h, deferred_actions.cpp, deferred_actions.h, filaman_api.cpp, filaman_api.h]
2026-08-26 feat(web): let the panel wake setting be switched at all (v0.7.0-beta.108)
    g_wake_on_load had been documented in user_options.h since the day it was
    written - "Switchable for a scale that shares a bench with something that
    knocks it" - and was never switchable. loadPrefs() read it, display_power.cpp
    acted on it, and no line in the firmware ever wrote it. The only occurrence of
    its NVS key in the whole tree was the read.
    A Panel card at the bottom of the settings page is the missing half. State
    rather than a toggle on the wire, the same choice /api/mdns made: the browser
    sends what it wants the value to be, so two tabs open on the same page cannot
    talk past each other, and a failure puts the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
    [app_config.h, lang.cpp, lang.h, main.cpp, page_config.cpp]
2026-08-26 fix(web): put the panel switch beside the time zone (v0.7.0-beta.109)
    One switch and a line of explanation do not need a full width row of their
    own. Half width lands it in the right column next to the time zone, and the
    two cards come out the same height.
    The hint lost the half a reader cannot act on. Why waking is on by default is
    already in the label; what belongs under it is when to turn it off.
    [app_config.h, lang.cpp, main.cpp, page_config.cpp]
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2026-08-26 feat(scale): notice when the ADC leaves the bus (v0.7.0-beta.111)
    A user's scale showed -3487423847234 g and his serial filled with
    "i2cWriteReadNonStop returned Error -1" in pairs every 200 ms. The bus was
    dead - a cold solder joint, as it turned out - but the firmware had no way to
    say so, and the reason is one line in a library:
    Adafruit_BusIO_Register::read(void) returns -1 on a failed transfer.
    So every register of an absent NAU7802 reads back as all ones. available()
    finds the conversion-ready bit among them and answers true forever, read()
    sign-extends to a sample of -1, and the loop dutifully turns that into a
    weight five times a second. Worse, it survives: tare stores -1 as the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
    [app_boot.cpp, app_config.h, app_loop.cpp, app_settings.cpp, deferred_actions.cpp, deferred_actions.h, lang.cpp, lang.h]
2026-08-26 fix(ui): stop a full LVGL pool from taking the device down (v0.7.0-beta.112)
    Three panic reboots in one test session, all of them at or shortly after a
    list build, and the card said nothing beyond "PANIC (exception/abort)". The
    note in ui_common.h said an exhausted pool cannot do that - LV_ASSERT_MALLOC
    turns it into while(1), a freeze. That note is wrong for the case that
    matters, and the simulator reproduces it in one run:
    lv_obj_class_create_obj() returns NULL on a full pool, asserting nothing
    lv_label_create() passes it to lv_obj_class_init_obj() unchecked
    lv_obj_mark_layout_as_dirty obj->layout_inv = 1, on a null pointer
    So a list that outgrows the pool is a null der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
    [app_boot.cpp, app_config.h, app_loop.cpp, breadcrumb.cpp, breadcrumb.h, main.cpp, sd_logger.cpp]
2026-08-26 feat(tag): make writing a tag after a link a choice, not a habit (v0.7.0-beta.113)
    Linking a spool with an NTAG on the reader asked "write tag?" every single
    time, in every backend mode, with the format hard coded to OpenSpool. On the
    NTAG213s used in testing that question could only ever end one way:
    TagWrite: error - OpenSpool needs 176 bytes, this tag holds 144
    So the question is now a setting, off by default, and the format is a setting
    next to it. Both live in Settings > Scale under the location prompt and in a
    section of their own at the bottom of the tag page, because what goes on a tag
    is an agreement between the tag and whoever reads it - no backend ever sees
    it, and there is no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
    [app_config.h, app_loop.cpp, app_settings.cpp, deferred_actions.cpp, deferred_actions.h, lang.cpp, lang.h, main.cpp]
2026-08-26 feat(ui): the five things the last test run tripped over (v0.7.0-beta.114)
    Calibration screen: the reset is on it now, as a red 68x68 button in the empty
    column right of the numpad, mirroring the whole-gram toggle on the left. It
    goes through the same confirmation and the same deferred action as the row in
    Settings > Scale, so there is still one place that performs a reset. That
    action used to rebuild the scale menu and show it, which from the calibration
    screen would have made a menu appear out of nowhere - it now refreshes the
    factor line and leaves the screen where it is.
    Web drying page: the unit stood alone at the bottom left, outside every card,
    because the paragraph holding it was em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
    [app_config.h, app_loop.cpp, http_progress.cpp, http_progress.h, lang.cpp, lang.h, main.cpp]
2026-08-26 fix(http): close the stall bracket on every path (v0.7.0-beta.115)
    The location prompt stopped appearing after beta.114, and the cause is the
    bracket I added there to keep countdowns from expiring during a blocking
    fetch. querySpoolman() returns from the middle of its retry loop when the
    second attempt fails, and the hand-written httpStallEnd() after the loop was
    never reached on that path:
    httpStallBegin();
    for (attempt = 1; attempt <= 2; attempt++) {
    if (code != 200 && attempt == 2) return; // bracket stays open
    }
    httpStallEnd();
    s_stall_depth is static and only httpStallEnd() decrements it, so one trip
    through that return left it at 1 for the rest of the boot. httpStallTot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
    [app_config.h, http_progress.h, main.cpp]
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2026-08-27 fix(bambu): read "Tough+" and "Tough Plus" as the same subtype (v0.7.0-beta.117)
    A Tough+ tag produced an empty link list, and it was not the material name
    that did it. In the FilaMan instance material_type reads a clean "PLA" or
    "PLA-PLUS", both of which pass the three-character test. The subtype filter
    killed it: the tag spells the line "Tough+", the FilamentDB spells it
    "Tough Plus" in the designation and "tough-plus" in the subgroup, and the
    comparison was a literal substring search.
    Measured on the real catalogue, 285 spools, with a Tough+ Cyan tag: six
    spools fell to the colour filter (yellow, black, white, distance 381 to 427
    against a limit of 120) and the one that matched the colou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
    [app_config.h, filaman_api.cpp, main.cpp]
2026-08-28 chore: move every Discord link to the new invite
    The old invite (TQvdxGuFcq) is replaced by xadskCrPFu everywhere it
    appears, so no surface is left pointing at the previous one:
    - README, build guide and the web flasher page
    - the QR code and its printed caption on the device info screen
    - the link bar in the web interface
    The device screen carries the URL twice, once for the QR payload and
    once as the text under it. Both are in the same array pair in
    info_screen.cpp and both had to move, or the code and the caption
    underneath it would send people to different servers.
    [web_shell.cpp]
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2026-08-28 feat(diag): name the fault and suggest the fix, instead of two red letters (v0.7.0-beta.124)
    A freshly built scale that misbehaves gave its owner almost nothing to
    go on: the header chips "SCL!" and "NFC!" are four characters wide,
    carry no explanation and lead nowhere, so a wiring mistake and a missing
    calibration looked identical from the outside. Both kept turning up in
    the Discord.
    The firmware already knew the answer in nearly every one of those cases.
    Now it says so, on the home screen, with what to do about it.
    Seven findings, one at a time, highest priority first - three warnings
    at once gets none of them fixed:
    - scale not calibrated. cal_factor is still CAL_FACTOR_DEFAULT, so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
    [app_config.h, app_loop.cpp, deferred_actions.cpp, deferred_actions.h, diagnostics.cpp, diagnostics.h, lang.cpp, lang.h]
2026-08-28 fix(weight): send whole grams to every backend (v0.7.0-beta.125)
    Spoolman was the last backend still receiving decimals. FilaMan and
    BamBuddy have each had a roundGrams() on the way out for a while, and
    the comment in filaman_api.cpp said as much: "Spoolman keeps receiving
    the unrounded value, its behaviour is unchanged."
    That decimal was the source of the absurdly long numbers in the web UI.
    Spoolman does not store used_weight, it derives it as initial minus
    remaining, and 1000.0 - 748.3 comes back out of a float as
    251.70000000000005. Whole grams cannot produce that - the subtraction
    stays exact. A load cell under a filament spool has no meaningful
    accuracy below a gram anyway, so nothing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
    [app_config.h, app_settings.cpp, main.cpp, spoolman_api.cpp, user_options.cpp]
2026-08-28 chore(release): v0.7.0
    Drops the suffix rather than carrying it into the release. That is the
    whole point of the naming rule: within one X.Y.Z the ranking in
    version_compare.cpp is "-beta" = 0, "-beta.N" = N, and no beta at all
    = 999, and the CI guard mirrors it. So v0.7.0 scores 7000999 against
    7000125 for the last internal build, while a v0.7.0-beta would score
    7000000 and be refused as a downgrade against its own beta series.
    Naming it v0.7.0 is also what routes it correctly: the workflow writes
    the tag into version.json's "stable" only when it does not end in
    -beta.<n>, and marks the GitHub release as a pre-release only when the
    tag contains "-beta.". Both go the right way here, so devi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
    [app_config.h, main.cpp]
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2026-08-28 docs: bring the README up to v0.7.0
    Three backends instead of two, the tag writing, the rebuilt web interface
    and the self diagnosis were all missing, and the roadmap still listed the
    translated web UI as pending.
    The requirement that the scale needs a filament manager moves to the top as
    a GitHub note box: it used to sit as a quiet blockquote under three
    paragraphs of prose, and people were building the hardware without knowing
    they needed a server at all.
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2026-08-28 docs: bring the README up to v0.7.0
    Three backends instead of two, tag writing, the rebuilt web interface and
    the self diagnosis were all missing, and the roadmap still listed the
    a note box: it used to sit as a quiet blockquote under three paragraphs of
    prose, and people were building the hardware without knowing they needed a
    server at all.
    Each backend section carries its logo, FilaMan gains the phone app note and
    the Bambu Usage Tracker recommendation, and the credits lead with Simon-CR,
    who built the paged web interface, tag writing from the browser, FilaMan's
    device tag protocol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
2026-08-28 fix(diag): name the pin the reset wire is actually on (v0.7.1-beta.1)
    The "NFC reader stays silent" diagnosis told people to check the RST wire
    on pin 7 (brown). Pin 7 is GPIO14 and nothing drives it. The reset line is
    pin 5 (blue), which is what PN532_RESET = 12 drives, and what the wiring
    comment in main.cpp and the build guide have said all along.
    That finding exists for one case: the PN532 acknowledges 0x24 but answers
    no command, which is usually a floating reset line. So the single sentence
    naming the wire to check was pointing at the wrong wire, in the one place
    where the reader has no other way of working it out.
    Both languages.
    [app_config.h, lang.cpp, main.cpp]
2026-08-29 feat(nfc): give the reader a reset that actually reaches it (v0.7.1-beta.6)
    The PN532's reset has never worked on any SpoolmanScale. The build guide sent
    the orange RST wire to the header opposite the labelled one, where the module
    brings out an output rather than its RSTPD_N input, and it said so from the
    first published version in May 2026 until August. RSTPD_N was left unconnected,
    idling high through its pull-up, so the reader came up fine and nobody noticed
    that the line did nothing.
    Measured on the bench rather than reasoned about: with the wire on the old pad,
    holding GPIO 12, 13, 14 or 21 low leaves the reader answering
    GetFirmwareVersion with a healthy 0x32010607. Moved to RSTPDN,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
    [app_boot.cpp, app_config.h, app_loop.cpp, deferred_actions.cpp, deferred_actions.h, lang.cpp, lang.h, main.cpp]
2026-09-10 feat(spoolman): copy the chip UID into rfid_tag for Happy Hare (v0.7.1-beta.7)
    Happy Hare v4 resolves its gate readers against extra.rfid_tag and nothing
    else, and those readers only ever see a chip's hardware UID. A Bambu spool is
    bound here by its tray uuid, which no gate reader can read, so a spool the
    scale recognises perfectly well stayed invisible at the printer.
    The scale now writes the hardware UID of whatever is on the reader beside the
    binding, in a comma separated list, on every lookup that found a spool rather
    than only on an explicit link - a library that is already bound would
    otherwise have to be relinked spool by spool to get anything out of it. A
    Bambu spool carries a chip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
    [app_config.h, app_state.cpp, app_state.h, backend_api.cpp, backend_switch.cpp, lang.cpp, lang.h, main.cpp]
2026-09-10 feat(nfc): ask for the tag on the other flange after a link (v0.7.1-beta.9)
    What was asked for was a second reader, one per side of the case, so a spool
    with a chip on each flange is recognised whichever way round it lies. The
    hardware has one reader, so a flow replaces the part: link, turn the spool
    over, done. A countdown popup takes whatever tag turns up next and binds it
    to the spool the link just went to.
    A Bambu spool half solved this already - both chips carry the same tray
    uuid, so the second one was appended the next time that side happened to
    face the reader. The question only says when that moment is. Two NTAGs share
    nothing at all, and without it the spool had to be looked up by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
    [app_config.h, app_loop.cpp, backend_api.cpp, backend_api.h, filaman_api.cpp, filaman_api.h, lang.cpp, lang.h]
2026-09-10 feat(scale): let a device be built without a load cell (v0.7.1-beta.10)
    A SpoolmanScale can be built from display and reader alone, and is then a
    spool terminal rather than a scale: hold a tag against it, see the spool,
    give it a location and a printer.
    Off takes the weighing side out of the way instead of leaving it broken on
    screen. The NAU7802 is never probed, the home screen carries a note where
    the weights were and nothing where TARE was, "update weight" becomes the
    location button, calibration and bag weight leave the menu, and the
    diagnosis stops reporting a chip nobody fitted as a fault - it now says how
    to switch it off instead.
    On by default, so a device with a scale notices noth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
    [app_boot.cpp, app_config.h, app_loop.cpp, app_settings.cpp, app_state.cpp, app_state.h, deferred_actions.cpp, deferred_actions.h]
2026-09-12 feat(ams): show the printer's bays and offer one after weighing (v0.7.1-beta.28)
    AMS view for FilaMan and BamBuddy: bays grouped by unit, browse and pick
    modes, printer stepping, reload. A presence probe decides whether the
    header chip and the zone-4 button appear at all. After weighing a known
    spool on BamBuddy, lifting it opens the picker and assigns the bay.
    Carried along in the same range of builds:
    - scale: one writer for "load cell fitted"; BamBuddy no longer renders a
    display-only device as a broken scale
    - spoolman: fall back to extra.tag on a server without the tag relation,
    say so once, and tick what is really in force
    - filaman: unlink clears both RFID slots in one PATCH, loo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
    [ams_pick.cpp, ams_pick.h, ams_presence.cpp, ams_presence.h, ams_slots.h, app_config.h, app_loop.cpp, app_state.cpp]
2026-09-12 fix(ams): let the picked bay reach the server (v0.7.1-beta.29)
    The bay picker never assigned anything. A tap parked the answer and asked
    the page to close; the close ran first, went through showMainScreen(),
    and destroyAmsView() there cleared the parked answer one pass before it
    would have run. destroyAmsView() now leaves the pick alone, and a page
    that goes away without a tap hands the callback (-1, -1) so the note is
    dropped instead of being asked again on the next removal.
    Also in the AMS code that arrived with beta.28:
    - BamBuddy reported every idle printer as "printing 0 %": job_percent
    was never set to AMS_JOB_NA
    - the scale menu's `if (g_scale_fitted)` had no braces and guarded the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
    [ams_pick.cpp, ams_presence.cpp, app_config.h, backend_switch.cpp, bambuddy_api.cpp, deferred_actions.cpp, deferred_actions.h, filaman_api.cpp]
2026-09-12 fix(ui): stop writing to screens that are gone (v0.7.1-beta.30)
    Three label pointers were written from the loop after their screens had
    been deleted: the update badges on the Settings tile, the Firmware row
    and the GitHub button (written whenever the daily check answers), the
    browser upload's status line (written every 250 ms during an upload),
    and the GitHub screen's status line (written by the parked check up to
    ten seconds after the screen closed). Each was a write into a freed
    LVGL pool block, and LV_USE_ASSERT_OBJ is off. The pointers now go with
    their screens - one helper per screen that carries them - and the badge
    setter checks lv_obj_is_valid() as a second lock.
    Six overlays were o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
    [app_config.h, app_loop.cpp, main.cpp]
2026-09-12 fix(web): ask who is calling before opening a gate (v0.7.1-beta.31)
    The three gates said whether a feature was on, never who was allowed to
    use it. Three questions are now asked ahead of every gate:
    - Is the Host header one of the scale's own names (address, device name,
    bare label, mDNS name)? A page whose DNS flips to the scale's LAN
    address could otherwise read every reply as if it were same-origin.
    - Does a request that changes something carry a browser Origin, and if
    so, is it ours? /app.js posts text/plain, which needs no preflight, so
    any page the owner visited could repoint the backend, restart the
    scale or submit a firmware image through a hidden form. The upload
    handle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
    [app_config.h, backend.cpp, lang.cpp, lang.h, main.cpp, page_firmware.cpp, web_access.cpp, web_shell.cpp]
2026-09-12 fix(ota): trust only what was verified (v0.7.1-beta.32)
    Every connection to GitHub ran setInsecure(), including the one the
    firmware image came down: whoever answered DNS for github.com could
    hand the scale an image and it would flash it. All four now validate
    against the certificate bundle the SDK ships (Mozilla's root store,
    64 kB of flash). github.com chains to Sectigo today, the release assets
    and GitHub Pages to Let's Encrypt; the bundle holds both.
    The download is summed as it is written, and the release workflow now
    publishes the image's SHA-256 next to the tag in version.json. A tag the
    background check found is flashed only if the sum matches; a tag picked
    by hand on the GitHub scr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
    [app_config.h, github_release.cpp, github_release.h, main.cpp, ota_state.cpp, ota_state.h, page_firmware.cpp, update_check.cpp]
2026-09-12 fix(nfc): survive the tags the reader is allowed to see (v0.7.1-beta.33)
    Every uid buffer handed to the PN532 was 7 or 8 bytes, and the library
    copies whatever length the chip reports without looking at the buffer.
    ISO 14443-3A has a third size, 10 bytes - some DESFire and transport
    cards - and one of those wrote three bytes past the buffer onto the
    loop task's stack. All five buffers are NFC_UID_MAX now.
    lastUserPage() summed the capability container in eight bits. From CC
    byte 0x7F up - an NTAG I2C plus 2k reports 0xEA - the sum wrapped to
    page 1, after which eraseTag() ran no pass at all and reported success
    with the record still on the tag. Summed in sixteen bits and clamped to
    the last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
    [app_config.h, app_loop.cpp, main.cpp, nfc.cpp, nfc.h, tag_write.cpp]
2026-09-12 fix(backend): answer the question that was asked (v0.7.1-beta.34)
    - BamBuddy's spool counter returned the HTTP code on failure where the
    other two backends return -1, so a key without the inventory scope
    showed "403 spools" on the connection screen.
    - Changing the backend address left every cache of the old server
    standing. The FilaMan location list is keyed on a five minute TTL
    only, and a spool given a location within that window was PATCHed
    with an id from the instance just left - HTTP 200, wrong shelf. Both
    entry points go through backendApplyHost() now, which drops the
    location list, the extra-field list and the AMS presence answer.
    - A FilaMan inventory that stopped short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
    [app_config.h, backend_api.cpp, backend_api.h, backend_switch.cpp, backend_switch.h, bambuddy_api.cpp, filaman_api.cpp, filaman_api.h]
2026-09-12 fix(prefs): say so when a setting did not take (v0.7.1-beta.35)
    Every NVS write ignored both the open and the write result. On a full
    or worn partition a setting was a silent no-op: the screen said saved,
    the next boot had forgotten it, and nothing in the log explained why.
    The setters return whether the write took, a failed open falls back to
    the default instead of reading an unopened handle, and a failure is
    logged once a minute at most so a broken partition cannot bury the log
    under its own symptom.
    [app_config.h, main.cpp, prefs_store.cpp, prefs_store.h]
2026-09-12 fix(web): stop waiting five seconds for a browser that opened a socket and left (v0.7.1-beta.36)
    The WebServer library serves one connection at a time and waits five
    seconds for an accepted socket to send its request. Chrome opens sockets
    it then does not use - a spare on hover, another on navigation - and one
    of those parked every other request for five seconds; with the accept
    backlog at four the browser saw "site not reachable" in between.
    Measured on the device: a request behind an idle socket took 4.6 s,
    alone 0.07 s. handleClient() is virtual and everything it touches is
    protected, so the loop is overridden with a one second patience for a
    silent socket and Nagle switched off for the a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
    [app_config.h, main.cpp, web_access.cpp]
2026-09-13 fix(ui): no request from a settings button (v0.7.1-beta.37)
    Four settings flows ran their network calls inside the LVGL callback of
    the button that asked for them, with the touch panel dead for the
    duration: the GitHub update button (a minute of download and a flash
    write), the backend address save (health check, version and spool count,
    up to thirteen seconds), the extra-fields test button, and the WiFi
    setup's scan and its ten second connect attempt. Each now parks a flag
    and appLoop() does the work one pass later, the way the downgrade path
    and the other parked actions already did. The WiFi password is copied
    out of the textarea before that screen is gone.
    The address test's result line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
    [app_config.h, app_loop.cpp, deferred_actions.cpp, deferred_actions.h, lang.cpp, lang.h, main.cpp]
2026-09-13 fix(ui): no request from a weight button (v0.7.1-beta.38)
    Nine buttons of the weight popups wrote to the backend from inside their
    own LVGL callback: the two weight buttons, new spool, the three places
    an empty spool weight can go, archive, and BamBuddy's two answers to the
    cap question. Each request held the touch panel for its length, on the
    most used path of the device.
    The popup now records what was asked - which write, which number, and
    the pad reading the AMS note wants - in one job slot, and appLoop() runs
    it a pass later. One slot is enough: the popups are modal and a second
    press cannot land before the first has run. The popups themselves are
    deleted asynchronously, since every clo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
    [app_config.h, app_loop.cpp, main.cpp]
2026-09-13 fix(ui): no request from a link, copy or location button (v0.7.1-beta.39)
    The last eleven places where a button's own LVGL callback reached the
    backend: the two "link anyway" buttons of the warning popups, the yes of
    the spool list confirmation, "from the list" on the link entry (an
    inventory fetch of several seconds), the copy entry's active and
    archived buttons (the same fetch), the copy confirmation, the new-from-
    tag confirmation, the unlink confirmation in More Info and the two ways
    of picking a location. Each parks what it was asked - an id, a flag, a
    copied name - and the module's deferred handler does the work from
    appLoop() one pass later, closing the popups on the way.
    The popups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
    [app_config.h, main.cpp]
2026-09-13 fix(ui): every dialog can be closed by the navigation, tag popups readable (v0.7.1-beta.40)
    Nine popups were locals of the callback that built them: the link
    confirmation on the spool list, the three questions the confirm popup
    opens (tare scope, auto weight, label weight), the unlink confirmation,
    the extra-fields confirmation, the reboot and factory-reset questions and
    the NFC reset hint. Nothing outside could reach them, so a navigation -
    a backend switch from the browser, say - left them drawn over the next
    screen, and a hidden confirm popup kept uiModalWaiting() true from
    underneath. Each now has a file pointer and a close function, and
    hideAllOverlays() closes them all.
    Buttons that d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
    [app_config.h, main.cpp]
2026-09-13 fix(services): no flash write inside an event callback, every backend call stops the clocks (v0.7.1-beta.41)
    Settings changed by a button used to be written to NVS from inside the
    callback, 10 to 100 ms each. The loop now turns write deferral on around
    lv_timer_handler(): put*() parks the value in a small queue and returns,
    the loop flushes the queue the moment LVGL is done dispatching. A key
    written twice in one pass keeps one slot, get*() answers from the queue
    first so a callback that writes and reads back sees its own value, and a
    full queue or an oversized string writes directly as before. The three
    restarts reachable from a callback flush by hand first; the factory reset
    discards the q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
    [app_config.h, app_loop.cpp, backend_api.cpp, http_progress.h, main.cpp, prefs_store.cpp, prefs_store.h]
2026-09-13 feat(tags): second tag after an outside link, a tag on another spool can be moved, language written on confirm (v0.7.1-beta.42)
    A link made from Spoolman's own web page resolved the tag on the reader
    through the recheck, and that was all: the tag write question and the
    second tag question, which a link from the scale gets, never came. The
    follow-ups of a link are one function now, called by doLinkPatch() and,
    once the loop's re-read has found the spool, for a link that arrived from
    outside. A write from the scale's own tags page arms the second tag
    question as well.
    Spoolman refuses a tag that another spool holds, and the refusal stood in
    the status line until the NFC poll repainted it a mo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
    [app_config.h, app_loop.cpp, lang.cpp, lang.h, main.cpp]
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2026-09-13 chore: make the rules and the code agree (v0.7.1-beta.44)
    The em-dash rule was broken 94 times, all in comments. Replaced with the
    plain dash the rule asks for.
    Two libraries were unpinned against the project's own rule; both are
    pinned to the version that has been building all along (NAU7802 1.0.8,
    LovyanGFX 1.2.27), so CI builds what the bench builds.
    Eight literals that showed English in a German UI or the other way round
    moved into the string table: minutes on the display screen, days in the
    drying table, the fresh weight in the spool lists, an unknown vendor, the
    missing-WiFi note on the dried button. 67 string ids nothing referenced
    are gone, enum and table checked against each other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
    [app_config.h, app_loop.cpp, backend_api.cpp, bambuddy_device.cpp, lang.cpp, lang.h, main.cpp]
2026-09-13 chore(json): ArduinoJson 7 forms instead of the deprecated ones (v0.7.1-beta.45)
    StaticJsonDocument<N> and DynamicJsonDocument(N) have been a plain heap
    JsonDocument since version 7, the size argument ignored; they are written
    as what they are. createNestedObject() becomes add<JsonObject>() on an
    array and ["key"].to<JsonObject>() on an object.
    containsKey() answered "the key is there", null value included, and the
    recommended replacement obj[key].isNull() says "there and not null". At
    every lookup site that is the better question - a null tag or null
    last_dried was read as the string "null" before. The one place where the
    key's presence itself is the question, the FilaMan probe for the sec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
    [app_config.h, filaman_api.cpp, main.cpp, spoolman_api.cpp]
2026-09-13 chore(strings): copyT() terminates what strncpy left to chance, names cut at UTF-8 boundaries (v0.7.1-beta.46)
    Every strncpy(buf, T(id), sizeof(buf) - 1) in the tree - 232 of them -
    becomes copyT(buf, sizeof(buf), id), which terminates. About forty had no
    terminator line after them and were correct only because every current
    translation happens to fit; a longer one would have run the label off the
    end of the buffer.
    The list titles cut vendor and material names with %.8s and %.16s, which
    splits a two byte character and puts a box where the letter was. They go
    through utf8Cut() now, which backs off to the start of the sequence the
    cut landed in. The vendor group table is filled the same way.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
    [ams_pick.cpp, app_boot.cpp, app_config.h, app_loop.cpp, lang.h, main.cpp]
2026-09-13 feat(ui): one caption style, degree signs, one language per screen, one weight format (v0.7.1-beta.47)
    Captions on the main screen were half with a colon and half without.
    None carries one now; colour and size already set them apart from the
    values under them. The backend caption in zone 4 and the "weighed"
    caption follow.
    Temperatures read "220 - 250 C". The degree sign is the first glyph of
    the fonts' extended range, so it costs nothing: "220 - 250 °C" on the
    main screen, in the AMS view and in its drying line.
    German screens showed "Cal. | Bag | Mehr", "Sleep nach", "Reset Cal.",
    "WiFi Einstellungen" beside "WLAN Status". The German side says WLAN
    everywhere, the tile reads "Kalibriere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
    [app_config.h, backend.cpp, lang.cpp, lang.h, main.cpp]
2026-09-13 feat(ui): the screens behind the tiles, tidied (v0.7.1-beta.48)
    Scale menu: the location prompt row said AUS twice, as subtitle and as
    state; it is a switch row now like the others, state on the right only.
    Display: the brightness slider sits 20 px in from the edges so the knob
    is whole at 255. Stages that cannot be chosen are drawn readable and
    merely unpressable instead of nearly invisible. The dim row's minus sign,
    which read as a placeholder, is an eye.
    Drying reminder: the sealed column has room for its header, the table is
    shorter and the footnote no longer touches its edge, in a colour that can
    be read.
    Calibration: the hint is one line so the scale/factor row underneath has
    the li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
    [app_boot.cpp, app_config.h, app_loop.cpp, lang.cpp, main.cpp]
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2026-09-13 fix(ams): a bay picker closed without a tap hands over to the location question (v0.7.1-beta.50)
    With the location prompt and the bay picker both on, the picker took the
    removal event for itself: a bay chosen means no shelf to ask about, which
    is right, but closing the picker with X dropped the note and asked nothing
    more. The X now leads on to the location question under the same
    conditions the AMS question's "no" branch uses - the spool is still the
    one that was asked about, the prompt was not already shown for it.
    The waiting line is amber again. The quiet blue from beta.48 read worse
    on the panel than the amber it replaced, and after a restart the main
    screen had painted it amber anyway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
    [ams_pick.cpp, app_config.h, app_loop.cpp, main.cpp]
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2026-09-13 fix(web): a request waiting behind an idle socket is served now, not after its second (v0.7.1-beta.53)
    The server takes one client at a time and gives a socket that has sent
    nothing one second before letting go. Browsers open connections on
    speculation and leave them empty, so the tab the user clicked regularly
    queued behind one of those for the full second. The idle socket now keeps
    its second only while no other connection is waiting in the backlog.
    [app_config.h, main.cpp]
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2026-09-13 release: v0.7.1
    Everything since v0.7.0. The printer's AMS on the scale (view for FilaMan
    and BamBuddy, bay pick for BamBuddy, the view inside FilaMan's question),
    two tags on one spool (asked after a link, also after a link from outside,
    a tag on another spool can be moved), the chip UID for Happy Hare, a
    reset line for the NFC reader that is measured before it is used, a scale
    built without a load cell, a password and a faster server for the web
    interface, verified firmware downloads, and the results of a review of the
    whole firmware: no writes to screens that are gone, no request from a
    button, every dialog closable by the navigation, settings that say when
    they did not save, a worker tas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
    [ams_pick.cpp, ams_pick.h, ams_presence.cpp, ams_presence.h, ams_slots.h, app_boot.cpp, app_config.h, app_loop.cpp]
2026-09-13 fix(web): the GitHub check no longer says "busy" for a minute after the firmware page loads (v0.7.2-beta.1)
    The page fetches the notes of the installed release when it opens. Since
    the worker, that request answers 202 first, and the page took the 202
    as the answer: it never asked again, the finished notes sat uncollected
    in the worker's slot until the tick dropped them a minute later, and
    every check in that minute was refused as busy. The page asks again on
    202 now and starts the check only behind the final answer.
    The handlers stop treating the slot as a wall: a finished job of another
    kind is taken back and the slot reused, a running one answers 202 so the
    page asks again, in the check,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
    [app_config.h, main.cpp, page_firmware.cpp]
2026-09-13 fix(ui): the boot text in zone 4 is back in the figure's size and green (v0.7.2-beta.2)
    beta.48 painted "waiting for a scan" as a hint, 14 px in caption blue.
    Small, dim and pressed against the caption above it, it read worse than
    the 20 px green it replaced. The hint style and its helper are gone; the
    label keeps one style whatever it says.
    [app_boot.cpp, app_config.h, main.cpp]
2026-09-14 feat(wifi): the WiFi no longer has to be typed on the scale - set it from the web flasher or a phone, and the keyboard has ^ ~ | ` (v0.7.2-beta.7)
    - Keyboard: the special page adds ^ ~ | and `, the check mark and enter
    both connect, the unused keyboard key is gone for a wider space bar,
    and the password field stops at 64 characters.
    - Web flasher: Improv WiFi over USB. When the browser sets the WiFi during
    the language step, the setup resumes after the restart and shows the
    connection with a choice to change it or go on.
    - Setup by phone: a WPA2 access point with QR codes and a captive portal
    form. The scale closes the access point, connects and shows the result
    on its display.
    -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
    [app_boot.cpp, app_config.h, app_loop.cpp, app_settings.cpp, app_state.cpp, app_state.h, improv_serial.cpp, improv_serial.h]
2026-09-14 fix(bambuddy): an address test without an API key says the server is reachable and leads on to the key step (v0.7.2-beta.8)
    BamBuddy with authentication answers the credential half of the test with
    401 or 403. That was reported as "not reachable", and on the device the
    setup could not continue to the step where the key is entered. The
    message now tells a missing key from a rejected one, and saving the key
    tests the address again.
    [app_config.h, lang.cpp, lang.h, main.cpp]
2026-09-14 release: v0.7.2
    Everything since v0.7.1. The WiFi no longer has to be typed on the scale:
    the web flasher sets it over USB with Improv, also on an installed scale,
    a phone sets it through a WPA2 access point with QR codes and a captive
    portal form, and the touchscreen keyboard has ^ ~ | and ` with both
    confirm keys connecting. When the browser set the WiFi, the setup resumes
    after the language restart. Also: an address test against BamBuddy with
    authentication reports a missing key instead of an unreachable server and
    leads on to the key step, the GitHub check no longer reports busy for a
    minute after the firmware page loads, and the boot text in zone 4 is back
    in its size and colour.
    Refs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
    [app_boot.cpp, app_config.h, app_loop.cpp, app_settings.cpp, app_state.cpp, app_state.h, improv_serial.cpp, improv_serial.h]
2026-09-15 fix(web): the FilaMan note names the two places the API key and the device code come from (v0.7.3-beta.1)
    The note said FilaMan shows the device code right after the API key is created. It does not: the key comes from the gear icon next to the user name, the code from Admin Panel > Devices > Create Device. It also told the user to enter both below, where they sit above it, and now says the key needs an admin account for the AMS assignment. Reported in #28.
    [app_config.h, lang.cpp, main.cpp]
2026-09-15 feat(web): SD card logging can be switched off on the Logs page (v0.7.3-beta.2)
    Stopping the log meant pulling the card, and every line is an open, append and close on the loop task. The Logs page now carries a switch above the verbose one: on unless switched off, kept in NVS so a swapped card does not turn it back on, and the last line before it goes quiet says why the file stops. The session log in PSRAM fills either way, and the files already on the card stay readable and deletable. Verbose greys out while the card log is off, because those lines only ever went to the card. Both log notes lose the claim that a fitted card costs twenty seconds of boot; the restart dialog still carries it a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
    [app_config.h, lang.cpp, lang.h, main.cpp, sd_logger.cpp, sd_logger.h]
2026-09-16 fix(ui): the AMS chip appears when the printer answers, not only on the next event (v0.7.3-beta.3)
    The printer's answer lands about twenty seconds after boot, long after the
    header was built and hid the chip for want of an AMS. Nothing repaints that
    row on a schedule - updateHeaderStatus() hangs on events like a reachability
    flip or a way back from another screen - so the chip stayed away until one of
    them happened to fire.
    amsPresenceTick() now calls updateAmsAffordance() and layoutHeaderChips() when
    the answer changes what is known, and only then, so it stays silent on the
    five-minute poll. Both functions test their own object pointers, and the tick
    runs on the loop task, which is the one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
    [ams_presence.cpp, app_config.h, main.cpp]
2026-09-16 fix(ams): an unknown printer state is not offline, and humidity is no longer guessed (v0.7.3-beta.4)
    Two things the AMS view got wrong about what a backend says.
    connected is null while no driver has ever reported, which is not the same as
    false: the first says the backend does not know, the second says the printer is
    not answering. Both became a hard "offline, last known state", which sends the
    user to the printer when the server is the one with the problem. The state now
    carries conn_known alongside connected, both backends set it, and the screen
    says "state unknown" when nobody has stated it.
    Humidity arrives either as a percentage or as Bambu's 1 to 5 step, and the
    scale decided which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
    [ams_slots.h, app_config.h, bambuddy_api.cpp, filaman_api.cpp, filaman_api.h, lang.cpp, lang.h, main.cpp]
2026-09-16 feat(ams): report a scanned tag to FilaMan so a browser can follow it (v0.7.3-beta.5)
    Put a spool on the pad, and the FilaMan tab open on the bench jumps to that
    spool. Spoolman has had this since August and the scale has spoken its side of
    it all along - backendTagScan() was simply locked behind backendHasNativeTags(),
    which is Spoolman only.
    filamanTagScan() posts to /api/v1/tag/scan with the device token, the same
    credential the weight report uses, and sends the reader identity FilaMan shows
    in its picker: backendReaderId() and the device name, exactly the pair Spoolman
    already gets. A browser therefore binds to this scale under one name whichever
    backend is behind it.
    FilaMan answers w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
    [app_config.h, backend_api.cpp, backend_api.h, filaman_api.cpp, filaman_api.h, main.cpp]
2026-09-16 feat(ams): a bay opens a detail card, and every filled tile says the same things (v0.7.3-beta.12)
    Tapping a filled bay opens a card with what the backend holds for that spool:
    manufacturer, id, material, trade name, remaining weight with a bar, nozzle
    range, location, last use and last drying. In FilaMan mode the status and the
    drying date can be set from there - after a drying cycle the spool is in the
    bay, and recording the date no longer means pulling it out to put it on the pad.
    Tapping means detail wherever a tap has no other meaning, so in BROWSE and in
    the window mode, where a tile was dead until now. A question still chooses a
    bay, and an info switch in its footer turns that round f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
    [ams_slots.h, app_config.h, app_loop.cpp, backend_api.cpp, backend_api.h, bambuddy_api.cpp, bambuddy_api.h, filaman_api.cpp]
2026-09-16 fix(filaman): the default port is 8083, the one FilaMan publishes
    The address screen suggested 192.168.x.x:8002 in FilaMan mode and the web
    hint listed FilaMan on 8002. FilaMan's README runs it with -p 8083:8000
    and its Home Assistant app maps 8000/tcp to 8083.
    [lang.cpp]
2026-09-16 fix(wifi): start network services when WiFi connects after boot
    When the boot wait for WiFi ran out, wifi_ok stayed false. The reconnect
    watchdog brought the radio back, but nothing set wifi_ok, so the web
    interface, the backend and mDNS stayed off until the next restart.
    The connected part of wifiConnect() moves unchanged into wifiOnConnected(),
    and the watchdog calls it once when the radio is connected but wifi_ok is
    still false. Normal boots take the same path as before.
    [app_boot.cpp, app_loop.cpp]
2026-09-16 fix: a review pass over the AMS card, the clock and the WiFi setup (v0.7.3-beta.13)
    AMS detail card:
    - A failed write no longer marks every card opened afterwards as failed;
    the flag belongs to the card that wrote.
    - The percentage beside the bar is the bar's own share. It used to be the
    printer's estimate next to a bar drawn from the database's grams.
    - FilaMan's mapping leaves remaining_weight out when the server has null,
    so a spool nobody weighed reads "no weight stored" instead of "0 g".
    Every other reader defaults a missing key to the zero it had.
    - Value labels have a real height, one line of their font: with the
    content height a long text wrapped into the next row instead o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
    [app_config.h, backend_api.cpp, backend_api.h, filaman_api.cpp, main.cpp, setup_portal.cpp, spool_detail.h, time_service.cpp]
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2026-09-16 fix(ams): a finished print no longer reads as printing 100% (v0.7.3-beta.15)
    Bambu keeps the last job and its 100 percent on the wire after a print
    until the next one starts, FilaMan's display API passes that through
    (state FINISH, job.progress 100, remaining_seconds 0), and the status line
    took any job for a running one. A printer that finished two days ago read
    "printing 100%" the whole time.
    The percentage shows only while the state says RUNNING or PAUSE, and the
    other states come in words: finished, failed, idle, preparing. A state the
    list does not know is printed as the server wrote it. Five new strings.
    [app_config.h, lang.cpp, lang.h, main.cpp]
2026-09-16 release: v0.7.3
    Everything since v0.7.2. A scan on the scale is reported to FilaMan and
    the browser tab there follows it to the spool (FilaMan 1.3.7). The AMS
    view opens a card behind every filled bay with what the backend holds
    for the spool, and the drying date and, on FilaMan, the status can be set
    from there. The reload chip moved into the header, the printer's name is
    the switch between printers, a finished print no longer reads as printing
    100 percent, and the AMS chip appears as soon as the printer answers.
    FilaMan data: last used from the event log, imported drying dates, net
    initial weight, cleaned colour names. Web: SD logging can be switched off,
    and the FilaMan credentials note n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
    [ams_presence.cpp, ams_slots.h, app_config.h, app_loop.cpp, backend_api.cpp, backend_api.h, bambuddy_api.cpp, bambuddy_api.h]
2026-09-17 feat(nfc): fast-fail non-Bambu 4-byte tags and eliminate 34s lookup hang
    - Abort sector 1-15 scanning immediately when Sector 0 Bambu HKDF auth fails
    - Bypass 5-retry loop for non-Bambu 4-byte tags, reducing backend lookup latency from ~34s to <1s
    - Decouple main screen UI to prevent displaying "Bambu Lab" and "nicht lesbar" for non-Bambu tags
    - Enable instant fallback to Spoolman/FilaMan UID lookup (supporting Snapmaker U1, SpoolLink, and generic MIFARE tags)
    [app_loop.cpp]
2026-09-17 fix(nfc): probe two sectors before giving up on a 4-byte tag, keep the Bambu retries (v0.7.4-beta.2)
    A tag that is not Bambu refuses every sector, so the scan stops once the
    first two have refused instead of trying all sixteen. The retries in the
    loop stay as they were: a Bambu tag with poor coupling gets the same five
    attempts as before, only cheaper, and is never taken for a plain card on
    the strength of one sector. The "Tag placed" line now says what the scale
    concluded, and the lookup log names a UID as a UID.
    Builds on Simon-CR's fast-fail commit from PR #29.
    [app_config.h, app_loop.cpp, main.cpp]
2026-09-17 tools: French column tooling and its documentation
    tools/lang_fr.py keeps the French column in tools/lang_fr.jsonl and writes
    src/lang.cpp from it, so a rebase takes upstream's lang.cpp as it is and puts
    the column back instead of merging every row by hand. It checks each French
    text against the German one: printf conversions and their order, browser
    placeholders, leading symbols, line breaks, HTML, buffer sizes in bytes and
    the glyphs the fonts really carry.
    tools/fit_check.py measures a text in pixels from the font tables, the way
    LVGL does. tools/ui_budgets.tsv holds the widths of the widgets where a text
    that is too long would overflow or overlap without a sign.
    tools/FRENCH_TRANSLATIO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
    [ui_budgets.tsv]
2026-09-17 feat(i18n): add a third language column, filled with English
    STRINGS becomes a three-column table and Lang gains LANG_FR. The new column
    holds the English text for now; the French comes in the next commit.
    T() and copyT() go through langText(), which falls back to English when a
    cell is empty. A row added with German and English only still compiles into
    the three-column table, and its missing cell would otherwise be a null
    pointer, which restarts the board when printed with %s.
    - app_settings.cpp: the stored language is range-checked instead of cast.
    - time_service.cpp: French defaults to the same time zone as German.
    - language_screen.cpp, setup_welcome_screen.cpp: three buttons, Deutsch,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
    [app_settings.cpp, lang.cpp, lang.h, time_service.cpp]
2026-09-17 i18n(fr): translate the interface into French
    The third column of src/lang.cpp, written by tools/lang_fr.py emit from
    tools/lang_fr.jsonl. German and English text is byte-identical to the
    previous commit. lang_fr.py check --strict reports 0 errors and
    fit_check.py --gate 0 widths over budget.
    [lang.cpp]
2026-09-17 i18n: route the captions left as literals through the string table
    A few captions were written straight into the code because German and
    English happen to agree on them: "Status", "Gateway", "Name", "%s Server",
    "%s UUID", "Language / Sprache" and the "DEL" key of the number pads. French
    does not agree, so they stayed English on a French screen.
    They get eight rows at the end of the table. German and English keep exactly
    the text they had, so nothing moves on their screens. The number pads still
    compare their keys against "DEL"; only the label on the key comes from the
    table. The comments that explained why these literals were kept are updated
    with the code.
    [ui_budgets.tsv]
2026-09-18 ci: check the house rules and build on every push and pull request
    scripts/check.sh turns the rules the firmware learned from crashes into
    something a machine checks: no em-dash, no bare strncpy on T(), no
    lv_scr_load(), the PN532 retry blacklist, the version in both places, the
    string table against its enum with no empty German or English cell, a
    .catch for every fetch in the web pages, the page scripts reconstructed
    from their C++ strings and run through node --check, and the French
    column with its width budgets.
    The workflow runs it together with a firmware build on dev, main, feature
    branches and every pull request. The release build stays on tag pushes.
    BUILDING.md, copy_release.py an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
    [copy_release.py]
2026-09-18 feat(ams): dry a whole AMS 2 Pro at once, weigh every bay, flag a stale assignment (v0.7.4-beta.11)
    Drying for the whole unit. The bay card of an AMS 2 Pro offers "All N
    spools in <unit>" next to "This spool only". The unit model comes from
    BamBuddy's module type ("n3f") or FilaMan's display API ("ams_2_pro");
    an older FilaMan names neither, so the answer stays off there rather than
    being guessed. The dates are written by services/dried_batch on a task of
    its own, so up to eight requests on FilaMan no longer freeze the panel;
    the loop collects the result, updates the card and the spool on the pad,
    and a backend or host switch cancels a batch in flight.
    Weights on BamBuddy. Its printer statu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
    [ams_slots.h, ams_weights.cpp, ams_weights.h, app_config.h, app_loop.cpp, backend_api.cpp, backend_api.h, backend_switch.cpp]
2026-09-18 fix(nfc): read the alpha byte of Bambu tags, draw clear and translucent spools as glass (v0.7.4-beta.12)
    Block 5 of a Bambu tag is RGBA, and only three bytes were read. The fourth
    is not decoration: FF is opaque, 80 is every PLA/PETG Translucent, and
    00000000 is how Bambu writes a clear filament - PETG Translucent Clear,
    PC Transparent and PC Clear Black alike. Read as RGB, a clear spool was
    black and a smoky translucent grey was a solid light grey.
    services/spool_color holds a colour with its alpha and the rules around
    it, free of LVGL so the tag parser, the backends and the screens share
    it. The tag wins wherever it names a hue, being the manufacturer's value;
    the server fills only what t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
    [ams_slots.h, app_config.h, app_loop.cpp, bambuddy_api.cpp, filaman_api.cpp, main.cpp]
2026-09-18 perf(ui): sample the touch at 100 Hz, draw in 20 line strips from PSRAM, measure it (v0.7.4-beta.26)
    The verbose log gains a line next to every heartbeat that says what the UI
    cost since the last one: the longest gap between two passes of the main
    lv_timer_handler(), the time inside it, the time spent flushing to the
    panel, what a single line to the SD card held the loop for, and the low
    mark of the internal heap. Everything below was decided on those figures,
    on hardware.
    - LV_INDEV_DEF_READ_PERIOD 30 -> 10 ms. Dragging follows the finger instead
    of stepping. LVGL measures a flick per read, so a list coasts a shorter
    way after the finger lifts.
    - The panel bus runs at 20 MHz instead of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
    [app_config.h, app_loop.cpp, display.cpp, display.h, main.cpp, sd_logger.cpp, sd_logger.h]
2026-09-18 fix(link): per-spool verbose lines go to Serial, not to the card (v0.7.4-beta.27)
    With verbose logging on, building the link list wrote one line per spool to
    the SD card. A line is an open, an append and a close, 26 ms each on the
    loop task: for 227 spools the screen stood still for 6 s after a download
    that took one, and those lines were a third of a day's log. They now go to
    Serial under the same switch, the card keeps the totals. Measured: 0 to 1 s
    instead of 6 s from download to list.
    [app_config.h, main.cpp]
2026-09-18 perf(nfc): an empty reader holds the loop for 80 ms instead of 150 (v0.7.4-beta.29)
    The poll for a tag waits out its timeout on the loop task whenever nothing
    is on the scale, and no touch is read meanwhile: 150 ms of every 500. How
    short it may be depends on how long a tag that is there takes to answer,
    because a poll that gives up starts the search again, so a slower tag would
    never be found. The verbose log now times every poll. Over 926 hits with
    NTAG, Bambu and a plain MIFARE Classic 1K the answer took 26 to 38 ms, so
    the timeout is set to twice that. Detection is unchanged, the longest gap
    with an empty scale fell from 168 to 96 ms.
    [app_config.h, app_loop.cpp, main.cpp]
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2026-09-18 fix(nfc): an NTAG with nothing readable on it is no longer read twice a second (v0.7.4-beta.31)
    refreshCache() returned early only once a tag had yielded a description. A
    blank NTAG, or one written by something this firmware does not know, never
    does, so its pages were read again every 500 ms for as long as it lay on the
    reader, next to the main poll and on the same PN532. It now gets three
    tries, which covers a read that merely failed, and is then left alone until
    the tag changes or is written to. After a write or an erase that cannot be
    read back, the stale description goes instead of being shown as current.
    Found by Simon-CR in #35. His guard inspected exactly once, also after a
    failed r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
    [app_config.h, main.cpp, tag_write.cpp]
2026-09-18 fix(power): a spool left on the scale no longer keeps the screen at full brightness (v0.7.4-beta.32)
    Every successful NFC poll reset the activity timer, twice a second, so a
    tagged spool lying on the scale kept the panel bright for good. A tag lying
    there is not activity any more: the screen dims, and goes dark if that stage
    is set, exactly as on an idle scale. Putting a tag down still wakes it, and
    so does a different tag. One that merely dropped out and came back under a
    spool that never moved does not.
    What the tag still does is hold off deep sleep. A scale with a spool on it
    has always stayed online, and a backend would otherwise watch it vanish
    after twenty minutes, to be brought back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
    [app_config.h, app_loop.cpp, display_power.cpp, main.cpp]
2026-09-18 feat(nfc): Snapmaker tag key derivation and sector decoding
    The two new modules from #34, as written there: HKDF-SHA256 over the tag's
    UID with Snapmaker's salt for the sector keys, and the decoding of sectors 0
    to 2 into vendor, material, colour, weight, temperatures and production
    date. Nothing calls them yet.
2026-09-18 feat(nfc): Snapmaker tags as an opt-in, off by default (v0.7.4-beta.35)
    A switch on the settings page of the web interface. Off, which is what every
    device starts with, means not one extra byte goes to the reader and nothing
    in the 4 byte path behaves differently. On, a 4 byte tag that came back from
    the first Bambu probe with nothing is tried once with Snapmaker's keys. If
    sector 0 authenticates, material, colour, weight and temperatures come off
    the tag, the Bambu retries are skipped, and the spool is looked up by its
    UID like any plain MIFARE card.
    Opt-in because nobody here owns a Snapmaker spool: the decoding is
    Simon-CR's and proven on his tag, and the attempt costs every other 4 byte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
    [app_config.h, app_loop.cpp, app_settings.cpp, lang.cpp, lang.h, main.cpp, page_config.cpp, user_options.cpp]
2026-09-18 ci: the web flasher resets otadata, and a binary over 3 MB fails the build
    The flasher manifest wrote the bootloader, the partition table and the app,
    and nothing at 0xe000. A device that last ran from app1, which is every
    device after an odd number of updates, therefore kept booting the old
    firmware from app1 after a re-flash without erase, because otadata still
    pointed there. boot_app0.bin, the blank otadata every PlatformIO upload
    writes, is now the fourth part, and the release workflow copies and
    publishes it with the other three. nvs, at 0x9000 to 0xdfff, is not touched.
    Every installed device has a 3 MB app slot, and OTA never rewrites the
    partition table. The release and CI workflows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
2026-09-18 feat(flash): 5 MB app slots, a core dump partition, 5.9 MB left for data (v0.7.4-beta.36)
    The table was the stock app3M_fat9M_16MB layout: two 3 MB slots and a
    9.9 MB file system that nothing ever mounted. The firmware stood at 72 % of
    a slot and grew by some 270 kB in the three weeks before this. Now 5 MB per
    slot (43 % today), 64 kB for the crash dump the framework can write to
    flash, and 5.9 MB under the label spiffs for a file system later.
    nvs and otadata are where they were, so a re-flash over USB keeps every
    setting. Verified on a device: OTA of this build onto the old table,
    then the new table over USB while it ran from app1, WiFi, backend token and
    calibration all still there, the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
    [partitions.csv]
2026-09-19 feat(flash): tell a device on the old partition table about the new one, once (v0.7.4-beta.39)
    The partition table is written over USB and never by OTA, so a device
    flashed before the 5 MB table keeps its 3 MB slots until someone flashes it
    over USB again. The firmware now reads the size of its own slot and, on the
    old table, shows a note once per boot after the device has settled: what
    the new table brings, that updates keep working meanwhile, and that a flash
    over USB keeps every setting as long as "Erase" stays unticked. OK closes
    it until the next boot, "Do not show again" keeps that in NVS, the same two
    ways out as the NFC reset hint, and never both hints on one boot.
    The hardware card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
    [app_config.h, app_loop.cpp, lang.cpp, lang.h, main.cpp, partition_layout.cpp, partition_layout.h]
2026-09-19 fix(flash): the storage hint stays silent until the public flasher carries the new table (v0.7.4-beta.40)
    A beta tag never updates the web flasher, so a pre-release with the hint
    would send people to a flasher whose "Update" hands them the previous public
    release with the old table, a downgrade. FLASHER_HAS_CURRENT_LAYOUT in
    app_config.h gates the popup and the line on the status page; it is set to 1
    in the first public release after the table changed and stays there.
    [app_config.h, main.cpp, partition_layout.cpp]
2026-09-20 feat(log): name the call that held the loop, once a minute (v0.8.0-beta.2)
    The perf line said how long the longest pass took, never what it was doing.
    Every bracket in the backend dispatcher now carries its function's name, the
    FilaMan heartbeat gets one of its own because appLoop() calls it past the
    dispatcher, and a verbose line reports the window's blocking time, the longest
    single call and how many requests sat inside it:
    [verbose] stall: sum=640ms spans=3 max=598ms in=filamanHeartbeat calls=1
    A line of its own: the perf line is already close to the 256 bytes logSDf
    formats into. Written only when a call ran, like the NFC line.
    The heartbeat was the suspect behind the quiet 218 to 3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
    [app_config.h, backend_api.cpp, filaman_api.cpp, http_progress.cpp, http_progress.h, main.cpp]
2026-09-20 fix(link): a request that never reached the server no longer reads as an answer (v0.8.0-beta.8)
    A server that was briefly unreachable made the scale say things that were not
    true: "not in FilaMan" about a spool nobody had been able to ask about, an
    empty spool list that read like "no spools without a tag", "API Error" in
    green on the weight line, and an unlink reported as done while the binding was
    still there. Measured on 19.09.2026: a lookup right after a link took 47 s and
    ended without a spool, and the PATCH before it had already failed.
    What the flows do now:
    - A scan that names the spool but does not send it - which is every FilaMan
    scan - is followed by one fetch of that spool by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
    [ams_pick.cpp, app_config.h, app_loop.cpp, filaman_api.cpp, lang.cpp, lang.h, main.cpp]
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2026-09-20 refactor(link): the tag values of a row and the confirm popup become functions of their own (v0.8.0-beta.12)
    linkFillTagValues() replaces the two loops that copied a spool's tag
    fields into a list row, one in the list fetch and one behind the numpad.
    They differed in a log line only; the numpad path now says as well when a
    value is too long to keep.
    showLinkConfirmPopup() is the body of the spool row's callback, moved as
    it was. The callback calls it, and the loop will be able to.
    No change in behaviour. In the simulator the list, the popup and the list
    after Cancel come out pixel for pixel as before; on the scale the list
    link, the Bambu list, the numpad, appending a second UID to card_ui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
    [app_config.h, main.cpp]
2026-09-20 feat(link): the second spool list comes out of PSRAM, and a row from there is read again before it is used (v0.8.0-beta.13)
    Linking a library spool by spool fetched the whole inventory every time.
    The list is now handed out by services/spool_cache whenever the stamp
    taken in front of it still matches: 0.33 s of a standing loop instead of
    1.4 to 1.7 s against Spoolman, 54 ms on the wire instead of a second or
    more. A stamp that fails on the network ends the fetch after two seconds
    instead of sending the eight second download after it.
    The cache decides what a list shows, never what is written. Its rows carry
    no tag values, so a row from there is marked, and linkRefreshRow() reads
    the spool f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
    [app_config.h, lang.cpp, lang.h, main.cpp]
2026-09-20 fix(link): the kept spool list holds FilaMan's material subgroup in full (v0.8.0-beta.14)
    Sixteen characters were one short on the first real library: a
    "silk-multi-color" came back out of the cache as "silk-multi-colo". The
    verdict was the same either way there, but the link filter matches its
    subtypes against this field, and a "silk-translucent" cut like that no
    longer says Translucent - the cached list would then leave out a spool
    the downloaded one shows. 32 now, which puts a row at 168 bytes instead of
    152: 44 kB rather than 40 for 269 spools.
    Built, checked and run through the simulator; on the scale it goes out
    with the next build, whose FilaMan test reads the field back from the
    cac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
    [app_config.h, main.cpp, spool_cache.cpp, spool_cache.h]
2026-09-20 fix(lookup): a spool found by the fast search no longer leaves a full scan owed (v0.8.0-beta.17)
    The tag lookup noted "the inventory scan stood aside" whenever a question
    was on screen - also when one of the fast searches had already found the
    spool and there was no scan to skip. Only spoolmanRecheckTick() clears
    that marker, and it does not run while a spool is shown, so the marker
    stayed. It then fired at the next unknown tag, right after that tag's own
    complete lookup, and ordered the whole thing a second time: inventory and
    archive both, 5.4 s instead of 2.4 against Spoolman, 11.1 s instead of 5.5
    against FilaMan, measured. Every link sets this up, because the second tag
    question is open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
    [app_config.h, main.cpp]
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2026-09-20 chore(log): say under verbose when a cache hook fires and there is nothing to drop (v0.8.0-beta.19)
    spoolCacheForget() is silent when no copy of the spool list is kept, which
    is right for the log and wrong for a test: archiving a spool on a scale
    that had been idle for two hours left nothing to show that the hook had
    fired at all. One line under verbose now names the reason either way.
    Built, checked and seen in the simulator; it goes onto the scale with the
    next build.
    [app_config.h, main.cpp, spool_cache.cpp]
2026-09-20 feat(link): a spool list out of the cache says when it was loaded and can be loaded again (v0.8.0-beta.20)
    A list handed out by services/spool_cache gets a strip underneath: the
    clock time of the download on the left, a Reload button on the right. A
    list fresh off the wire has neither and keeps its full height.
    The time and not an age: it is written once and stays true for as long as
    the list is open, where an age would need a tick to keep it honest and a
    pointer to a label whose life hangs on the screen. Without a set clock
    only the button is shown.
    The strip is built before the rows and belongs to the screen, not to the
    list. When the LVGL pool runs short the row loop cuts itself off, an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
    [app_config.h, lang.cpp, lang.h, main.cpp]
2026-09-21 fix(lookup): an archived spool handed in by a short cut is shown as archived, not as found (v0.8.0-beta.21)
    FilaMan's /tag/scan names an archived spool as readily as any other, and its
    search leaves archived ones out. Since beta.8 the lookup then fetches the
    named spool by id and takes it for the hit - and nothing on that way asked
    whether it is archived. Seen on 21.09.2026 with spool 285: archived on the
    server (status 6, 249 active and 7 archived in the very same log), on the
    scale a spool with 966 g, sm_archived false, every write open. Before beta.8
    the archive pass found it and said "Archived".
    The test now stands where a spool counts as found, in front of everything
    that writes, rathe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
    [app_config.h, main.cpp]
2026-09-21 chore(log): the lookup's log lines say Backend, not Spoolman, on every backend (v0.8.0-beta.22)
    "Spoolman: spool not found" at the end of a FilaMan lookup read like a
    request to the wrong server. The prefix was written into 23 lines of the
    lookup when Spoolman was the only backend, and "Spoolman inventory: 250 total"
    in the link fetch is the same leftover. They now carry "Backend:" like the
    newer lines next to them, and "Inventory:".
    Only the text of a log line changes. The screen never showed these: it goes
    through backendText() and names the backend that is set. Older logs keep the
    old wording, so a search across both needs both.
    [app_config.h, main.cpp]
2026-09-21 feat(lookup): the full scan leaves an index of every identifier it saw, nothing reads it yet (v0.8.0-beta.24)
    An unknown tag costs two downloads of the whole inventory before the scale
    may say "not found": the active list and the pass over the archive, 2.2 to
    2.8 s on Spoolman with 270 spools, 5.1 to 6.6 s on FilaMan with 250, and the
    touch panel is not read meanwhile. The list cache cannot shorten that, it
    keeps no identifiers on purpose. This is the first of three steps towards a
    second unknown tag that is answered without those downloads, and it changes
    nothing a user can see.
    services/uid_index keeps a 64 bit hash of every value in which the scan could
    have found a tag: each tag of the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
    [app_config.h, app_loop.cpp, main.cpp, spool_cache.cpp, uid_index.cpp, uid_index.h]
2026-09-21 feat(lookup): the uid index is asked before every full scan, in shadow - the scan still runs (v0.8.0-beta.25)
    The second of three steps. Before the inventory is downloaded for an unknown
    tag, the index left by the last scan is asked what it would have said. The
    answer goes into the log, the scan runs regardless, and what it found is held
    against the answer:
    uid index: would answer UNKNOWN (52 ids, 34 s old)
    uid index: scan agreed
    uid index: would not answer (an identifier is in the index)
    uid index: scan found spool 3 at rank 4, as it had to
    uid index: DISAGREED - scan found spool 222 at rank 1
    The last line is the one mistake the index must not make, calling a tag
    unknown that t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
    [app_config.h, main.cpp, uid_index.cpp, uid_index.h]
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2026-09-22 fix(lookup): an unknown tag on the pad no longer stalls the scale while the server does not answer (v0.8.0-beta.28)
    While an unknown tag lies on the pad, spoolmanRecheckTick() asks the server
    every 4 s whether it has been linked meanwhile. The 4 s were measured from the
    start of the probe, and a probe that runs into the 5 s connect timeout was due
    again on the very next loop pass. On 21.09.2026 over a weak WiFi that left the
    loop one pass in 12 s (stall max=5003 ms in backendFindSpoolByTag), the screen
    looked frozen, and it ended twice in a power cycle.
    The gap now runs from the end of a probe. A probe that gets no answer at all
    doubles it, up to 60 s (TAG_RECHECK_MAX_MS); the first answer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
    [app_config.h, main.cpp]
2026-09-22 fix(log): a cleared internal log stays cleared across a restart (v0.8.0-beta.29)
    Clearing the ring in flash hid every line at once by raising the first visible
    sequence, then erased the 512 sectors one per loop pass. The raised boundary
    lived in RAM only. A restart before the erase was through let the boot find
    the sectors not yet reached and show their lines again - the counter had said
    0, and after opening the log every line of the morning was back. With the loop
    held by the stalls fixed in beta.28, the erase had been running for a long
    time when the scale was power cycled.
    The boundary is now stored in NVS (log_clr_seq) before the first sector is
    erased, and the boot never shows a line b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
    [app_config.h, flash_log.cpp, main.cpp]
2026-09-22 fix(lookup): the first unknown tag after a backend switch leaves an index the next tag can use (v0.8.0-beta.31)
    The inventory stamp that the spool cache and the uid index are filled under
    was only taken while sm_reachable said the server was up. A backend switch
    sets that to "not known yet" until the next health check, up to 30 s later.
    The first scan after a switch therefore filled the index without a stamp, the
    next tag came with one, and the index threw itself away ("a stamp where there
    was none") - on 21.09.2026 on Spoolman, so it only started to answer at the
    third tag.
    A search of the same lookup that got an HTTP answer now counts as proof that
    the server is there, and the stamp is ta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
    [app_config.h, main.cpp]
2026-09-22 fix(nfc): a tag put down before WiFi came up is looked up once the network is there (v0.8.0-beta.32)
    The NTAG branch marks a tag handled whether or not its lookup ran, and the
    Bambu branch marks it queried although querySpoolman() returns at once without
    WiFi. A spool placed while the network was still coming up was therefore never
    looked up: on 21.09.2026 a tag at 13 s, WiFi at 14 s, and the link that
    followed ended in "LINK ABORT: no tag UID".
    wifiOnConnected() now forgets both markers when a tag is on the pad, which is
    what lifting the spool off and back on does, and the next poll runs the whole
    lookup. At boot the pad is still unread, so this only acts when the reconnect
    watchdog brings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
    [app_boot.cpp, app_config.h, main.cpp]
2026-09-22 fix(ui): a list row no longer stays highlighted while the list scrolls (v0.8.0-beta.33)
    LVGL 8.3 marks a row pressed the moment a finger lands on it, before it can
    know whether the finger taps or scrolls. Once the list scrolls, only the list
    hears of it; the row keeps its pressed look until the finger lets go, although
    the release does not click it. Every scroll dragged a highlighted row along.
    ui/touch_feedback.cpp takes the pressed state away when the scroll begins. It
    is the pointer driver's feedback callback, which LVGL calls for every event
    the touch sends, so it covers every list at once and no screen registers
    anything.
    Not done: holding the highlight back for the first 150 ms of a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
    [app_config.h, display.cpp, main.cpp]
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2026-09-22 fix(nfc): an NTAG put back after a Bambu tag is looked up again (v0.8.0-beta.35)
    The NTAG branch keeps a marker of the NTAG it handled last, and only a
    removal cleared it - and a removal only when the weight says the spool left.
    The 4-byte branch never touched it. An NTAG, then a Bambu tag, then the same
    NTAG again without a removal in between therefore counted as handled: on
    22.09.2026 the NTAG was never looked up and the Bambu spool stayed on screen,
    "Update weight" included, which would have written to the wrong spool.
    The 4-byte branch now clears the marker when it reads a different tag. A
    dropout of the NTAG itself still keeps it, so the display gate against
    re-reading a flickering NTA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
    [app_config.h, app_loop.cpp, main.cpp]
2026-09-22 fix(bambuddy): a read refused after the inventory moved back to BamBuddy asks for the mode at once (v0.8.0-beta.36)
    BamBuddy answers 400 on its Spoolman proxy once its inventory has been
    switched back to its own database. The scale learns of a switch with the
    next mode check, which runs with the health check every 30 s; until then
    every read went to the proxy. On 22.09.2026 a Bambu tag came back as "API
    error" three times in a row in that window.
    A 400 on an inventory read while the scale believes in the Spoolman mode now
    asks for the mode at once, and only when it has really changed is the read
    repeated once, on the new path. Reads only - the spool list and a spool by
    id; a write is never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
    [app_config.h, bambuddy_api.cpp, main.cpp]
2026-09-22 fix(tags): the tag page shows Bambu and Snapmaker tags and the spool on the scale, and FilaMan is still sent what it was (v0.8.0-beta.37)
    Builds on the two commits before it:
    - tagCachedHasRecord() counts NTAG records only. With a Bambu tag in the
    cache it had turned true, and the FilaMan scan then answered from the
    cache: "PETG Basic" instead of "PETG", black for a clear filament, no
    spool id, and an empty record for a foreign MIFARE tag instead of letting
    the request expire.
    - The MIFARE fields come from infoFromMifare(): format "Bambu" or
    "Snapmaker" rather than the vendor name, printable characters only, no
    colour for a clear filament. TagInfo keeps its field sizes, so
    tag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
    [app_config.h, backend.cpp, backend.h, lang.cpp, lang.h, main.cpp, tag_write.cpp, tag_write.h]
2026-09-22 feat(ui): the NFC chip in the header opens a view of the tag on the reader, with erase and write (v0.8.0-beta.38)
    The chip is a button now, built like the AMS chip. Its label still says
    whether the reader answers, and the frame follows it.
    The view is a card in the More Info card's measurements: format, filament,
    UID, chip and what the record carries, for NTAG, Bambu and Snapmaker tags
    alike. It reads the cache tag_write.cpp keeps on the loop task, never the
    reader, and builds itself again when that changes - a tag put down while it
    stands shows up in it.
    Two buttons for an NTAG: erase, behind its own question, and "Write spool
    #N", which asks the same question a link asks, for when that o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
    [app_config.h, app_loop.cpp, app_state.cpp, app_state.h, deferred_actions.cpp, deferred_actions.h, lang.cpp, lang.h]
2026-09-22 feat(ui): the tag view's title is centred and the format stands in the header (v0.8.0-beta.39)
    The format moves into a framed chip on the left of the header, where More
    Info keeps the FilaMan status: it says how the tag is written, not what the
    spool is, and no longer sits beside the swatch. The row next to the swatch
    now reads material and vendor, in the main screen's order.
    [app_config.h, lang.cpp, lang.h, main.cpp]
2026-09-22 fix(ui): the format in the tag view's header reads as information, not as a button (v0.8.0-beta.40)
    No frame and no fill: on this device those mean "press here". Caption over
    value like every other field on the card, the value green when the scale
    knows the format and quiet for blank, unknown and none.
    [app_config.h, main.cpp]
2026-09-22 feat(tags): the tag page links the tag on the reader to a spool without writing it (v0.8.0-beta.41)
    "Link only" beside "Write tag" and "Erase tag", for any tag on the reader:
    a MIFARE card, a Snapmaker or Bambu tag, or an NTAG whose contents should
    stay. Nothing touches the reader. The route parks the request with the uid
    the page was showing, and services/tag_link.cpp carries it out on the loop:
    - refused when a different tag lies on the reader by then
    - a Bambu tag by its tray uuid, anything else by its chip uid, as the link
    on the device binds them
    - who holds the tag is asked first, on every backend: the same spool says
    "already linked", another one is named and nothing is written
    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
    [app_config.h, app_loop.cpp, lang.cpp, lang.h, main.cpp, tag_link.cpp, tag_link.h, tag_write.cpp]
2026-09-23 perf(lookup): no second lookup after a question, a lifted spool gets no verdict, a smaller worker stack (v0.8.0-beta.44)
    - The scan no longer stands aside while a question is on screen: it runs on
    the worker, so the question can be answered meanwhile. Standing aside made
    the lookup run twice, once without the scan and once more afterwards.
    - A spool taken off the pad before its verdict is abandoned; its inventory
    still feeds cache and index. Not while the weight says the spool is still
    there, an NTAG dropout would otherwise never be looked up again.
    - The backend worker's stack is 10 kB: a list on all three backends left
    13.6 of 16 kB unused.
    [app_config.h, app_loop.cpp, backend_job.cpp, main.cpp]
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2026-09-23 chore(i18n): every new text comes with a French draft, checked for width
    - tools/lang_fr.py: a "draft" status beside todo/ok, apply --draft, approve
    (ids, --group, --all) for the review, coverage, dump --drafts, and the
    drafts per group in report.
    - check: a draft wider than both German and English fails unless its widget
    has a line in ui_budgets.tsv; 14 budgets added for the tag view, the
    waiting cards, the copy confirmation and Reload.
    - scripts/check.sh runs coverage on every push, without a build: a row with
    no French fails the house rules.
    - tools/FRENCH_TRANSLATION.md: adding a text with a draft, reviewing drafts.
    [ui_budgets.tsv]
2026-09-24 perf(ui): LVGL takes its memory on demand, under a budget, with PSRAM as fallback (v0.8.0-beta.70)
    The fixed 96 kB pool held internal RAM for good while the idle UI used about
    20 kB of it. LVGL now allocates from the heap: internal RAM first, as long as
    it stays within the old pool's size (heap overhead counted) and the internal
    heap keeps 64 kB free, PSRAM past that. Lists still stop where the pool
    stopped them, so no list row is ever drawn from PSRAM.
    Measured on the device against beta.52, idle: internal heap free 115 -> 187 kB,
    largest block 102 -> 164 kB, static RAM 186 -> 89 kB. Scrolling ui_max
    unchanged (13 ms median). Over several stress rounds LVGL returned to its
    24 kB base every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
    [app_config.h, app_loop.cpp, breadcrumb.cpp, breadcrumb.h, lvgl_mem.cpp, lvgl_mem.h, main.cpp, sd_logger.cpp]
2026-09-24 fix(backend): the list worker gives CPU 0 away while it parses (v0.8.0-beta.71)
    A FilaMan inventory is 441 kB and takes the worker 3 to 7.5 s. While the
    response arrives faster than ArduinoJson parses it, the read never blocks,
    the idle task of CPU 0 starves, and the task watchdog resets the scale after
    5 s: twice on beta.70 with "cpu0=backendjob", once already on beta.63.
    The byte counter every worker read passes through now yields one tick every
    100 ms, about 1 % of the download. No reset in 3.5 hours of testing since.
    [app_config.h, http_progress.cpp, main.cpp]
2026-09-25 build(core): move to Arduino core 3.3.12 on ESP-IDF 5.5 (v0.8.0-beta.72)
    Core 2.0.17 crashed with WiFi and Bluetooth up together on this board, and
    gets no more updates. The platform is pioarduino 55.03.312-1, pinned; it
    needs PlatformIO 6.2 or newer. No library changes.
    What core 3 needed:
    - Compile fixes: LEDC by pin for the backlight, esp_mac.h, WiFi includes,
    the certificate bundle with its length, mbedtls_sha256 without _ret.
    - The web server override empties the response headers per request, as the
    library's own handleClient() does; left out, every request kept about
    170 bytes of internal heap.
    - mDNS is taken down before a WiFi scan or the access point: the interface
    goes wit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
    [app_boot.cpp, app_config.h, backend_api.cpp, breadcrumb.cpp, display.cpp, filaman_api.cpp, github_release.cpp, github_release.h]
2026-09-25 perf(web): the log page's poll no longer holds the loop, and a slow pass says where (v0.8.0-beta.73)
    /api/log/session sent every line as a chunk of its own, three socket writes
    and, with Nagle off, three packets per line. Thirty lines held the loop for
    130 to 400 ms, every three seconds while the log page was open. Lines now go
    out in blocks of up to 1400 bytes: 30 to 40 ms.
    Two diagnostics that found it, kept because they cost nothing measurable:
    - perfSection() marks the parts of appLoop(); the perf window logs the
    slowest one by name ("slow: max=... in=web").
    - A web request that takes 300 ms or more is logged with its path and the
    address that asked.
    [app_config.h, app_loop.cpp, main.cpp]
2026-09-25 feat(ble): Bluetooth in the connection menu, with a master switch and a device scan (v0.8.0-beta.74)
    The Bluetooth groundwork of feature/bluetooth-menu (beta.53 to 55) without
    the printer, on core 3: the connection tile opens a menu with WiFi and
    Bluetooth, the Bluetooth screen has the master switch and a devices row, and
    the device list scans on demand with a card per device. NimBLE-Arduino 2.5.1,
    the first version that links next to core 3's own NimBLE.
    The stack runs only for a scan and is released right after. Before it
    starts, a scan waits for a backend list in flight and needs 64 kB of free
    internal heap; the stack took 41 kB and gave all of it back. Modem sleep is
    on while it runs, a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
    [ui_budgets.tsv]
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2026-09-25 feat(printer): the Phomemo label printer on core 3, with a print card and a code that reads (v0.8.0-beta.77)
    The printer of feature/bluetooth-menu (beta.56 to 64) on the core 3 base:
    the printer screen and web tab, the test label and the spool label from More
    info with the backend's link to the spool, the M-series protocol. A session
    waits for the printer's done signal (1A 0F 0C on FF03) before it lets go,
    the raster sits centred in the 576 dot row, and the stack comes and goes
    with the session, modem sleep on for as long as it runs.
    New with it:
    - The print card: one card from start to answer, following the session
    (preparing, looking for the printer, connecting, sending with a percentag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
    [ui_budgets.tsv]
2026-09-25 feat(tags): unify current spool inspection, add universal raw tag modal, and fix multi-page NTAG reading
    [nfc.cpp, tag_write.cpp, tag_write.h]
2026-09-25 fix(tags): align brand and material display hierarchy between physical tag and database record
2026-09-25 feat(tags): the second tag from the browser, a visible write status, and the tag page in every language (v0.8.0-beta.78)
    - The tag page shows a write or link as a status panel with a spinner and
    its outcome, and offers a second tag for the spool after a write. The
    scale's own second-tag flow is started, followed and cancelled from the
    browser, and its overwrite question can be answered there
    (POST /api/tag/second, /api/tag/answer, both behind the maintenance gate).
    - Whether the backend holds a second tag is cached on the loop, so the web
    handler never asks the server.
    - The "something else is on the tag" question no longer appears during and
    after an automatic write: it compared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
    [app_config.h, app_loop.cpp, backend_api.cpp, backend_api.h, lang.cpp, lang.h, main.cpp]
2026-09-25 fix: a WLAN scan with a spinner, the fill bar after a weight update, a docs code, and room under 3 MB (v0.8.0-beta.79)
    - The WLAN scan runs asynchronously behind a round spinner instead of
    holding the screen.
    - After "update weight" the fill bar and its colour follow the new rest at
    once; the scan and the weight update share showSpoolRemaining().
    - The info screen carries a fifth code, to the documentation, across the top.
    - The label drops its 44 px size: the vendor line on large rolls takes 36 px,
    which frees 85 KB (firmware 2.93 of 3.00 MB).
    - The log ring counts its sector erases and the longest one, logged with the
    perf window.
    [app_config.h, flash_log.cpp, flash_log.h, label_render.cpp, main.cpp, spoolman_actions.cpp, wifi_manager.cpp, wifi_manager.h]
2026-09-26 feat: Spoolman 0.27 native tags by default, fields created on demand, a fluid touch on unknown tags, and the label with lasting facts (v0.8.0-beta.80)
    Spoolman 0.27:
    - A scale on extra.tag moves to the native tags once its server has the
    relation; nfc_id and card_uids stay. A choice made on the tag field
    screen afterwards stays as made.
    - New switch "For OpenSpoolman" beside the native tags: a Bambu spool's tray
    uuid also goes into extra.tag. On by default where the field already
    exists, and on for every scale that moved.
    - A missing extra field (last_dried, the tag field, rfid_tag, extra.tag) is
    created before the first write to it instead of the write being lost.
    - Linking native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
    [app_config.h, backend_api.cpp, backend_api.h, backend_job.cpp, backend_job.h, bambuddy_api.cpp, filaman_api.cpp, filaman_api.h]
2026-09-26 fix: no crash in the WLAN scan, the second tag after a FilaMan link, and two label sizes (v0.8.0-beta.81)
    - A connected scale scans beside its link. Taking the link down first
    turned the driver off while the loop kept serving, and the web server
    freed a waiting connection through the driver that was gone: a PANIC in
    esp_pbuf_free under lwip_accept, seen with the log page open.
    - A link from FilaMan's web page asks for the second tag like one made on
    the scale.
    - The second tag is no longer turned away as "bound meanwhile" when a row
    of an earlier spool list is still around: its spool is bound on purpose.
    - The label sizes are 40 x 30 and 50 x 30, the two printed on the M220;
    smal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
    [app_config.h, label_printer.cpp, main.cpp]
2026-09-26 feat: 6 MB firmware slots, a hint to flash once over USB, and no update that cannot fit (v0.8.0-beta.82)
    - The partition table gives each firmware slot 6 MB (was 5), the data area
    3.875 MB. Devices on the old 3 MB table keep working and are told how to
    move over; the web flasher carries the new table from the release on.
    - The hint on the scale ("A quick one-time update over USB") comes with
    every boot on the old table, with a code to the web flasher and a
    "Later" button; no "never again". It names an update that no longer fits.
    Shown only once FLASHER_HAS_CURRENT_LAYOUT is set, in the release commit.
    - An update larger than the running device's slot is not offered: the
    update sc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
    [partitions.csv, ui_budgets.tsv]
2026-09-26 ci: publish the image size per channel in version.json
    A device on the old 3 MB partition table compares it with its app slot and
    offers the web flasher instead of an update that would not fit. Firmware
    from before this ignores the keys.
2026-09-26 fix: review fixes before the pre-release - FilaMan gross weight, the size gate closed, the update check off the click (v0.8.0-beta.83)
    - FilaMan keeps the whole spool in initial_total_weight_g (filament plus
    empty spool) and the mapping reads it back net. Setting the initial weight
    and copying a spool wrote the net figure into it: a spool set to 1000 g
    came back as 750 g at 133 %. Both now add the empty weight; setting the
    weight writes nothing when the spool cannot be read first.
    - The size gate is complete: the image size comes back from each lookup
    instead of a global both tasks wrote; the firmware page does not offer a
    release too large for the slot, /api/ota/install and the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
    [ui_budgets.tsv]
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2026-09-27 fix: a refused initial weight is reported, credentials lose control characters, and 15 unused texts go (v0.8.0-beta.84)
    A server that refuses the initial weight now gets a warning card instead of
    silence. API keys and the device token drop CR, LF and other control
    characters on the way in, from the form and from NVS. Spool names in
    /api/spools are escaped, every page is sent with X-Frame-Options: DENY, and a
    GitHub flash checks the tag's shape before it becomes part of the URL.
    [ui_budgets.tsv]
2026-09-27 fix(nfc): a lifted spool counts as gone once the weight says so, and the location question keeps up (v0.8.0-beta.85)
    A tag that stops answering while the weight has halved is a removal at once,
    not after the 2.5 s (NTAG) or 1.5 s (Bambu) grace period, and the location
    question follows 0.5 s later instead of 1.2 s: about 1.5 s after the lift
    instead of 4. A question held back because the reader lost the tag of a spool
    still lying there stays pending and comes when the weight goes. A spool that
    demonstrably left the pad is asked about again the next time.
    [app_config.h, app_loop.cpp, main.cpp]
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2026-09-27 fix(flash): a scale on the old partition table tells the web flasher so, which then offers Update (v0.8.1)
    ESP Web Tools offers "Update" only when the version the scale reports over
    Improv differs from the one in its manifest. A scale that took 0.8.0 over the
    air still had the old table and reported v0.8.0, the same as the manifest, so
    the flasher showed no way to the new layout short of erasing everything. On
    the old table the version now carries " (old layout)".
    [app_config.h, improv_serial.cpp, main.cpp]
2026-09-27 docs: README for 0.8.0
    New in 0.8.0 with the one-time USB note for 0.7.x scales, features for
    the AMS view, label printing, logging without SD card, second tag,
    MIFARE Classic and Snapmaker tags and the tag terminal without load
    cell, Spoolman 0.27 native tags, FilaMan's browser follow, an updated
    roadmap and credits, and a community AliExpress parts list.
2026-09-28 feat: type in the empty spool weight on the scale (#40)
    The weight popup's empty spool button now asks first: weigh the empty
    spool on the scale, as before, or type the weight in on a keypad. The
    keypad shows scale minus spool as the remaining weight while typing,
    accepts 30 to 600 g, and refuses more than is on the scale. The value
    then goes to the same spool / filament / brand choice as a weighed one.
    A tare stored on the filament or the brand now also applies to the spool
    on the scale right away, unless a lower level carries its own, so the
    next weighing no longer uses the old tare until the tag is read again.
    [ui_budgets.tsv]
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2026-09-28 feat: keep-alive for https backends, chunked answers, TLS reads that wait (v0.8.2-beta.15)
    One https connection to the backend is kept open between requests and
    opened ahead of time when a spool is put on the pad or a tag is read: a
    handshake costs the ESP32 about 0.6 s, a request on an open connection
    about 30 ms. How long it stays open idle is chosen on the backend page
    (1, 5 or 30 min, 5 by default). Another request meanwhile opens its own
    connection, as before.
    An answer sent Transfer-Encoding: chunked, as a reverse proxy like Caddy
    sends it, is now read with the chunk sizes taken out; every parser used to
    read the raw stream and broke on the first size line.
    NetworkClientSecure answer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
    [app_config.h, app_loop.cpp, backend_http.cpp, backend_http.h, backend_switch.cpp, filaman_api.cpp, lang.cpp, lang.h]
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2026-09-29 fix: join the strongest access point, log WiFi outages, roam while idle (v0.8.2-beta.19)
    On a network with several access points on one SSID the scale joined the
    first one it heard: the core defaults to a fast scan, and the reconnect
    watchdog called WiFi.begin() directly. A dying access point was retried
    every 10 s for 40 minutes. wifiManagerBegin() now scans every channel and
    joins the strongest, and the watchdog goes through it.
    The log names the access point on every connect (BSSID, channel, RSSI),
    an outage with its reason, a summary every 5 minutes and the reconnect,
    instead of one line per retry that filled the session ring.
    While nobody uses the scale (display dimmed or dark for 10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
    [app_config.h, app_loop.cpp, display_power.cpp, display_power.h, main.cpp, web_access.cpp, wifi_manager.cpp, wifi_manager.h]
2026-09-29 feat: spool labels open the Spoolman page, M110 no longer experimental, M100 as its own model (v0.8.2-beta.20)
    The QR code on a Spoolman label carried "WEB+SPOOLMAN:S-<id>", which a
    phone shows as plain text; it now carries <base>/spool/show/<id>, which
    Spoolman's own scanner reads as well. The longer text also makes the code
    larger: 10.9 mm instead of 7.9 mm on a 40 x 30 label.
    A user prints with the M110 bytes on an M100, so the M110 drops its
    experimental mark and the M100 gets its own entry with the same head.
    [app_config.h, label_printer.cpp, label_printer.h, label_render.cpp, label_render.h, main.cpp, phomemo_m_series.cpp, phomemo_m_series.h]
2026-09-30 feat: print position setting and calibration page for label printers (v0.8.2-beta.21)
    Where the roll runs under the head depends on how it sits in the holder,
    not on the model: one M220 had its 40 mm roll in the middle, another at
    the fixed right wall, 16 mm further right. The offset is now a setting,
    in millimetres on the printer page, with Left, Centre and Right for a
    roll against a wall, which hold for every label width.
    The calibration page prints a ruler across the whole head, numbered in
    the offset that puts the label's left edge there, and a frame where the
    scale takes the label to be: the first number on the left of the label
    is what goes into the field. The printer page shows the h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
    [ui_budgets.tsv]
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2026-09-30 fix: no doubled words in spool names, from BamBuddy and from material plus name (v0.8.2-beta.23)
    BamBuddy hands material, subtype and colour name over separately, and
    the scale joins them. They overlap more often than not: "PLA" +
    "Matt Ozean" + "Matt Ozean", "ASA" + "Jet Black" + "ASA Jet Black",
    "ABS" + "+ Grey" + "ABS+ Grey" read twice on the screen and on a
    written tag. Whatever the name so far already ends with is now left off
    the next part, in whole words, and a part that restates the whole name
    replaces it. In the built-in inventory that was 11 of 26 spools.
    The link list, the copy list and the copy confirmation put the material
    in front of the filament name, and caught only a name t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
    [app_config.h, bambuddy_api.cpp, main.cpp]
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2026-09-30 fix: a Bambu tag reports its chip uid to BamBuddy beside the tray uuid (v0.8.2-beta.25)
    The SpoolBuddy scan sent the tray uuid twice, once as tray_uuid and once
    in the required tag_uid. The chip of the side on the reader goes into
    tag_uid now. BamBuddy still matches the tray uuid first and asks the chip
    only after a miss, so nothing changes for a spool it knows by the tray
    uuid, while one it knows by the chip alone is found in one request
    instead of after a download of the whole inventory. With native tags
    (Spoolman 0.27, BamBuddy #3168) the chip is kept on the spool.
    Tested against BamBuddy 1.2.5.6 with a spool that carries only the
    padded chip uid the AMS reports ("A1B2C3D400000100"): the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
    [app_config.h, backend_api.cpp, bambuddy_api.cpp, bambuddy_api.h, main.cpp]
2026-09-30 feat: warn that the dryer blackens thermal labels, remove printer in red (v0.8.2-beta.26)
    The labels are thermal paper, and drying a spool at a high temperature
    turns the whole label black. Printer profiles now say whether a model
    prints direct thermal; for those the "Printed" card says so in one
    sentence, the label row on the printer screen gets a "?" with the longer
    explanation, and the browser's supported printers card carries the
    sentence too.
    "Remove printer" takes the red of every row that deletes something, like
    the factory reset in the system screen.
    [app_config.h, label_printer.cpp, label_printer.h, lang.cpp, lang.h, main.cpp]
2026-09-30 feat: a Bambu tag that does not describe its spool is asked about when linking and flagged when read (v0.8.2-beta.27)
    A Bambu tag says what is on the spool, and the home screen takes material,
    maker, temperature and colour from it while name, weight and dates come from
    the server. Linked to the wrong spool, the screen showed half of each and
    nothing said so, and the link list let it happen without a question: with no
    spool of the tag's material it falls back to every unbound Bambu spool, and a
    tap linked a PLA Tough+ Cyan tag to a PETG HF Orange spool.
    One verdict for every place that asks (services/tag_spool_match): material
    and Bambu subtype, colour beyond the list filter's distance, and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
    [app_config.h, lang.cpp, lang.h, main.cpp, tag_link.cpp, tag_link.h]
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2026-09-30 fix: a domain in the device name no longer restarts the scale after every WiFi connect (v0.8.2-beta.34)
    The check whether the configured name points at the scale called
    dns_gethostbyname() from the loop task without the lwIP core lock. Core 3
    asserts that lock (CONFIG_LWIP_CHECK_THREAD_SAFETY), so udp_sendto() aborted
    right after WiFi came up, on every boot, as soon as a domain was set. The
    lookup now runs under LOCK_TCPIP_CORE(). Affected 0.8.0 and 0.8.1.
    [app_config.h, device_name.cpp, main.cpp]
2026-10-01 feat: Spoolman dark and light palettes, a light palette that holds up on the panel (v0.8.2-beta.35)
    The palette table gets a column per palette: dark, light, Spoolman dark and
    Spoolman light, filled through one table of pointers so each palette costs
    its values and little else. The light palette is reworked after the panel:
    a tinted ground under near-white cards, dark separators and outlines, fuller
    button fills and stronger coloured values. Spoolman dark is graphite with
    Spoolman's orange as the house colour and green kept for a good state;
    Spoolman light is paper with the same roles. The main and more-info
    separators and the options that cannot be chosen now get their own colours
    again, so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
    [app_config.h, lang.cpp, lang.h, main.cpp]
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2026-10-01 feat: Spoolman-compatible servers, and Spoolman behind a key or password (v0.8.2-beta.36)
    What a server that speaks Spoolman 0.27 needs from the scale, and what the
    scale did wrong against one (issue #42), measured against a copy of
    Spoolman 0.27 and three proxies in front of it:
    - writing a tag from the web interface links it in Spoolman right away
    - a spool without its own empty weight takes the manufacturer's, in the
    link, copy, keypad and cache paths (services/spool_tare)
    - drying data on the filament counts as the spool's, no needless PATCH
    - a tag that sits on a filament says so instead of failing
    - location names up to 130 characters survive a round trip
    - every 2xx is success; 404,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
    [app_config.h, app_state.cpp, app_state.h, backend.cpp, backend.h, backend_api.cpp, backend_api.h, backend_switch.cpp]
2026-10-02 feat: softer press colour in the light palettes, web pages follow the system scheme, faster LVGL rendering (v0.8.2-beta.61)
    The surface under the finger has its own two roles now, PRESS_FILL and
    ROW_PRESS_FILL. Dark keeps the values it had; the three light palettes fill
    at 1.5:1 against a card instead of 3.5:1, so a pressed row no longer drags a
    dark block across the panel while it scrolls and redraws.
    The Design page gets a switch that lets the web pages take light or dark from
    the browser, in the colour family the scale runs. Only the pages change, so it
    takes effect at once and needs no restart.
    LVGL is built with -O2 instead of -Os and the instruction cache is 32 kB
    instead of 16. A sc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
    [app_config.h, app_loop.cpp, lang.cpp, lang.h, lvgl_speed.py, main.cpp]
2026-10-02 fix: the location button opens the picker for an archived spool too (v0.8.2-beta.63)
    A tap on the location button of an archived spool did nothing: the picker
    left archived spools out. Every backend takes a location on one (Spoolman,
    FilaMan and BamBuddy all patch it without asking), so a tap now opens the
    list. The automatic offers after an AMS assignment, a removal or the picker
    still leave archived spools out.
    [app_config.h, main.cpp]
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2026-10-02 fix: support tags match their -S spools, drying advice only fills an empty field (v0.8.2-beta.65)
    - A Bambu support tag ("Support for PLA", "Support For PLA/PETG") matches a
    "-S" spool of the base it names instead of always reading as a material
    mismatch; tags without a base ("Support W") accept any support spool.
    - The tag's drying recommendation is written only when tag and spool belong
    together, and only into an empty field: an existing value stays.
    - The Bambu catalog's automatic check keeps its one-hour retry after a
    failure even when the tags page or the network probe collected the result.
    - A chunked catalog download has its chunk size lines removed before parsing;
    a downloa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
    [app_config.h, app_loop.cpp, backend_http.h, drying_sync.cpp, drying_sync.h]
2026-10-02 fix(net): reuse the kept https connection after writes, fail fast on DNS, bind the Spoolman access to its address (v0.8.2-beta.66)
    - Backend worker stack 10 kB -> 16 kB: over https it does the TLS
    handshake itself whenever the kept connection is closed.
    - The ahead-of-time connect uses the 5 s connect timeout of every backend
    request instead of the TLS client's 30 s, so a dead server no longer
    holds the kept connection for half a minute.
    - A host name that does not resolve fails the request at once with a log
    line; core 3 went on to connect to 0.0.0.0 for the whole timeout. Same
    resolver call as the client, so mDNS .local names behave as before.
    - A borrowed connection is handed ba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
    [app_config.h, backend.cpp, backend.h, backend_http.cpp, backend_http.h, backend_job.cpp, filaman_api.cpp, lang.cpp]
2026-10-02 fix: Wi-Fi switch without driver teardown, tare entry as modal, printer offset only with a printer (v0.8.2-beta.67)
    - Improv, the setup screen and the setup portal no longer reset the radio on
    a connected station. The reset turned the driver off while port 80 kept
    serving, the pattern behind the PANIC in esp_pbuf_free. A connected station
    is switched over by begin() directly, and a connect only counts once an
    address was handed out after it began, so the old link cannot pass for the
    new network. A failed Improv attempt stops with a plain disconnect while
    the web server may be up.
    - The hostname is set before every mode() that switches the station on.
    Core 3 only applies it ther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
    [app_config.h, app_loop.cpp, deferred_actions.h, improv_serial.cpp, main.cpp, sd_logger.cpp, setup_portal.cpp, wifi_manager.cpp]
2026-10-02 build: lock the ESP-IDF component versions, correct the app slot comments
    The hybrid build (custom_sdkconfig) resolves the framework's component
    ranges against the registry on every fresh build, so CI picked up
    espressif/mdns 1.14.0 on 02.10.2026 while the tested builds ran 1.13.1.
    dependencies.lock holds the versions of the tested builds (component hashes
    checked against their managed_components) and is honoured by the component
    manager from any PlatformIO core path.
    The size guard comments said every device has a 3 MB app slot. Installs since
    v0.8.0 get 6 MB; the guard protects the scales still on the old partition
    table, which OTA never rewrites.
2026-10-02 fix: readable accent text, light palette contrast, a restart offered when the colours follow a backend switch, one-step colour apply (v0.8.2-beta.68)
    - Own accent: wherever it is text (ACCENT, STATUS_BLUE, ALT_TEXT) its OKLCH
    lightness moves until it reads at 4.5:1 on the palette's ground; fills
    (weight button, LVGL primary) keep the chosen colour. app.js does the same
    steps for the preview and for the pages' --accent. The pill still shows
    the chosen colour's own contrast.
    - Light palette: ARCHIVED grey (#656565, 4.5:1 on the ground) instead of
    near black; OK_TEXT, WEIGHT_SENT, WEIGHT_COUNT, LINK_TEXT and ARCHIVE_TEXT
    darkened to 4.5:1 on their fills, the fills unchanged.
    - WiFi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
    [app_config.h, lang.cpp, lang.h, main.cpp, page_firmware.cpp, web_access.cpp, web_shell.cpp]
2026-10-02 fix: lighter secondary buttons on the light palettes, bounded TLS handshake, portal closed before its access point (v0.8.2-beta.69)
    - Secondary buttons on the light palettes are filled like a row with a thin
    border, and a shade darker under the finger instead of the dark frame
    colour; the dark palettes are unchanged pixel for pixel.
    - Every backend TLS handshake is bounded at 10 s instead of the client's
    120 s, so a server that takes the connection and then says nothing no
    longer holds a request for two minutes.
    - The setup portal closes its web server before it takes the access point
    down; the driver went off under a phone's open connection otherwise.
    - Light palette: the smaller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
    [app_config.h, backend_http.cpp, backend_http.h, lang.cpp, lang.h, main.cpp, setup_portal.cpp]
2026-10-03 fix: setup portal back on its proven path, a proxy's 502 counts as no connection, red buttons visible on the light Spoolman and FilaMan palettes, the auto weight countdown flashes (v0.8.2-beta.70)
    - The setup portal is back to how it ran for weeks: the radio is reset
    before its scan, the access point goes down before the web server
    changes. Started on a connected station, the scan had failed and closing
    the portal ended in a PANIC (beta.69, 03.10.2026 00:41).
    - 502, 503 and 504 count as the server not being reached: a reverse proxy
    answers them for a backend that is gone, and the "No connection to the
    server" popup now comes instead of a bare "API error".
    - Spoolman light and FilaM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
    [app_config.h, app_loop.cpp, main.cpp, server_reach.cpp, setup_portal.cpp]
2026-10-04 fix(web): the design page keeps Apply in view and marks changes not applied yet (v0.8.2-beta.71)
    A choice made at the top of the page left the button far below, and nothing
    seemed to happen. The apply bar now sticks to the bottom of the window, and
    while something is changed and not applied it is framed in the accent, the
    button filled, with "Not applied yet" beside it.
    [app_config.h, lang.cpp, lang.h, main.cpp]
2026-10-05 fix(diag): a scale missing at boot comes back once it answers, and a flapping I2C bus is summed up in the log instead of a line every two seconds (v0.8.2-beta.72)
    A NAU7802 that failed at boot was never retried, so after reseating a plug
    the scale stayed dead until a restart. It now counts as lost from the first
    watchdog pass, and Check again grants a fresh set of attempts.
    The diagnosis logs at most four changes per minute and reports the rest as
    one count. Failed re-inits of reader and scale reach the device log too.
    [app_config.h, app_loop.cpp, diagnostics.cpp, main.cpp]
2026-10-05 feat(ui): without a load cell the AMS button assigns the spool on screen, FilaMan's window counts down on it, and removing a spool no longer raises questions (v0.8.2-beta.73)
    [ui_budgets.tsv]
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2026-10-06 feat(tag): a Bambu tag with no spool behind it creates the filament and the spool on Spoolman, FilaMan and BamBuddy, with names, density and weight taken from the tag (v0.8.3-beta.5)
    [ui_budgets.tsv]
2026-10-06 release: v0.8.2
    Colour schemes with a Design page, more read from Bambu tags with colour
    names and article numbers, HTTPS backends and Spoolman behind a key, print
    position per printer, typed empty spool weight, WiFi roaming and new time
    zones. Without a load cell the AMS button assigns the spool on screen, and a
    scale missing at boot comes back once it answers.
    Refs #39, #40, #41, #44
    [ui_budgets.tsv]
2026-10-06 fix(ui): the drying traffic light colours Bambu spools again in per-material mode (v0.8.3-beta.7)
    [app_config.h, main.cpp]
2026-10-06 feat(ams): on a scale without load cell a tap ends the running AMS countdown, and another spool on screen frees the button for itself (v0.8.3-beta.8)
    FilaMan's printer driver drops the pending assignment the moment a tray is loaded, and a new one replaces it, so after the first spool only the scale's own countdown kept the button from assigning the next. The countdown now ends on a tap or when a different spool is shown; the server side is untouched, it has no way to cancel a window. The AMS view stays reachable through the header chip.
    [ams_assign.cpp, ams_assign.h, app_config.h, app_loop.cpp, main.cpp]
2026-10-07 fix: review findings - AMS button and auto assign flag, tag create retries, drying field, BamBuddy drying field after a switch, screenshot ids (v0.8.3-beta.10)
    - Without a load cell, FilaMan's AMS button only assigns a spool with a
    stored weight above 0 g: a spool never weighed was reported as 0 g and
    booked empty.
    - auto_assign_enabled is cleared on boot and on a backend switch in every
    mode but "always". The AMS button arms it under "off" as well, and a
    failed second PUT left it standing for good.
    - A tap within 1.5 s of the AMS window opening is ignored instead of
    ending the countdown it just started.
    - Tag create asks the plan again before the next try when a try left no
    fila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
    [ui_budgets.tsv]
2026-10-07 fix(ui): popups dim the screen grey again in the Spoolman palettes, and every popup dims by the same amount (v0.8.3-beta.12)
    LVGL blends in RGB565 and rounds down, which drops red and blue to 0 before
    green: black at 70 % over Spoolman dark's grey came out pure green (0x000800).
    The Spoolman scrims carry a trace less green now (0x080408, 0x585450), which
    lands on 0x080808 and a warm grey. All scrims use UI_OPA_SCRIM; five warnings
    were at 80 % and more info at 50 %, so the backdrop changed between popups.
    [app_config.h, main.cpp]
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2026-10-07 fix(ui): the status bar shows a full https address with its port instead of cutting it after the IP (v0.8.3-beta.15)
    [app_config.h, main.cpp]
2026-10-07 fix(fr): French texts are final, 35 corrected from their code context, and every new line must fit (v0.8.3-beta.16)
    The French column has no separate review any more. All 347 waiting rows were
    read against the place in the code that draws them; 35 were wrong, too
    literal or unclear and are corrected, the rest become final as they were.
    Without a review, nobody looks at the screens afterwards, so the width rule
    that held only for drafts now holds for every line without a budget. The 313
    rows checked on the device when French came in are frozen in
    tools/fr_width_baseline.txt, which only shrinks. The draft status, apply
    --draft, dump --drafts and approve are gone, and the guide, the contributo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
    [app_config.h, lang.cpp, main.cpp]
2026-10-08 feat(tag): gradient, dual colour and clear Bambu spools create the right filament, and the new spool takes a price (v0.8.3-beta.17)
    - The catalog keeps how a spool's colours lie (gradient or dual) next to
    all of them, up to four. Its format moves to version 3, so every scale
    downloads the table once more on its own.
    - A gradient or dual colour spool goes to Spoolman as multi_color_hexes
    with its direction, to FilaMan as a multi colour filament (gradient or
    striped), to BamBuddy with extra_colors and effect_type.
    - Gradient, dual colour and clear spools are found by their colour's name,
    with at most one bracket behind it ("Neon City (Blue-Magenta)"): the
    databases spell those colo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
    [ui_budgets.tsv]
2026-10-08 feat(tag): a spool without a maker's chip is picked from the filament database - maker, material, colour, size - and created with the blank tag linked (v0.8.3-beta.18)
    "New / Copy" on a blank NTAG offers "New from database" when the backend is
    Spoolman 0.27 or newer. Makers already in the inventory come first, the rest
    A-Z with a letter strip; long colour lists are split into colour families.
    The picked entry goes straight into the plan via its external_id, so a
    second spool of the same filament reuses it instead of creating a duplicate.
    The index streams the whole SpoolmanDB element by element on core 0 and
    stays cached for 24 h; the entry list is paged from the search and freed
    when the pi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
    [ui_budgets.tsv]
2026-10-08 fix(ui): the popup behind "New / Copy" carries the button's name, and a letter in the maker list brings its makers to the top (v0.8.3-beta.19)
    The popup also offers new spools now, so "Copy spool" no longer described
    it. A letter tap scrolled the first maker only into view, which left it on
    the bottom row; it now leads the list under the letter strip.
    [app_config.h, main.cpp]
2026-10-09 fix(ui): the countdown on the second tag's Done shows again on the grey palettes (v0.8.3-beta.20)
    The fill drained in POPUP_BORDER, one step off the button's LINE on the
    grey palettes and so invisible there. It gets a colour of its own,
    COUNTDOWN_FILL, that shows on every palette and keeps the caption at 4.5:1.
    [app_config.h, main.cpp]
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2026-10-09 feat(ui): New / Copy and Link ask with tiles of equal weight, and a new spool is only made on New / Copy (v0.8.3-beta.23)
    New / Copy shows its three common ways as tiles of one size and one look:
    active spools, archived spools and a new one, from the tag or from the
    filament database. Without a way to a new spool the two lists share the row.
    Link shows one tile, the list: it joins a tag to a spool the inventory
    already has, so New from tag is gone from it. On both, the spool ID and
    Cancel sit in one low row underneath, Cancel no longer the largest button.
    French: Nouvelle depuis la base becomes Nouvelle de la base to fit a tile.
    [ui_budgets.tsv]
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2026-10-09 fix(bambuddy): a drying date set right after switching to another BamBuddy goes into its own field instead of the note (v0.8.3-beta.29)
    [app_config.h, backend_api.cpp, bambuddy_api.cpp, bambuddy_api.h, main.cpp]
2026-10-09 feat(ui): the drying date setting shows BamBuddy's own field when the server has one, and the cancel buttons of the empty spool question and the AMS bay pick are red (v0.8.3-beta.31)
    - with last_dried_at on the server, the setting's row and its web subtitle
    read "BamBuddy field", the screen shows it on top as the choice in force,
    and the three routes for an older BamBuddy are inert with the reason
    - the help text no longer says BamBuddy has no field for the date
    - cancel in the empty spool question and the counting-down cancel of the
    AMS bay pick take the red of every other cancel button
    [ui_budgets.tsv]
2026-10-09 fix(ui): cancel next to FilaMan's assignment window in the AMS view is red like every other cancel button (v0.8.3-beta.32)
    [app_config.h, main.cpp]
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2026-10-09 fix(web): Bluetooth switched on in the browser asks for the restart it needs, and the print card says so instead of blaming memory (v0.8.3-beta.36)
    [app_config.h, label_printer.cpp, lang.cpp, lang.h, main.cpp]
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2026-10-10 fix(label): the editor forgets the spool of a server the scale left, the dates load beside the loop, and a NIIMBOT that falls silent after the data reads as unconfirmed (v0.8.3-beta.40)
    - A switch of backend or host drops the editor's last spool and its dates;
    it showed the old server's spool and printed it with the new server's QR.
    - The browser's dates come from a task of their own, like the AMS weights;
    an answer from before a switch is dropped. A print takes known dates from
    the copy and overwrites only on an answer, under the print card.
    - NIIMBOT: silence after every row went out is "sent, unconfirmed", silence
    after the printer had answered is "transfer cut off", only a printe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
    [app_config.h, backend_switch.cpp, ble_service.cpp, label_printer.cpp, label_render.cpp, label_spool.cpp, main.cpp, niimbot.cpp]
2026-10-10 fix: review findings before the 0.8.3 pre-release - dual colour Bambu spools, the drying move from Spoolman, the database picker, label dates and the price pad (v0.8.3-beta.41)
    - The catalogue download kept the colour type out of its filter, so every
    record counted as single and a dual colour spool was created as a gradient;
    CAT_VERSION 4 makes every scale read the table again.
    - The move of a drying date from Spoolman's extra into BamBuddy's own field
    never fired: the read now remembers which spool got its date from Spoolman,
    and only that one is moved.
    - A 404 on one maker's list no longer hides "New from database"; a load
    refused for lack of heap is asked again every two seconds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
    [app_config.h, backend_api.cpp, backend_api.h, bambuddy_api.cpp, bambuddy_api.h, dried_migrate.cpp, filament_db.cpp]
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2026-11-02 fix(filaman): a filament from the FilamentDB is filed under the material's name (v0.8.4-beta.49)
    FilaMan's import uses the name since 1.6: "PLA+/Pro" and "PA (Nylon)" instead of the key
    in capitals, which split one material in two in its filter. The search accepts both, so
    a filament of an older import is found rather than created again.
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2026-11-02 perf(filaman): the spool list keeps only the fields the scale reads, a third of each page (v0.8.4-beta.49)
    578 KB down to 194 KB for 262 spools on FilaMan 2.0, with the mapped list identical with
    and without the filter on 2.0 and 1.6.2. A forgotten field would go missing without an
    error, so a host test fails when mapSpool() reads one the filter does not name.
2026-11-02 feat(printer): NIIMBOT D110 and D110 M with a 12 x 40 mm tape label
    The D110 and D110 M can now be picked as label printers (experimental).
    They print on 12 x 40 mm tape with a fixed compact label: maker, material
    and filament name on the left, the spool id large on the right. "Bambu Lab"
    is shortened to "BL". The D110 uses the D110 print task already in the
    driver; the D110 M uses the B1 task, or on protocol 4 niimbluelib's V4
    task, which is new.
    No other printer's print sequence, label size or layout changes. The
    label page's size list now shows only the sizes the picked model takes.
    FilaMan presets are not used on the tape printers.
2026-11-02 fix(printer): a tape label names the maker as the backend does, and one helper lists the models a size fits (v0.8.4-beta.49)
    "Bambu Lab" fits the tape, so no maker is shortened any more; the comments in the
    NIIMBOT driver say what the code does now.
2026-11-02 feat(label): the label page greys out the template for a tape printer and keeps the preview (v0.8.4-beta.49)
    The tape has a fixed label, so the template stays in view out of use and stays saved
    for the other printers. FilaMan's presets and the upright note step aside.
2026-11-02 feat(printer): the NIIMBOT D110 and D110 M are no longer experimental, a D110 M has printed (v0.8.4-beta.49)
2026-11-03 fix(spoolman): a stored tare of 0 is a real tare, as Spoolman 0.27.1 reads it (v0.8.4-beta.50)
    Only null falls back to the filament, then the maker. A spool stored with 0 g goes out as a PATCH, so a server before 0.27.1 cannot subtract the filament's tare instead.
2026-11-03 fix(tags): an unclear answer to the tag probe no longer means a server without native tags (v0.8.4-beta.50)
    A 429 or a 5xx on the probe was read as "no native tags", and the link went into extra fields instead. It now writes nothing.
2026-11-03 feat(backend): a refused key, an inactive account and a rate limit are named, and Retry-After is honoured (v0.8.4-beta.50)
    401/403, 402 and 429 read as "API error" or failed silently. They now have their own popup and text on the device and the web page, and the background search waits as long as the server asks.
2026-11-03 fix(weight): the weight popup closes when another spool is loaded (v0.8.4-beta.50)
    It stayed open over a swap, still showing the old spool, and its button then wrote the old weight to the new one.
2026-11-03 fix(database): room for 2400 maker and material pairs, past 640 a maker had no filaments (v0.8.4-beta.50)
    A catalogue with 1334 pairs left 107 of 204 makers empty. The flash copy keeps its limit: only the whole database is stored there. The picker's buffer on the stack shrinks to one maker's materials.
2026-11-03 fix(ui): five digit spool ids fit on the main screen (v0.8.4-beta.50)
    46 px held 16388 but cut 16400 to "16...".
2026-11-03 feat(backend): online services behind a fourth Internet button (v0.8.4-beta.53)
    The device and the web page get a fourth choice, Internet, leading to a page
    with Spooly and "other service". All of it runs on the Spoolman path through a
    stored profile, so nothing new is spoken and switching costs nothing.
    Each profile keeps its own address, access and server set slots. An online
    service never touches the local entry, and a downgrade finds it intact. A name
    read from /api/v1/info is treated as foreign data and refused whole if it holds
    anything odd. A kept key does not follow a new address. The AMS source is off
    while an online service is active, and the status bar names a service with a
    fixe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
2026-11-03 feat(settings): no tag field settings on a service that keeps its tags itself (v0.8.4-beta.53)
    On Spooly the tag relation is the only source, so the extra fields row, the
    companion field and the chip uid row are gone on device and web, and neither
    field is written. The stored values stay untouched for the other profiles, and
    a visit no longer moves the tag field chosen for the home server.
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2026-11-04 fix(ui): a long spool name stays on its line on the unknown spool card (v0.8.4-beta.53)
    The labels had a width and no height, so a long name wrapped onto the weight
    below instead of being cut with dots.
2026-11-04 fix(tag): a filament from a Bambu tag no longer doubles its product line (v0.8.4-beta.53)
    Bambu names 14 colours with the line in front, "Translucent Gray" under PETG
    Translucent, and the line was put in front again. Existing filaments keep
    their name and are still found.
2026-11-04 fix(label): a trademark sign no longer prints as a box (v0.8.4-beta.54)
    No label font has the trademark, registered and copyright signs, so
    "Panchroma™ Marble" printed a box after the first word. They are taken out of
    vendor, material, name and location before a spool or filament label is drawn.
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2026-11-04 fix(label): the number's slider ends where the number stops growing (v0.8.4-beta.54)
    Above a certain share the number was already held by the label's width or by
    the height the lines need, and moving the slider changed nothing: from 45
    percent for a three digit number over six lines, over the whole range for one
    upright. The page now gets that limit with its state, measured by the code that
    draws the number, and the slider ends there. With nothing to set, upright with
    three digits or the number alone, it is gone. The saved share stays, since
    another number may have room for it. Labels print as before.
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2026-11-05 feat(scale): an uncalibrated scale starts at 1000 counts per gram and its banner says the weight is wrong (v0.8.4-beta.54)
    The factory factor was 1, so before the first calibration the main screen
    showed raw counts: about 1,199,000 g for a 1 kg spool. It is now 1000, a round
    guess for the 2 kg cell most builds use, so the reading is roughly right and
    the thresholds in grams work. The amber banner now reads "Not calibrated:
    weight is wrong" and its help text asks not to save the weight yet.
    A device reset under the old firmware still stores 1 and moves to 1000 on
    boot; a calibration that lands exactly on 1000 is stepped to 1000.01, so the
    reminder can only mean "never calibrated". Real calib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
2026-11-07 fix(drying): a drying date stored as the JSON text null shows no date (v0.8.4-beta.54)
    Spooly marks a spool that was never dried with the JSON text null in
    extra.last_dried, and the scale showed it as the date "null". lastDriedUtc()
    now treats it like an empty value. The rule moved into
    services/last_dried_rules.h, free of Arduino and JSON, with a host test.
